delandtj/granite_controller/firmware/granite-sim/README.md

# granite-sim

The Granite controller, on the host. It runs the real `granite-core` -
node state machine, actuator queue, rule engine, dispatcher and the HTTP
route table - against a fake board described by a scenario file, and
serves the real setup page (`firmware/web/`) over HTTPS with a
self-signed certificate. The browser experience and the API contract are
therefore the same ones the firmware serves, without a board.

## Commands

```
granite-sim serve [--port 8443] [--bind 127.0.0.1] [--scenario file.toml]
                  [--no-tls] [--assets ../web]
                  [--link i2c|can] [--drop-every N]
granite-sim recover [--key ~/.config/granite/fleet-recovery.key] [--port N]
                    [--no-tls] <host>
granite-sim keygen [--key ~/.config/granite/fleet-recovery.key]
granite-sim modbus-map > ../docs/modbus_map.md
```

- `serve` prints the device id, MAC, certificate fingerprint and the
  recovery token, then listens. The certificate is generated per run, so
  the browser warns once; `--assets ../web` serves the page from disk so
  edits need no rebuild.
- `recover` is the fleet recovery tool from ADR 0001 component 13: it
  fetches `/id`, signs `device || nonce || "factory-reset"` with the
  fleet ECDSA P-256 private key and posts `/recover`. TLS is not trusted
  here (the device certificate is self-signed by design); the signature
  is the authentication.
- `keygen` writes the private key with mode 0600 and prints the public
  PEM for the Security page. It refuses to overwrite an existing key.
- `modbus-map` regenerates `firmware/docs/modbus_map.md` from
  `granite_core::modbus_map::render_markdown`.

## First setup with curl

```
B=https://127.0.0.1:8443
curl -sk $B/id
curl -sk -X POST -d '{"password":"correct horse battery"}' $B/api/v1/security/password
curl -sk -c jar -X POST -d '{"password":"correct horse battery"}' $B/api/v1/session
curl -sk -b jar $B/api/v1/status
curl -sk -b jar -X POST -d '{}' $B/api/v1/nodes/3/on
```

## Scenario file

Everything is optional; see `granite-sim/src/scenario.rs` for the full
set and the defaults (8 nodes off, one probe at 40 C, 19 V on the bus).

```toml
device_id = "granite-510000"

[hardware]
vin_mv = 19000
board_temp_c = 32.5
dry_in = [false, false, false, false]
vin_ramp_mv_per_min = 0

[[probes]]
rom = "28ff000000000001"
name = "inlet"
temp_c = 40.0
ramp_c_per_min = 0.0

[[nodes]]
node = 1
powered = false
respond = "normal"     # normal | never | slow
on_delay_ms = 1500
off_delay_ms = 4000
sense_broken = false
```

`respond = "never"` is the hung node: `on` times out, `off` escalates to
`force_off`, `press` still works. A PWR press held 4 s or longer cuts
power in the model, which is what makes the actuator's hardware deadline
observable. `sense_broken` is a broken LED wire: the node reads dark even
while it is powered, which is the failure mode ADR 0001 warns about and
the reason for the per-node `sense = "ignore"` setting. Marking every
node broken makes the whole U15 read fail instead, and then every node is
`unknown` and the state-dependent actions are refused unless the command
carries `"force": true`.

## Planes

A `[[plane]]` section puts a simulated plane on the link
(controller ADR 0004 architecture item 3). Each one is a real
`plane-logic` `Plane` over plane-logic's own fake devices, and the fake
link in front of them (`src/planes.rs`) implements
`granite_core::hal::PlaneLink`: it hands the request bytes to
`Plane::handle_frame` and gives the answer back. Framing, CRC and
records stay in `granite-proto`; an address with no plane NAKs, and on
the I2C link `event_nodes()` answers 0xFF while any plane's
`event_pending()` holds, because EXP_INT is their wired OR and cannot
say which plane pulled it (ADR 0005 decision 6).

Every plane runs at its own 20 Hz from the simulator's main loop, so a
sequence finishes and an event shows up on EXP_INT with nobody polling.
`scenarios/two-planes.toml` is a full frame on the plane at 0x30 (four
unit boards, eight slots, one of them empty, one sleeping host, one that
ignores its PWR button) plus a single-unit plane at 0x31.

```toml
[[plane]]
address = 0x30
units = [0, 1, 2, 3]
blink_window_ms = [100, 500]   # shortens every wait on a host LED

[[plane.slot]]
slot = 0
module = true
module_id = 0x0400
load_ma = 1200
host_on = true
respond = "normal"             # normal | ignores_short_press | ignores_hold
blink_period_ms = 0            # non-zero is a sleeping host

[[plane.fault]]
at_s = 45
kind = "unit_unplug"
unit = 1
```

Fault kinds, with `slot` / `unit` / `count` / `value` / `on` as each one
needs: `drop_transactions` (NAK the next `count`), `corrupt_answer`
(flip a byte, so the controller's CRC check rejects it), `watchdog` and
`power_loss` (a plane reboot that keeps or loses the intended state),
`unit_unplug` / `unit_replug` (the chain cable), `unit_hot_swap_latch`
(an overload on the unit's 48 V input: its LM5069-2 faults and retries,
and the plane latches the unit off) with `unit_hot_swap_clear` to take
the overload away again, `ov_latch`, `pgd_loss`, `power_limit_trip`,
`ignore_pwr` and `load`.
The same knobs are methods on `FakePlane`, which is how
`tests/plane_link.rs` drives them.

Nothing in `granite-core` reads the link yet: the plane client is the
next step (ADR 0004 decision 5), and `tests/plane_link.rs` is a
hand-written stand-in for it.

## The CAN FD link

The transport under those messages is a choice (firmware ADR 0005). The
default is the rev D I2C bus; `--link can`, or `link = "can"` in the
scenario, puts the fake CAN FD bus of `src/can.rs` in between instead:

```toml
link = "can"            # i2c | can

[can]
drop_every = 12         # lose 1 frame in 12; 0 loses nothing
```

Every request, answer, EVENT and SYNC then goes through
`granite_proto::can::segment` and comes back out of a `Reassembler` -
one for the controller, one per plane - so the simulator runs the real
segmentation (decision 3) and the real reassembly rules (decision 4),
not a model of them. A plane with unacknowledged events sends EVENT
from its own node once a second until EV_ACK covers them, which is what
`event_nodes()` reports (decision 6); the controller's SYNC is counted
with its epoch (decision 7).

`--drop-every N` loses every Nth frame on the bus. A message that loses
a segment is never reassembled, so the transaction times out and
ADR 0003's retries are what recovers: `tests/can_link.rs` runs the
client over a bus losing one frame in twelve and asserts it keeps both
planes, their telemetry and its verbs.

## What is not simulated

- Pull OTA (`{"url":..,"sha256":..}`) is logged and ignored; pushed
  images are checked for the ESP image magic byte only.
- MQTT: the broker summary is static. The topic contract is exercised
  through the `Command`/`Reply` JSON, which is the same code path.
- Modbus TCP: the map and the command translation are in the core and
  unit tested there; the simulator does not open port 502.
- Plane link timing: a transaction is instant and never stretches the
  clock, so the ~20 ms per plane per second of ADR 0003 decision 5 is
  not something the simulator can show. Dropped and corrupted
  transactions are injected, not earned.
- CAN bit timing, arbitration and the error counters of ADR 0005
  decision 8: on the fake bus the frames arrive in the order they were
  sent, or not at all.
