delandtj/granite_controller/attic/power/pm-19v-200w/README.md

# PM-19V-200W - OBSOLETE

Superseded by PM-19V-250W (power/pm-19v-250w/) on 2026-10-27.
Not for order, no further work. Kept for reference only.

Differences that make it obsolete: DOSA pin mount with a 1x5 1.27 mm
aux header (J2: OV_KILL, PGOOD, ID, TEMP, GND) instead of the screwed
mount and 2x3 aux block of docs/pm-interface.md, and 200 W instead of
250 W. Its silk was never tidied. Any future lower-power module will be
a new design, not a revision of this one.
