delandtj/granite_controller/docs/pm-interface.md

# Port module interface spec (PM-19V-250W and its hosts)

**Date**: 2026-10-26, amended 2026-10-27 (aux: 1.27 mm header and
socket instead of flat pads and pogos; gap 7.0 mm)
**Status**: Accepted with ADR 0003
**Applies to**: the port module (`power/pm-19v-250w/`, new project from pm-19v-200w),
the plane tile column, the bench carrier (`power/pm-bench-carrier/`).

Every mount footprint (module screw pads and aux header, host standoffs
and aux socket, host silk outline) is generated from the numbers in this
file. Change a number here first, then regenerate; never edit a
generated footprint by hand.

## Coordinates

Module frame: origin at the centre of the module outline, viewed from
the module's top (F side, inductors up), +x toward the output end,
+y down (KiCad convention). All positions below are in this frame, mm.

The module sits on the host F side up, so the host footprint uses the
same coordinates, not mirrored. On the plane tile the module stands
with the input end up (toward VBUS): host footprint rotation 270
(module +x points down the board). Bench carrier: rotation 0.

## Outline

- 58.4 x 22.9 mm (eighth-brick outline, nothing else from DOSA).
- Module PCB 1.6 mm, 4 layers, ENIG (pads are contact surfaces).
- Corner radius: none (as now).

## Screws: positions and nets

Four M2 screws through the module into SMT standoffs on the host. The
screws carry the power: the module's pad is clamped between the screw
head and the standoff face.

| Screw | Net | x | y | Current (cont. / fault) |
|---|---|---|---|---|
| S1 | VIN | -25.70 | -7.95 | 5.5 A at 48 V, 7 A at 38 V |
| S2 | GND (input) | -25.70 | +5.95 | as S1 |
| S3 | GND (output) | +25.70 | +5.95 | 13.2 A / 20 A |
| S4 | VOUT | +25.70 | -7.95 | 13.2 A / 20 A |

S2 and S3 sit 2.0 mm closer to the centre line than S1 and S4. That is
the polarisation: turned 180 degrees, (x, y) -> (-x, -y), the module's
holes land at y = +7.95 and -5.95, where no host standoff is (2.0 mm
off against a 0.2 mm hole float), so not even one screw goes in with
the module reversed. A pattern where only one screw is offset is not
enough: two diagonal screws still line up and hold the module with VIN
on a GND standoff. Keep the offset at 2.0 mm or more, and keep it the
same at both ends.

Insets: 3.5 mm from the short edges; 3.5 mm from the top long edge,
5.5 mm from the bottom one. The 6.2 mm underside pad leaves 0.4 mm to
the edge at S1 and S4.

## Screw pads

Module: one footprint, pm:PM_Mount_M2 (schematic J1), all four screws in
it, pad n = Sn, so the pattern cannot be placed wrong:
- Plated hole 2.4 mm (M2 clearance, +/-0.2 float).
- F pad 5.0 mm round (screw head 3.8 + lock washer 4.4 OD).
- Inner layers 4.0 mm round, solid to the net's pour.
- B pad 6.2 mm round (standoff face 5.56 mm), no solder mask, no paste.
- 8 vias 0.3 mm drill, 0.65 mm pad, on a 4.4 mm circle inside the pads, untented
  (no solder on the module side, the joint is clamped).
- Solid connection to the pour (no thermal spokes) on every layer.

Host standoff (one part per designator, JLC places one part each):
- Sinhoo SMTSO2070CTJ, LCSC C2916355: M2 thread, 7.0 mm length,
  5.56 mm body, 3.6 mm pilot 1.53 mm long (same family and footprint
  as the 6.0 mm SMTSO2060CTJ, C2915628, it replaced).
- Plated hole 3.75 mm for the pilot, round pad 6.4 mm, 4 paste
  apertures (as drawn at tag pm-mount-drawn), solid to the pour.
- 8-12 stitching vias around the pad to the inner planes.

Hardware: M2 x 5 pan or cheese head, A2 stainless, with a spring lock
washer (DIN 127 / split ring) under the head. Engagement: 5 - 1.6
(PCB) - 0.5 (washer) = 2.9 mm (the screw goes into the standoff's top,
so the standoff length does not change it). Torque: 0.15 Nm max, the
datasheet's tightening torque for the M2 size (1.5 kgf.cm); the earlier 0.25 Nm
was over it. That gives roughly 350-400 N clamp on an M2 (F = T / (0.2 d)).

Standoff datasheet (Sinhoo PCB SMD NUT, LCSC C2916355, checked 2026-11-03):
- Thread: through, over the full length, for L 0.5-10 mm; only L 11-30 is
  blind (7 mm thread depth). The 7.0 mm part is through-threaded, so the
  M2 x 5 cannot bottom out (2.9 mm engagement, 7 mm of thread).
- Through means the bore is open to the host's plated pilot hole: solder can
  wick up into the bottom of the thread (the datasheet warns about this and
  rules out wave soldering). The screw only uses the top 2.9 mm, so a little
  wicking is harmless; keep the paste apertures off the hole as drawn.
- Material / plating: the datasheet gives brass C3604 (H59) for the parts with
  a rated current; LCSC lists the part as tin-plated copper. The datasheet
  itself does not decode the CTJ suffix, so tin plating rests on the LCSC
  listing (to confirm on a sample).
- Rated current for the M2 size: 30 A (S3 / S4 need 13.2 A cont., 20 A fault).
- Dimensions as used: body 5.56, pilot 3.6 x 1.53, min. solder pad 6.2,
  hole 3.73 +0.08.

## Aux contacts

A 2x3 1.27 mm board-to-board pair: SMT pin header on the module B side,
SMT socket on the host. Signals only, never power. (Was, to 2026-10-27:
flat pads on the module and pogo pins on the host. Dropped: the pogo
C5157258 turned out to be through-hole and too short for the gap, the
stocked SMT pogos have 0.08-0.25 um gold, and a pin tip on a pad is the
fussier contact; a socket grips and wipes.)

| Pin | Net | x | y | Direction | Note |
|---|---|---|---|---|---|
| A1 | OV_KILL | +12.065 | -9.12 | module -> host | open drain, low = overvoltage, sets the slot latch |
| A2 | PGOOD | +13.335 | -9.12 | module -> host | open drain, high = good |
| A5 | GND | +12.065 | -7.85 | | reference for ID and the open drains |
| A6 | GND | +13.335 | -7.85 | | the second GND |
| A3 | ID | +12.065 | -6.58 | module -> host | resistor to GND, table below |
| A4 | RUN | +13.335 | -6.58 | host -> module | open = on, host pulls low = off |

Pins are numbered by function (signals 1-4, GND 5-6), not by the
makers' numbering; positions are the contact (pin) centres in the
module frame, block centre (+12.70, -7.85), 1.27 mm both ways, rows
along y, GND in the middle row. Module footprint pm:PM_Aux_Header_2x03_P1.27
(schematic J2, pin n = An), host footprint carrier:PM_Aux_Socket_2x03_P1.27
(one part, pin n = An). The parts are symmetric: a 180 degree
placement error changes nothing, a 90 degree one does.

- Module header: hanxia HX PZ1.27-2x3P TP, LCSC C41376035 (second
  source Hong Cheng HC-PZ127-7.2L-2x3PS, C27985144). Plastic from 0.5
  to 1.5 mm off the module, pins 4.0 mm above it: tip 5.5 mm off the
  module. SMT legs outward in x, pads 2.50 x 0.74 at x +/-2.00 from the
  block centre (6.50 outer span), with paste: the header is reflowed on
  the module's B side with the other B parts. The footprint is drawn F
  side mirrored in y and flipped top-bottom onto B (rotation 0).
- Host socket: hanxia HX PM1.27-2x3P TP, LCSC C41397112 (second
  source Hong Cheng HC-PM127-4.3H-2x3PS-02A, C42163098). 4.60 mm tall
  over the PCB, pads 2.05 x 0.76 at x +/-1.975 (6.00 outer span).
- Mating at the 7.0 mm gap: pin tip 1.5 mm above the host, 3.1 mm into
  the socket. Header plastic would seat at a 6.1 mm gap, pins bottom
  at ~6.2, the upper contact point is ~2.5 mm deep (lost above ~7.6):
  ~0.8 mm margin to bottoming, ~0.6 mm wipe past the upper contact
  point, tolerance stack ~+/-0.4 RSS. The contact depths are scaled
  from the makers' drawings (not dimensioned): mate one sample pair at
  7.0 mm before a volume order. Plating "gold flash", thickness not
  stated.
- Module side: vias between the pad columns (x 141.15-142.65 on the
  250 W board) are fine, the header plastic sits over them, tented.
- Host side: OV_KILL and PGOOD pulled up in the column (open = good,
  so an absent module reads "good"; presence comes from ID). RUN is
  the module's UVLO divider node (~1.9 V at 60 V in): the host only
  ever pulls it low through an open drain, never drives it high.
- Lost contact: OV_KILL, PGOOD and RUN all fail unsafe when a pin
  opens (no OV kill, "good", module on). ID opens to "no module".
  Rule for every host: ID open (or out of the table) = slot fault, the
  slot stays off or is latched off. A module whose aux contact is gone
  then cannot run unsupervised.

ID table (module resistor to GND, host 10k pull-up to 3V3, 1k series,
100 nF):

| R_ID | V/3V3 | Module |
|---|---|---|
| 0 (short) | 0 | fault |
| 2.2k | 0.18 | reserved |
| 4.7k | 0.32 | reserved |
| 10k | 0.50 | PM-19V-200W rev 0.1 |
| 22k | 0.69 | PM-19V-250W |
| 47k | 0.82 | reserved |
| open | 1.00 | no module |

## Gap and part heights

- Gap module B surface to host F surface: 7.0 mm (the standoff length;
  was 6.0 to 2026-10-27, raised for the aux header and socket).
- Module B side: parts max 2.7 mm (1210 caps at 100 V are the tallest).
- Host under the module outline: parts max 2.0 mm, and none within
  1.0 mm of a standoff body or the aux socket. That leaves 2.3 mm air.
- Module F side: parts max 12 mm (inductors; recheck with the 250 W
  inductors). No part taller than 1.5 mm within 6.5 mm diameter of a
  screw (head, washer and screwdriver access).
- Keep-out on the module, both sides and inner layers: 6.5 mm diameter
  around each screw for other nets' copper and for parts. Host: 6.8 mm
  diameter around each standoff for other parts.

## What the current module layout has to move

From the placement at 797cb1e (positions in board coordinates, module
centre at (129.2, 111.45)):

- S1 (103.5, 103.5): C1 and C3 (B, input caps) overlap by ~1.3 mm in
  x; D1 (B) by 0.35 mm in y.
- S2 (103.5, 117.4): R4, C9 and C11 (B, gate drive and OVLO) inside
  the keep-out.
- S4 (154.9, 103.5): C24 (F, 100 uF) overlaps by 0.7 mm.
- S3 (154.9, 117.4): C25 (F, 100 uF) overlaps by 0.7 mm.
- Aux block: clear as placed.
- TH1 (NTC), and J1/J2 (DOSA footprint and aux row) go away.

These are inputs for the 250 W re-placement, not edits to make on the
current board.

## Generator

power/tools/pmmount.py holds the numbers above in one table and emits:
- module: PM_Mount_M2 (all four screws), PM_Aux_Header_2x03_P1.27;
- host: PM_Standoff_M2x7_SMTSO, PM_Aux_Socket_2x03_P1.27,
  PM_Module_Outline (silk outline with S1 marker and the input end
  marked "VIN");
- `place`: puts a host set (standoffs, socket, outline) at a module
  centre and rotation.
