delandtj/granite_controller/docs/adr/0007-core-power-over-the-chain.md

# Plane core powered over the chain joint (no core XT30)

**Status**: Rejected (user, 2026-11-04)
**Date**: 2026-11-04

Related: docs/adr/0005-chained-plane-boards.md (decision 3: the unit
latch judges the core's own 48 V input; decision 4: the 2x7 chain joint,
"no VBUS in the chain"; decision 6: the core's own XT30 input),
docs/adr/0006-plane-link-can-fd.md (decision 4: every core feeds
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
