delandtj/granite_controller/fab-archive/fd-batch1/pm-19v-250w-b/pm-19v-250w-b-bom.csv

Comment | Designator | Footprint | LCSC Part #
4.7u 100V | C1,C2,C3,C4,C5,C6 | C_1210_3225Metric | C381466
1u 100V | C7 | C_0805_2012Metric | C5370002
22u 35V | C9,C10,C11,C12 | C_1210_3225Metric | C778721
100u 35V polymer | C13,C14,C15 | CP_Elec_6.3x7.7 | C46550467
1u | C16,C17,C18,C23,C26 | C_0402_1005Metric | C52923
820p C0G | C19 | C_0402_1005Metric | C161159
47n | C20 | C_0402_1005Metric | C272875
1.5n | C21 | C_0402_1005Metric | C107022
22p | C22 | C_0402_1005Metric | C1555
1n | C24 | C_0402_1005Metric | C1523
100n | C25,C27,C28 | C_0402_1005Metric | C307331
BAS21 | D1,D3 | D_SOD-323 | C82466
BZT52C10 | D2 | D_SOD-123 | C2103
4.7V | D4 | D_SOD-323 | C107713
Aux header 2x3 1.27 | J2 | PM_Aux_Header_2x03_P1.27 | C41376035
10u APS1510M100F | L1 | L_Coilcraft_XAL1510-103 | C49261402
BSC098N10NS5 | Q1 | TDSON-8-1 | C534398
BSC070N10NS5 | Q2 | TDSON-8-1 | C534364
BCX56-16 | Q3 | SOT-89-3 | C123402
22k (ID) | R1 | R_0603_1608Metric | C31850
10R | R2 | R_0603_1608Metric | C22859
0R | R3 | R_0402_1005Metric | C17168
4m 2512 | R4 | R_2512_6332Metric | C459681
10k | R6,R12,R19,R21 | R_0402_1005Metric | C25744
12.4k | R7 | R_0402_1005Metric | C2929935
232k | R8 | R_0402_1005Metric | C3013159
36.5k 0.1% | R9 | R_0402_1005Metric | C852741
2.49k 0.1% | R10 | R_0402_1005Metric | C852700
61.9k | R11,R20 | R_0402_1005Metric | C2933106
200k 1206 | R13 | R_1206_3216Metric | C17954
6.34k | R14 | R_0402_1005Metric | C5713274
1M 1206 | R15 | R_1206_3216Metric | C17927
6.04k | R16 | R_0402_1005Metric | C2998182
47k 0805 | R17 | R_0805_2012Metric | C17713
76.8k | R18 | R_0402_1005Metric | C26987
LM5116MHX | U1 | HTSSOP-20-1EP_4.4x6.5mm_P0.65mm_EP3.4x6.5mm_ThermalVias | C13755
MCP65R46-2.4 | U2,U3 | SOT-23-6 | C623510
TPS3701DDCR | U4 | SOT-23-6 | C132788
