delandtj/granite_controller/3dmodels/HRO_TYPE-C-31-M-12.step

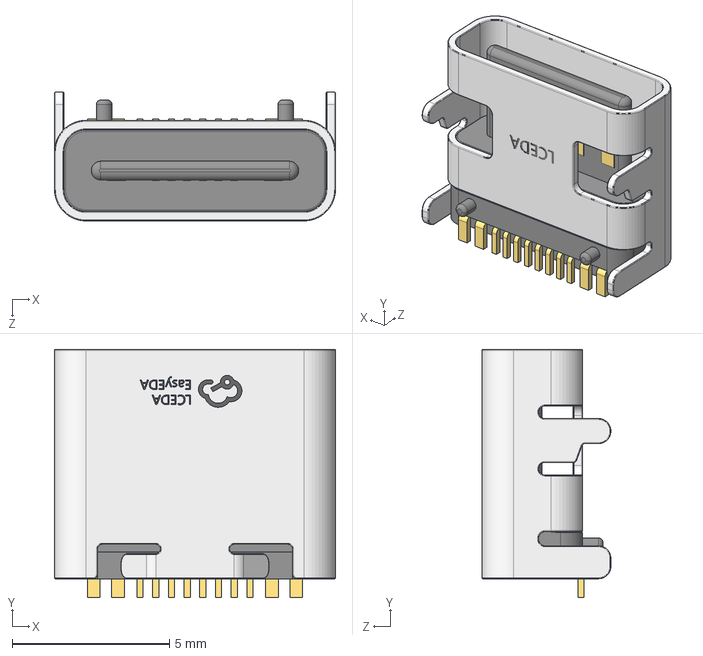
[picture p1: CAD file, 2026-10-09]
3dmodels/HRO_TYPE-C-31-M-12.step
8.94 x 7.90 x 4.10 mm
