delandtj/granite_controller/3dmodels/TLP176AM_SO4.step

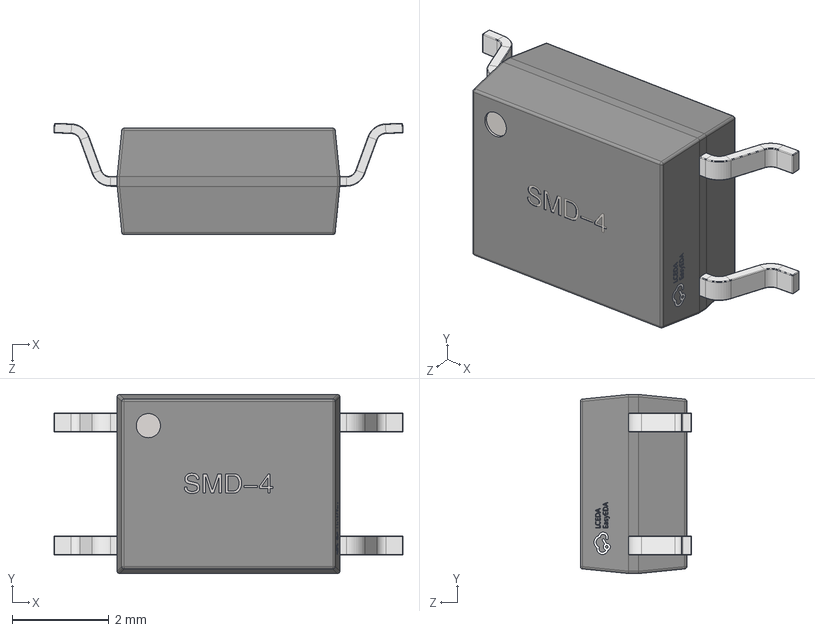
[picture p2: CAD file, 2026-10-08]
3dmodels/TLP176AM_SO4.step
7.21 x 3.70 x 2.30 mm
