delandtj/granite_controller/3dmodels/HR911105A.step

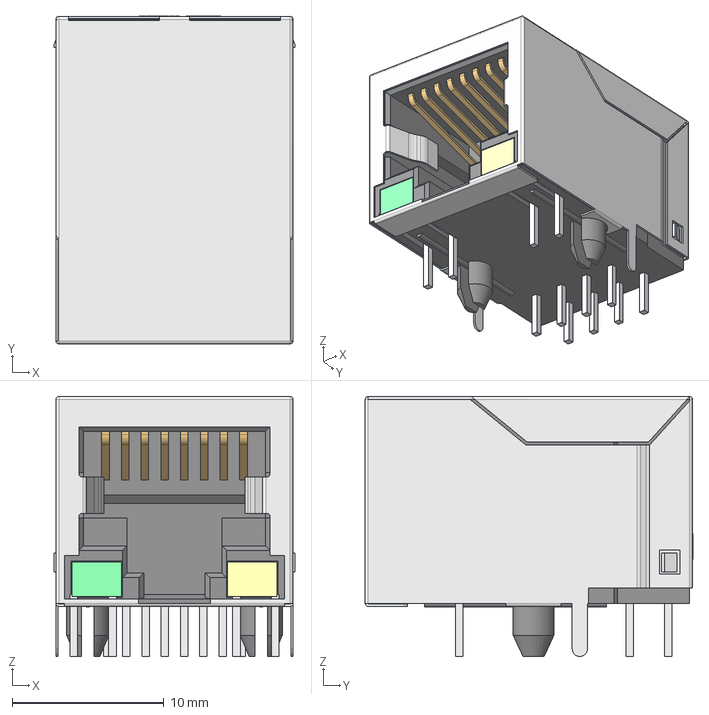
[picture p4: CAD file, 2026-10-08]
3dmodels/HR911105A.step
15.9 x 21.6 x 17.1 mm
