delandtj/granite_controller/controller-rev-c/3dmodels/TLP290-4_SOP16.step

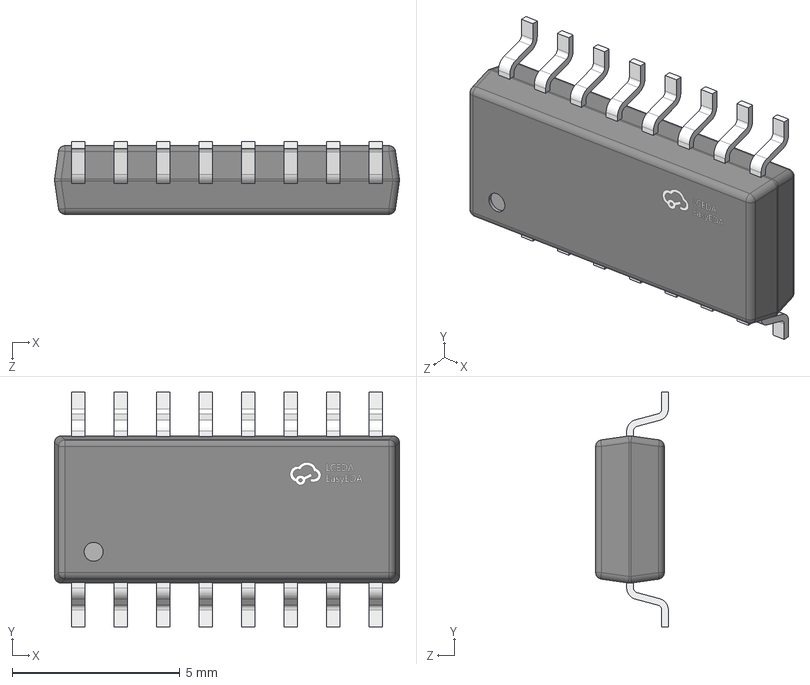
[picture p5: CAD file, 2026-10-08, an earlier design]
controller-rev-c/3dmodels/TLP290-4_SOP16.step
10.3 x 7.00 x 2.17 mm
