delandtj/granite_controller/power/pp-48-unit-fd/pp-48-unit-fd.kicad_pcb

## KiCad design power/pp-48-unit-fd/pp-48-unit-fd.kicad_pcb (2026-11-11)

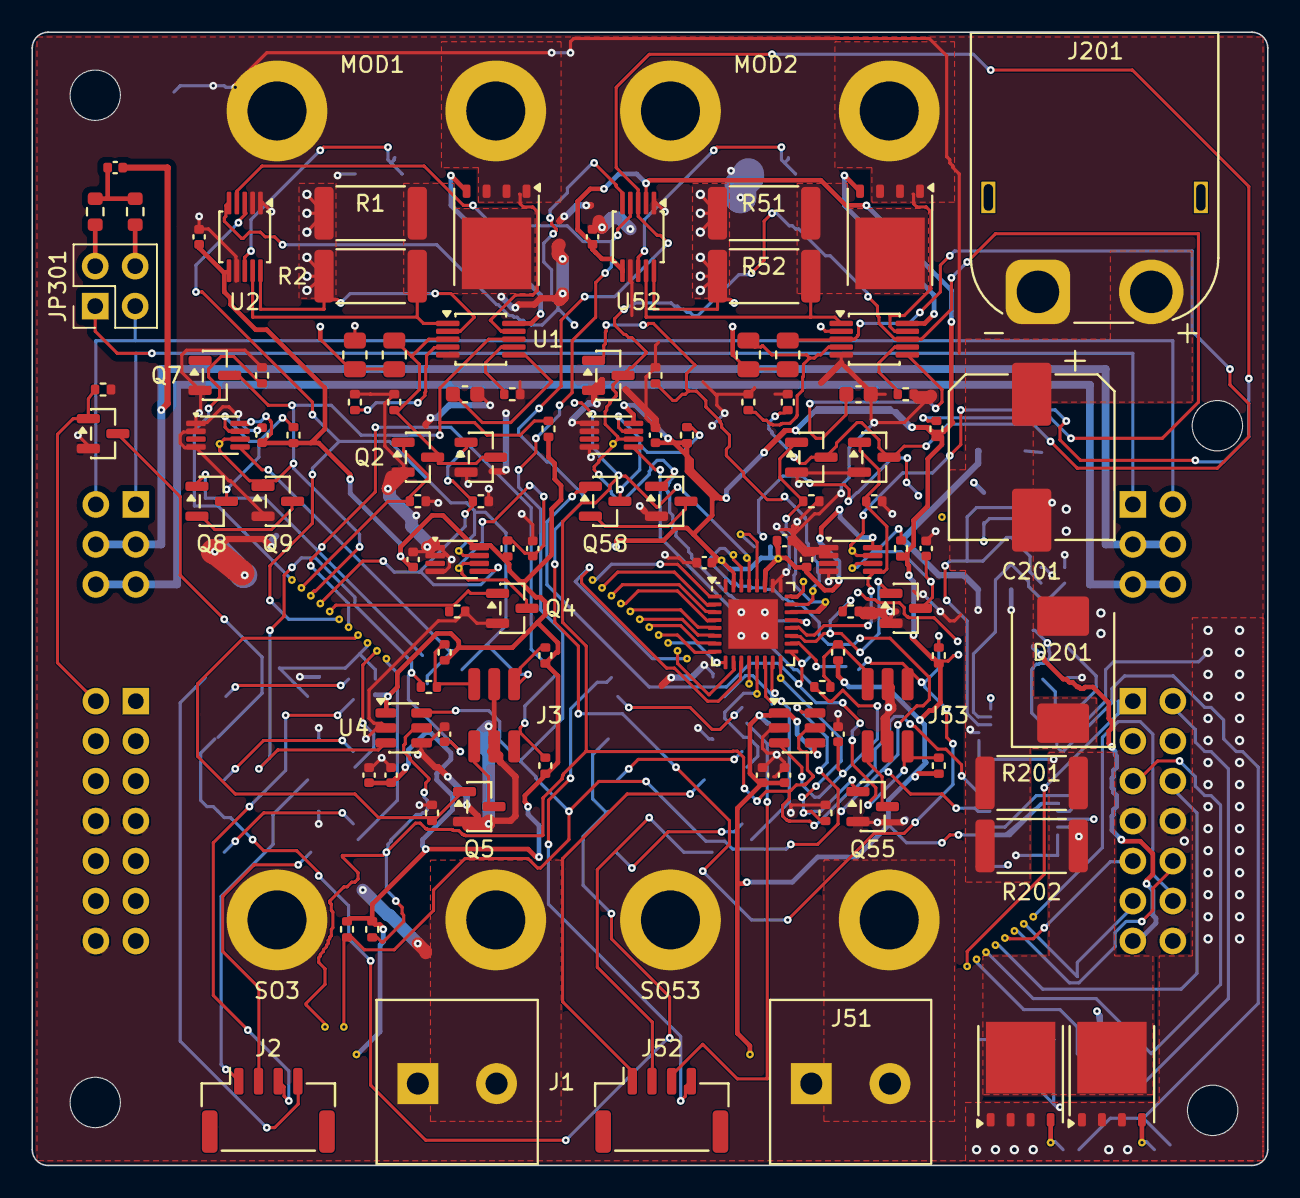
[picture p6: board pp-48-unit-fd.kicad_pcb from above]

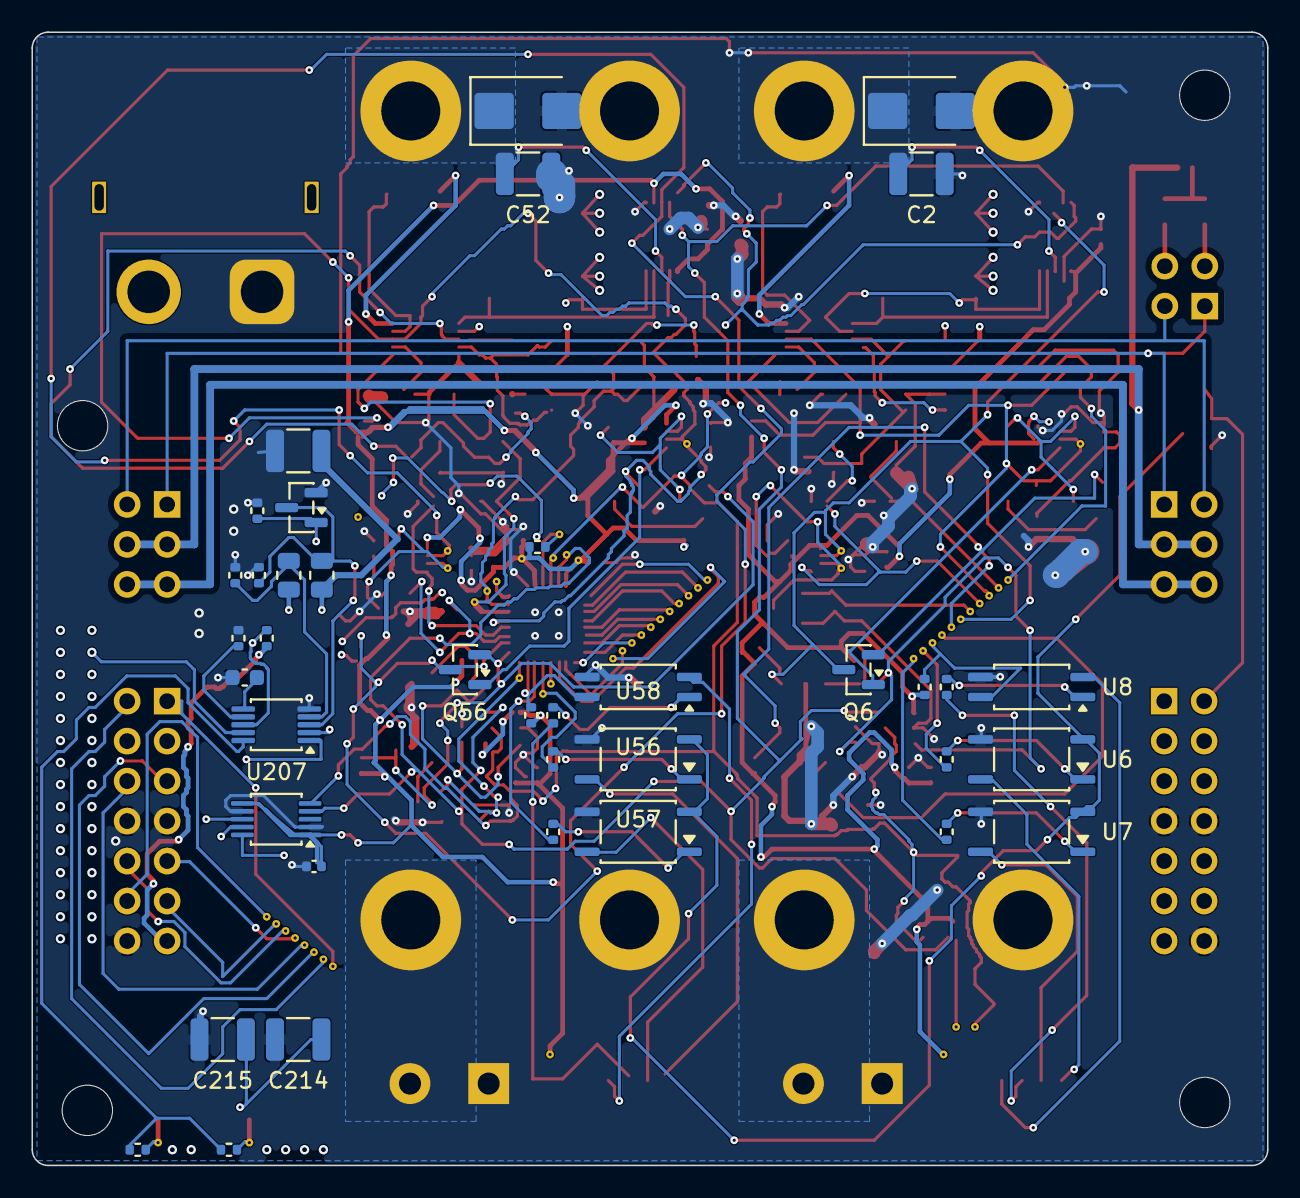
[picture p7: board pp-48-unit-fd.kicad_pcb from below]

Board: 4 copper layers, 78.5 x 72.0 mm, 214 parts (42 on the bottom side), 98 nets.

Parts:
BV100, BV101, BV102, BV103, BV104, BV105, BV106, BV107, BV108, BV109, BV110, BV150, BV151, BV152, BV153, BV154, BV155, BV156, BV157, BV158, BV159, BV160, BV900, BV901, BV902, BV903, BV904, BV905, BV906, BV907: (no value)
C1, C51, C203: 220n; C_0603_1608Metric
C2, C52, C202, C214, C215: 2.2u 100V; C_1210_3225Metric
C3, C4, C5, C6, C9, C10, C12, C13, C53, C54, C55, C56, C60, C62, C216: 100n; C_0402_1005Metric
C11, C61: 1u; C_0402_1005Metric
C201: 47u 100V; CP_Elec_10x10
C301: 4.7n; C_0402_1005Metric
D1, D51: SMBJ60A; D_SMB
D201: SMDJ60A; D_SMC
EV12, EV13, EV16, EV22, EV23, EV24, EV29, EV30: (no value)
GV202, GV203: (no value)
H1, H2, H3, H4: MountingHole_3.2mm_M3
J1, J51: NODE 19V; TerminalBlock_Degson_DG128-5.0-02P
J2, J52: FRONT PANEL; JST_GH_SM04B-GHS-TB_1x04-1MP_P1.25mm_Horizontal
J3, J53: AUX; PM_Aux_Socket_2x03_P1.27
J201: XT60PW-M; AMASS_XT60PW-M_1x02_P7.20mm_Horizontal
J301: CHAIN IN; PinHeader_2x07_P2.54mm_Horizontal
J302: CHAIN OUT; PinSocket_2x07_P2.54mm_Horizontal
J303: LINK IN; PinHeader_2x03_P2.54mm_Horizontal
J304: LINK OUT; PinSocket_2x03_P2.54mm_Horizontal
JP301: TERM; PinHeader_2x02_P2.54mm_Vertical
MOD1, MOD2: PM_Module_Outline
PV1B3, PV1B4, PV3A, PV3B: (no value)
Q1, Q51, Q202, Q203: ISC035N10NM5LF2; TDSON-8-1
Q2, Q3, Q4, Q5, Q6, Q7, Q8, Q9, Q10, Q52, Q53, Q54, Q55, Q56, Q57, Q58, Q59, Q204: 2N7002; SOT-23
R1, R2, R51, R52: 7m 2W; R_2512_6332Metric
R3, R53, R233: 143k; R_0805_2012Metric
R4, R8, R13, R14, R15, R30, R54, R58, R63, R64, R65, R234, R238: 10k; R_0402_1005Metric
R5, R55, R235: 124k; R_0805_2012Metric
R6, R56, R236: 4.99k; R_0402_1005Metric
R7, R57: 13.7k; R_0402_1005Metric
R9, R10, R11, R12, R23, R28, R29, R31, R59, R60, R61, R62, R73, R78, R79, R214: 100k; R_0402_1005Metric
R19, R20, R69, R70: 270; R_0402_1005Metric
R21, R71: 220; R_0402_1005Metric
R22, R72: 47k; R_0402_1005Metric
R24, R74: 1k; R_0402_1005Metric
R26, R27: 4.7k; R_0402_1005Metric
R201, R202: 6m 2W; R_2512_6332Metric
R210, R211: 10; R_0402_1005Metric
R237: 20.0k; R_0402_1005Metric
R301, R302: 60.4; R_0603_1608Metric
RV1: (no value)
SO1, SO51: S1 VIN; PM_Standoff_M2x7_SMTSO
SO2, SO52: S2 GND; PM_Standoff_M2x7_SMTSO
SO3, SO53: S3 GND; PM_Standoff_M2x7_SMTSO
SO4, SO54: S4 VOUT; PM_Standoff_M2x7_SMTSO
SV8, SV9: (no value)
U1, U51, U207: LM5069MM-2; MSOP-10_3x3mm_P0.5mm
U2, U52, U208: INA237AIDGSR; TSSOP-10_3x3mm_P0.5mm
U3, U10, U53, U60: 74LVC1G74; VSSOP-8_2.3x2mm_P0.5mm
U4, U54: ADC121C027CIMK; TSOT-23-6
U5: TCA6424ARGJR; VQFN-32-1EP_5x5mm_P0.5mm_EP3.15x3.15mm
U6, U7, U56, U57: TLP176AM; SOIC-4_4.55x3.7mm_P2.54mm
U8, U58: TLP291; SOIC-4_4.55x2.6mm_P1.27mm
UV1: (no value)
XV1A1, XV1A2, XV1A3, XV1B1, XV1B2, XV1B3: (no value)

Connections:
+3V3: C3.1, C4.1, C9.1, C10.1, C11.1, C12.1, C13.1, C53.1, C54.1, C60.1, C61.1, C62.1, C216.1, J301.13, J302.13, PV1B3.1, PV1B4.1, PV3A.1, PV3B.1, R8.1, R11.1, R13.1, R14.1, R15.1, R22.1, R26.1, R27.1, R28.1, R30.2, R58.1, R61.1, R63.1, R64.1, R65.1, R72.1, R78.1, R238.1, U2.6, U3.8, U4.1, U5.27, U5.31, U10.8, U52.2, U52.6, U53.8, U54.1, U54.4, U60.8, U208.1, U208.6
/Chain/AUX_12V: J303.5, J303.6, J304.5, J304.6
/Chain/CAN_N: J303.2, J304.2, JP301.3
/Chain/CAN_P: J303.1, J304.1, JP301.1
/Chain/CH1_SCL: BV907.1, J301.10, J302.12
/Chain/CH1_SDA: BV906.1, J301.9, J302.11
/Chain/CH2_SCL: BV905.1, J301.6, J302.10
/Chain/CH2_SDA: BV904.1, J301.5, J302.9
/Chain/CH3_SCL: BV903.1, J301.4, J302.6
/Chain/CH3_SDA: BV902.1, J301.3, J302.5
/Chain/LINK_GND: C301.2, J303.3, J303.4, J304.3, J304.4
/Chain/TERM_H: JP301.2, R301.1
/Chain/TERM_L: JP301.4, R302.2
/Chain/TERM_MID: C301.1, R301.2, R302.1
/EXP_RSTN: BV900.1, J301.1, J302.1, R30.1, RV1.1, U5.28
/Input/GATE: R210.1, R211.2, U207.10
/Input/OVLO: R235.2, R236.1, U207.4
/Input/PWR: R237.1, U207.7
/Input/TIMER: C203.1, U207.6
/Input/USENSE: Q202.5, Q203.5, R201.2, R202.2, U207.1, U208.9
/Input/UVLO: Q204.3, R233.2, R234.1, U207.3
/PRESS_EN: BV901.1, J301.2, J302.2, Q10.1, R31.1
/SEG_SCL: EV29.1, J301.12, R27.2, SV9.1, U2.5, U4.5, U5.29, U52.5, U54.5, U208.5
/SEG_SDA: EV30.1, J301.11, R26.2, SV8.1, U2.4, U4.6, U5.30, U52.4, U54.6, U208.4
/U_OFF: EV12.1, Q204.1, R214.1, U5.12, UV1.1
/U_PGD: EV24.1, R238.2, U5.24, U207.8
/Unit/A_ARM: Q6.1, U10.5
/Unit/A_ARMS_M: Q8.2, Q9.3
/Unit/A_ARMS_N: Q8.3, R28.2, U10.7
/Unit/A_CLRN: C5.1, Q4.3, R11.2, U3.6, XV1A2.1
/Unit/A_DISARM: BV100.1, BV150.1, Q7.1, R29.1, U5.1
/Unit/A_GATE: Q1.4, U1.10
/Unit/A_ID: J3.3, R15.2, R24.2
/Unit/A_ID_F: C6.1, R24.1, U4.3
/Unit/A_LCLR: BV104.1, BV154.1, Q4.1, R12.1, U5.5
/Unit/A_LED: BV108.1, BV158.1, R22.2, U5.9, U8.4
/Unit/A_LQ: BV103.1, BV153.1, Q3.1, R10.1, U3.5, U5.4
/Unit/A_NODE: J1.2, SO4.1
/Unit/A_OFF: BV101.1, BV151.1, Q2.1, R9.1, U5.2
/Unit/A_OUT: C2.1, D1.1, Q1.1, Q1.2, Q1.3, SO1.1, U1.9, U2.8
/Unit/A_OVK: BV105.1, BV155.1, J3.1, Q6.3, R13.2, U2.3, U3.7, U5.6, XV1A1.1
/Unit/A_OVLO: R5.2, R6.1, U1.4
/Unit/A_PG: BV106.1, BV156.1, J3.2, Q6.2, Q8.1, R14.2, U5.7
/Unit/A_PGD: BV102.1, BV152.1, Q7.3, Q9.1, R8.2, U1.8, U5.3, U10.6, XV1A3.1
/Unit/A_PLED_A: R21.2, U8.1
/Unit/A_PLED_N: J2.4, U8.2
/Unit/A_PLED_P: J2.3, R21.1
/Unit/A_PWR: R7.1, U1.7
/Unit/A_PWRD: BV109.1, BV159.1, R19.1, U5.10
/Unit/A_PWRD_A: R19.2, U6.1
/Unit/A_PWR_SW: J2.1, U6.6
/Unit/A_RSTD: BV110.1, BV160.1, R20.1, U5.11
/Unit/A_RSTD_A: R20.2, U7.1
/Unit/A_RST_SW: J2.2, U7.6
/Unit/A_RUN: J3.4, Q5.3
/Unit/A_RUNOFF: BV107.1, BV157.1, Q5.1, R23.1, U5.8
/Unit/A_SENSE: Q1.5, R1.2, R2.2, U1.1, U2.9
/Unit/A_TIMER: C1.1, U1.6
/Unit/A_UVLO: Q2.3, Q3.3, R3.2, R4.1, U1.3
/Unit/B_ARM: Q56.1, U60.5
/Unit/B_ARMS_M: Q58.2, Q59.3
/Unit/B_ARMS_N: Q58.3, R78.2, U60.7
/Unit/B_CLRN: C55.1, Q54.3, R61.2, U53.6, XV1B2.1
/Unit/B_DISARM: EV23.1, Q57.1, R79.1, U5.23
/Unit/B_GATE: Q51.4, U51.10
/Unit/B_ID: J53.3, R65.2, R74.2
/Unit/B_ID_F: C56.1, R74.1, U54.3
/Unit/B_LCLR: Q54.1, R62.1, U5.19
/Unit/B_LED: R72.2, U5.15, U58.4
/Unit/B_LQ: Q53.1, R60.1, U5.20, U53.5
/Unit/B_NODE: J51.2, SO54.1
/Unit/B_OFF: EV22.1, Q52.1, R59.1, U5.22
/Unit/B_OUT: C52.1, D51.1, Q51.1, Q51.2, Q51.3, SO51.1, U51.9, U52.8
/Unit/B_OVK: J53.1, Q56.3, R63.2, U5.18, U52.3, U53.7, XV1B1.1
/Unit/B_OVLO: R55.2, R56.1, U51.4
/Unit/B_PG: J53.2, Q56.2, Q58.1, R64.2, U5.17
/Unit/B_PGD: Q57.3, Q59.1, R58.2, U5.21, U51.8, U60.6, XV1B3.1
/Unit/B_PLED_A: R71.2, U58.1
/Unit/B_PLED_N: J52.4, U58.2
/Unit/B_PLED_P: J52.3, R71.1
/Unit/B_PWR: R57.1, U51.7
/Unit/B_PWRD: EV13.1, R69.1, U5.13
/Unit/B_PWRD_A: R69.2, U56.1
/Unit/B_PWR_SW: J52.1, U56.6
/Unit/B_RSTD: R70.1, U5.14
/Unit/B_RSTD_A: R70.2, U57.1
/Unit/B_RST_SW: J52.2, U57.6
/Unit/B_RUN: J53.4, Q55.3
/Unit/B_RUNOFF: EV16.1, Q55.1, R73.1, U5.16
/Unit/B_SENSE: Q51.5, R51.2, R52.2, U51.1, U52.9
/Unit/B_TIMER: C51.1, U51.6
/Unit/B_UVLO: Q52.3, Q53.3, R53.2, R54.1, U51.3
/Unit/PRESS_RTN: Q10.3, U6.3, U7.3, U56.3, U57.3
GND: C1.2, C2.2, C3.2, C4.2, C5.2, C6.2, C9.2, C10.2, C11.2, C12.2, C13.2, C51.2, C52.2, C53.2, C54.2, C55.2, C56.2, C60.2, C61.2, C62.2, C201.2, C202.2, C203.2, C214.2, C215.2, C216.2, D1.2, D51.2, D201.2, J1.1, J3.5, J3.6, J51.1, J53.5, J53.6, J201.1, J301.7, J301.8, J301.14, J302.7, J302.8, J302.14, Q2.2, Q3.2, Q4.2, Q5.2, Q7.2, Q9.2, Q10.2, Q52.2, Q53.2, Q54.2, Q55.2, Q57.2, Q59.2, Q204.2, R4.2, R6.2, R7.2, R9.2, R10.2, R12.2, R23.2, R29.2, R31.2, R54.2, R56.2, R57.2, R59.2, R60.2, R62.2, R73.2, R79.2, R214.2, R234.2, R236.2, R237.2, SO2.1, SO3.1, SO52.1, SO53.1, U1.5, U2.1, U2.2, U2.7, U3.1, U3.2, U3.4, U4.2, U4.4, U5.25, U5.26, U5.33, U6.4, U7.4, U8.3, U10.1, U10.2, U10.4, U51.5, U52.1, U52.7, U53.1, U53.2, U53.4, U54.2, U56.4, U57.4, U58.3, U60.1, U60.2, U60.4, U207.5, U208.2, U208.7
unnamed: GV202.1, Q202.4, R210.2
unnamed: GV203.1, Q203.4, R211.1
VBUS: C214.1, C215.1, Q202.1, Q202.2, Q202.3, Q203.1, Q203.2, Q203.3, R1.1, R2.1, R3.1, R5.1, R51.1, R52.1, R53.1, R55.1, U1.2, U2.10, U51.2, U52.10, U207.9, U208.8
VIN: C201.1, C202.1, D201.1, J201.2, R201.1, R202.1, R233.1, R235.1, U207.2, U208.10
