delandtj/granite_controller/power/pp-48-core-fd/pp-48-core-fd.kicad_pcb

## KiCad design power/pp-48-core-fd/pp-48-core-fd.kicad_pcb (2026-11-08)

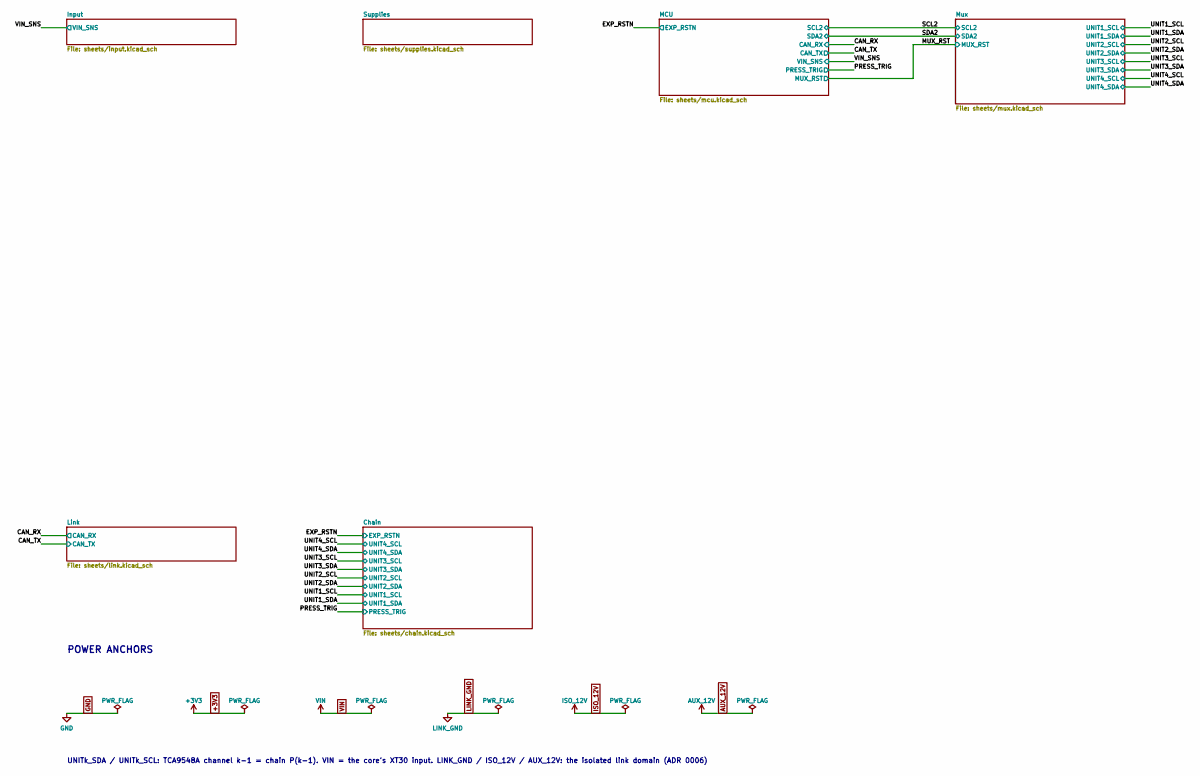
[picture p8: schematic pp-48-core-fd.kicad_sch, PP-48 core board, CAN FD link]

Notes on the sheet:
UNITk_SDA / UNITk_SCL: TCA9548A channel k-1 = chain P(k-1). VIN = the core's XT30 input. LINK_GND / ISO_12V / AUX_12V: the isolated link domain (ADR 0006)
POWER ANCHORS

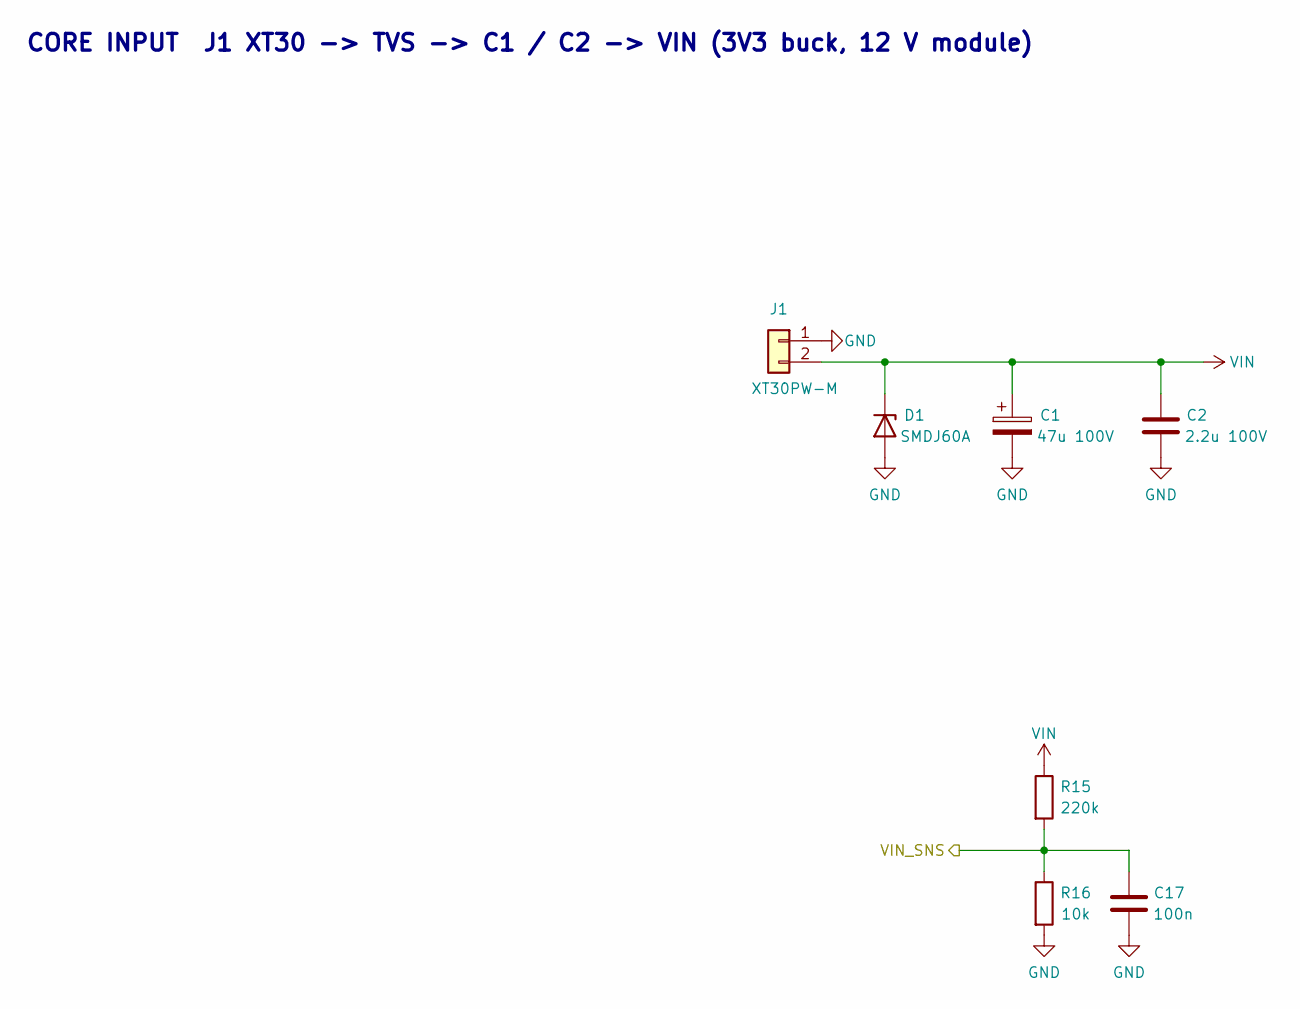
[picture p9: schematic input.kicad_sch]

Parts:
C1: 47u 100V; CP_Elec_10x10; MPN Lelon RVT2A470M1010; LCSC C87862
C2: 2.2u 100V; C_1210_3225Metric; LCSC C338133
C17: 100n; C_0402_1005Metric; LCSC C1525
D1: SMDJ60A; D_SMC; LCSC C2990209
J1: XT30PW-M; AMASS_XT30PW-M_1x02_P2.50mm_Horizontal; MPN Amass XT30PW-M; LCSC C431092
R15: 220k; R_0805_2012Metric; LCSC C17556
R16: 10k; R_0402_1005Metric; LCSC C25744

Connections:
/VIN_SNS: C17.1, R15.2, R16.1; also elsewhere on the board
GND: C1.2, C2.2, C17.2, D1.2 (A), J1.1, R16.2; also elsewhere on the board
VIN: C1.1, C2.1, D1.1 (K), J1.2, R15.1; also elsewhere on the board

Notes on the sheet:
CORE INPUT J1 XT30 -> TVS -> C1 / C2 -> VIN (3V3 buck, 12 V module)

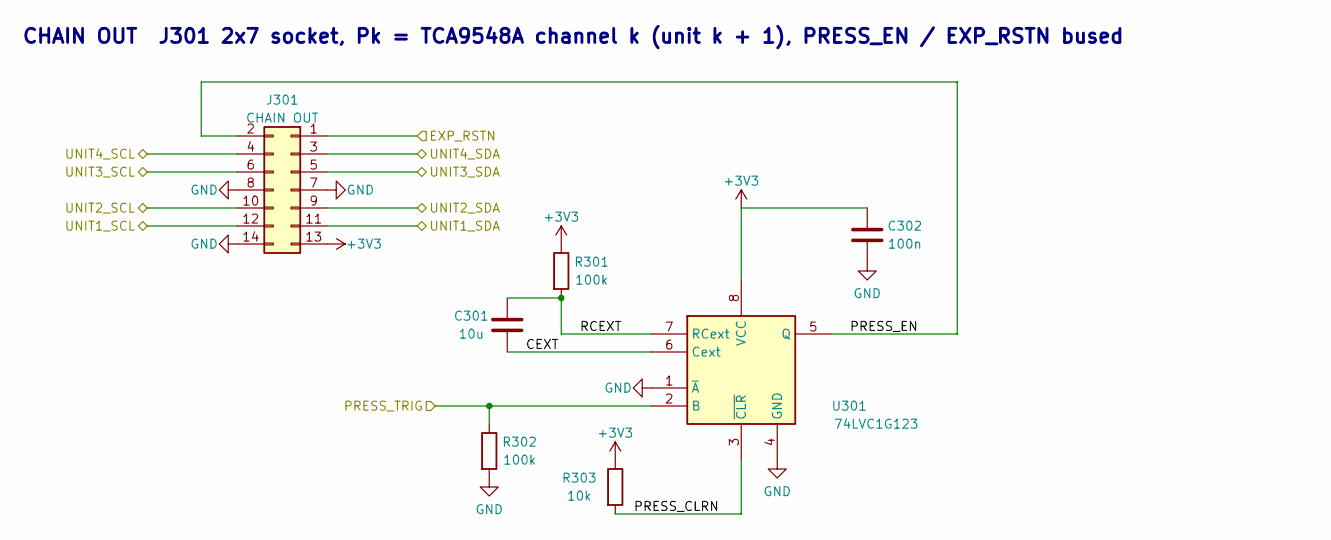
[picture p10: schematic chain.kicad_sch]

Parts:
C301: 10u; C_0805_2012Metric; LCSC C15850
C302: 100n; C_0402_1005Metric; LCSC C1525
J301: CHAIN OUT; PinSocket_2x07_P2.54mm_Horizontal; MPN CJT A2541HWR-2x7P; LCSC C19100281
R301, R302: 100k; R_0402_1005Metric; LCSC C25741
R303: 10k; R_0402_1005Metric; LCSC C25744
U301: 74LVC1G123; SSOP-8_2.95x2.8mm_P0.65mm; MPN TI SN74LVC1G123DCTR; LCSC C123302

Connections:
+3V3: C302.1, J301.13, R301.1, R303.1, U301.8 (VCC); also elsewhere on the board
/Chain/CEXT: C301.2, U301.6 (Cext)
/Chain/PRESS_CLRN: R303.2, U301.3 (~CLR)
/Chain/PRESS_EN: J301.2, U301.5 (Q)
/Chain/RCEXT: C301.1, R301.2, U301.7 (RCext)
/EXP_RSTN: J301.1; also elsewhere on the board
/PRESS_TRIG: R302.1, U301.2 (B); also elsewhere on the board
/UNIT1_SCL: J301.12; also elsewhere on the board
/UNIT1_SDA: J301.11; also elsewhere on the board
/UNIT2_SCL: J301.10; also elsewhere on the board
/UNIT2_SDA: J301.9; also elsewhere on the board
/UNIT3_SCL: J301.6; also elsewhere on the board
/UNIT3_SDA: J301.5; also elsewhere on the board
/UNIT4_SCL: J301.4; also elsewhere on the board
/UNIT4_SDA: J301.3; also elsewhere on the board
GND: C302.2, J301.7, J301.8, J301.14, R302.2, U301.1 (~A), U301.4 (GND); also elsewhere on the board

Notes on the sheet:
CHAIN OUT J301 2x7 socket, Pk = TCA9548A channel k (unit k + 1), PRESS_EN / EXP_RSTN bused

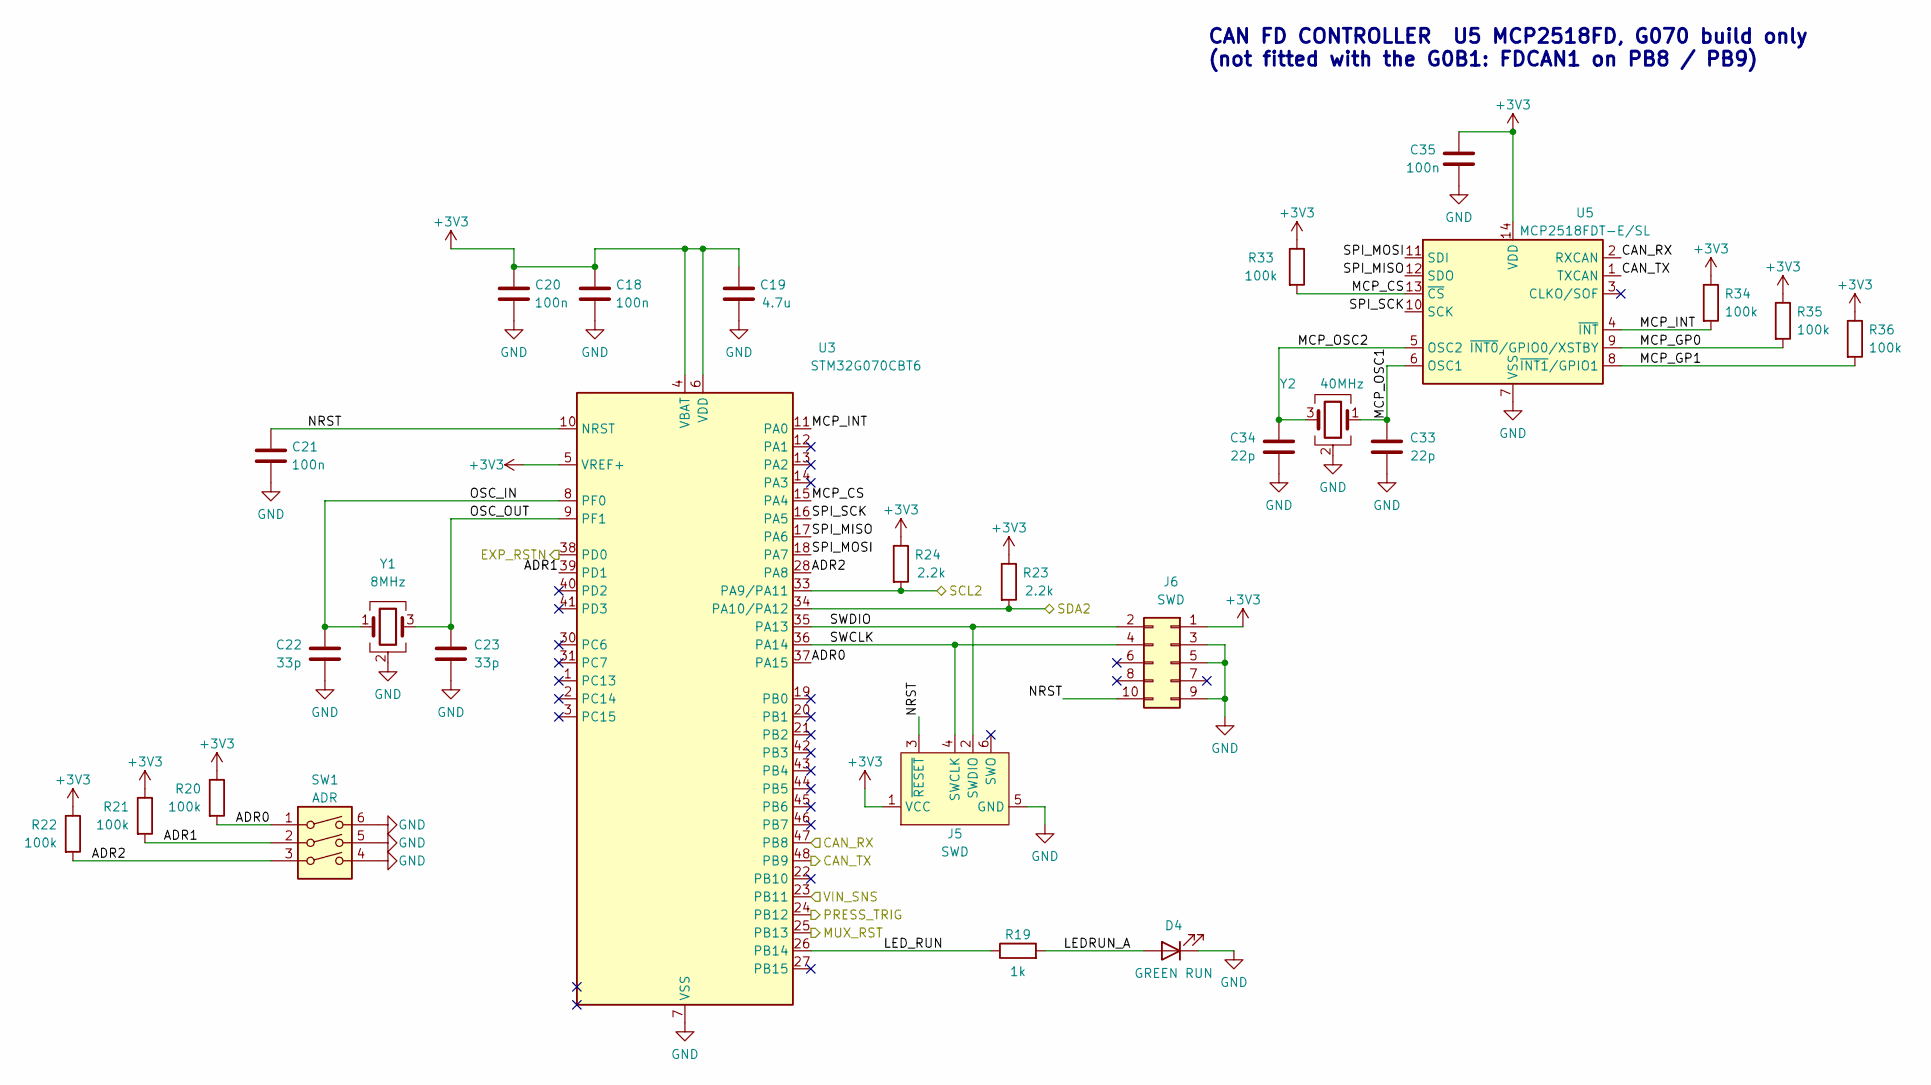
[picture p11: schematic mcu.kicad_sch]

Parts:
C18, C20, C21: 100n; C_0402_1005Metric; LCSC C1525
C19: 4.7u; C_0603_1608Metric; LCSC C19666
C22, C23: 33p; C_0402_1005Metric; LCSC C1562
C33, C34: 22p; C_0402_1005Metric; MPN FH 0402CG220J500NT; LCSC C1555
C35: 100n; C_0402_1005Metric; MPN Samsung CL05B104KO5NNNC; LCSC C1525
D4: GREEN RUN; LED_0603_1608Metric; LCSC C12624
J5: SWD; Tag-Connect_TC2030-IDC-NL_2x03_P1.27mm_Vertical
J6: SWD; PinHeader_2x05_P1.27mm_Vertical_SMD; MPN Samtec FTSH-105-01-L-DV-K; LCSC C5155080
R19: 1k; R_0402_1005Metric; LCSC C11702
R20, R21, R22: 100k; R_0402_1005Metric; LCSC C25741
R23, R24: 2.2k; R_0402_1005Metric; LCSC C25879
R33, R34, R35, R36: 100k; R_0402_1005Metric; MPN UniOhm 0402WGF1003TCE; LCSC C25741
SW1: ADR; SW_DIP_SPSTx03_Slide_KingTek_DSHP03TS_W7.62mm_P1.27mm; MPN KingTek DSHP03TSGET; LCSC C50844
U3: STM32G070CBT6; LQFP-48_7x7mm_P0.5mm; LCSC C529338
U5: MCP2518FDT-E/SL; SOIC-14_3.9x8.7mm_P1.27mm; MPN Microchip MCP2518FDT-E/SL; LCSC C626758
Y1: 8MHz; Crystal_SMD_3225-4Pin_3.2x2.5mm; LCSC C7424755
Y2: 40MHz; Crystal_SMD_3225-4Pin_3.2x2.5mm; MPN YXC X322540MPB4SI; LCSC C9010

Connections:
+3V3: C18.1, C19.1, C20.1, C35.1, J5.1 (VCC), J6.1, R20.1, R21.1, R22.1, R23.1, R24.1, R33.1, R34.1, R35.1, R36.1, U3.4 (VBAT), U3.5 (VREF+), U3.6 (VDD), U5.14 (VDD); also elsewhere on the board
/CAN_RX: U3.47 (PB8), U5.2 (RXCAN); also elsewhere on the board
/CAN_TX: U3.48 (PB9), U5.1 (TXCAN); also elsewhere on the board
/EXP_RSTN: U3.38 (PD0); also elsewhere on the board
/MCU/ADR0: R20.2, SW1.1, U3.37 (PA15)
/MCU/ADR1: R21.2, SW1.2, U3.39 (PD1)
/MCU/ADR2: R22.2, SW1.3, U3.28 (PA8)
/MCU/LEDRUN_A: D4.2 (A), R19.2
/MCU/LED_RUN: R19.1, U3.26 (PB14)
/MCU/MCP_CS: R33.2, U3.15 (PA4), U5.13 (~CS)
/MCU/MCP_GP0: R35.2, U5.9 (~INT0/GPIO0/XSTBY)
/MCU/MCP_GP1: R36.2, U5.8 (~INT1/GPIO1)
/MCU/MCP_INT: R34.2, U3.11 (PA0), U5.4 (~INT)
/MCU/MCP_OSC1: C33.1, U5.6 (OSC1), Y2.1
/MCU/MCP_OSC2: C34.1, U5.5 (OSC2), Y2.3
/MCU/NRST: C21.1, J5.3 (~RESET), J6.10, U3.10 (NRST)
/MCU/OSC_IN: C22.1, U3.8 (PF0), Y1.1
/MCU/OSC_OUT: C23.1, U3.9 (PF1), Y1.3
/MCU/SPI_MISO: U3.17 (PA6), U5.12 (SDO)
/MCU/SPI_MOSI: U3.18 (PA7), U5.11 (SDI)
/MCU/SPI_SCK: U3.16 (PA5), U5.10 (SCK)
/MCU/SWCLK: J5.4 (SWCLK), J6.4, U3.36 (PA14)
/MCU/SWDIO: J5.2 (SWDIO), J6.2, U3.35 (PA13)
/MUX_RST: U3.25 (PB13); also elsewhere on the board
/PRESS_TRIG: U3.24 (PB12); also elsewhere on the board
/SCL2: R24.2, U3.33 (PA9/PA11); also elsewhere on the board
/SDA2: R23.2, U3.34 (PA10/PA12); also elsewhere on the board
/VIN_SNS: U3.23 (PB11); also elsewhere on the board
GND: C18.2, C19.2, C20.2, C21.2, C22.2, C23.2, C33.2, C34.2, C35.2, D4.1 (K), J5.5 (GND), J6.3, J6.5, J6.9, SW1.4, SW1.5, SW1.6, U3.7 (VSS), U5.7 (VSS), Y1.2 (G), Y1.4 (G), Y2.2 (G), Y2.4 (G); also elsewhere on the board

Notes on the sheet:
CAN FD CONTROLLER U5 MCP2518FD, G070 build only (not fitted with the G0B1: FDCAN1 on PB8 / PB9)

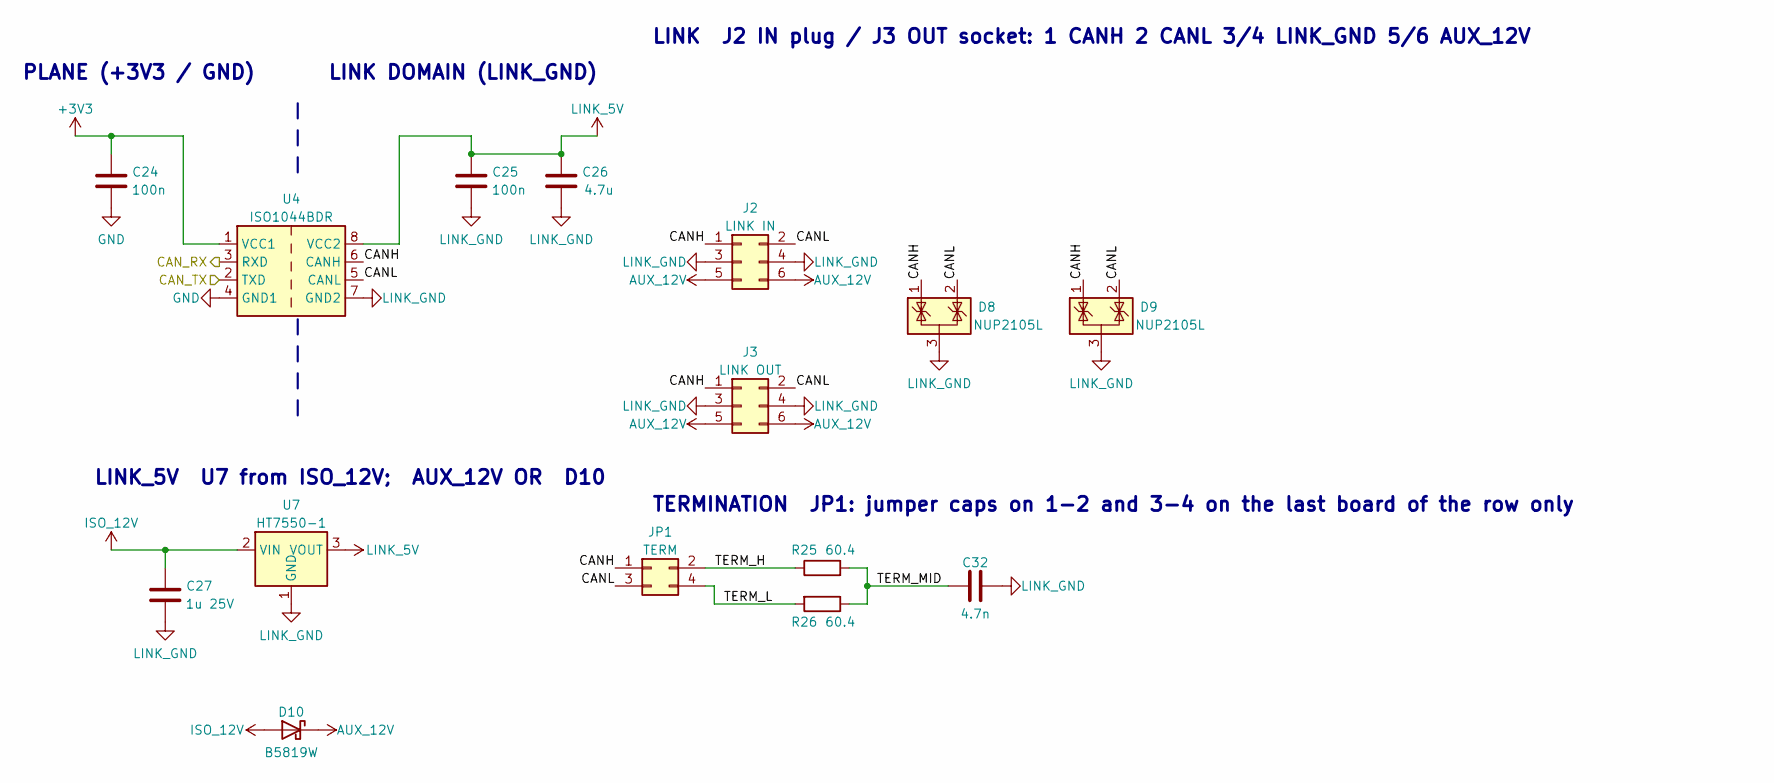
[picture p12: schematic link.kicad_sch]

Parts:
C24, C25: 100n; C_0402_1005Metric; MPN Samsung CL05B104KO5NNNC; LCSC C1525
C26: 4.7u; C_0603_1608Metric; MPN Samsung CL10A475KO8NNNC; LCSC C19666
C27: 1u 25V; C_0603_1608Metric; MPN Samsung CL10A105KB8NNNC; LCSC C15849
C32: 4.7n; C_0402_1005Metric; MPN FH 0402B472K500NT; LCSC C1538
D8, D9: NUP2105L; SOT-23; MPN onsemi NUP2105LT1G; LCSC C14486
D10: B5819W; D_SOD-123; MPN SL B5819W; LCSC C8598
J2: LINK IN; PinHeader_2x03_P2.54mm_Horizontal; MPN CJT A2541WR-2x3P; LCSC C239334
J3: LINK OUT; PinSocket_2x03_P2.54mm_Horizontal; MPN CJT A2541HWR-2x3P; LCSC C5333425
JP1: TERM; PinHeader_2x02_P2.54mm_Vertical; MPN XFCN PZ254V-12-4P; LCSC C492419
R25, R26: 60.4; R_0603_1608Metric; MPN Yageo AC0603FR-0760R4L; LCSC C144645
U4: ISO1044BDR; SOIC-8_3.9x4.9mm_P1.27mm; MPN TI ISO1044BDR; LCSC C2878225
U7: HT7550-1; SOT-89-3; MPN Holtek HT7550-1; LCSC C16106

Connections:
+3V3: C24.1, U4.1 (VCC1); also elsewhere on the board
/CAN_RX: U4.3 (RXD); also elsewhere on the board
/CAN_TX: U4.2 (TXD); also elsewhere on the board
/Link/CANH: D8.1 (K), D9.1 (K), J2.1, J3.1, JP1.1, U4.6 (CANH)
/Link/CANL: D8.2 (K), D9.2 (K), J2.2, J3.2, JP1.3, U4.5 (CANL)
/Link/TERM_H: JP1.2, R25.1
/Link/TERM_L: JP1.4, R26.2
/Link/TERM_MID: C32.1, R25.2, R26.1
AUX_12V: D10.1 (K), J2.5, J2.6, J3.5, J3.6
GND: C24.2, U4.4 (GND1); also elsewhere on the board
ISO_12V: C27.1, D10.2 (A), U7.2 (VIN); also elsewhere on the board
LINK_5V: C25.1, C26.1, U4.8 (VCC2), U7.3 (VOUT)
LINK_GND: C25.2, C26.2, C27.2, C32.2, D8.3 (A), D9.3 (A), J2.3, J2.4, J3.3, J3.4, U4.7 (GND2), U7.1 (GND); also elsewhere on the board

Notes on the sheet:
LINK_5V U7 from ISO_12V; AUX_12V OR D10
PLANE (+3V3 / GND)
LINK DOMAIN (LINK_GND)
LINK J2 IN plug / J3 OUT socket: 1 CANH 2 CANL 3/4 LINK_GND 5/6 AUX_12V
TERMINATION JP1: jumper caps on 1-2 and 3-4 on the last board of the row only

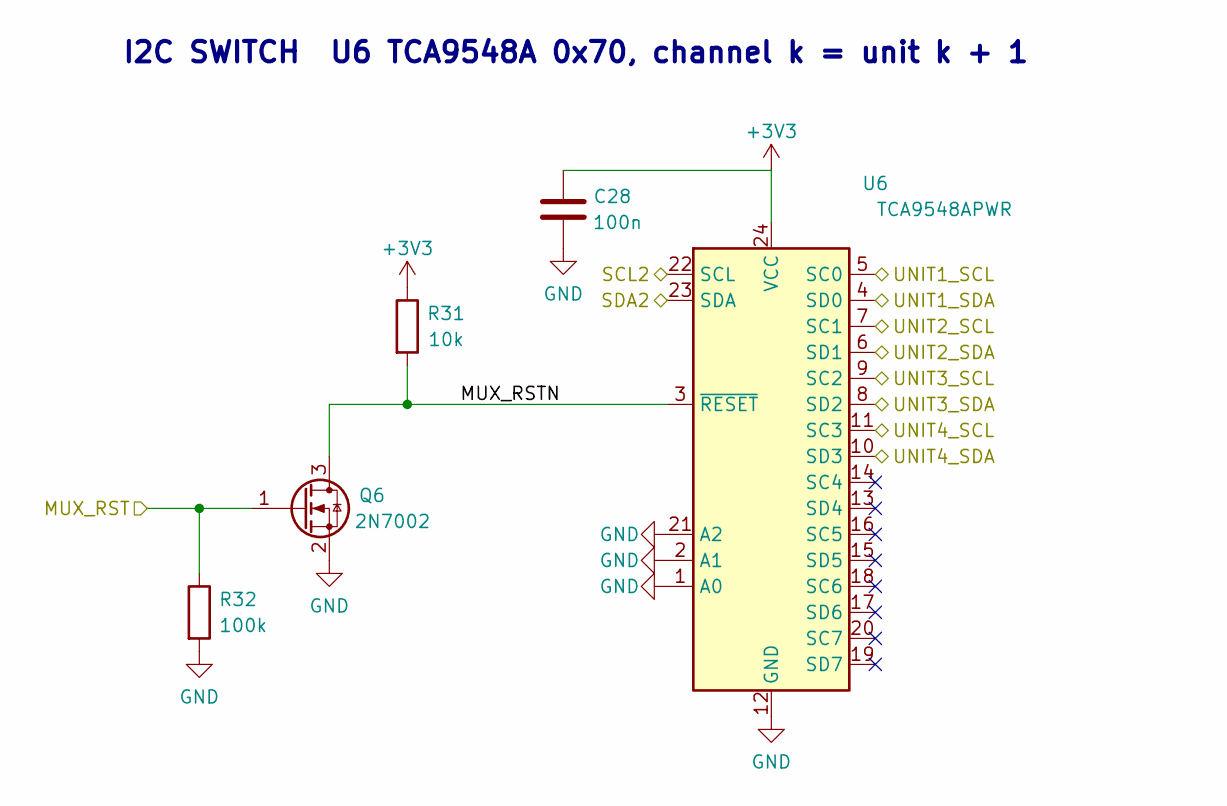
[picture p13: schematic mux.kicad_sch]

Parts:
C28: 100n; C_0402_1005Metric; LCSC C1525
Q6: 2N7002; SOT-23; LCSC C8545
R31: 10k; R_0402_1005Metric; LCSC C25744
R32: 100k; R_0402_1005Metric; LCSC C25741
U6: TCA9548APWR; TSSOP-24_4.4x7.8mm_P0.65mm; LCSC C130026

Connections:
+3V3: C28.1, R31.1, U6.24 (VCC); also elsewhere on the board
/MUX_RST: Q6.1 (G), R32.1; also elsewhere on the board
/Mux/MUX_RSTN: Q6.3 (D), R31.2, U6.3 (~RESET)
/SCL2: U6.22 (SCL); also elsewhere on the board
/SDA2: U6.23 (SDA); also elsewhere on the board
/UNIT1_SCL: U6.5 (SC0); also elsewhere on the board
/UNIT1_SDA: U6.4 (SD0); also elsewhere on the board
/UNIT2_SCL: U6.7 (SC1); also elsewhere on the board
/UNIT2_SDA: U6.6 (SD1); also elsewhere on the board
/UNIT3_SCL: U6.9 (SC2); also elsewhere on the board
/UNIT3_SDA: U6.8 (SD2); also elsewhere on the board
/UNIT4_SCL: U6.11 (SC3); also elsewhere on the board
/UNIT4_SDA: U6.10 (SD3); also elsewhere on the board
GND: C28.2, Q6.2 (S), R32.2, U6.1 (A0), U6.2 (A1), U6.12 (GND), U6.21 (A2); also elsewhere on the board

Notes on the sheet:
I2C SWITCH U6 TCA9548A 0x70, channel k = unit k + 1
