delandtj/granite_controller/power/pp-48-core-fd/pp-48-core-fd.kicad_pcb

## KiCad design power/pp-48-core-fd/pp-48-core-fd.kicad_pcb (continued)

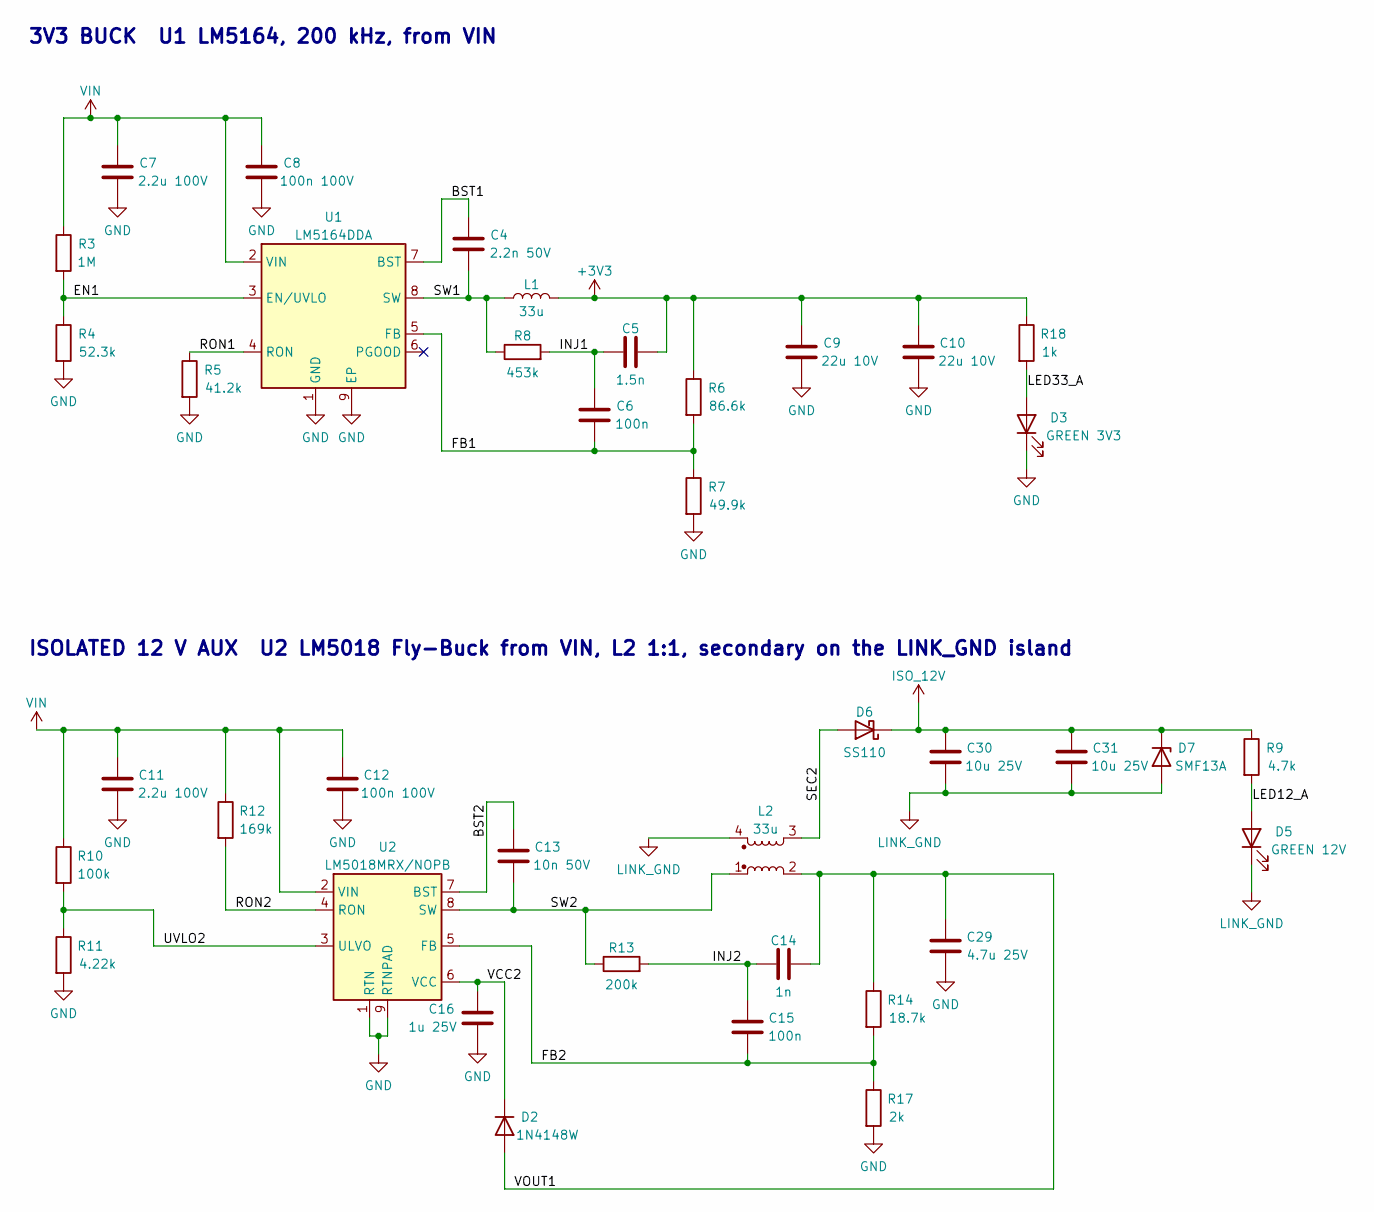
[picture p14: schematic supplies.kicad_sch]

Parts:
C4: 2.2n 50V; C_0402_1005Metric; LCSC C1531
C5: 1.5n; C_0402_1005Metric; LCSC C107022
C6, C15: 100n; C_0402_1005Metric; LCSC C1525
C7, C11: 2.2u 100V; C_1210_3225Metric; LCSC C338133
C8, C12: 100n 100V; C_0603_1608Metric; LCSC C696916
C9, C10: 22u 10V; C_1210_3225Metric; LCSC C318780
C13: 10n 50V; C_0402_1005Metric; LCSC C15195
C14: 1n; C_0402_1005Metric; LCSC C1523
C16: 1u 25V; C_0603_1608Metric; LCSC C15849
C29: 4.7u 25V; C_0805_2012Metric; LCSC C1779
C30, C31: 10u 25V; C_0805_2012Metric; LCSC C15850
D2: 1N4148W; D_SOD-123; LCSC C917030
D3: GREEN 3V3; LED_0603_1608Metric; LCSC C12624
D5: GREEN 12V; LED_0603_1608Metric; LCSC C12624
D6: SS110; D_SMA; LCSC C2482
D7: SMF13A; D_SOD-123F; LCSC C353315
L1: 33u; L_Bourns_SRR1260; MPN Bourns SRR1260-330M; LCSC C840528
L2: 33u; L_Coilcraft_LPD5030V; MPN Coilcraft LPD5030V-333MRC; LCSC C5441621
R3: 1M; R_0805_2012Metric; LCSC C17514
R4: 52.3k; R_0402_1005Metric; LCSC C2998086
R5: 41.2k; R_0402_1005Metric; LCSC C2998053
R6: 86.6k; R_0402_1005Metric; LCSC C48533697
R7: 49.9k; R_0402_1005Metric; LCSC C137969
R8: 453k; R_0402_1005Metric; LCSC C27009
R9: 4.7k; R_0603_1608Metric; LCSC C23162
R10: 100k; R_0805_2012Metric; LCSC C149504
R11: 4.22k; R_0402_1005Metric; LCSC C25898
R12: 169k; R_0805_2012Metric; LCSC C2933337
R13: 200k; R_0805_2012Metric; LCSC C17539
R14: 18.7k; R_0402_1005Metric; LCSC C5153953
R17: 2k; R_0402_1005Metric; LCSC C4109
R18: 1k; R_0402_1005Metric; LCSC C11702
U1: LM5164DDA; HSOP-8-1EP_3.9x4.9mm_P1.27mm_EP2.41x3.1mm; LCSC C477928
U2: LM5018MRX/NOPB; SOIC-8-1EP_3.9x4.9mm_P1.27mm_EP2.95x4.9mm_Mask2.71x3.4mm_Th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; LCSC C471040

Connections:
+3V3: C5.2, C9.1, C10.1, L1.2, R6.1, R18.1; also elsewhere on the board
/Supplies/BST1: C4.1, U1.7 (BST)
/Supplies/BST2: C13.1, U2.7 (BST)
/Supplies/EN1: R3.2, R4.1, U1.3 (EN/UVLO)
/Supplies/FB1: C6.2, R6.2, R7.1, U1.5 (FB)
/Supplies/FB2: C15.2, R14.2, R17.1, U2.5 (FB)
/Supplies/INJ1: C5.1, C6.1, R8.2
/Supplies/INJ2: C14.1, C15.1, R13.2
/Supplies/LED12_A: D5.2 (A), R9.2
/Supplies/LED33_A: D3.2 (A), R18.2
/Supplies/RON1: R5.1, U1.4 (RON)
/Supplies/RON2: R12.2, U2.4 (RON)
/Supplies/SEC2: D6.2 (A), L2.3
/Supplies/SW1: C4.2, L1.1, R8.1, U1.8 (SW)
/Supplies/SW2: C13.2, L2.1, R13.1, U2.8 (SW)
/Supplies/UVLO2: R10.2, R11.1, U2.3 (ULVO)
/Supplies/VCC2: C16.1, D2.1 (K), U2.6 (VCC)
/Supplies/VOUT1: C14.2, C29.1, D2.2 (A), L2.2, R14.1
GND: C7.2, C8.2, C9.2, C10.2, C11.2, C12.2, C16.2, C29.2, D3.1 (K), R4.2, R5.2, R7.2, R11.2, R17.2, U1.1 (GND), U1.9 (EP), U2.1 (RTN), U2.9 (RTNPAD); also elsewhere on the board
ISO_12V: C30.1, C31.1, D6.1 (K), D7.1 (K), R9.1; also elsewhere on the board
LINK_GND: C30.2, C31.2, D5.1 (K), D7.2 (A), L2.4; also elsewhere on the board
VIN: C7.1, C8.1, C11.1, C12.1, R3.1, R10.1, R12.1, U1.2 (VIN), U2.2 (VIN); also elsewhere on the board

Notes on the sheet:
3V3 BUCK U1 LM5164, 200 kHz, from VIN
ISOLATED 12 V AUX U2 LM5018 Fly-Buck from VIN, L2 1:1, secondary on the LINK_GND island

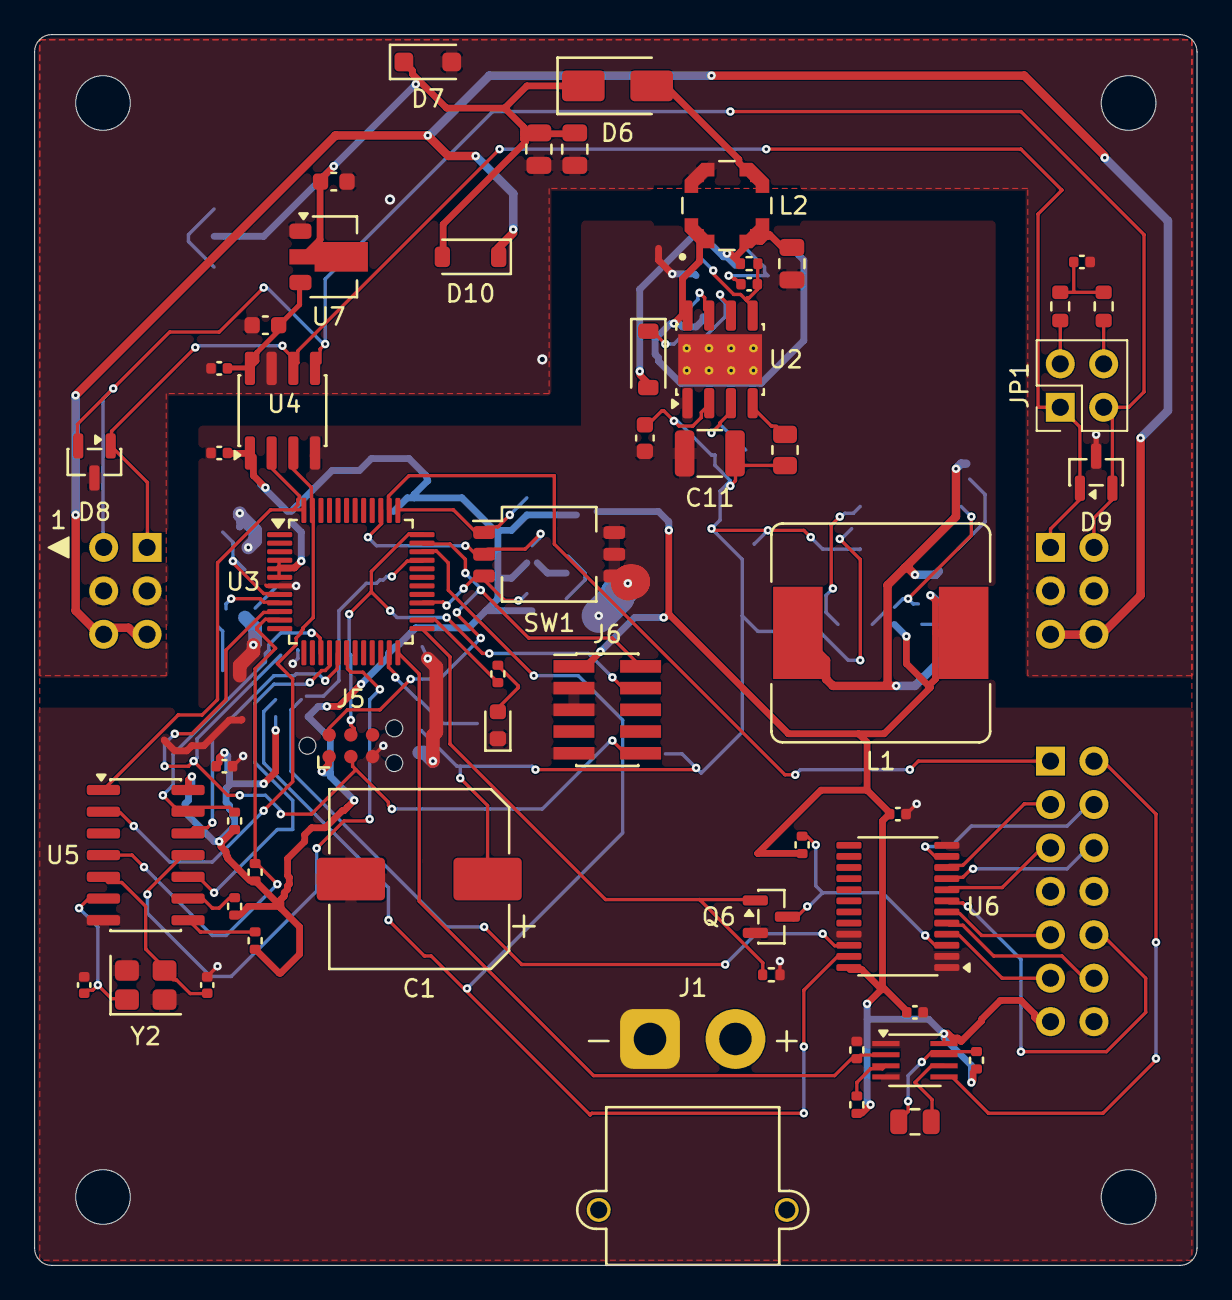
[picture p15: board pp-48-core-fd.kicad_pcb from above]

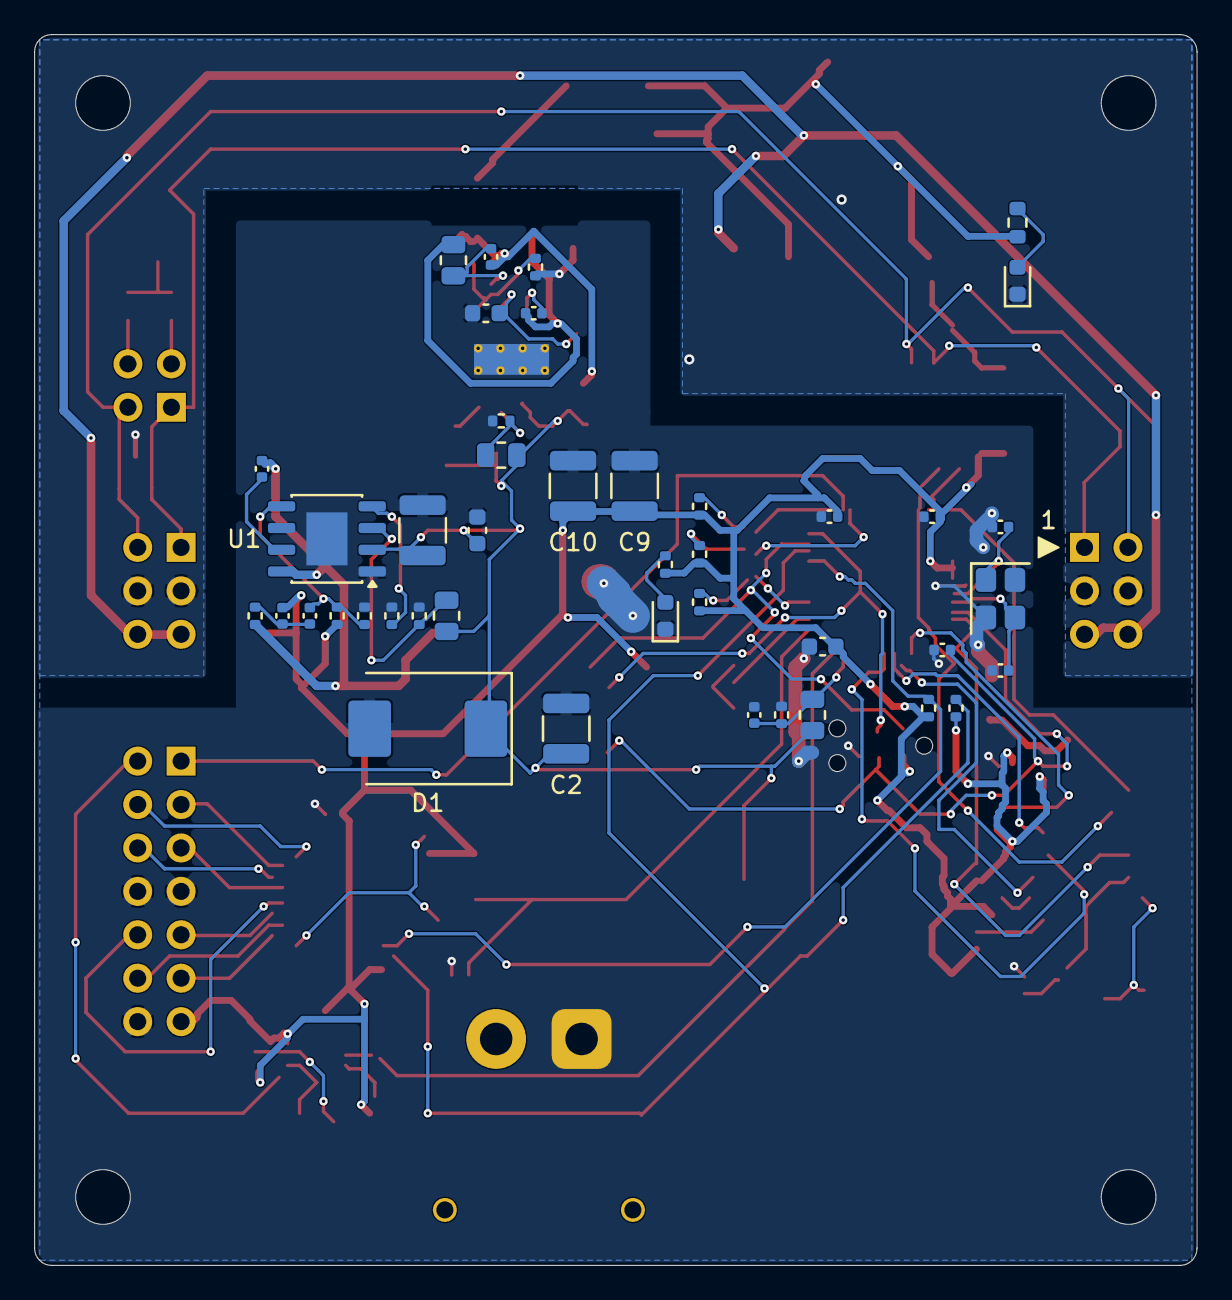
[picture p16: board pp-48-core-fd.kicad_pcb from below]

Board: 4 copper layers, 68.0 x 72.0 mm, 104 parts (45 on the bottom side), 69 nets.

Other parts of the board:
H1, H2, H3, H4: MountingHole_3.2mm_M3
