delandtj/granite_controller/controller-fd/granite-controller-fd.kicad_pcb

## KiCad design controller-fd/granite-controller-fd.kicad_pcb (2026-11-06)

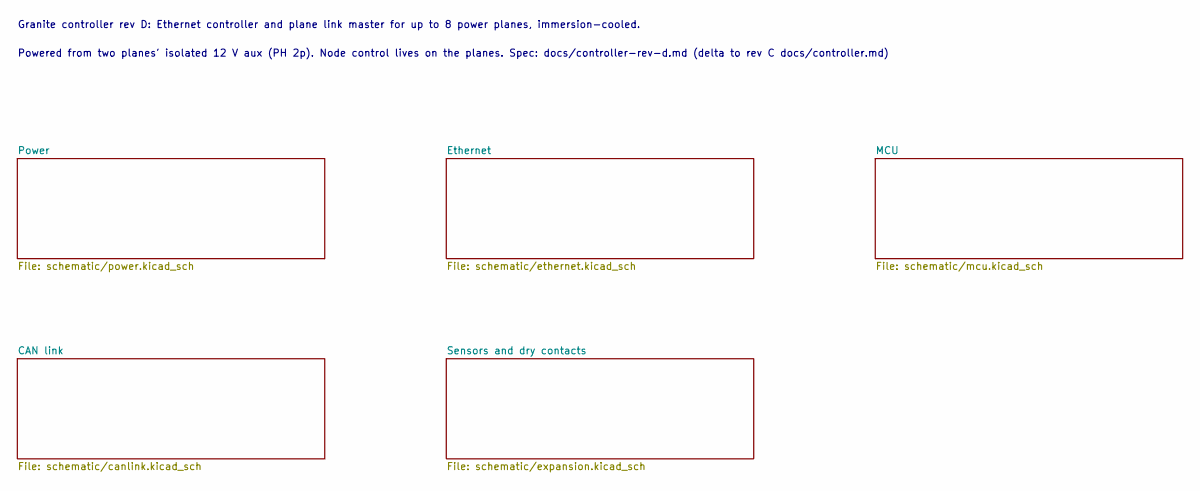
[picture p17: schematic granite-controller-fd.kicad_sch, Granite controller FD]

Notes on the sheet:
Granite controller rev D: Ethernet controller and plane link master for up to 8 power planes, immersion-cooled.
Powered from two planes' isolated 12 V aux (PH 2p). Node control lives on the planes. Spec: docs/controller-rev-d.md (delta to rev C docs/controller.md)

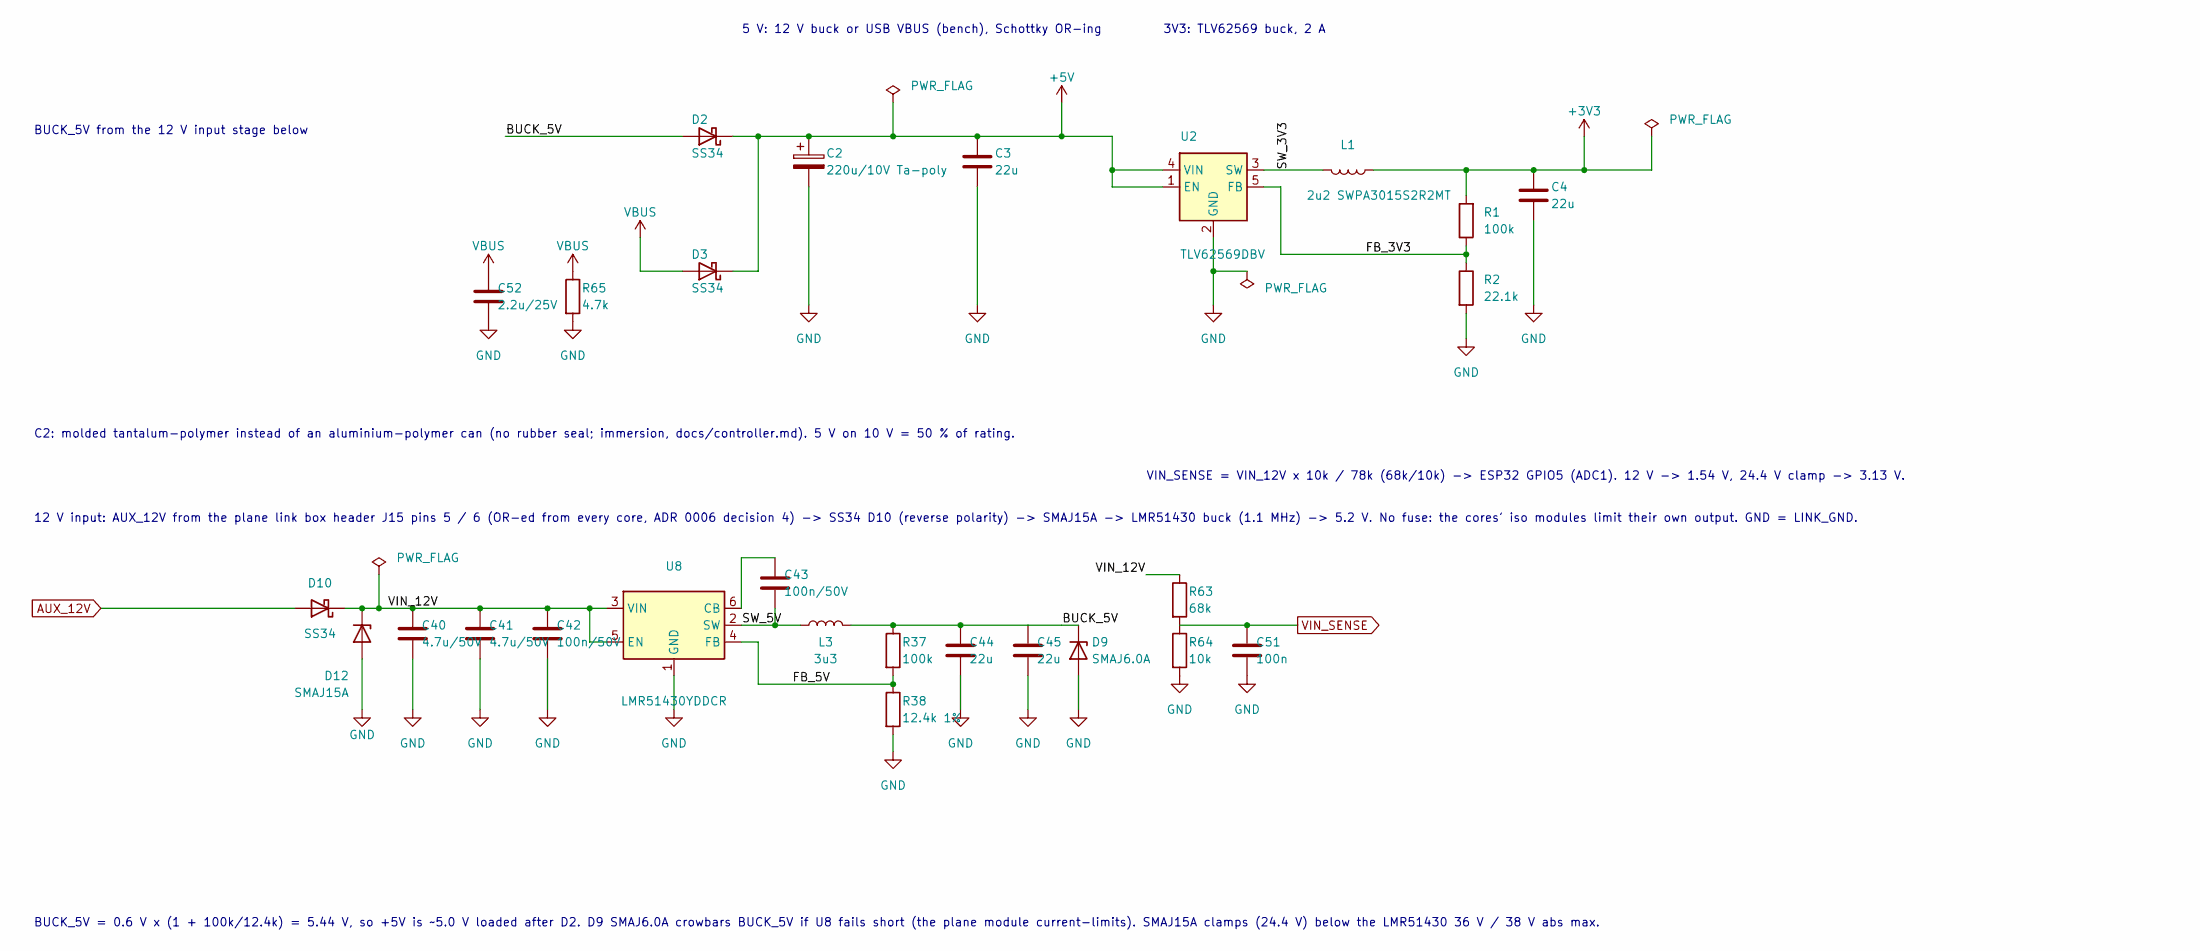
[picture p18: schematic power.kicad_sch, Granite controller FD - Power]

Parts:
C2: 220u/10V Ta-poly; CP_EIA-7343-31_Kemet-D; MPN T520D227M010ATE018; LCSC C116742
C3, C4, C44, C45: 22u; C_0805_2012Metric; MPN CL21A226MAQNNNE; LCSC C45783
C40, C41: 4.7u/50V; C_1206_3216Metric; MPN 1206B475K500NT; LCSC C29823
C42, C43: 100n/50V; C_0402_1005Metric; MPN CL05B104KB54PNC; LCSC C307331
C51: 100n; C_0402_1005Metric; MPN CL05B104KO5NNNC; LCSC C1525
C52: 2.2u/25V; C_0603_1608Metric; MPN CL10A225KA8NNNC; LCSC C57895
D2, D3, D10: SS34; D_SMA; MPN SS34; LCSC C8678
D9: SMAJ6.0A; D_SMA; MPN SMAJ6.0A; LCSC C364284
D12: SMAJ15A; D_SMA; MPN SMAJ15A; LCSC C148216
L1: 2u2 SWPA3015S2R2MT; L_Sunlord_SWPA3015S; MPN SWPA3015S2R2MT; LCSC C43389
L3: 3u3; L_Changjiang_FXL0630; MPN FXL0630-3R3-M; LCSC C167219
R1, R37: 100k; R_0402_1005Metric; MPN 0402WGF1003TCE; LCSC C25741
R2: 22.1k; R_0402_1005Metric; MPN RC0402FR-0722K1L; LCSC C163478
R38: 12.4k 1%; R_0402_1005Metric; MPN 0402WGF1242TCE; LCSC C11692
R63: 68k; R_0402_1005Metric; MPN 0402WGF6802TCE; LCSC C36871
R64: 10k; R_0402_1005Metric; MPN 0402WGF1002TCE; LCSC C25744
R65: 4.7k; R_0402_1005Metric; MPN 0402WGF4701TCE; LCSC C25900
U2: TLV62569DBV; SOT-23-5; MPN TLV62569DBVR; LCSC C141836
U8: LMR51430YDDCR; SOT-23-6; MPN LMR51430YDDCR; LCSC C5210749

Connections:
+3V3: C4.1, L1.1, R1.2; also elsewhere on the board
+5V: C2.1, C3.1, D2.1 (K), D3.1 (K), U2.1 (EN), U2.4 (VIN); also elsewhere on the board
/Power/BUCK_5V: C44.1, C45.1, D2.2 (A), D9.1 (K), L3.2, R37.1
/Power/FB_3V3: R1.1, R2.1, U2.5 (FB)
/Power/FB_5V: R37.2, R38.1, U8.4 (FB)
/Power/SW_3V3: L1.2, U2.3 (SW)
/Power/SW_5V: C43.2, L3.1, U8.2 (SW)
/Power/VIN_12V: C40.1, C41.1, C42.1, D10.1 (K), D12.1 (K), R63.1, U8.3 (VIN), U8.5 (EN)
AUX_12V: D10.2 (A); also elsewhere on the board
GND: C2.2, C3.2, C4.2, C40.2, C41.2, C42.2, C44.2, C45.2, C51.2, C52.2, D9.2 (A), D12.2 (A), R2.2, R38.2, R64.2, R65.2, U2.2 (GND), U8.1 (GND); also elsewhere on the board
unnamed: C43.1, U8.6 (CB)
VBUS: C52.1, D3.2 (A), R65.1; also elsewhere on the board
VIN_SENSE: C51.1, R63.2, R64.1; also elsewhere on the board

Notes on the sheet:
5 V: 12 V buck or USB VBUS (bench), Schottky OR-ing
3V3: TLV62569 buck, 2 A
BUCK_5V from the 12 V input stage below
12 V input: AUX_12V from the plane link box header J15 pins 5 / 6 (OR-ed from every core, ADR 0006 decision 4) -> SS34 D10 (reverse polarity) -> SMAJ15A -> LMR51430 buck (1.1 MHz) -> 5.2 V. No fuse: the cores' iso modules limit their own output. GND = LINK_GND.
BUCK_5V = 0.6 V x (1 + 100k/12.4k) = 5.44 V, so +5V is ~5.0 V loaded after D2. D9 SMAJ6.0A crowbars BUCK_5V if U8 fails short (the plane module current-limits). SMAJ15A clamps (24.4 V) below the LMR51430 36 V / 38 V abs max.
C2: molded tantalum-polymer instead of an aluminium-polymer can (no rubber seal; immersion, docs/controller.md). 5 V on 10 V = 50 % of rating.
VIN_SENSE = VIN_12V x 10k / 78k (68k/10k) -> ESP32 GPIO5 (ADC1). 12 V -> 1.54 V, 24.4 V clamp -> 3.13 V.

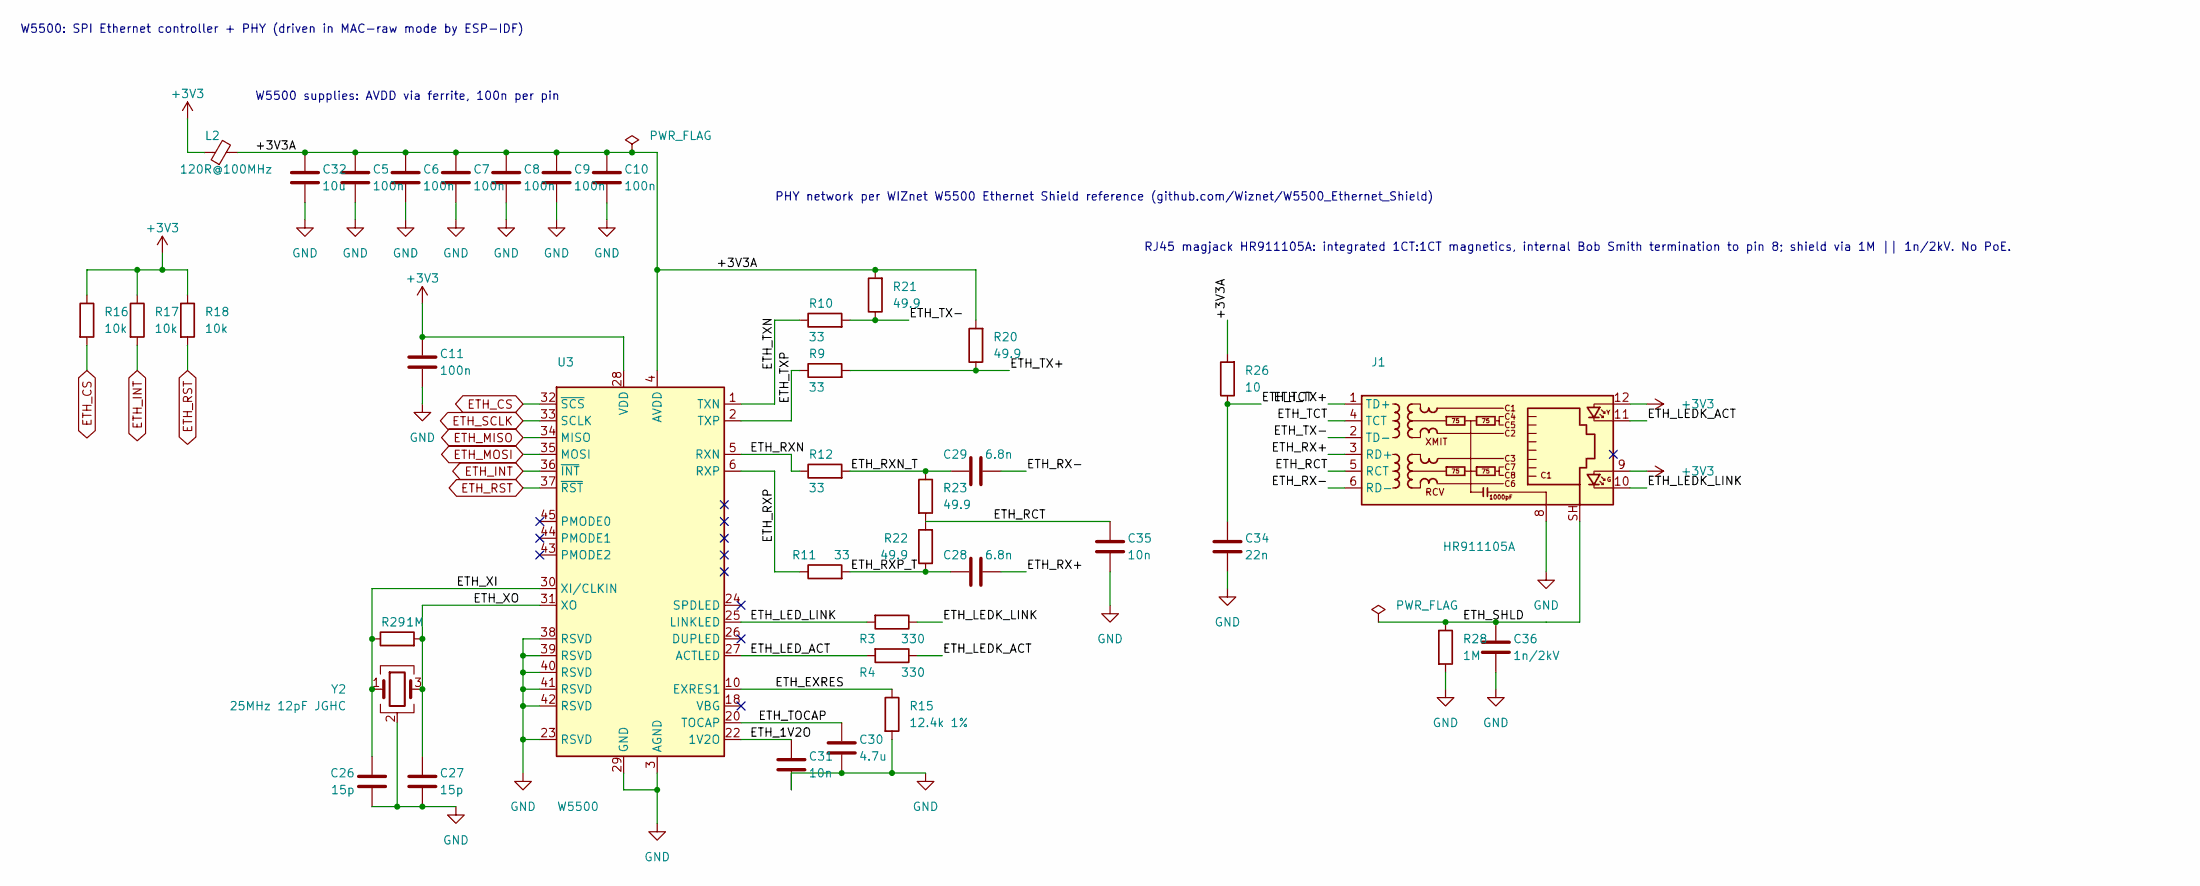
[picture p19: schematic ethernet.kicad_sch, Granite controller FD - Ethernet]

Parts:
C5, C6, C7, C8, C9, C10, C11: 100n; C_0402_1005Metric; MPN CL05B104KO5NNNC; LCSC C1525
C26, C27: 15p; C_0402_1005Metric; MPN 0402CG150J500NT; LCSC C1548
C28, C29: 6.8n; C_0402_1005Metric; MPN CC0402KRX7R9BB682; LCSC C93654
C30: 4.7u; C_0603_1608Metric; MPN CL10A475KO8NNNC; LCSC C19666
C31, C35: 10n; C_0402_1005Metric; MPN CL05B103KB5NNNC; LCSC C15195
C32: 10u; C_0805_2012Metric; MPN CL21A106KAYNNNE; LCSC C15850
C34: 22n; C_0402_1005Metric; MPN 0402B223K500NT; LCSC C1532
C36: 1n/2kV; C_1812_4532Metric; MPN CC1812KKX7RDBB102; LCSC C118019
J1: HR911105A; RJ45_Hanrun_HR911105A_Horizontal; MPN HR911105A; LCSC C12074
L2: 120R@100MHz; L_0603_1608Metric; MPN BLM18PG121SN1D; LCSC C14709
R3, R4: 330; R_0402_1005Metric; MPN 0402WGF3300TCE; LCSC C25104
R9, R10, R11, R12: 33; R_0402_1005Metric; MPN 0402WGF330JTCE; LCSC C25105
R15: 12.4k 1%; R_0402_1005Metric; MPN 0402WGF1242TCE; LCSC C11692
R16, R17, R18: 10k; R_0402_1005Metric; MPN 0402WGF1002TCE; LCSC C25744
R20, R21, R22, R23: 49.9; R_0402_1005Metric; MPN 0402WGF499JTCE; LCSC C25120
R26: 10; R_0402_1005Metric; MPN 0402WGF100JTCE; LCSC C25077
R28: 1M; R_0603_1608Metric; MPN 0603WAF1004T5E; LCSC C22935
R29: 1M; R_0402_1005Metric; MPN 0402WGF1004TCE; LCSC C26083
U3: W5500; LQFP-48_7x7mm_P0.5mm; MPN W5500; LCSC C32843
Y2: 25MHz 12pF JGHC; Crystal_SMD_Abracon_ABM8G-4Pin_3.2x2.5mm; MPN S3225000121060; LCSC C390773

Connections:
+3V3: C11.1, J1.9, J1.12, L2.1, R16.1, R17.1, R18.1, U3.28 (VDD); also elsewhere on the board
/Ethernet/+3V3A: C5.1, C6.1, C7.1, C8.1, C9.1, C10.1, C32.1, L2.2, R20.2, R21.2, R26.2, U3.4 (AVDD), U3.8 (AVDD), U3.11 (AVDD), U3.15 (AVDD), U3.17 (AVDD), U3.21 (AVDD)
/Ethernet/ETH_1V2O: C31.1, U3.22 (1V2O)
/Ethernet/ETH_EXRES: R15.1, U3.10 (EXRES1)
/Ethernet/ETH_LEDK_ACT: J1.11, R4.1
/Ethernet/ETH_LEDK_LINK: J1.10, R3.1
/Ethernet/ETH_LED_ACT: R4.2, U3.27 (ACTLED)
/Ethernet/ETH_LED_LINK: R3.2, U3.25 (LINKLED)
/Ethernet/ETH_RCT: C35.1, J1.5 (RCT), R22.2, R23.2
/Ethernet/ETH_RX+: C28.2, J1.3 (RD+)
/Ethernet/ETH_RX-: C29.2, J1.6 (RD-)
/Ethernet/ETH_RXN: R12.1, U3.5 (RXN)
/Ethernet/ETH_RXN_T: C29.1, R12.2, R23.1
/Ethernet/ETH_RXP: R11.1, U3.6 (RXP)
/Ethernet/ETH_RXP_T: C28.1, R11.2, R22.1
/Ethernet/ETH_SHLD: C36.1, J1.SH, R28.1
/Ethernet/ETH_TCT: C34.1, J1.4 (TCT), R26.1
/Ethernet/ETH_TOCAP: C30.1, U3.20 (TOCAP)
/Ethernet/ETH_TX+: J1.1 (TD+), R9.2, R20.1
/Ethernet/ETH_TX-: J1.2 (TD-), R10.2, R21.1
/Ethernet/ETH_TXN: R10.1, U3.1 (TXN)
/Ethernet/ETH_TXP: R9.1, U3.2 (TXP)
/Ethernet/ETH_XI: C26.1, R29.1, U3.30 (XI/CLKIN), Y2.1
/Ethernet/ETH_XO: C27.1, R29.2, U3.31 (XO), Y2.3
ETH_CS: R16.2, U3.32 (~SCS); also elsewhere on the board
ETH_INT: R17.2, U3.36 (~INT); also elsewhere on the board
ETH_MISO: U3.34 (MISO); also elsewhere on the board
ETH_MOSI: U3.35 (MOSI); also elsewhere on the board
ETH_RST: R18.2, U3.37 (~RST); also elsewhere on the board
ETH_SCLK: U3.33 (SCLK); also elsewhere on the board
GND: C5.2, C6.2, C7.2, C8.2, C9.2, C10.2, C11.2, C26.2, C27.2, C30.2, C31.2, C32.2, C34.2, C35.2, C36.2, J1.8, R15.2, R28.2, U3.3 (AGND), U3.9 (AGND), U3.14 (AGND), U3.16 (AGND), U3.19 (AGND), U3.23 (RSVD), U3.29 (GND), U3.38 (RSVD), U3.39 (RSVD), U3.40 (RSVD), U3.41 (RSVD), U3.42 (RSVD), U3.48 (AGND), Y2.2 (G), Y2.4 (G); also elsewhere on the board

Notes on the sheet:
W5500: SPI Ethernet controller + PHY (driven in MAC-raw mode by ESP-IDF)
W5500 supplies: AVDD via ferrite, 100n per pin
PHY network per WIZnet W5500 Ethernet Shield reference (github.com/Wiznet/W5500_Ethernet_Shield)
RJ45 magjack HR911105A: integrated 1CT:1CT magnetics, internal Bob Smith termination to pin 8; shield via 1M || 1n/2kV. No PoE.

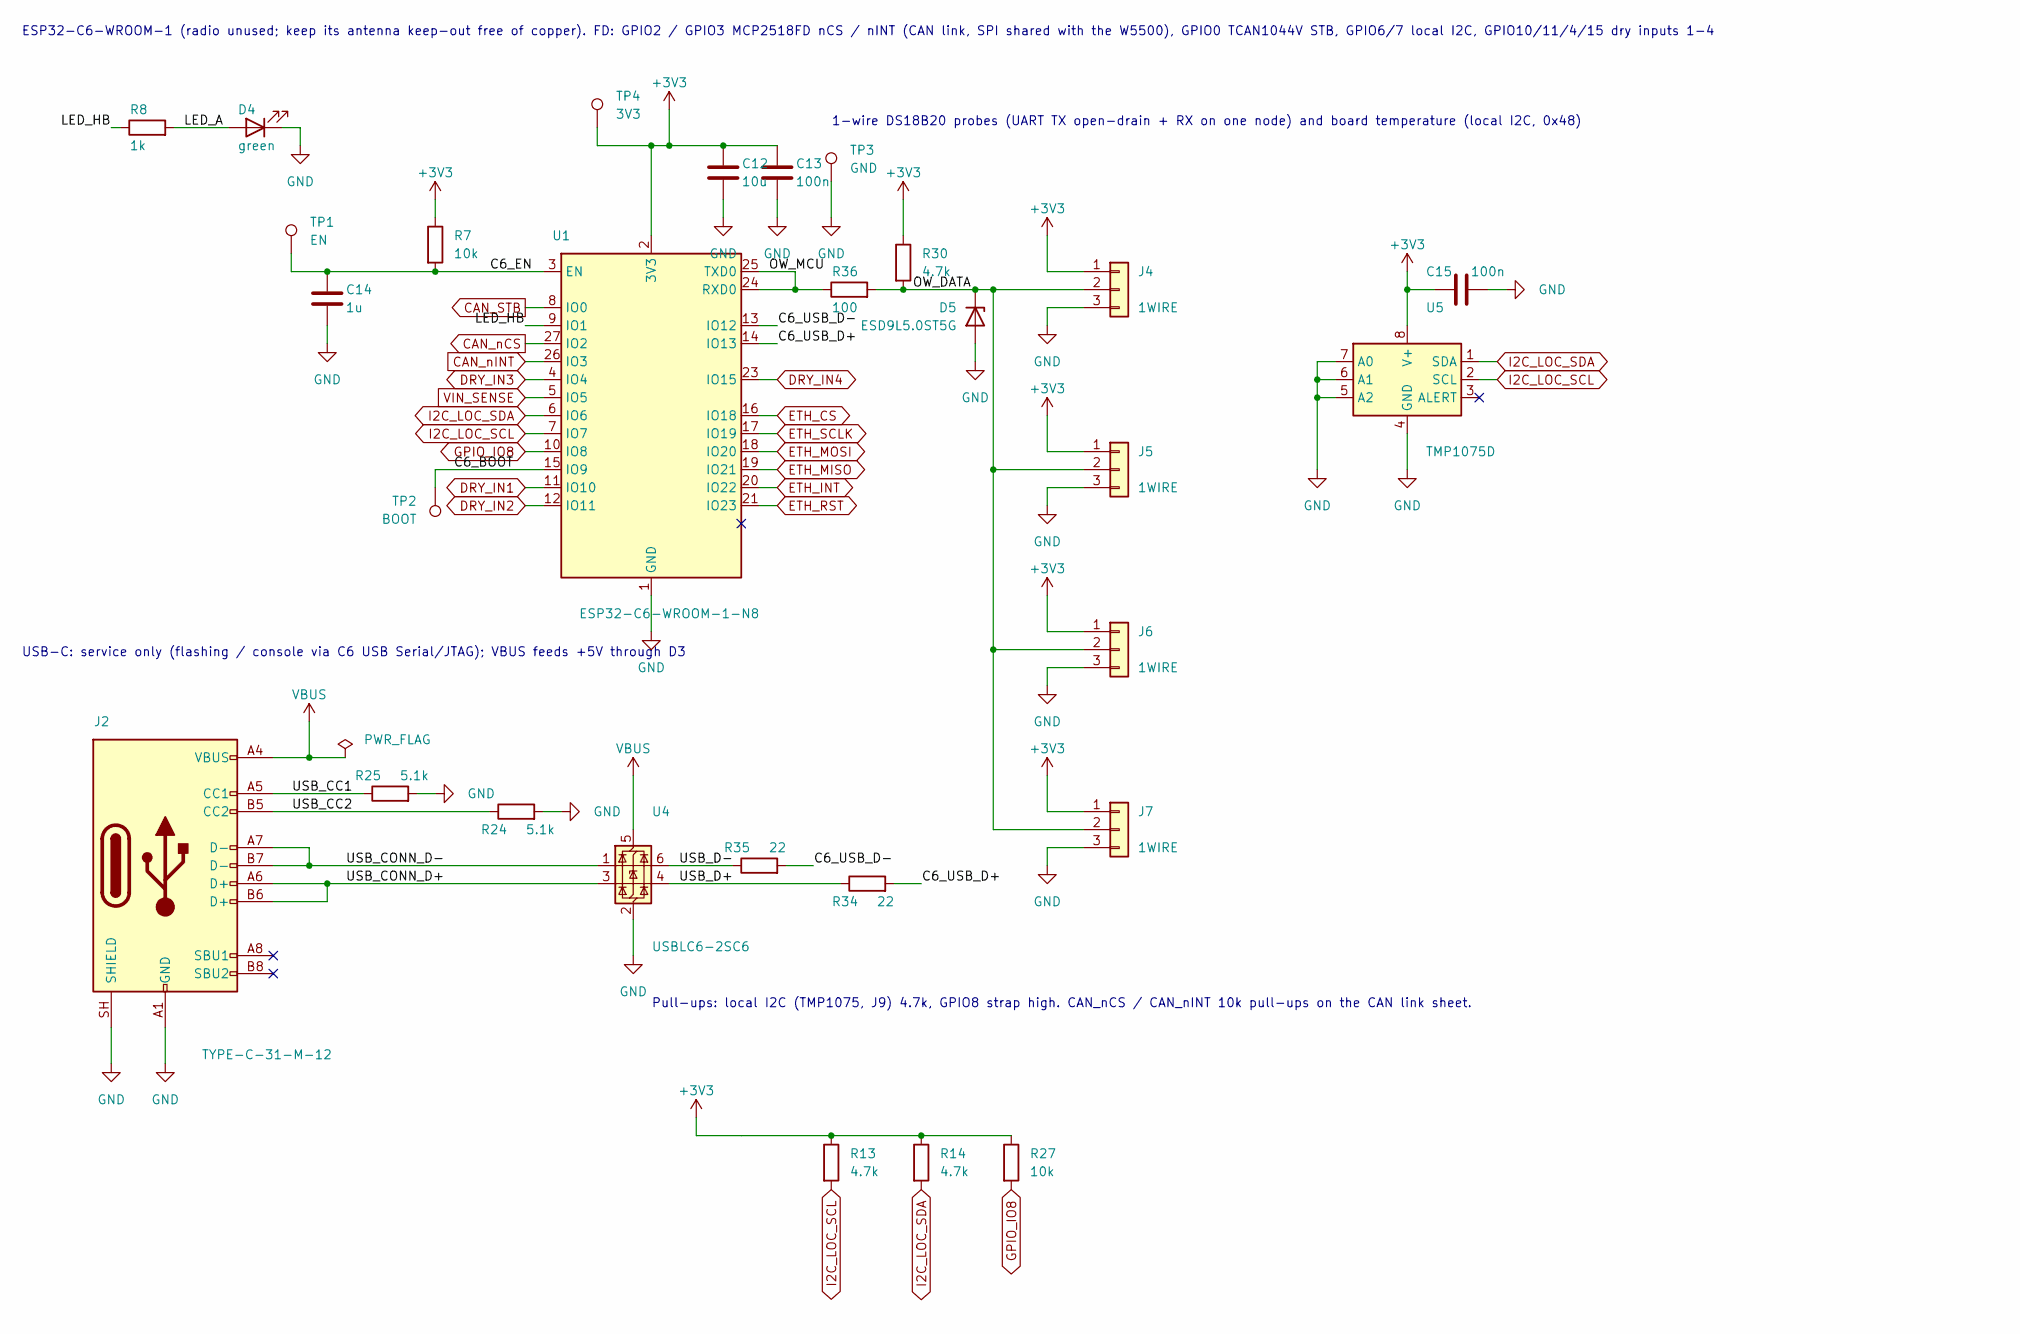
[picture p20: schematic mcu.kicad_sch, Granite controller FD - MCU]

Parts:
C12: 10u; C_0805_2012Metric; MPN CL21A106KAYNNNE; LCSC C15850
C13, C15: 100n; C_0402_1005Metric; MPN CL05B104KO5NNNC; LCSC C1525
C14: 1u; C_0603_1608Metric; MPN CL10A105KB8NNNC; LCSC C15849
D4: green; LED_0603_1608Metric; MPN KT-0603G; LCSC C12624
D5: ESD9L5.0ST5G; D_SOD-923; MPN ESD9L5.0ST5G; LCSC C82326
J2: TYPE-C-31-M-12; USB_C_Receptacle_HRO_TYPE-C-31-M-12; MPN TYPE-C-31-M-12; LCSC C165948
J4, J5, J6, J7: 1WIRE; JST_PH_B3B-PH-K_1x03_P2.00mm_Vertical; MPN B3B-PH-K-S(LF)(SN); LCSC C131339
R7, R27: 10k; R_0402_1005Metric; MPN 0402WGF1002TCE; LCSC C25744
R8: 1k; R_0402_1005Metric; MPN 0402WGF1001TCE; LCSC C11702
R13, R14, R30: 4.7k; R_0402_1005Metric; MPN 0402WGF4701TCE; LCSC C25900
R24, R25: 5.1k; R_0402_1005Metric; MPN 0402WGF5101TCE; LCSC C25905
R34, R35: 22; R_0402_1005Metric; MPN 0402WGF220JTCE; LCSC C25092
R36: 100; R_0603_1608Metric; MPN 0603WAF1000T5E; LCSC C22775
TP1: EN; TestPoint_Pad_D1.5mm
TP2: BOOT; TestPoint_Pad_D1.5mm
TP3: GND; TestPoint_Pad_D1.5mm
TP4: 3V3; TestPoint_Pad_D1.5mm
U1: ESP32-C6-WROOM-1-N8; ESP32-C6-WROOM-1; MPN ESP32-C6-WROOM-1-N8; LCSC C5366877
U4: USBLC6-2SC6; SOT-23-6; MPN USBLC6-2SC6; LCSC C7519
U5: TMP1075D; SOIC-8_3.9x4.9mm_P1.27mm; MPN TMP1075DR; LCSC C2878381

Connections:
+3V3: C12.1, C13.1, C15.1, J4.1, J5.1, J6.1, J7.1, R7.1, R13.1, R14.1, R27.1, R30.1, TP4.1, U1.2 (3V3), U5.8 (V+); also elsewhere on the board
/MCU/C6_BOOT: TP2.1, U1.15 (IO9)
/MCU/C6_EN: C14.1, R7.2, TP1.1, U1.3 (EN)
/MCU/C6_USB_D+: R34.2, U1.14 (IO13)
/MCU/C6_USB_D-: R35.2, U1.13 (IO12)
/MCU/LED_A: D4.2 (A), R8.2
/MCU/LED_HB: R8.1, U1.9 (IO1)
/MCU/OW_DATA: D5.1 (K), J4.2, J5.2, J6.2, J7.2, R30.2, R36.2
/MCU/OW_MCU: R36.1, U1.24 (RXD0), U1.25 (TXD0)
/MCU/USB_CC1: J2.A5 (CC1), R25.1
/MCU/USB_CC2: J2.B5 (CC2), R24.1
/MCU/USB_CONN_D+: J2.A6 (D+), J2.B6 (D+), U4.3 (I/O2)
/MCU/USB_CONN_D-: J2.A7 (D-), J2.B7 (D-), U4.1 (I/O1)
/MCU/USB_D+: R34.1, U4.4 (I/O2)
/MCU/USB_D-: R35.1, U4.6 (I/O1)
CAN_STB: U1.8 (IO0); also elsewhere on the board
CAN_nCS: U1.27 (IO2); also elsewhere on the board
CAN_nINT: U1.26 (IO3); also elsewhere on the board
DRY_IN1: U1.11 (IO10); also elsewhere on the board
DRY_IN2: U1.12 (IO11); also elsewhere on the board
DRY_IN3: U1.4 (IO4); also elsewhere on the board
DRY_IN4: U1.23 (IO15); also elsewhere on the board
ETH_CS: U1.16 (IO18); also elsewhere on the board
ETH_INT: U1.20 (IO22); also elsewhere on the board
ETH_MISO: U1.19 (IO21); also elsewhere on the board
ETH_MOSI: U1.18 (IO20); also elsewhere on the board
ETH_RST: U1.21 (IO23); also elsewhere on the board
ETH_SCLK: U1.17 (IO19); also elsewhere on the board
GND: C12.2, C13.2, C14.2, C15.2, D4.1 (K), D5.2 (A), J2.A1 (GND), J2.A12 (GND), J2.B1 (GND), J2.B12 (GND), J2.SH (SHIELD), J4.3, J5.3, J6.3, J7.3, R24.2, R25.2, TP3.1, U1.1 (GND), U1.28 (GND), U1.29 (GND), U4.2 (GND), U5.4 (GND), U5.5 (A2), U5.6 (A1), U5.7 (A0); also elsewhere on the board
GPIO_IO8: R27.2, U1.10 (IO8)
I2C_LOC_SCL: R13.2, U1.7 (IO7), U5.2 (SCL); also elsewhere on the board
I2C_LOC_SDA: R14.2, U1.6 (IO6), U5.1 (SDA); also elsewhere on the board
VBUS: J2.A4 (VBUS), J2.A9 (VBUS), J2.B4 (VBUS), J2.B9 (VBUS), U4.5 (VBUS); also elsewhere on the board
VIN_SENSE: U1.5 (IO5); also elsewhere on the board

Notes on the sheet:
ESP32-C6-WROOM-1 (radio unused; keep its antenna keep-out free of copper). FD: GPIO2 / GPIO3 MCP2518FD nCS / nINT (CAN link, SPI shared with the W5500), GPIO0 TCAN1044V STB, GPIO6/7 local I2C, GPIO10/11/4/15 dry inputs 1-4
1-wire DS18B20 probes (UART TX open-drain + RX on one node) and board temperature (local I2C, 0x48)
USB-C: service only (flashing / console via C6 USB Serial/JTAG); VBUS feeds +5V through D3
Pull-ups: local I2C (TMP1075, J9) 4.7k, GPIO8 strap high. CAN_nCS / CAN_nINT 10k pull-ups on the CAN link sheet.
