delandtj/granite_controller/controller-fd/granite-controller-fd.kicad_pcb

## KiCad design controller-fd/granite-controller-fd.kicad_pcb (continued)

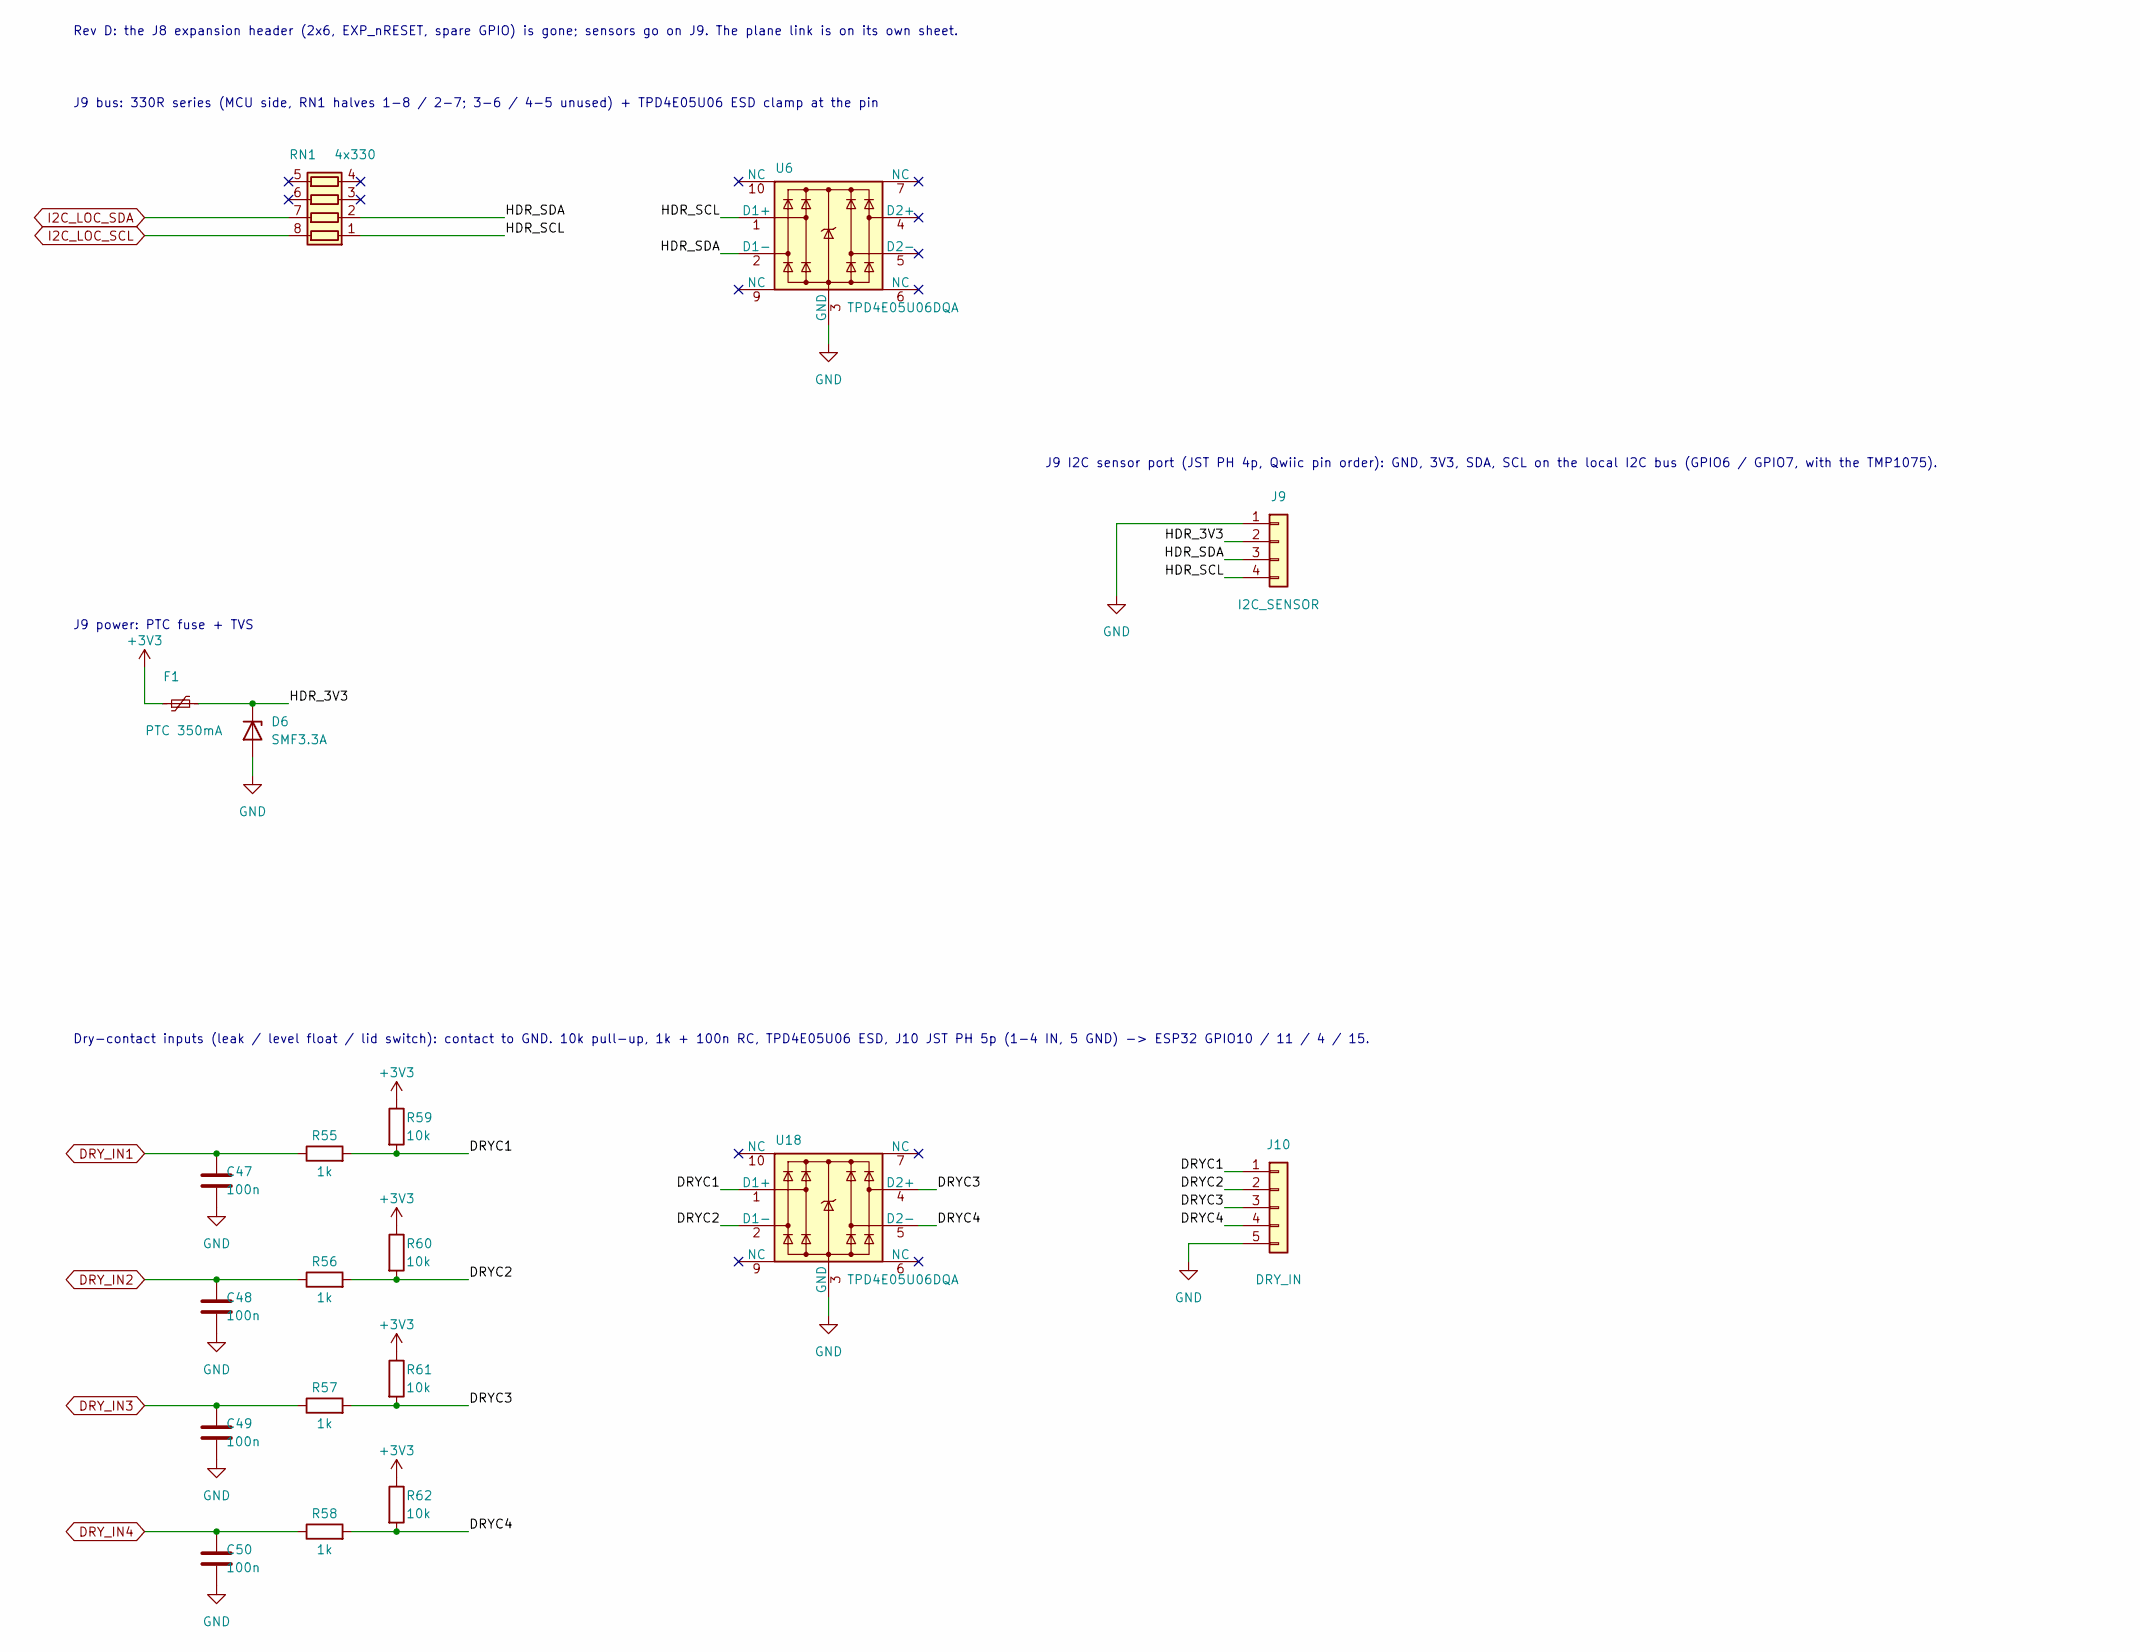
[picture p21: schematic expansion.kicad_sch, Granite controller FD - Sensors and dry contacts]

Parts:
C47, C48, C49, C50: 100n; C_0402_1005Metric; MPN CL05B104KO5NNNC; LCSC C1525
D6: SMF3.3A; D_SOD-123F; MPN SMF3.3A; LCSC C37331473
F1: PTC 350mA; Fuse_0805_2012Metric; MPN 0805L035/24XR; LCSC C7472565
J9: I2C_SENSOR; JST_PH_B4B-PH-K_1x04_P2.00mm_Vertical; MPN B4B-PH-K-S(LF)(SN); LCSC C131334
J10: DRY_IN; JST_PH_B5B-PH-K_1x05_P2.00mm_Vertical; MPN B5B-PH-K-S(LF)(SN); LCSC C157993
R55, R56, R57, R58: 1k; R_0402_1005Metric; MPN 0402WGF1001TCE; LCSC C11702
R59, R60, R61, R62: 10k; R_0402_1005Metric; MPN 0402WGF1002TCE; LCSC C25744
RN1: 4x330; R_Array_Convex_4x0402; MPN 4D02WGJ0331TCE; LCSC C43557
U6, U18: TPD4E05U06DQA; USON-10_2.5x1.0mm_P0.5mm; MPN TPD4E05U06DQAR; LCSC C138714

Connections:
+3V3: F1.1, R59.1, R60.1, R61.1, R62.1; also elsewhere on the board
/Sensors and dry contacts/DRYC1: J10.1, R55.2, R59.2, U18.1 (D1+)
/Sensors and dry contacts/DRYC2: J10.2, R56.2, R60.2, U18.2 (D1-)
/Sensors and dry contacts/DRYC3: J10.3, R57.2, R61.2, U18.4 (D2+)
/Sensors and dry contacts/DRYC4: J10.4, R58.2, R62.2, U18.5 (D2-)
/Sensors and dry contacts/HDR_3V3: D6.1 (K), F1.2, J9.2
/Sensors and dry contacts/HDR_SCL: J9.4, RN1.1 (R1.1), U6.1 (D1+)
/Sensors and dry contacts/HDR_SDA: J9.3, RN1.2 (R2.1), U6.2 (D1-)
DRY_IN1: C47.1, R55.1; also elsewhere on the board
DRY_IN2: C48.1, R56.1; also elsewhere on the board
DRY_IN3: C49.1, R57.1; also elsewhere on the board
DRY_IN4: C50.1, R58.1; also elsewhere on the board
GND: C47.2, C48.2, C49.2, C50.2, D6.2 (A), J9.1, J10.5, U6.3 (GND), U6.8 (GND), U18.3 (GND), U18.8 (GND); also elsewhere on the board
I2C_LOC_SCL: RN1.8 (R1.2); also elsewhere on the board
I2C_LOC_SDA: RN1.7 (R2.2); also elsewhere on the board

Notes on the sheet:
Rev D: the J8 expansion header (2x6, EXP_nRESET, spare GPIO) is gone; sensors go on J9. The plane link is on its own sheet.
J9 bus: 330R series (MCU side, RN1 halves 1-8 / 2-7; 3-6 / 4-5 unused) + TPD4E05U06 ESD clamp at the pin
J9 power: PTC fuse + TVS
J9 I2C sensor port (JST PH 4p, Qwiic pin order): GND, 3V3, SDA, SCL on the local I2C bus (GPIO6 / GPIO7, with the TMP1075).
Dry-contact inputs (leak / level float / lid switch): contact to GND. 10k pull-up, 1k + 100n RC, TPD4E05U06 ESD, J10 JST PH 5p (1-4 IN, 5 GND) -> ESP32 GPIO10 / 11 / 4 / 15.

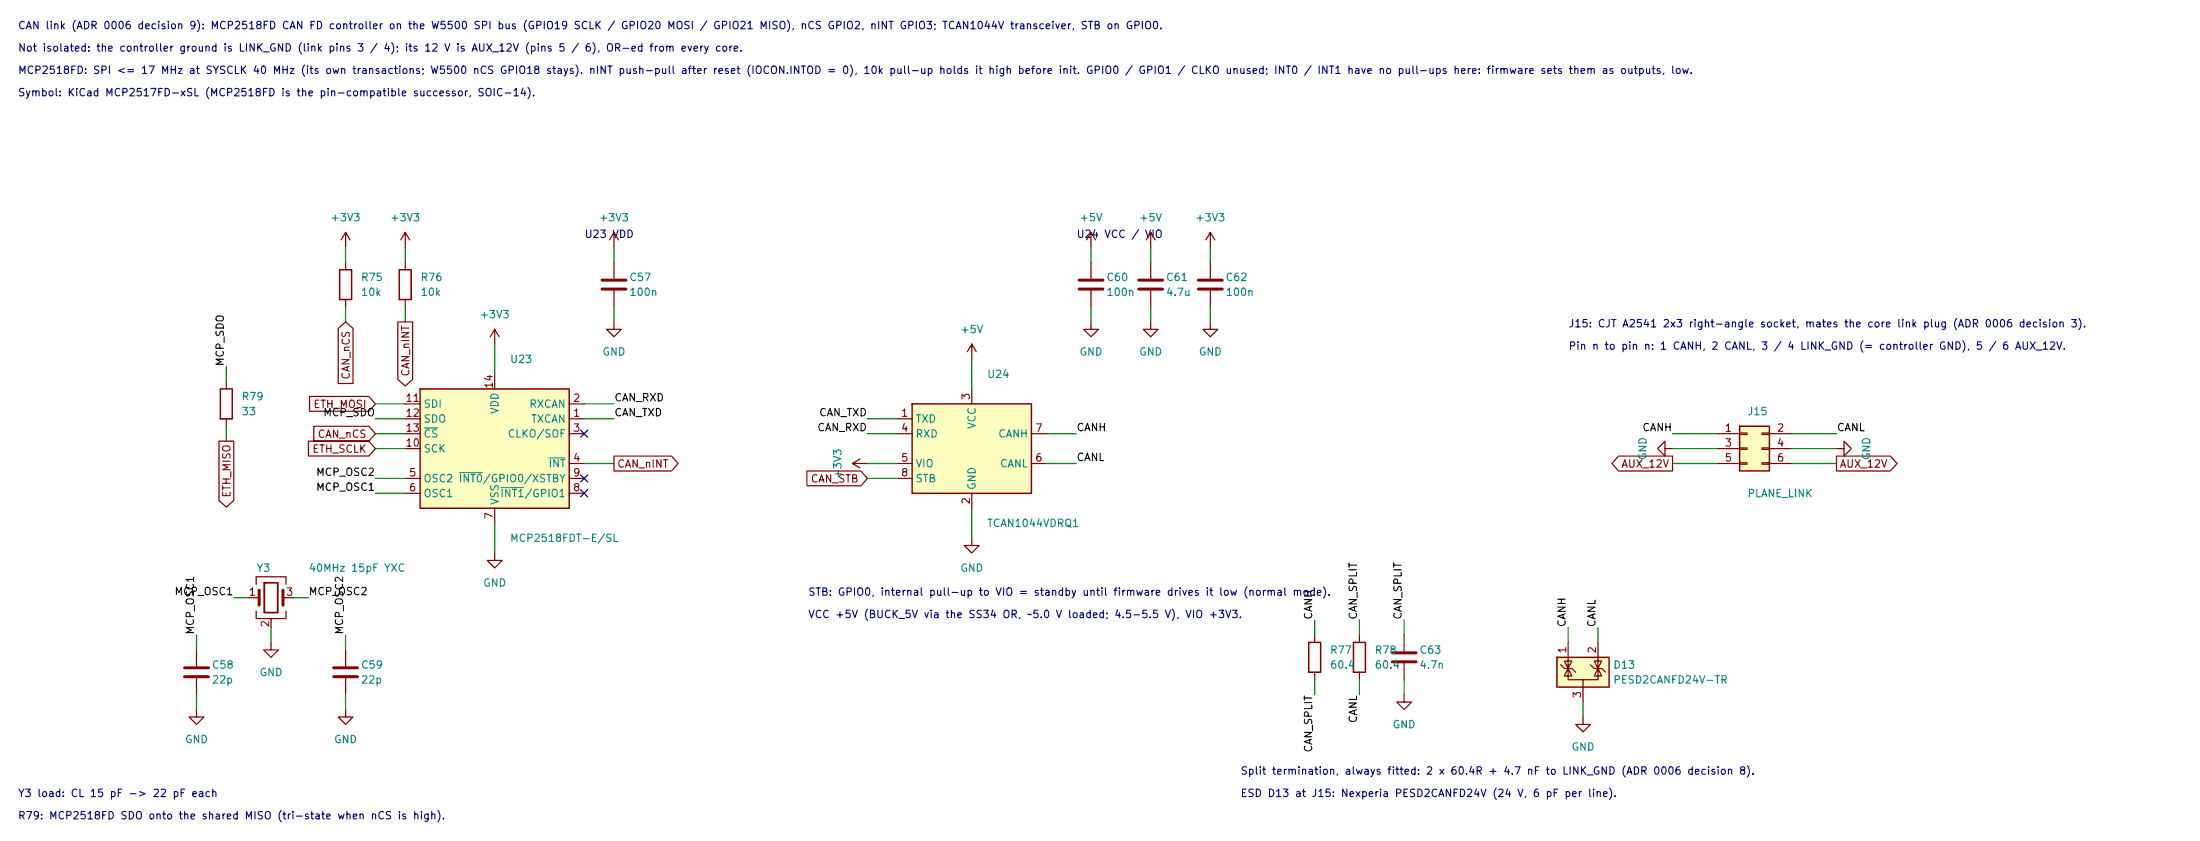
[picture p22: schematic canlink.kicad_sch, Granite controller FD - CAN link]

Parts:
C57, C60, C62: 100n; C_0402_1005Metric; MPN CL05B104KO5NNNC; LCSC C1525
C58, C59: 22p; C_0402_1005Metric; MPN 0402CG220J500NT; LCSC C1555
C61: 4.7u; C_0603_1608Metric; MPN CL10A475KO8NNNC; LCSC C19666
C63: 4.7n; C_0402_1005Metric; MPN 0402B472K500NT; LCSC C1538
D13: PESD2CANFD24V-TR; SOT-23; MPN PESD2CANFD24V-TR; LCSC C552486
J15: PLANE_LINK; PinSocket_2x03_P2.54mm_Horizontal; MPN A2541HWR-2x3P; LCSC C5333425
R75, R76: 10k; R_0402_1005Metric; MPN 0402WGF1002TCE; LCSC C25744
R77, R78: 60.4; R_0402_1005Metric; MPN 0402WGF604JTCE; LCSC C60310
R79: 33; R_0402_1005Metric; MPN 0402WGF330JTCE; LCSC C25105
U23: MCP2518FDT-E/SL; SOIC-14_3.9x8.7mm_P1.27mm; MPN MCP2518FDT-E/SL; LCSC C626758
U24: TCAN1044VDRQ1; SOIC-8_3.9x4.9mm_P1.27mm; MPN TCAN1044VDRQ1; LCSC C1852061
Y3: 40MHz 15pF YXC; Crystal_SMD_Abracon_ABM8G-4Pin_3.2x2.5mm; MPN X322540MPB4SI; LCSC C9010

Connections:
+3V3: C57.1, C62.1, R75.1, R76.1, U23.14 (VDD), U24.5 (VIO); also elsewhere on the board
+5V: C60.1, C61.1, U24.3 (VCC); also elsewhere on the board
/CAN link/CANH: D13.1 (K), J15.1, R77.1, U24.7 (CANH)
/CAN link/CANL: D13.2 (K), J15.2, R78.2, U24.6 (CANL)
/CAN link/CAN_RXD: U23.2 (RXCAN), U24.4 (RXD)
/CAN link/CAN_SPLIT: C63.1, R77.2, R78.1
/CAN link/CAN_TXD: U23.1 (TXCAN), U24.1 (TXD)
/CAN link/MCP_OSC1: C58.1, U23.6 (OSC1), Y3.1
/CAN link/MCP_OSC2: C59.1, U23.5 (OSC2), Y3.3
/CAN link/MCP_SDO: R79.1, U23.12 (SDO)
AUX_12V: J15.5, J15.6; also elsewhere on the board
CAN_STB: U24.8 (STB); also elsewhere on the board
CAN_nCS: R75.2, U23.13 (~CS); also elsewhere on the board
CAN_nINT: R76.2, U23.4 (~INT); also elsewhere on the board
ETH_MISO: R79.2; also elsewhere on the board
ETH_MOSI: U23.11 (SDI); also elsewhere on the board
ETH_SCLK: U23.10 (SCK); also elsewhere on the board
GND: C57.2, C58.2, C59.2, C60.2, C61.2, C62.2, C63.2, D13.3 (A), J15.3, J15.4, U23.7 (VSS), U24.2 (GND), Y3.2 (G), Y3.4 (G); also elsewhere on the board

Notes on the sheet:
CAN link (ADR 0006 decision 9): MCP2518FD CAN FD controller on the W5500 SPI bus (GPIO19 SCLK / GPIO20 MOSI / GPIO21 MISO), nCS GPIO2, nINT GPIO3; TCAN1044V transceiver, STB on GPIO0.
Not isolated: the controller ground is LINK_GND (link pins 3 / 4); its 12 V is AUX_12V (pins 5 / 6), OR-ed from every core.
MCP2518FD: SPI <= 17 MHz at SYSCLK 40 MHz (its own transactions; W5500 nCS GPIO18 stays). nINT push-pull after reset (IOCON.INTOD = 0), 10k pull-up holds it high before init. GPIO0 / GPIO1 / CLKO unused; INT0 / INT1 have no pull-ups here: firmware sets them as outputs, low.
Symbol: KiCad MCP2517FD-xSL (MCP2518FD is the pin-compatible successor, SOIC-14).
R79: MCP2518FD SDO onto the shared MISO (tri-state when nCS is high).
U23 VDD
Y3 load: CL 15 pF -> 22 pF each
STB: GPIO0, internal pull-up to VIO = standby until firmware drives it low (normal mode).
VCC +5V (BUCK_5V via the SS34 OR, ~5.0 V loaded; 4.5-5.5 V), VIO +3V3.
U24 VCC / VIO
J15: CJT A2541 2x3 right-angle socket, mates the core link plug (ADR 0006 decision 3).
Pin n to pin n: 1 CANH, 2 CANL, 3 / 4 LINK_GND (= controller GND), 5 / 6 AUX_12V.
Split termination, always fitted: 2 x 60.4R + 4.7 nF to LINK_GND (ADR 0006 decision 8).
ESD D13 at J15: Nexperia PESD2CANFD24V (24 V, 6 pF per line).

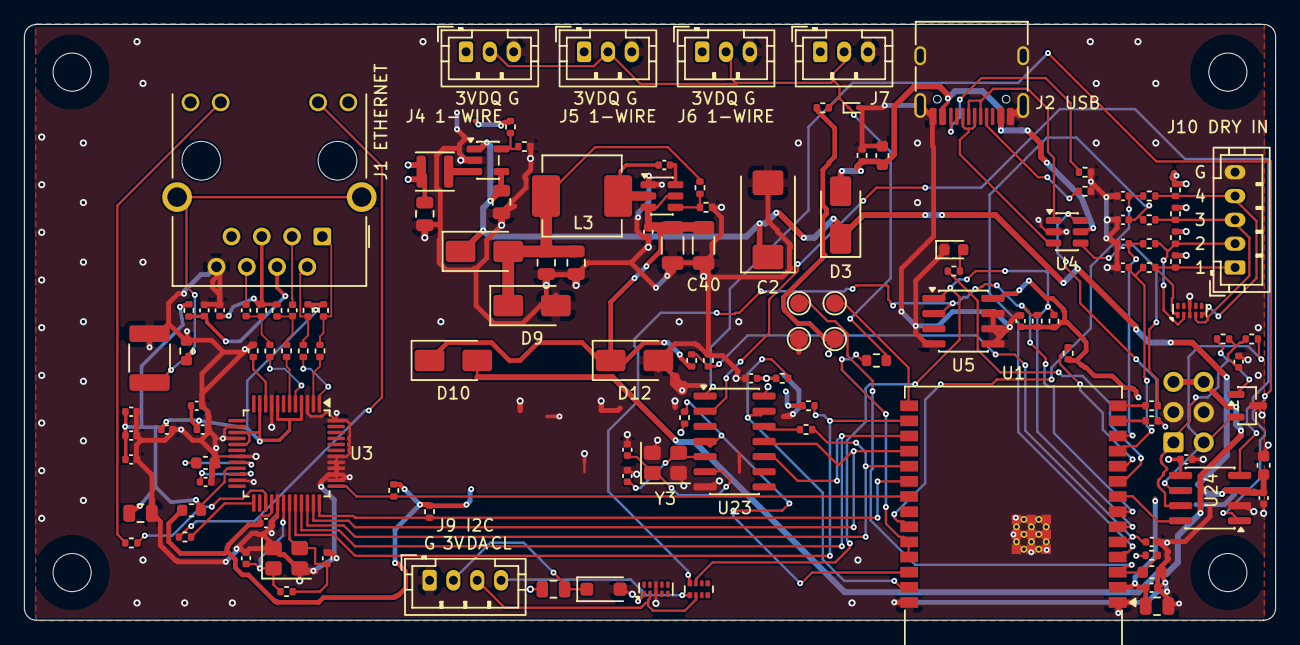
[picture p23: board granite-controller-fd.kicad_pcb from above]

Board: 4 copper layers, 105.0 x 50.0 mm, 134 parts (1 on the bottom side), 81 nets.

Other parts of the board:
H1, H2, H3, H4: MountingHole_3.2mm_M3
