delandtj/granite_controller/power/pm-19v-250w/pm-19v-250w.kicad_pcb

## KiCad design power/pm-19v-250w/pm-19v-250w.kicad_pcb (2026-11-06)

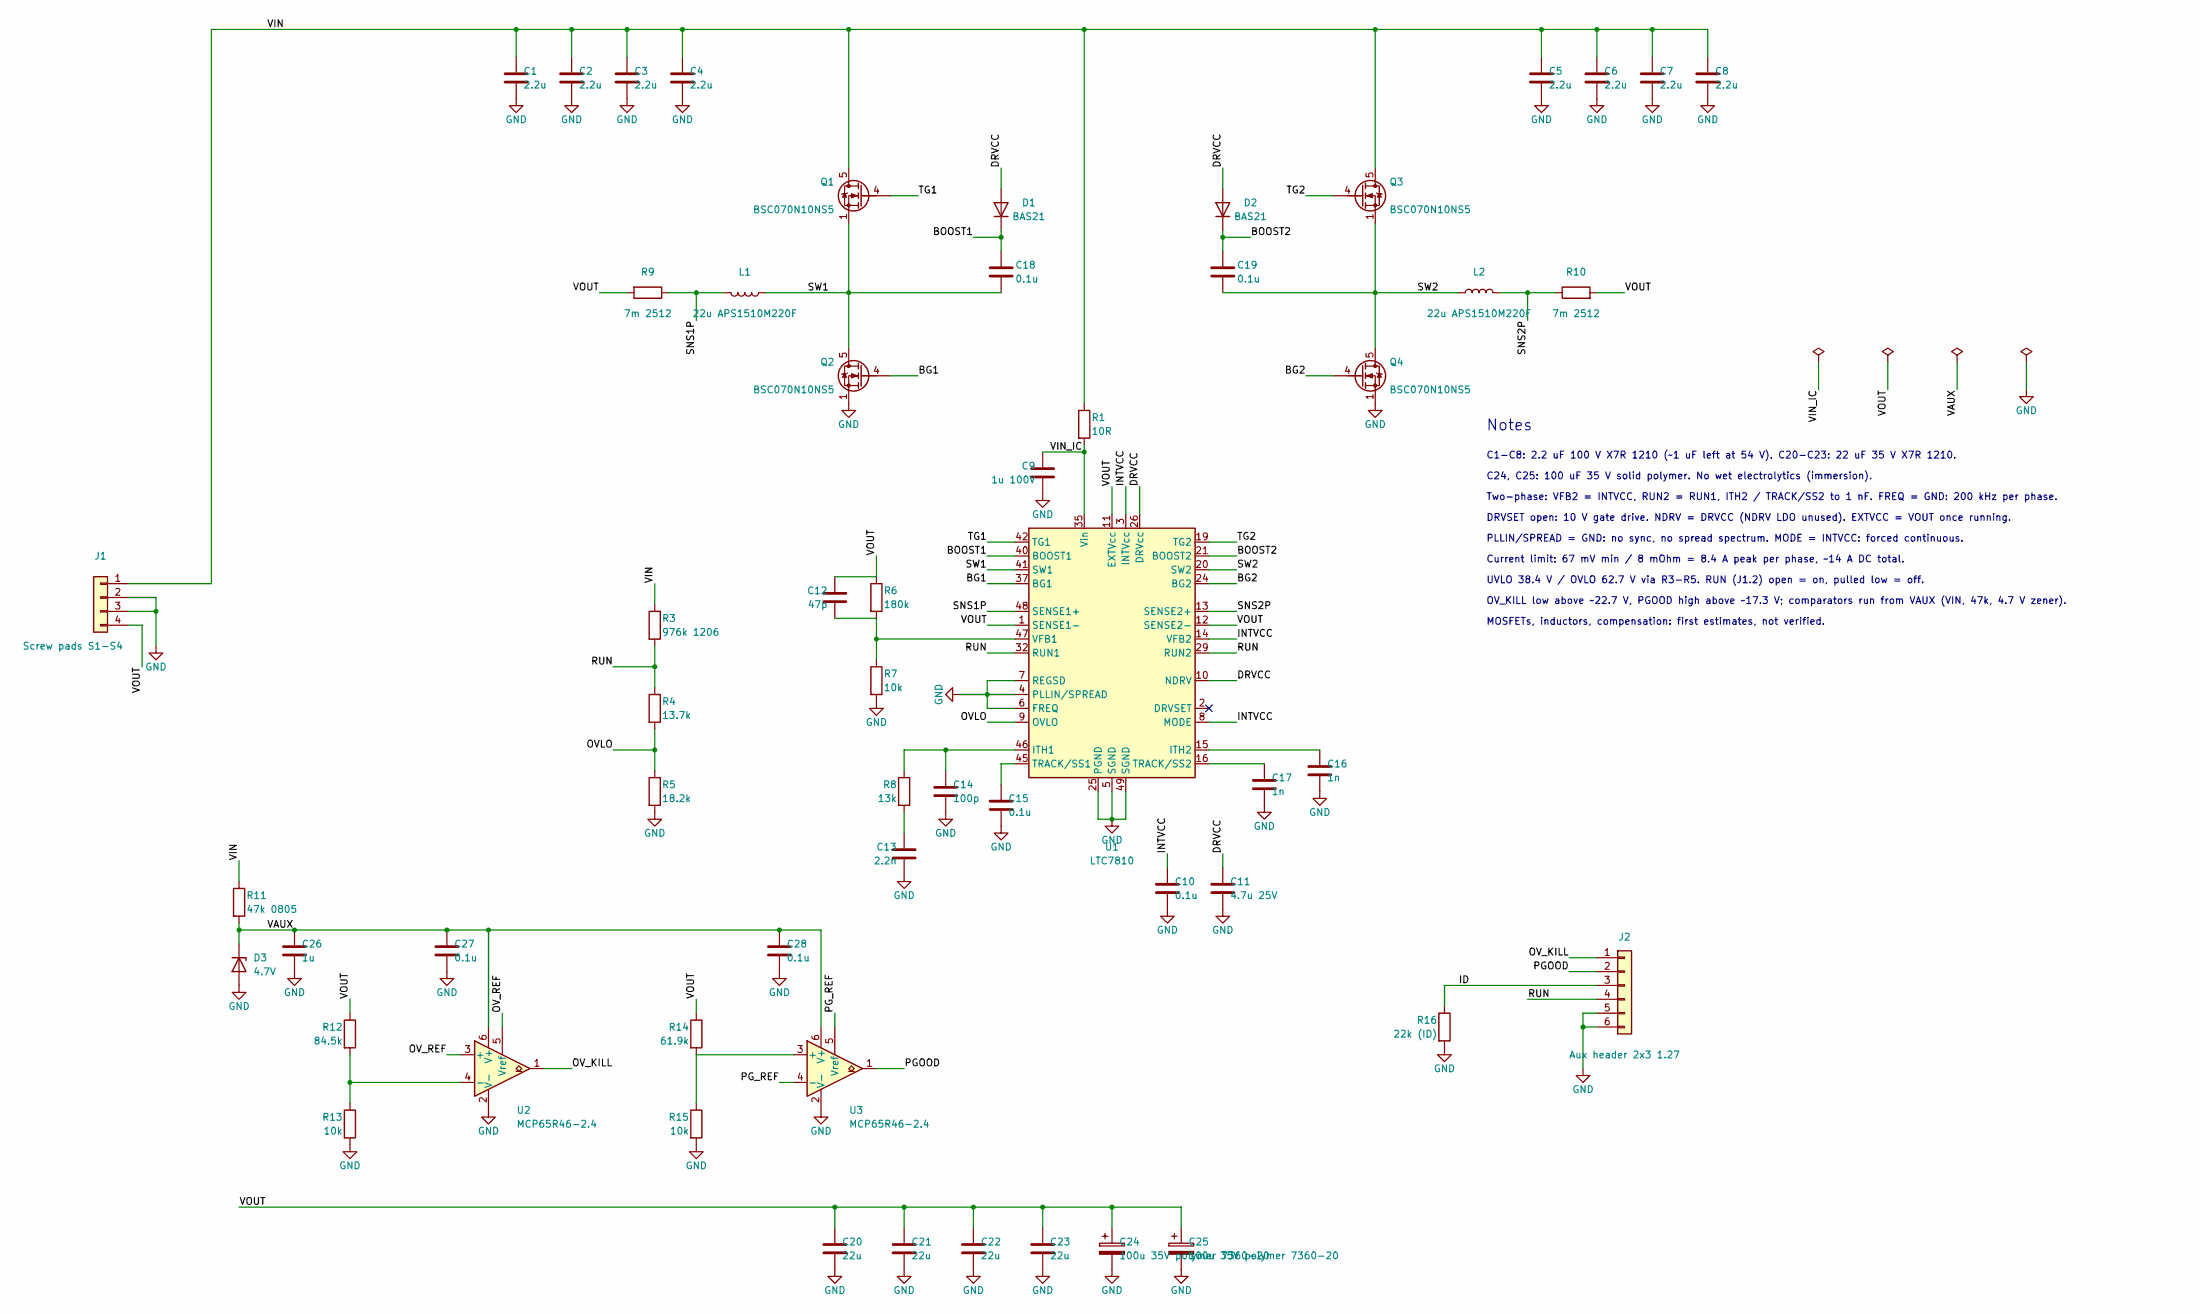
[picture p24: schematic pm-19v-250w.kicad_sch, PM-19V-250W: 48-60 V in, 19 V 13.2 A out (concept)]

Parts:
C1, C2, C3, C4, C5, C6, C7, C8: 2.2u; C_1210_3225Metric; LCSC C5449052
C9: 1u 100V; C_0805_2012Metric; LCSC C5370002
C10, C15, C18, C19, C27, C28: 0.1u; C_0402_1005Metric; LCSC C307331
C11: 4.7u 25V; C_0805_2012Metric; LCSC C354262
C12: 47p; C_0402_1005Metric; LCSC C1567
C13: 2.2n; C_0402_1005Metric; LCSC C2980802
C14: 100p; C_0402_1005Metric; LCSC C1546
C16, C17: 1n; C_0402_1005Metric; LCSC C1523
C20, C21, C22, C23: 22u; C_1210_3225Metric; LCSC C778721
C24, C25: 100u 35V polymer 7360-20; CP_EIA-7360-38_Kemet-E; LCSC C2158991
C26: 1u; C_0402_1005Metric; LCSC C52923
D1, D2: BAS21; D_SOD-323; LCSC C82466
D3: 4.7V; D_SOD-323; LCSC C107713
J1: Screw pads S1-S4; PM_Mount_M2
J2: Aux header 2x3 1.27; PM_Aux_Header_2x03_P1.27; LCSC C41376035
L1, L2: 22u APS1510M220F; L_Coilcraft_XAL1510-223; LCSC C49261404
Q1, Q2, Q3, Q4: BSC070N10NS5; TDSON-8-1; LCSC C534364
R1: 10R; R_0603_1608Metric; LCSC C22859
R3: 976k 1206; R_1206_3216Metric; LCSC C247164
R4: 13.7k; R_0603_1608Metric; LCSC C22793
R5: 18.2k; R_0402_1005Metric; LCSC C25859
R6: 180k; R_0402_1005Metric; LCSC C25760
R7, R13, R15: 10k; R_0402_1005Metric; LCSC C25744
R8: 13k; R_0402_1005Metric; LCSC C25754
R9, R10: 7m 2512; R_2512_6332Metric; LCSC C20608751
R11: 47k 0805; R_0805_2012Metric; LCSC C17713
R12: 84.5k; R_0402_1005Metric; LCSC C185390
R14: 61.9k; R_0402_1005Metric; LCSC C2933106
R16: 22k (ID); R_0603_1608Metric; LCSC C31850
U1: LTC7810; LQFP-48-1EP_7x7mm_P0.5mm_EP3.6x3.6mm; LCSC C581067
U2, U3: MCP65R46-2.4; SOT-23-6; LCSC C623510

Connections:
/BG1: Q2.4 (G), U1.37 (BG1)
/BG2: Q4.4 (G), U1.24 (BG2)
/BOOST1: C18.1, D1.1 (K), U1.40 (BOOST1)
/BOOST2: C19.1, D2.1 (K), U1.21 (BOOST2)
/DRVCC: C11.1, D1.2 (A), D2.2 (A), U1.10 (NDRV), U1.26 (DRVcc)
/ID: J2.3, R16.1
/INTVCC: C10.1, U1.3 (INTVcc), U1.8 (MODE), U1.14 (VFB2)
/OVLO: R4.2, R5.1, U1.9 (OVLO)
/OV_KILL: J2.1, U2.1
/OV_REF: U2.3 (+), U2.5 (Vref)
/PGOOD: J2.2, U3.1
/PG_REF: U3.4 (-), U3.5 (Vref)
/RUN: J2.4, R3.2, R4.1, U1.29 (RUN2), U1.32 (RUN1)
/SNS1P: L1.2, R9.1, U1.48 (SENSE1+)
/SNS2P: L2.2, R10.1, U1.13 (SENSE2+)
/SW1: C18.2, L1.1, Q1.1 (S), Q1.2 (S), Q1.3 (S), Q2.5 (D), U1.41 (SW1)
/SW2: C19.2, L2.1, Q3.1 (S), Q3.2 (S), Q3.3 (S), Q4.5 (D), U1.20 (SW2)
/TG1: Q1.4 (G), U1.42 (TG1)
/TG2: Q3.4 (G), U1.19 (TG2)
/VAUX: C26.1, C27.1, C28.1, D3.1 (K), R11.2, U2.6 (V+), U3.6 (V+)
/VIN: C1.1, C2.1, C3.1, C4.1, C5.1, C6.1, C7.1, C8.1, J1.1, Q1.5 (D), Q3.5 (D), R1.1, R3.1, R11.1
/VIN_IC: C9.1, R1.2, U1.35 (Vin)
/VOUT: C12.1, C20.1, C21.1, C22.1, C23.1, C24.1, C25.1, J1.4, R6.1, R9.2, R10.2, R12.1, R14.1, U1.1 (SENSE1-), U1.11 (EXTVcc), U1.12 (SENSE2-)
GND: C1.2, C2.2, C3.2, C4.2, C5.2, C6.2, C7.2, C8.2, C9.2, C10.2, C11.2, C13.2, C14.2, C15.2, C16.2, C17.2, C20.2, C21.2, C22.2, C23.2, C24.2, C25.2, C26.2, C27.2, C28.2, D3.2 (A), J1.2, J1.3, J2.5, J2.6, Q2.1 (S), Q2.2 (S), Q2.3 (S), Q4.1 (S), Q4.2 (S), Q4.3 (S), R5.2, R7.2, R13.2, R15.2, R16.2, U1.4 (PLLIN/SPREAD), U1.5 (SGND), U1.6 (FREQ), U1.7 (REGSD), U1.25 (PGND), U1.49 (SGND), U2.2 (V-), U3.2 (V-)
unnamed: C13.1, R8.2
unnamed: C14.1, R8.1, U1.46 (ITH1)
unnamed: C16.1, U1.15 (ITH2)
unnamed: C15.1, U1.45 (TRACK/SS1)
unnamed: C17.1, U1.16 (TRACK/SS2)
unnamed: C12.2, R6.2, R7.1, U1.47 (VFB1)
unnamed: R12.2, R13.1, U2.4 (-)
unnamed: R14.2, R15.1, U3.3 (+)

Notes on the sheet:
Notes
C1-C8: 2.2 uF 100 V X7R 1210 (~1 uF left at 54 V). C20-C23: 22 uF 35 V X7R 1210.
C24, C25: 100 uF 35 V solid polymer. No wet electrolytics (immersion).
Two-phase: VFB2 = INTVCC, RUN2 = RUN1, ITH2 / TRACK/SS2 to 1 nF. FREQ = GND: 200 kHz per phase.
DRVSET open: 10 V gate drive. NDRV = DRVCC (NDRV LDO unused). EXTVCC = VOUT once running.
PLLIN/SPREAD = GND: no sync, no spread spectrum. MODE = INTVCC: forced continuous.
Current limit: 67 mV min / 8 mOhm = 8.4 A peak per phase, ~14 A DC total.
UVLO 38.4 V / OVLO 62.7 V via R3-R5. RUN (J1.2) open = on, pulled low = off.
OV_KILL low above ~22.7 V, PGOOD high above ~17.3 V; comparators run from VAUX (VIN, 47k, 4.7 V zener).
MOSFETs, inductors, compensation: first estimates, not verified.

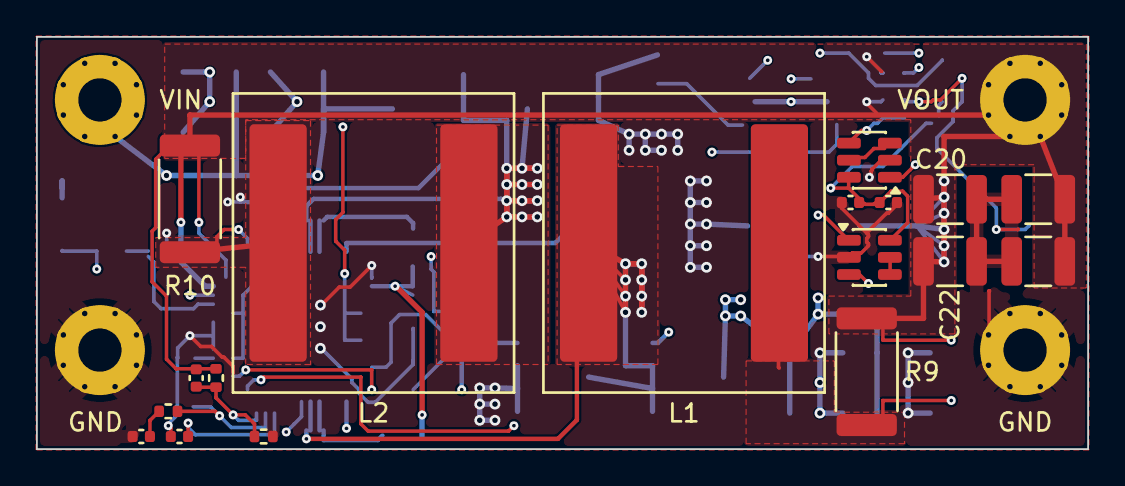
[picture p25: board pm-19v-250w.kicad_pcb from above]

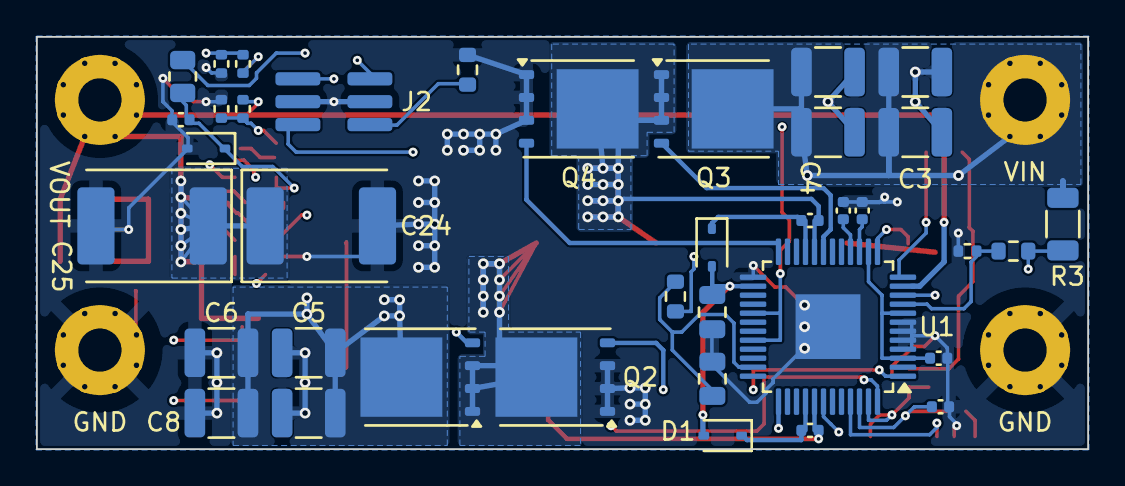
[picture p26: board pm-19v-250w.kicad_pcb from below]

Board: 4 copper layers, 58.4 x 22.9 mm, 57 parts (38 on the bottom side), 32 nets.
