delandtj/granite_controller/power/pm-19v-250w-b/pm-19v-250w-b.kicad_pcb

## KiCad design power/pm-19v-250w-b/pm-19v-250w-b.kicad_pcb (2026-10-31)

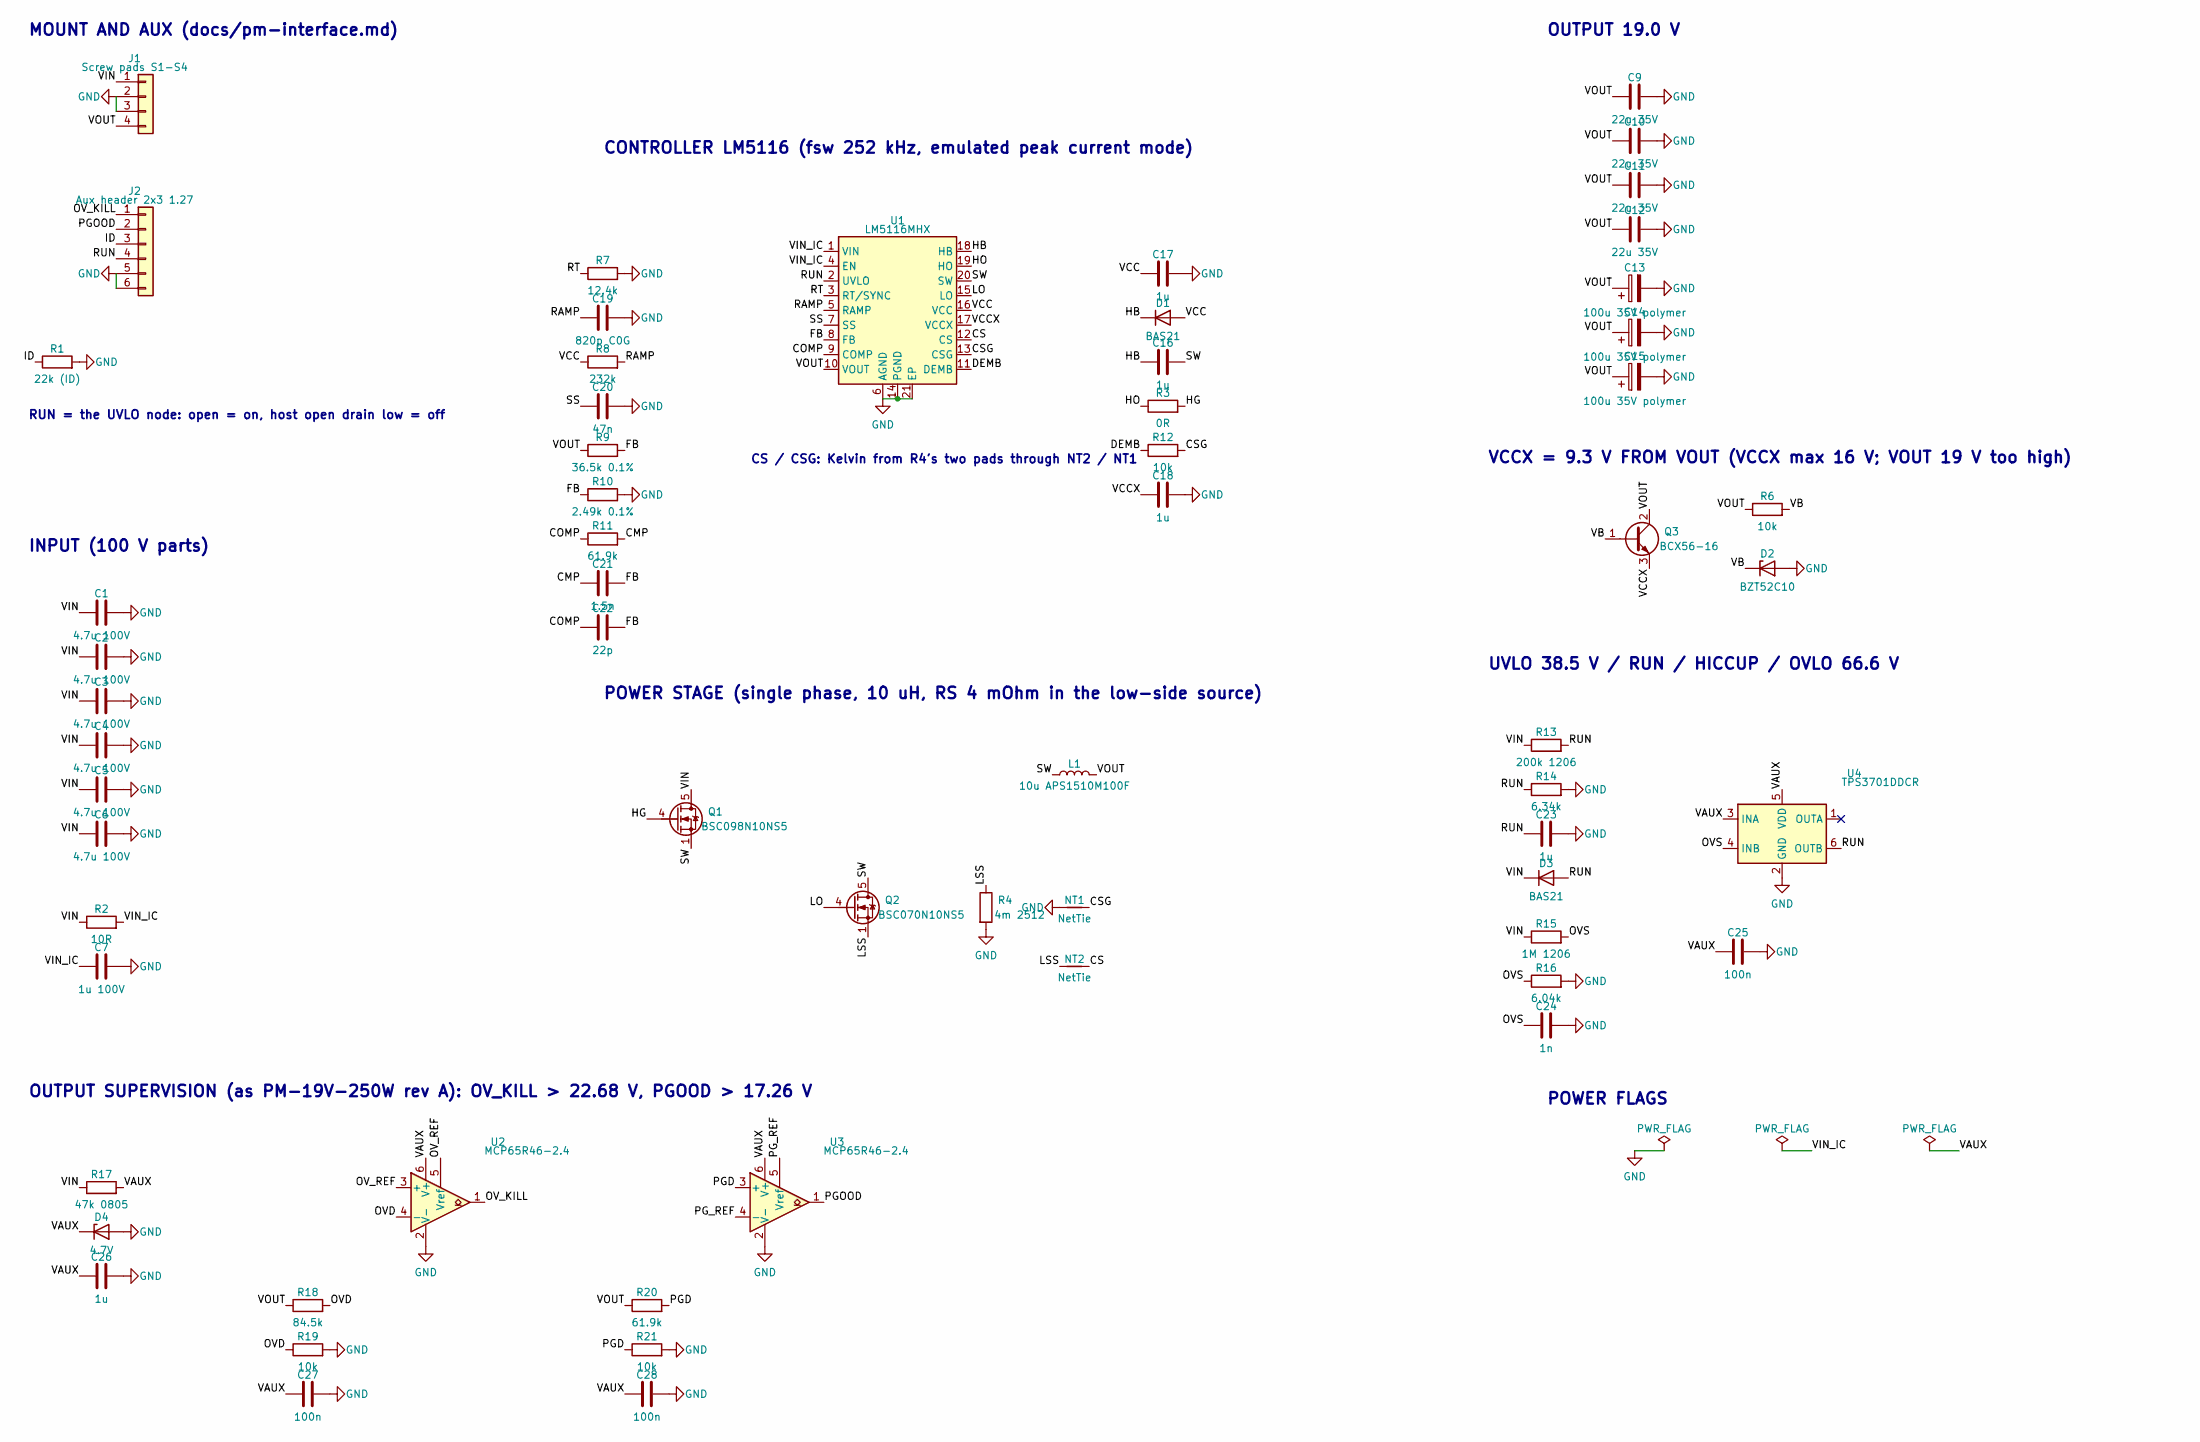
[picture p27: schematic pm-19v-250w-b.kicad_sch, PM-19V-250W-B port module]

Parts:
C1, C2, C3, C4, C5, C6: 4.7u 100V; C_1210_3225Metric; LCSC C381466
C7: 1u 100V; C_0805_2012Metric; LCSC C5370002
C9, C10, C11, C12: 22u 35V; C_1210_3225Metric; LCSC C778721
C13, C14, C15: 100u 35V polymer; CP_Elec_6.3x7.7; LCSC C46550467
C16, C17, C18, C23, C26: 1u; C_0402_1005Metric; LCSC C52923
C19: 820p C0G; C_0402_1005Metric; LCSC C161159
C20: 47n; C_0402_1005Metric; LCSC C272875
C21: 1.5n; C_0402_1005Metric; LCSC C107022
C22: 22p; C_0402_1005Metric; LCSC C1555
C24: 1n; C_0402_1005Metric; LCSC C1523
C25, C27, C28: 100n; C_0402_1005Metric; LCSC C307331
D1, D3: BAS21; D_SOD-323; LCSC C82466
D2: BZT52C10; D_SOD-123; LCSC C2103
D4: 4.7V; D_SOD-323; LCSC C107713
J1: Screw pads S1-S4; PM_Mount_M2
J2: Aux header 2x3 1.27; PM_Aux_Header_2x03_P1.27; LCSC C41376035
L1: 10u APS1510M100F; L_Coilcraft_XAL1510-103; LCSC C49261402
NT1, NT2: NetTie; NetTie-2_SMD_Pad0.5mm
Q1: BSC098N10NS5; TDSON-8-1; LCSC C534398
Q2: BSC070N10NS5; TDSON-8-1; LCSC C534364
Q3: BCX56-16; SOT-89-3; LCSC C123402
R1: 22k (ID); R_0603_1608Metric; LCSC C31850
R2: 10R; R_0603_1608Metric; LCSC C22859
R3: 0R; R_0402_1005Metric; LCSC C17168
R4: 4m 2512; R_2512_6332Metric; LCSC C459681
R6, R12, R19, R21: 10k; R_0402_1005Metric; LCSC C25744
R7: 12.4k; R_0402_1005Metric; LCSC C2929935
R8: 232k; R_0402_1005Metric; LCSC C3013159
R9: 36.5k 0.1%; R_0402_1005Metric; LCSC C852741
R10: 2.49k 0.1%; R_0402_1005Metric; LCSC C852700
R11, R20: 61.9k; R_0402_1005Metric; LCSC C2933106
R13: 200k 1206; R_1206_3216Metric; LCSC C17954
R14: 6.34k; R_0402_1005Metric; LCSC C5713274
R15: 1M 1206; R_1206_3216Metric; LCSC C17927
R16: 6.04k; R_0402_1005Metric; LCSC C2998182
R17: 47k 0805; R_0805_2012Metric; LCSC C17713
R18: 84.5k; R_0402_1005Metric; LCSC C185390
U1: LM5116MHX; HTSSOP-20-1EP_4.4x6.5mm_P0.65mm_EP3.4x6.5mm_ThermalVias; LCSC C13755
U2, U3: MCP65R46-2.4; SOT-23-6; LCSC C623510
U4: TPS3701DDCR; SOT-23-6; LCSC C132788

Connections:
/CMP: C21.1, R11.2
/COMP: C22.1, R11.1, U1.9 (COMP)
/CS: NT2.2, U1.12 (CS)
/CSG: NT1.2, R12.2, U1.13 (CSG)
/DEMB: R12.1, U1.11 (DEMB)
/FB: C21.2, C22.2, R9.2, R10.1, U1.8 (FB)
/HB: C16.1, D1.1 (K), U1.18 (HB)
/HG: Q1.4 (G), R3.2
/HO: R3.1, U1.19 (HO)
/ID: J2.3, R1.1
/LO: Q2.4 (G), U1.15 (LO)
/LSS: NT2.1, Q2.1 (S), Q2.2 (S), Q2.3 (S), R4.1
/OVD: R18.2, R19.1, U2.4 (-)
/OVS: C24.1, R15.2, R16.1, U4.4 (INB)
/OV_KILL: J2.1, U2.1
/OV_REF: U2.3 (+), U2.5 (Vref)
/PGD: R20.2, R21.1, U3.3 (+)
/PGOOD: J2.2, U3.1
/PG_REF: U3.4 (-), U3.5 (Vref)
/RAMP: C19.1, R8.2, U1.5 (RAMP)
/RT: R7.1, U1.3 (RT/SYNC)
/RUN: C23.1, D3.2 (A), J2.4, R13.2, R14.1, U1.2 (UVLO), U4.6 (OUTB)
/SS: C20.1, U1.7 (SS)
/SW: C16.2, L1.1, Q1.1 (S), Q1.2 (S), Q1.3 (S), Q2.5 (D), U1.20 (SW)
/VAUX: C25.1, C26.1, C27.1, C28.1, D4.1 (K), R17.2, U2.6 (V+), U3.6 (V+), U4.3 (INA), U4.5 (VDD)
/VB: D2.1 (K), Q3.1 (B), R6.2
/VCC: C17.1, D1.2 (A), R8.1, U1.16 (VCC)
/VCCX: C18.1, Q3.3 (E), U1.17 (VCCX)
/VIN: C1.1, C2.1, C3.1, C4.1, C5.1, C6.1, D3.1 (K), J1.1, Q1.5 (D), R2.1, R13.1, R15.1, R17.1
/VIN_IC: C7.1, R2.2, U1.1 (VIN), U1.4 (EN)
/VOUT: C9.1, C10.1, C11.1, C12.1, C13.1, C14.1, C15.1, J1.4, L1.2, Q3.2 (C), R6.1, R9.1, R18.1, R20.1, U1.10 (VOUT)
GND: C1.2, C2.2, C3.2, C4.2, C5.2, C6.2, C7.2, C9.2, C10.2, C11.2, C12.2, C13.2, C14.2, C15.2, C17.2, C18.2, C19.2, C20.2, C23.2, C24.2, C25.2, C26.2, C27.2, C28.2, D2.2 (A), D4.2 (A), J1.2, J1.3, J2.5, J2.6, NT1.1, R1.2, R4.2, R7.2, R10.2, R14.2, R16.2, R19.2, R21.2, U1.6 (AGND), U1.14 (PGND), U1.21 (EP), U2.2 (V-), U3.2 (V-), U4.2 (GND)

Notes on the sheet:
MOUNT AND AUX (docs/pm-interface.md)
RUN = the UVLO node: open = on, host open drain low = off
INPUT (100 V parts)
CONTROLLER LM5116 (fsw 252 kHz, emulated peak current mode)
CS / CSG: Kelvin from R4's two pads through NT2 / NT1
POWER STAGE (single phase, 10 uH, RS 4 mOhm in the low-side source)
OUTPUT 19.0 V
VCCX = 9.3 V FROM VOUT (VCCX max 16 V; VOUT 19 V too high)
UVLO 38.5 V / RUN / HICCUP / OVLO 66.6 V
OUTPUT SUPERVISION (as PM-19V-250W rev A): OV_KILL > 22.68 V, PGOOD > 17.26 V
POWER FLAGS

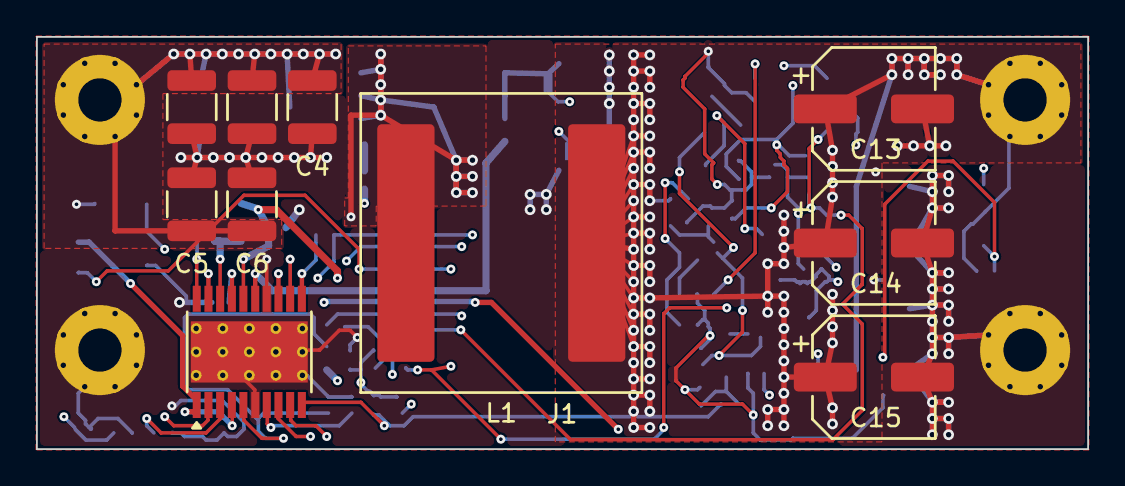
[picture p28: board pm-19v-250w-b.kicad_pcb from above]

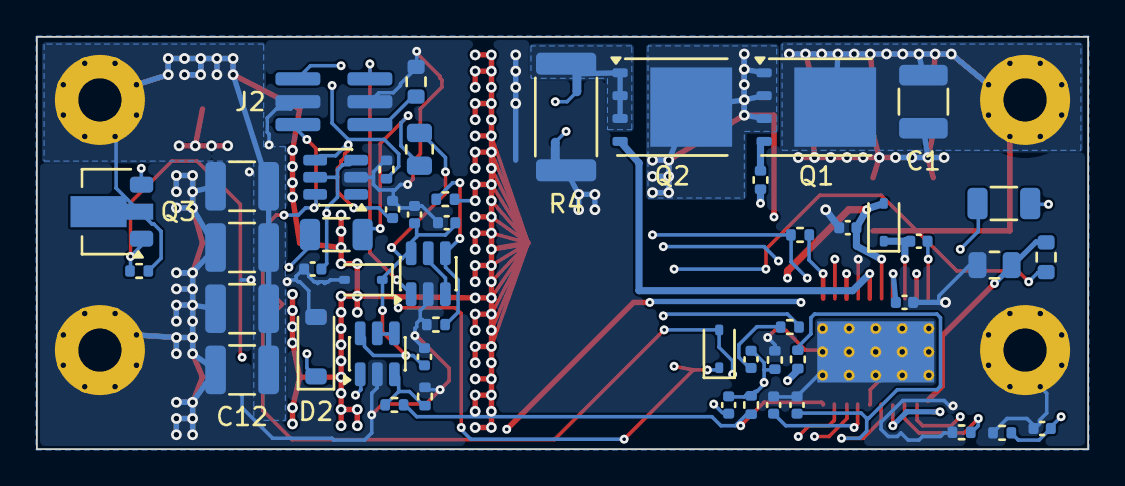
[picture p29: board pm-19v-250w-b.kicad_pcb from below]

Board: 4 copper layers, 58.4 x 22.9 mm, 63 parts (52 on the bottom side), 32 nets.
