delandtj/granite_controller/power/pm-bench-carrier/pm-bench-carrier.kicad_pcb

## KiCad design power/pm-bench-carrier/pm-bench-carrier.kicad_pcb (2026-10-30)

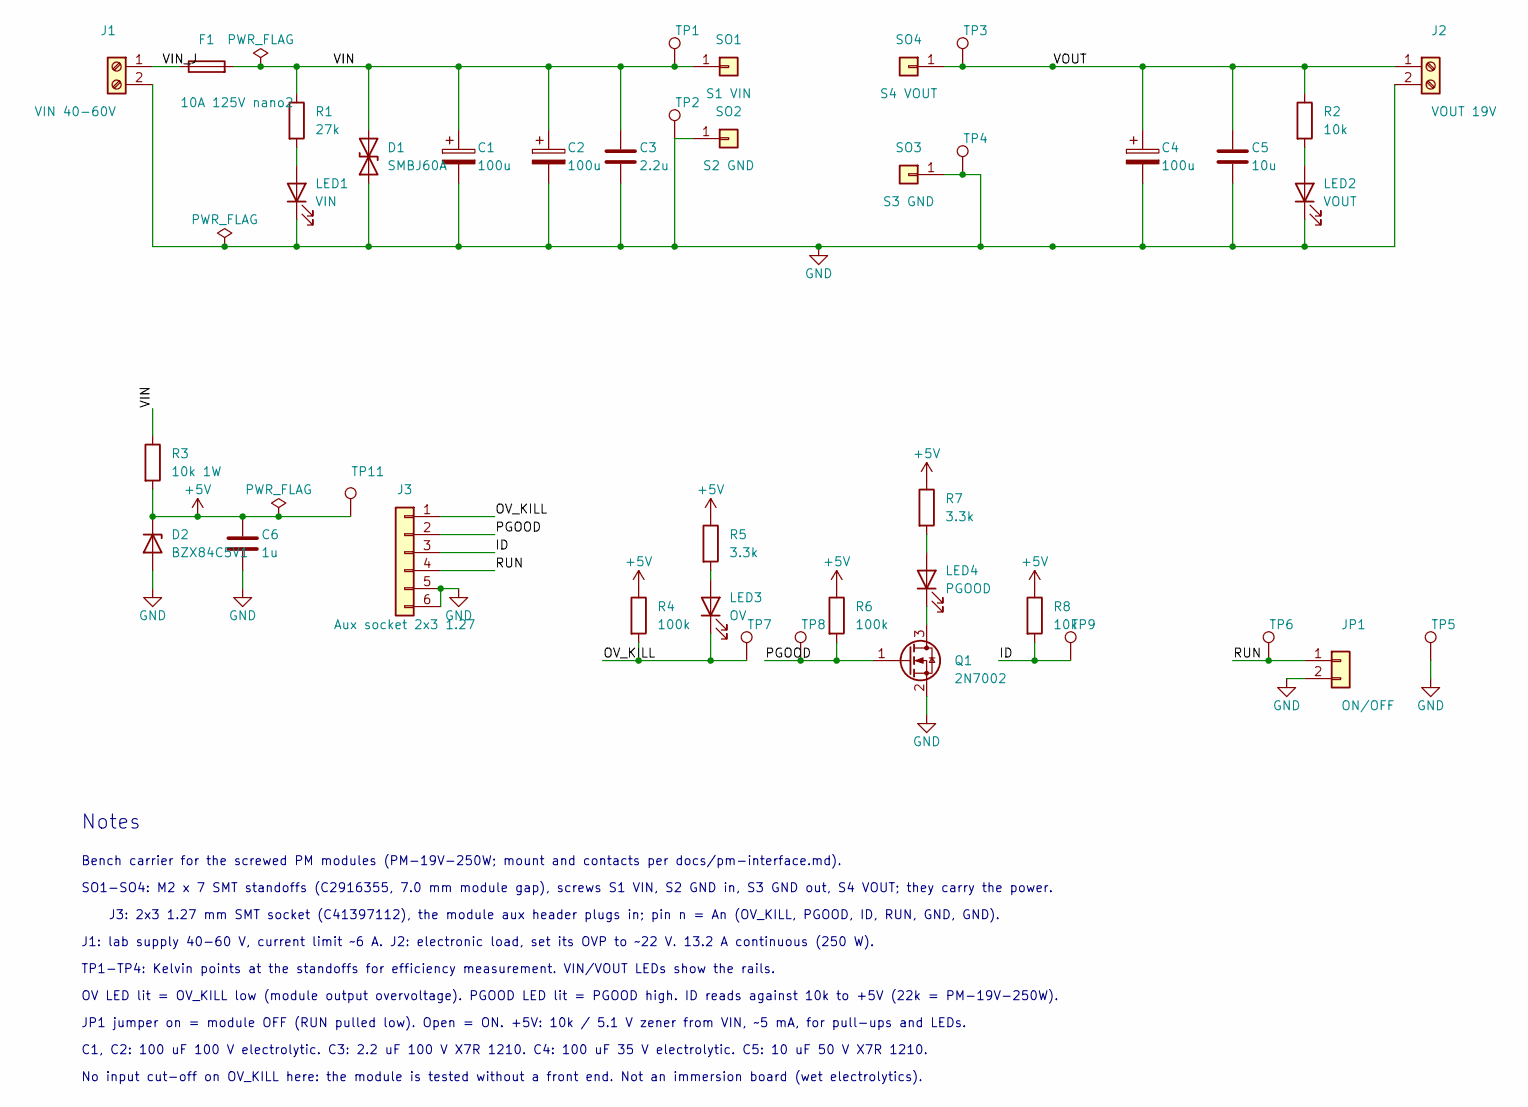
[picture p30: schematic pm-bench-carrier.kicad_sch, PM module bench carrier]

Parts:
C1, C2: 100u; CP_Radial_D10.0mm_P5.00mm
C3: 2.2u; C_1210_3225Metric; LCSC C55151
C4: 100u; CP_Radial_D8.0mm_P3.50mm
C5: 10u; C_1210_3225Metric; LCSC C2918502
C6: 1u; C_0603_1608Metric; LCSC C15849
D1: SMBJ60A; D_SMB; LCSC C353345
D2: BZX84C5V1; SOT-23; LCSC C27131
F1: 10A 125V nano2; Fuse_Littelfuse-NANO2-451_453; LCSC C44479
J1: VIN 40-60V; TerminalBlock_Phoenix_MKDS-3-2-5.08_1x02_P5.08mm_Horizontal
J2: VOUT 19V; TerminalBlock_Phoenix_MKDS-3-2-5.08_1x02_P5.08mm_Horizontal
J3: Aux socket 2x3 1.27; PM_Aux_Socket_2x03_P1.27; LCSC C41397112
JP1: ON/OFF; PinHeader_1x02_P2.54mm_Vertical
LED1: VIN; LED_0805_2012Metric; LCSC C2297
LED2: VOUT; LED_0805_2012Metric; LCSC C2297
LED3: OV; LED_0805_2012Metric; LCSC C84256
LED4: PGOOD; LED_0805_2012Metric; LCSC C2297
Q1: 2N7002; SOT-23; LCSC C8545
R1: 27k; R_1206_3216Metric; LCSC C17943
R2: 10k; R_0805_2012Metric; LCSC C17414
R3: 10k 1W; R_2512_6332Metric; LCSC C270956
R4, R6: 100k; R_0603_1608Metric; LCSC C25803
R5, R7: 3.3k; R_0603_1608Metric; LCSC C22978
R8: 10k; R_0603_1608Metric; LCSC C25804
SO1: S1 VIN; PM_Standoff_M2x7_SMTSO; LCSC C2916355
SO2: S2 GND; PM_Standoff_M2x7_SMTSO; LCSC C2916355
SO3: S3 GND; PM_Standoff_M2x7_SMTSO; LCSC C2916355
SO4: S4 VOUT; PM_Standoff_M2x7_SMTSO; LCSC C2916355
TP1: VIN_K; TestPoint_Loop_D2.50mm_Drill1.0mm
TP2: GNDIN_K; TestPoint_Loop_D2.50mm_Drill1.0mm
TP3: VOUT_K; TestPoint_Loop_D2.50mm_Drill1.0mm
TP4: GNDOUT_K; TestPoint_Loop_D2.50mm_Drill1.0mm
TP5: GND; TestPoint_Loop_D2.50mm_Drill1.0mm
TP6: RUN; TestPoint_Loop_D2.50mm_Drill1.0mm
TP7: OV_KILL; TestPoint_Loop_D2.50mm_Drill1.0mm
TP8: PGOOD; TestPoint_Loop_D2.50mm_Drill1.0mm
TP9: ID; TestPoint_Loop_D2.50mm_Drill1.0mm
TP11: +5V; TestPoint_Loop_D2.50mm_Drill1.0mm

Connections:
+5V: C6.1, D2.1 (K), R3.2, R4.1, R5.1, R6.1, R7.1, R8.1, TP11.1
/ID: J3.3, R8.2, TP9.1
/OV_KILL: J3.1, LED3.1 (K), R4.2, TP7.1
/PGOOD: J3.2, Q1.1 (G), R6.2, TP8.1
/RUN: J3.4, JP1.1, TP6.1
/VIN: C1.1, C2.1, C3.1, D1.2 (A2), F1.2, R1.1, R3.1, SO1.1, TP1.1
/VIN_J: F1.1, J1.1
/VOUT: C4.1, C5.1, J2.1, R2.1, SO4.1, TP3.1
GND: C1.2, C2.2, C3.2, C4.2, C5.2, C6.2, D1.1 (A1), D2.2 (A), J1.2, J2.2, J3.5, J3.6, JP1.2, LED1.1 (K), LED2.1 (K), Q1.2 (S), SO2.1, SO3.1, TP2.1, TP4.1, TP5.1
unnamed: LED1.2 (A), R1.2
unnamed: LED2.2 (A), R2.2
unnamed: LED3.2 (A), R5.2
unnamed: LED4.2 (A), R7.2
unnamed: LED4.1 (K), Q1.3 (D)

Notes on the sheet:
Notes
Bench carrier for the screwed PM modules (PM-19V-250W; mount and contacts per docs/pm-interface.md).
SO1-SO4: M2 x 7 SMT standoffs (C2916355, 7.0 mm module gap), screws S1 VIN, S2 GND in, S3 GND out, S4 VOUT; they carry the power.
J3: 2x3 1.27 mm SMT socket (C41397112), the module aux header plugs in; pin n = An (OV_KILL, PGOOD, ID, RUN, GND, GND).
J1: lab supply 40-60 V, current limit ~6 A. J2: electronic load, set its OVP to ~22 V. 13.2 A continuous (250 W).
TP1-TP4: Kelvin points at the standoffs for efficiency measurement. VIN/VOUT LEDs show the rails.
OV LED lit = OV_KILL low (module output overvoltage). PGOOD LED lit = PGOOD high. ID reads against 10k to +5V (22k = PM-19V-250W).
JP1 jumper on = module OFF (RUN pulled low). Open = ON. +5V: 10k / 5.1 V zener from VIN, ~5 mA, for pull-ups and LEDs.
C1, C2: 100 uF 100 V electrolytic. C3: 2.2 uF 100 V X7R 1210. C4: 100 uF 35 V electrolytic. C5: 10 uF 50 V X7R 1210.
No input cut-off on OV_KILL here: the module is tested without a front end. Not an immersion board (wet electrolytics).

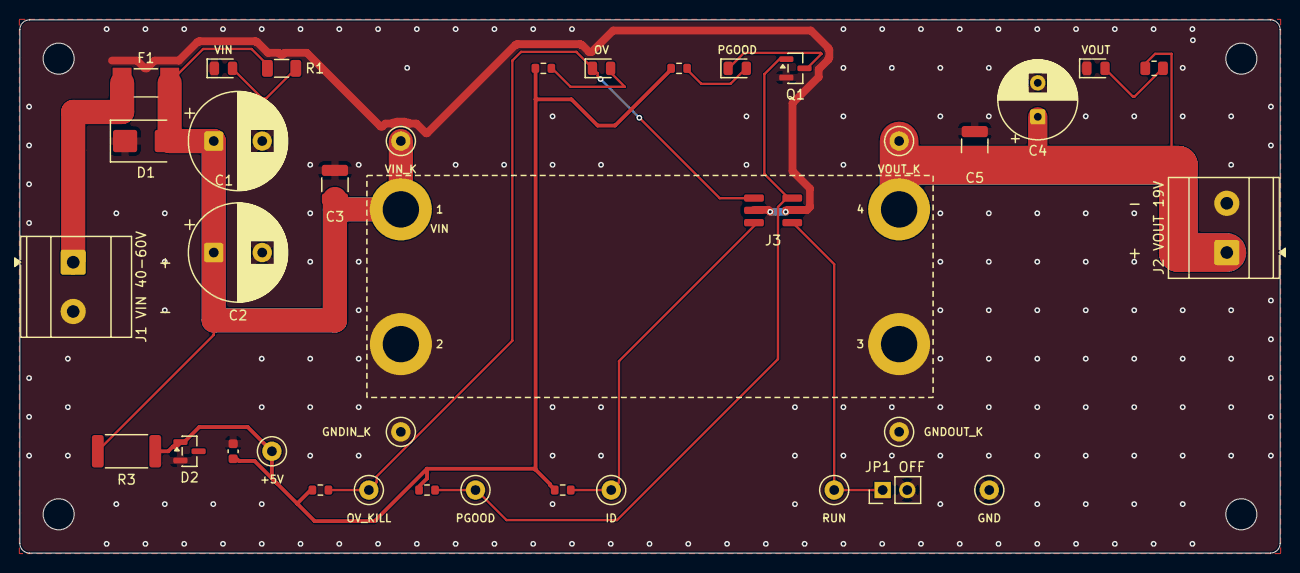
[picture p31: board pm-bench-carrier.kicad_pcb from above]

Board: 2 copper layers, 130.0 x 55.0 mm, 45 parts (0 on the bottom side), 14 nets.

Other parts of the board:
H1, H2, H3, H4: MountingHole_3.2mm_M3
MOD1: PM_Module_Outline
