delandtj/granite_controller/attic/power/pp-48-rev1/pp-48.kicad_pcb

## KiCad design attic/power/pp-48-rev1/pp-48.kicad_pcb (2026-10-30)

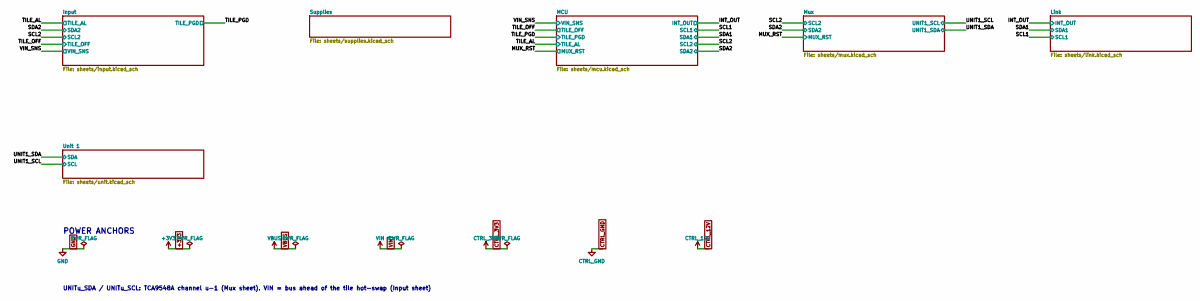
[picture p32: schematic pp-48.kicad_sch, PP-48-2C power plane]

Notes on the sheet:
POWER ANCHORS
UNITu_SDA / UNITu_SCL: TCA9548A channel u-1 (Mux sheet). VIN = bus ahead of the tile hot-swap (Input sheet)

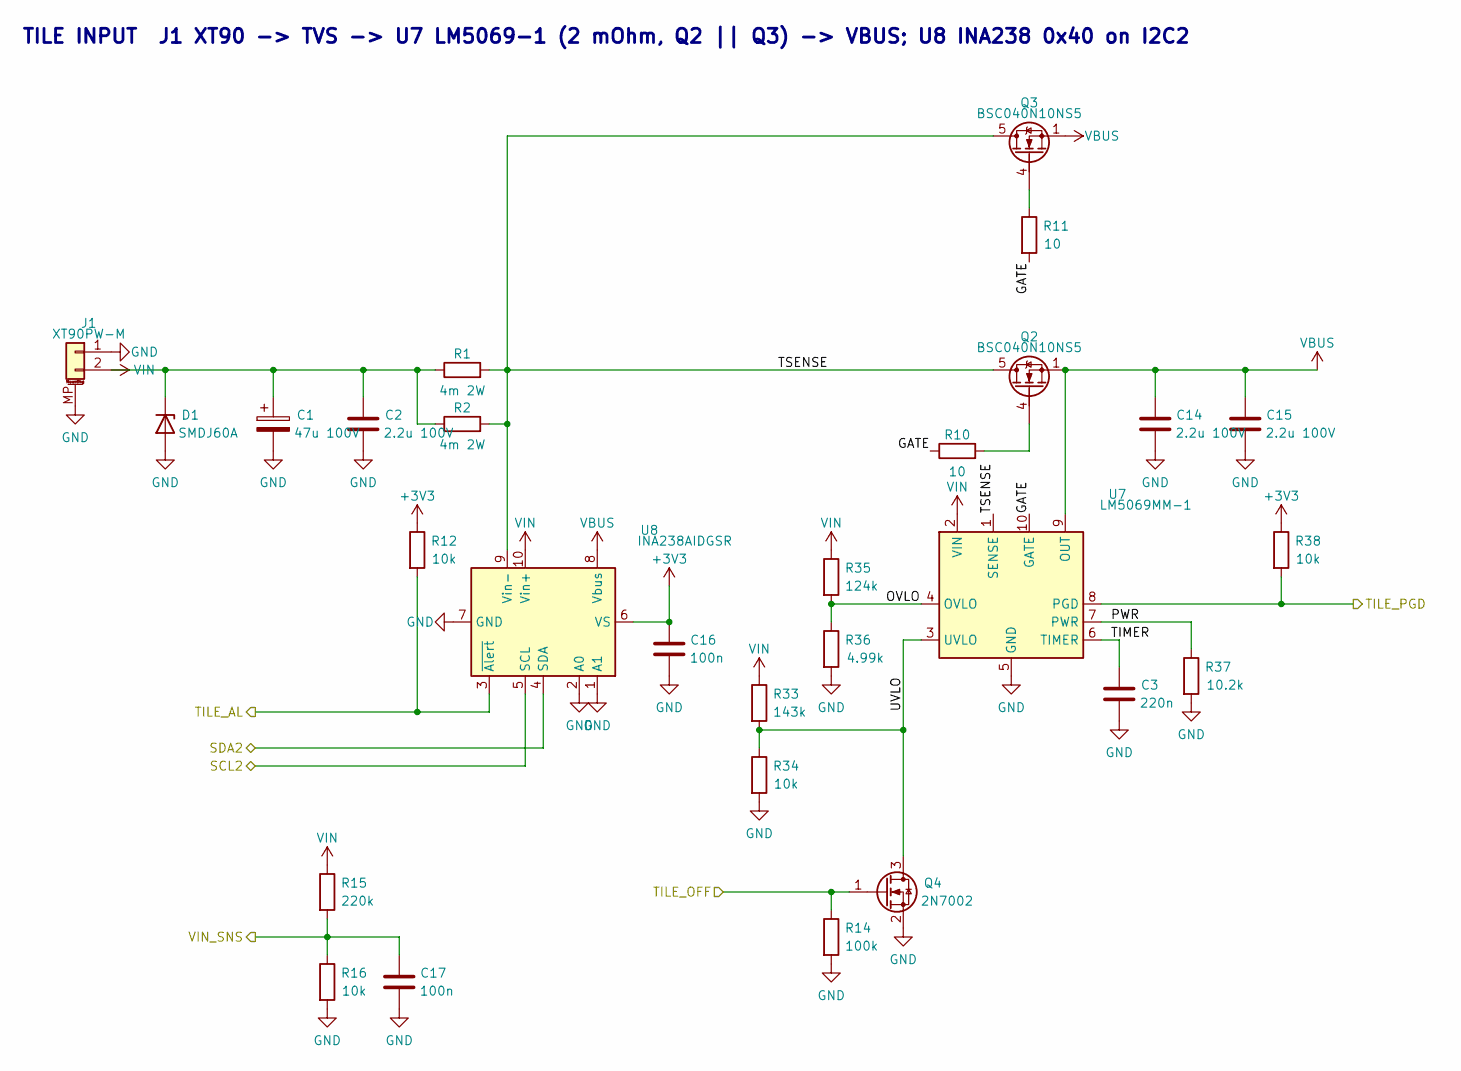
[picture p33: schematic input.kicad_sch]

Parts:
C1: 47u 100V; CP_Elec_10x10
C2, C14, C15: 2.2u 100V; C_1210_3225Metric; LCSC C338133
C3: 220n; C_0603_1608Metric
C16, C17: 100n; C_0402_1005Metric; LCSC C1525
D1: SMDJ60A; D_SMC
J1: XT90PW-M; AMASS_XT90PW-M_1x02_P10.90mm_Horizontal; MPN Amass XT90PW-M
Q2, Q3: BSC040N10NS5; TDSON-8-1; LCSC C534334
Q4: 2N7002; SOT-23; LCSC C8545
R1, R2: 4m 2W; R_2512_6332Metric
R10, R11: 10; R_0402_1005Metric
R12, R16, R34, R38: 10k; R_0402_1005Metric; LCSC C25744
R14: 100k; R_0402_1005Metric; LCSC C25741
R15: 220k; R_0805_2012Metric
R33: 143k; R_0805_2012Metric
R35: 124k; R_0805_2012Metric
R36: 4.99k; R_0402_1005Metric
R37: 10.2k; R_0402_1005Metric
U7: LM5069MM-1; MSOP-10_3x3mm_P0.5mm; LCSC C486026
U8: INA238AIDGSR; TSSOP-10_3x3mm_P0.5mm

Connections:
+3V3: C16.1, R12.1, R38.1, U8.6 (VS); also elsewhere on the board
/Input/GATE: R10.1, R11.2, U7.10 (GATE)
/Input/OVLO: R35.2, R36.1, U7.4 (OVLO)
/Input/PWR: R37.1, U7.7 (PWR)
/Input/TIMER: C3.1, U7.6 (TIMER)
/Input/TSENSE: Q2.5 (D), Q3.5 (D), R1.2, R2.2, U7.1 (SENSE), U8.9 (Vin-)
/Input/UVLO: Q4.3 (D), R33.2, R34.1, U7.3 (UVLO)
/SCL2: U8.5 (SCL); also elsewhere on the board
/SDA2: U8.4 (SDA); also elsewhere on the board
/TILE_AL: R12.2, U8.3 (~Alert); also elsewhere on the board
/TILE_OFF: Q4.1 (G), R14.1; also elsewhere on the board
/TILE_PGD: R38.2, U7.8 (PGD); also elsewhere on the board
/VIN_SNS: C17.1, R15.2, R16.1; also elsewhere on the board
GND: C1.2, C2.2, C3.2, C14.2, C15.2, C16.2, C17.2, D1.2 (A), J1.1, J1.MP (MountPin), Q4.2 (S), R14.2, R16.2, R34.2, R36.2, R37.2, U7.5 (GND), U8.1 (A1), U8.2 (A0), U8.7 (GND); also elsewhere on the board
unnamed: Q2.4 (G), R10.2
unnamed: Q3.4 (G), R11.1
VBUS: C14.1, C15.1, Q2.1 (S), Q2.2 (S), Q2.3 (S), Q3.1 (S), Q3.2 (S), Q3.3 (S), U7.9 (OUT), U8.8 (Vbus); also elsewhere on the board
VIN: C1.1, C2.1, D1.1 (K), J1.2, R1.1, R2.1, R15.1, R33.1, R35.1, U7.2 (VIN), U8.10 (Vin+); also elsewhere on the board

Notes on the sheet:
TILE INPUT J1 XT90 -> TVS -> U7 LM5069-1 (2 mOhm, Q2 || Q3) -> VBUS; U8 INA238 0x40 on I2C2

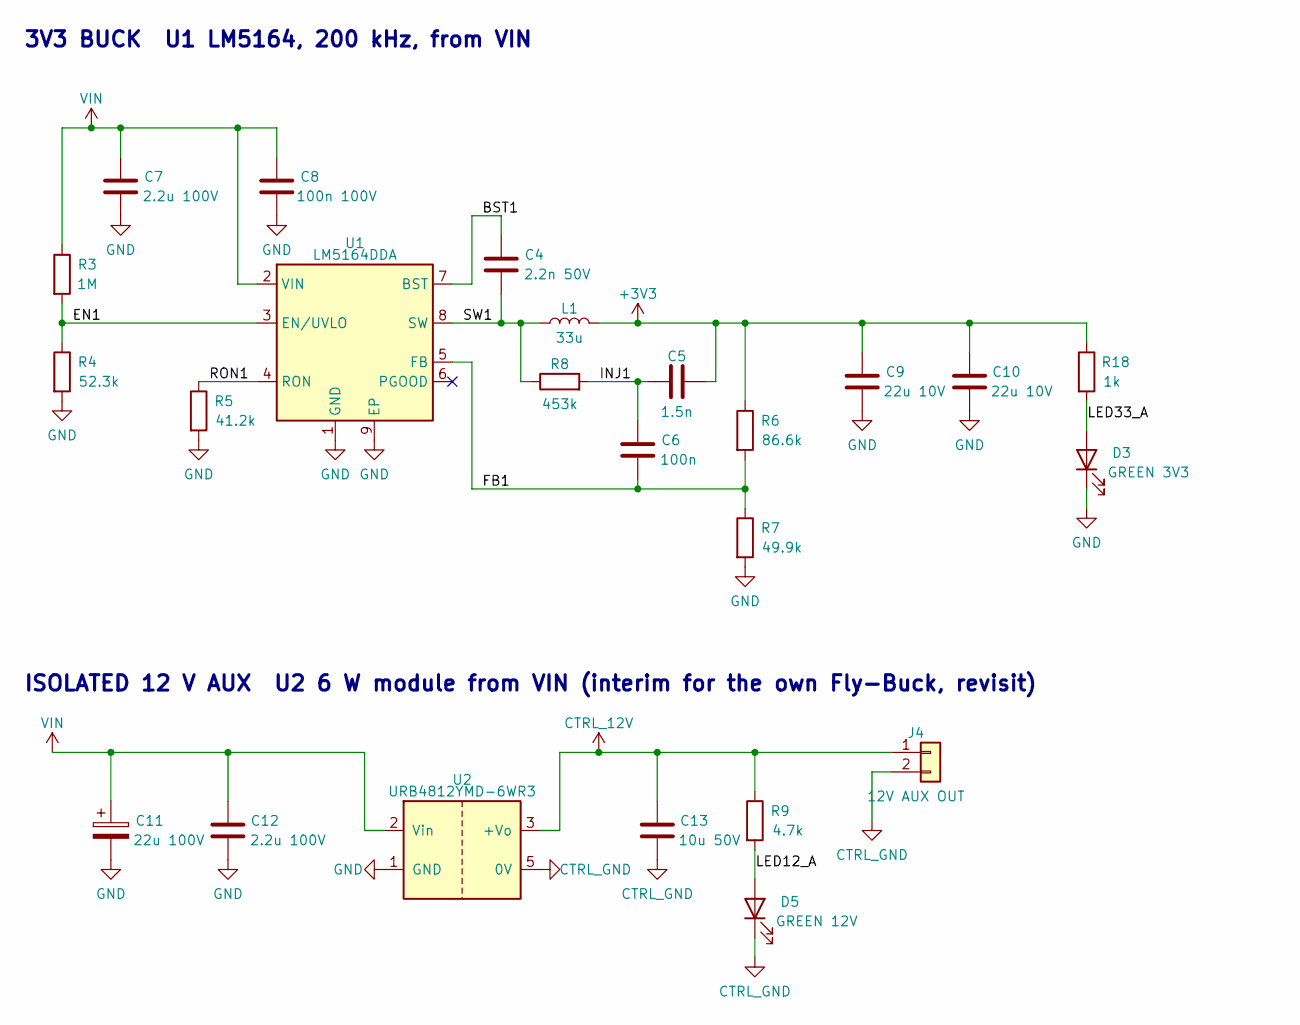
[picture p34: schematic supplies.kicad_sch]

Parts:
C4: 2.2n 50V; C_0402_1005Metric
C5: 1.5n; C_0402_1005Metric
C6: 100n; C_0402_1005Metric; LCSC C1525
C7, C12: 2.2u 100V; C_1210_3225Metric; LCSC C338133
C8: 100n 100V; C_0603_1608Metric
C9, C10: 22u 10V; C_1210_3225Metric
C11: 22u 100V; CP_Elec_10x10
C13: 10u 50V; C_1210_3225Metric
D3: GREEN 3V3; LED_0603_1608Metric; LCSC C2297
D5: GREEN 12V; LED_0603_1608Metric; LCSC C2297
J4: 12V AUX OUT; JST_PH_B2B-PH-K_1x02_P2.00mm_Vertical; LCSC C131337
L1: 33u; L_12x12mm_H6mm; MPN Bourns SRR1260-330M; LCSC C840528
R3: 1M; R_0805_2012Metric
R4: 52.3k; R_0402_1005Metric
R5: 41.2k; R_0402_1005Metric
R6: 86.6k; R_0402_1005Metric
R7: 49.9k; R_0402_1005Metric
R8: 453k; R_0402_1005Metric
R9: 4.7k; R_0603_1608Metric
R18: 1k; R_0402_1005Metric; LCSC C11702
U1: LM5164DDA; HSOP-8-1EP_3.9x4.9mm_P1.27mm_EP2.41x3.1mm; LCSC C477928
U2: URB4812YMD-6WR3; Converter_DCDC_1x1in_THT; MPN URB4812YMD-6WR3 (Mornsun pin-out; LCSC 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; LCSC C5369743

Connections:
+3V3: C5.2, C9.1, C10.1, L1.2, R6.1, R18.1; also elsewhere on the board
/Supplies/BST1: C4.1, U1.7 (BST)
/Supplies/EN1: R3.2, R4.1, U1.3 (EN/UVLO)
/Supplies/FB1: C6.2, R6.2, R7.1, U1.5 (FB)
/Supplies/INJ1: C5.1, C6.1, R8.2
/Supplies/LED12_A: D5.2 (A), R9.2
/Supplies/LED33_A: D3.2 (A), R18.2
/Supplies/RON1: R5.1, U1.4 (RON)
/Supplies/SW1: C4.2, L1.1, R8.1, U1.8 (SW)
CTRL_12V: C13.1, J4.1, R9.1, U2.3 (+Vo)
CTRL_GND: C13.2, D5.1 (K), J4.2, U2.5 (0V); also elsewhere on the board
GND: C7.2, C8.2, C9.2, C10.2, C11.2, C12.2, D3.1 (K), R4.2, R5.2, R7.2, U1.1 (GND), U1.9 (EP), U2.1 (GND); also elsewhere on the board
VIN: C7.1, C8.1, C11.1, C12.1, R3.1, U1.2 (VIN), U2.2 (Vin); also elsewhere on the board

Notes on the sheet:
3V3 BUCK U1 LM5164, 200 kHz, from VIN
ISOLATED 12 V AUX U2 6 W module from VIN (interim for the own Fly-Buck, revisit)

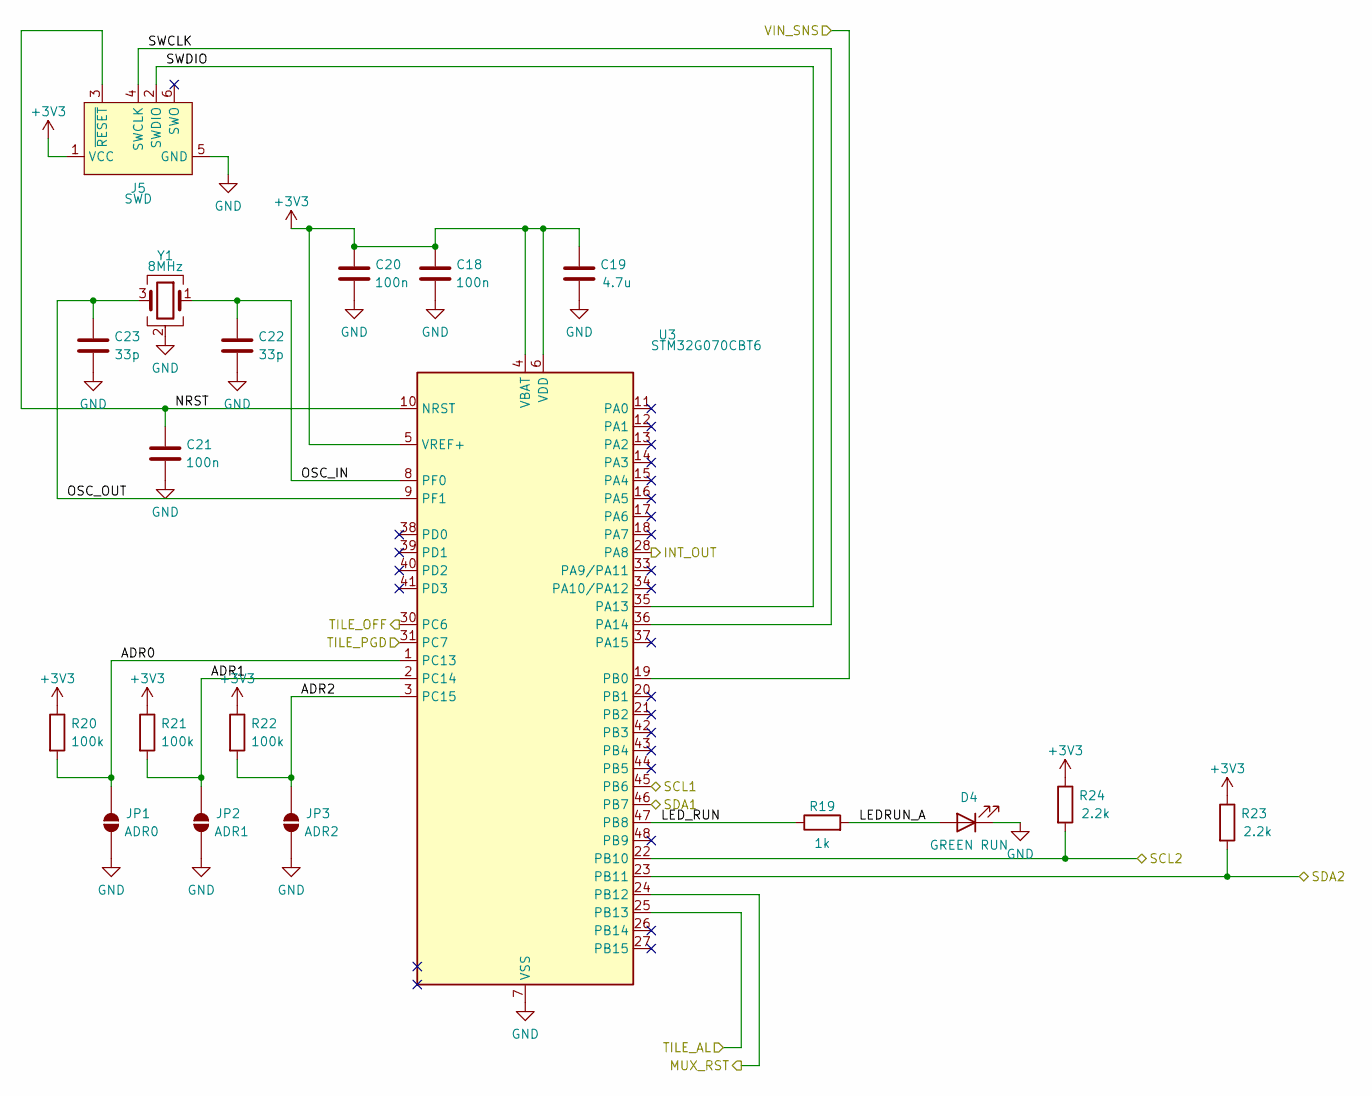
[picture p35: schematic mcu.kicad_sch]

Parts:
C18, C20, C21: 100n; C_0402_1005Metric; LCSC C1525
C19: 4.7u; C_0603_1608Metric
C22, C23: 33p; C_0402_1005Metric
D4: GREEN RUN; LED_0603_1608Metric; LCSC C2297
J5: SWD; Tag-Connect_TC2030-IDC-NL_2x03_P1.27mm_Vertical
JP1: ADR0; SolderJumper-2_P1.3mm_Open_RoundedPad1.0x1.5mm
JP2: ADR1; SolderJumper-2_P1.3mm_Open_RoundedPad1.0x1.5mm
JP3: ADR2; SolderJumper-2_P1.3mm_Open_RoundedPad1.0x1.5mm
R19: 1k; R_0402_1005Metric; LCSC C11702
R20, R21, R22: 100k; R_0402_1005Metric; LCSC C25741
R23, R24: 2.2k; R_0402_1005Metric; LCSC C25879
U3: STM32G070CBT6; LQFP-48_7x7mm_P0.5mm; LCSC C529338
Y1: 8MHz; Crystal_SMD_3225-4Pin_3.2x2.5mm; LCSC C7424755

Connections:
+3V3: C18.1, C19.1, C20.1, J5.1 (VCC), R20.1, R21.1, R22.1, R23.1, R24.1, U3.4 (VBAT), U3.5 (VREF+), U3.6 (VDD); also elsewhere on the board
/INT_OUT: U3.28 (PA8); also elsewhere on the board
/MCU/ADR0: JP1.1 (A), R20.2, U3.1 (PC13)
/MCU/ADR1: JP2.1 (A), R21.2, U3.2 (PC14)
/MCU/ADR2: JP3.1 (A), R22.2, U3.3 (PC15)
/MCU/LEDRUN_A: D4.2 (A), R19.2
/MCU/LED_RUN: R19.1, U3.47 (PB8)
/MCU/NRST: C21.1, J5.3 (~RESET), U3.10 (NRST)
/MCU/OSC_IN: C22.1, U3.8 (PF0), Y1.1
/MCU/OSC_OUT: C23.1, U3.9 (PF1), Y1.3
/MCU/SWCLK: J5.4 (SWCLK), U3.36 (PA14)
/MCU/SWDIO: J5.2 (SWDIO), U3.35 (PA13)
/MUX_RST: U3.24 (PB12); also elsewhere on the board
/SCL1: U3.45 (PB6); also elsewhere on the board
/SCL2: R24.2, U3.22 (PB10); also elsewhere on the board
/SDA1: U3.46 (PB7); also elsewhere on the board
/SDA2: R23.2, U3.23 (PB11); also elsewhere on the board
/TILE_AL: U3.25 (PB13); also elsewhere on the board
/TILE_OFF: U3.30 (PC6); also elsewhere on the board
/TILE_PGD: U3.31 (PC7); also elsewhere on the board
/VIN_SNS: U3.19 (PB0); also elsewhere on the board
GND: C18.2, C19.2, C20.2, C21.2, C22.2, C23.2, D4.1 (K), J5.5 (GND), JP1.2 (B), JP2.2 (B), JP3.2 (B), U3.7 (VSS), Y1.2 (G), Y1.4 (G); also elsewhere on the board

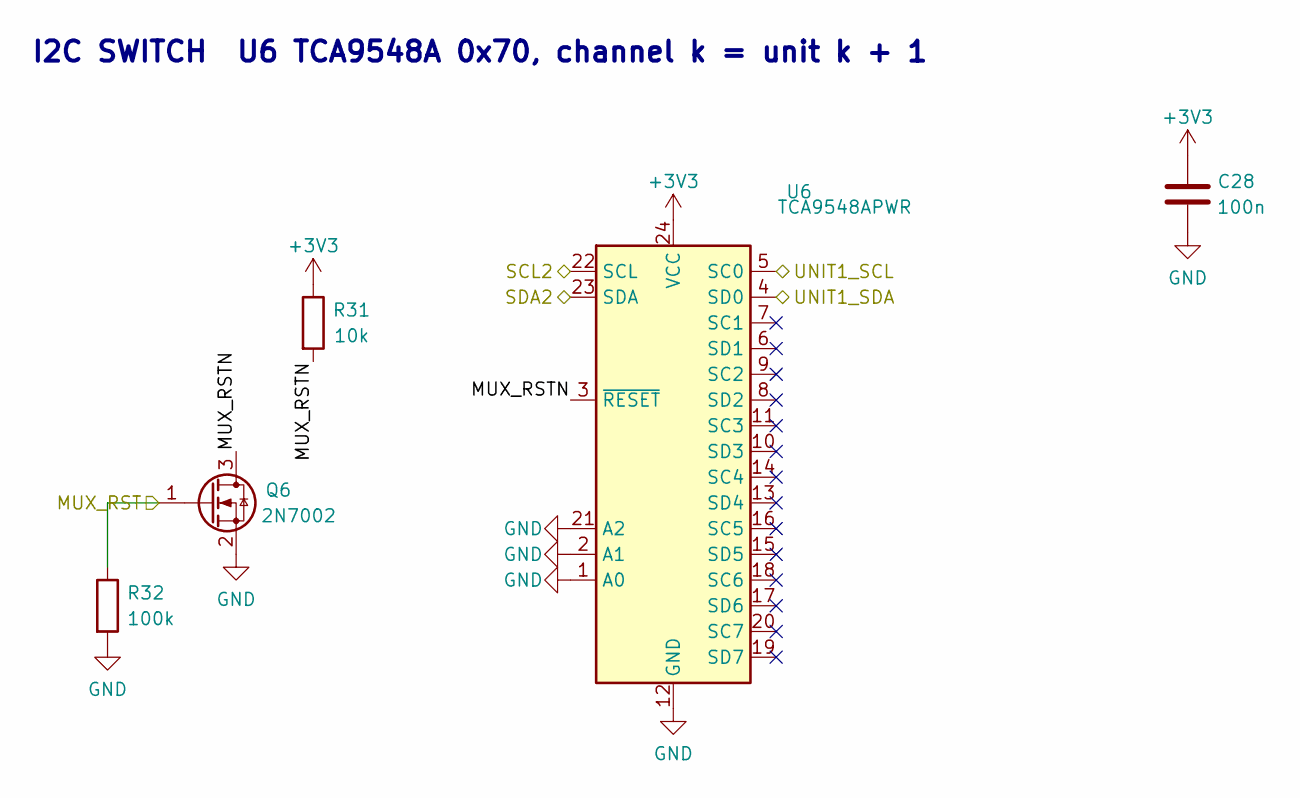
[picture p36: schematic mux.kicad_sch]

Parts:
C28: 100n; C_0402_1005Metric; LCSC C1525
Q6: 2N7002; SOT-23; LCSC C8545
R31: 10k; R_0402_1005Metric; LCSC C25744
R32: 100k; R_0402_1005Metric; LCSC C25741
U6: TCA9548APWR; TSSOP-24_4.4x7.8mm_P0.65mm; LCSC C130026

Connections:
+3V3: C28.1, R31.1, U6.24 (VCC); also elsewhere on the board
/MUX_RST: Q6.1 (G), R32.1; also elsewhere on the board
/Mux/MUX_RSTN: Q6.3 (D), R31.2, U6.3 (~RESET)
/SCL2: U6.22 (SCL); also elsewhere on the board
/SDA2: U6.23 (SDA); also elsewhere on the board
/UNIT1_SCL: U6.5 (SC0); also elsewhere on the board
/UNIT1_SDA: U6.4 (SD0); also elsewhere on the board
GND: C28.2, Q6.2 (S), R32.2, U6.1 (A0), U6.2 (A1), U6.12 (GND), U6.21 (A2); also elsewhere on the board

Notes on the sheet:
I2C SWITCH U6 TCA9548A 0x70, channel k = unit k + 1

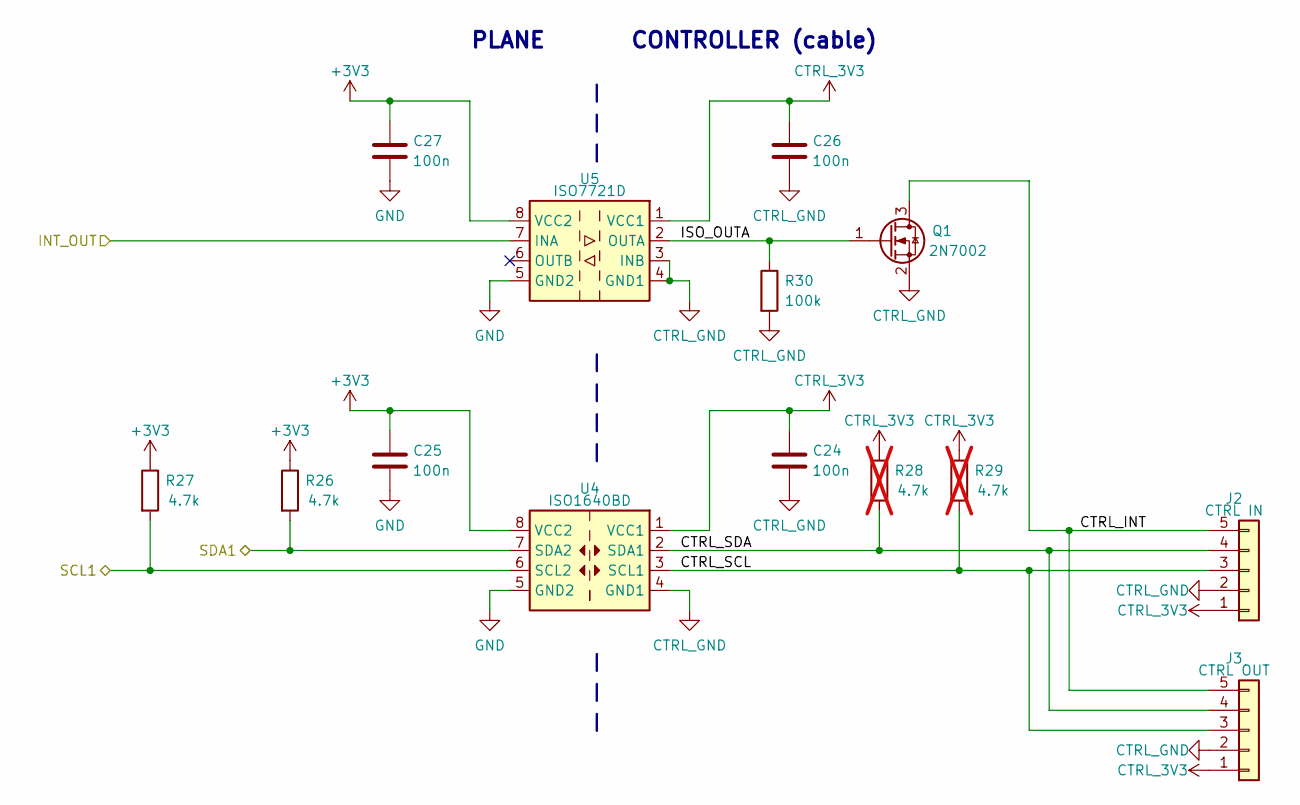
[picture p37: schematic link.kicad_sch]

Parts:
C24, C25, C26, C27: 100n; C_0402_1005Metric; LCSC C1525
J2: CTRL IN; JST_PH_B5B-PH-K_1x05_P2.00mm_Vertical; LCSC C157993
J3: CTRL OUT; JST_PH_B5B-PH-K_1x05_P2.00mm_Vertical; LCSC C157993
Q1: 2N7002; SOT-23; LCSC C8545
R26, R27: 4.7k; R_0402_1005Metric; LCSC C25900
R28, R29: 4.7k; R_0402_1005Metric; LCSC C25900; not fitted
R30: 100k; R_0402_1005Metric; LCSC C25741
U4: ISO1640BD; SOIC-8_3.9x4.9mm_P1.27mm; LCSC C5122339
U5: ISO7721D; SOIC-8_3.9x4.9mm_P1.27mm; LCSC C366164

Connections:
+3V3: C25.1, C27.1, R26.1, R27.1, U4.8 (VCC2), U5.8 (VCC2); also elsewhere on the board
/INT_OUT: U5.7 (INA); also elsewhere on the board
/Link/CTRL_INT: J2.5, J3.5, Q1.3 (D)
/Link/CTRL_SCL: J2.3, J3.3, R29.2, U4.3 (SCL1)
/Link/CTRL_SDA: J2.4, J3.4, R28.2, U4.2 (SDA1)
/Link/ISO_OUTA: Q1.1 (G), R30.1, U5.2 (OUTA)
/SCL1: R27.2, U4.6 (SCL2); also elsewhere on the board
/SDA1: R26.2, U4.7 (SDA2); also elsewhere on the board
CTRL_3V3: C24.1, C26.1, J2.1, J3.1, R28.1, R29.1, U4.1 (VCC1), U5.1 (VCC1)
CTRL_GND: C24.2, C26.2, J2.2, J3.2, Q1.2 (S), R30.2, U4.4 (GND1), U5.3 (INB), U5.4 (GND1); also elsewhere on the board
GND: C25.2, C27.2, U4.5 (GND2), U5.5 (GND2); also elsewhere on the board

Notes on the sheet:
PLANE
CONTROLLER (cable)
