delandtj/granite_controller/attic/power/pp-48-rev1/pp-48.kicad_pcb

## KiCad design attic/power/pp-48-rev1/pp-48.kicad_pcb (continued)

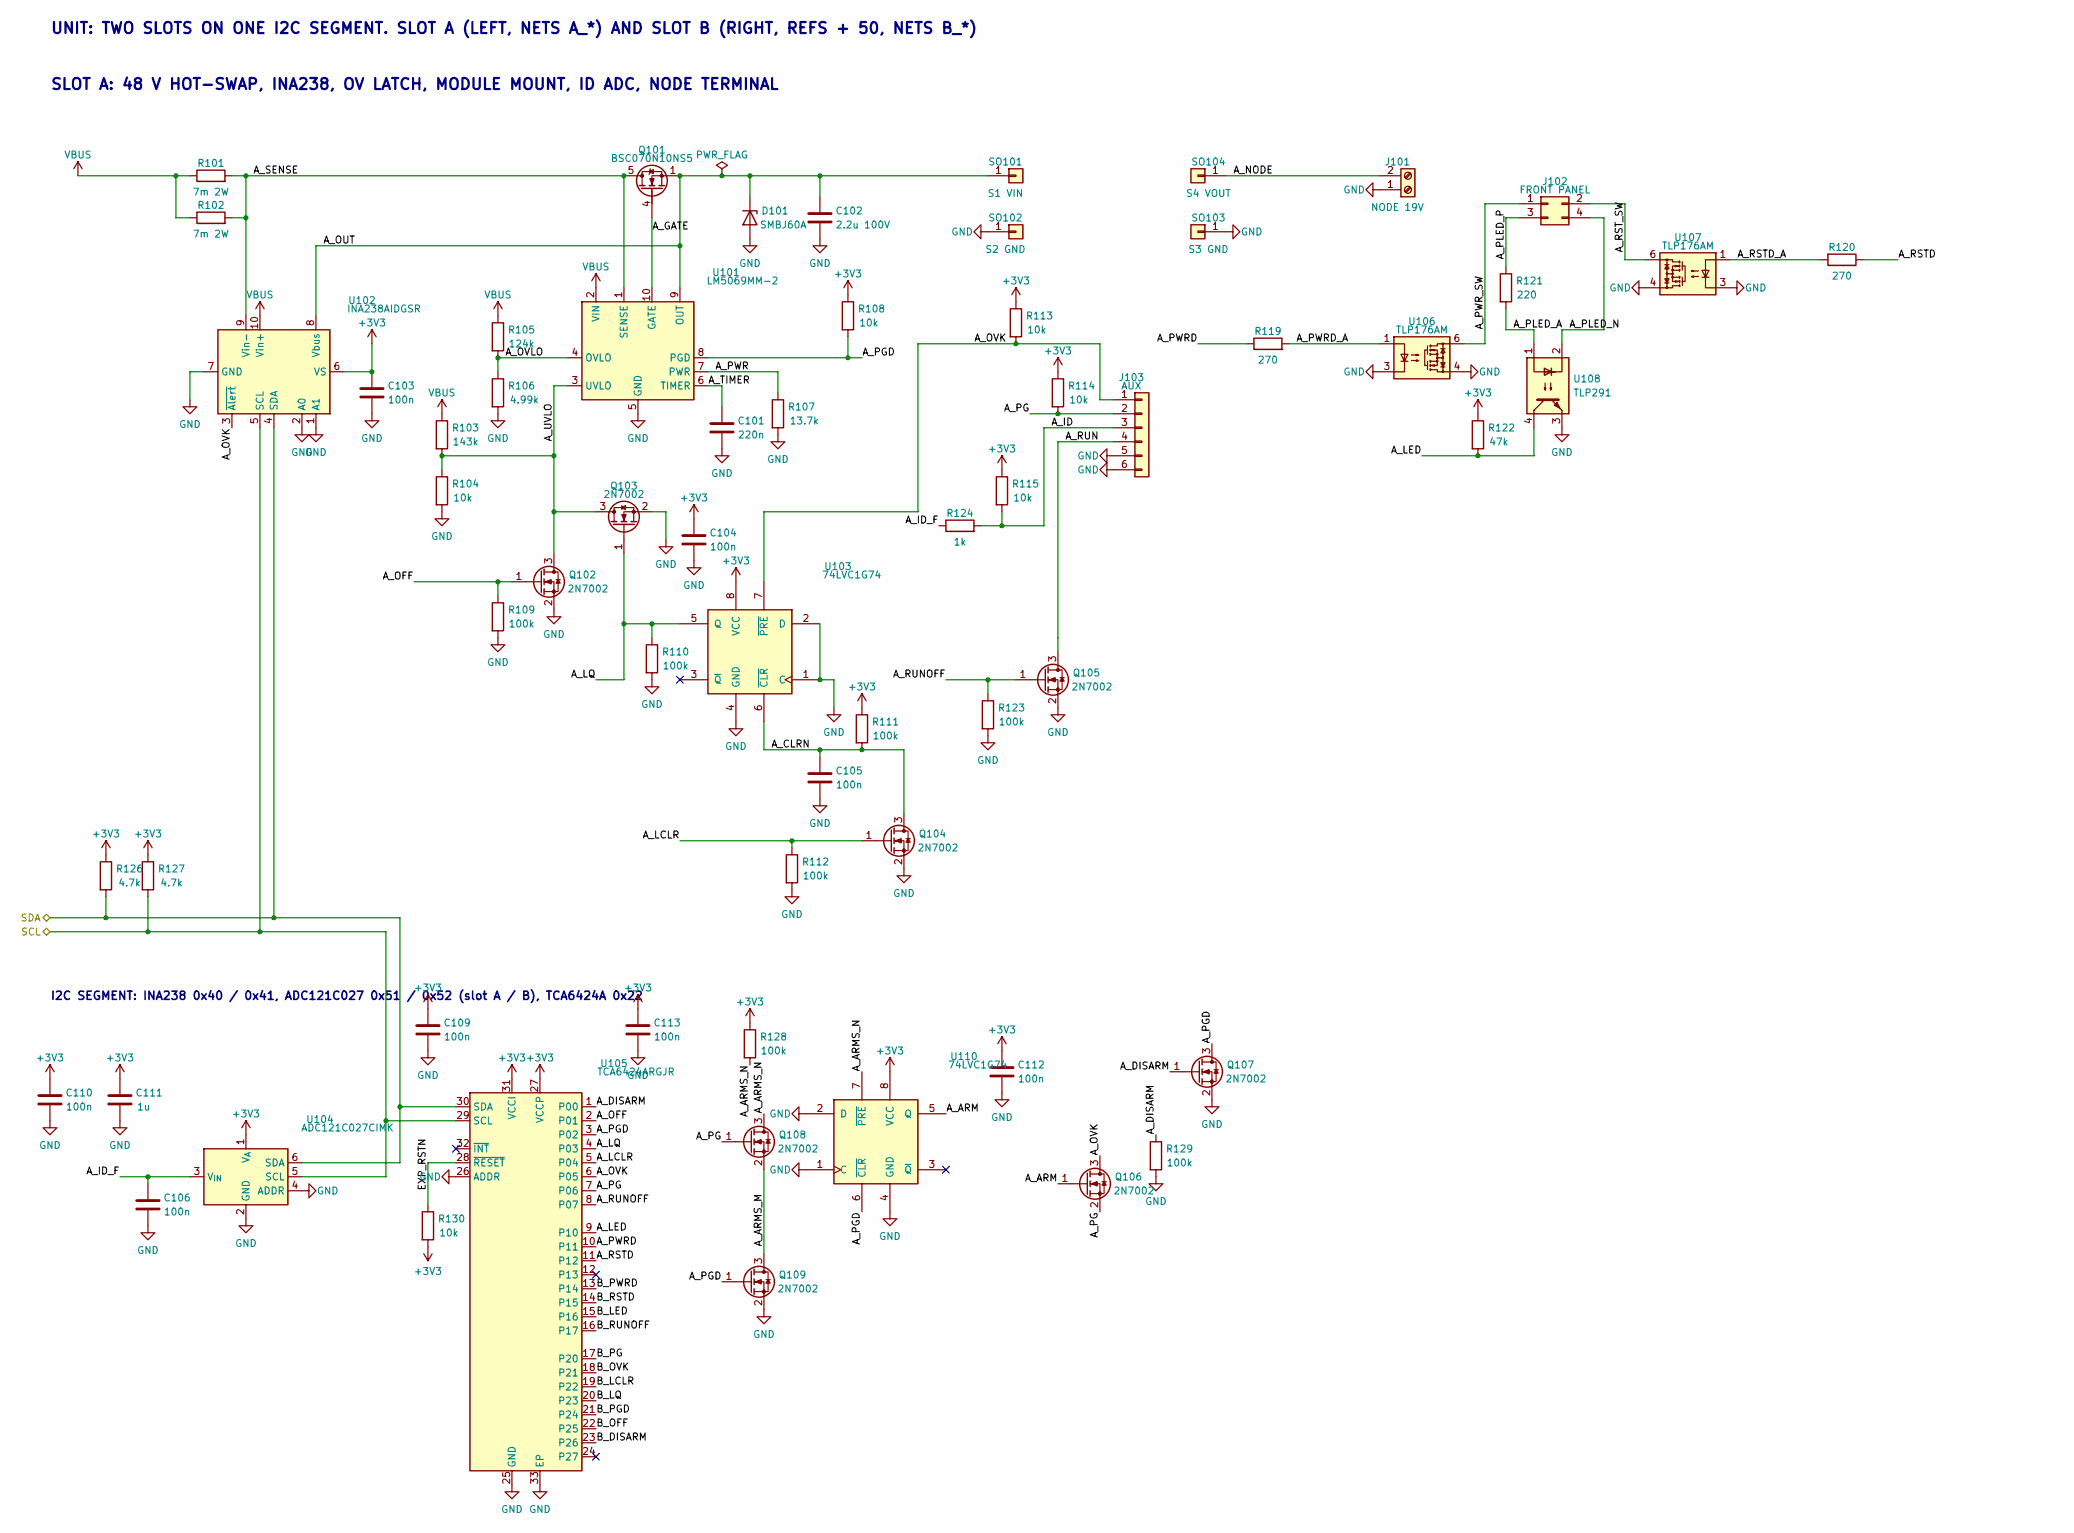
[picture p38: schematic unit.kicad_sch, part in row 1, column 1]

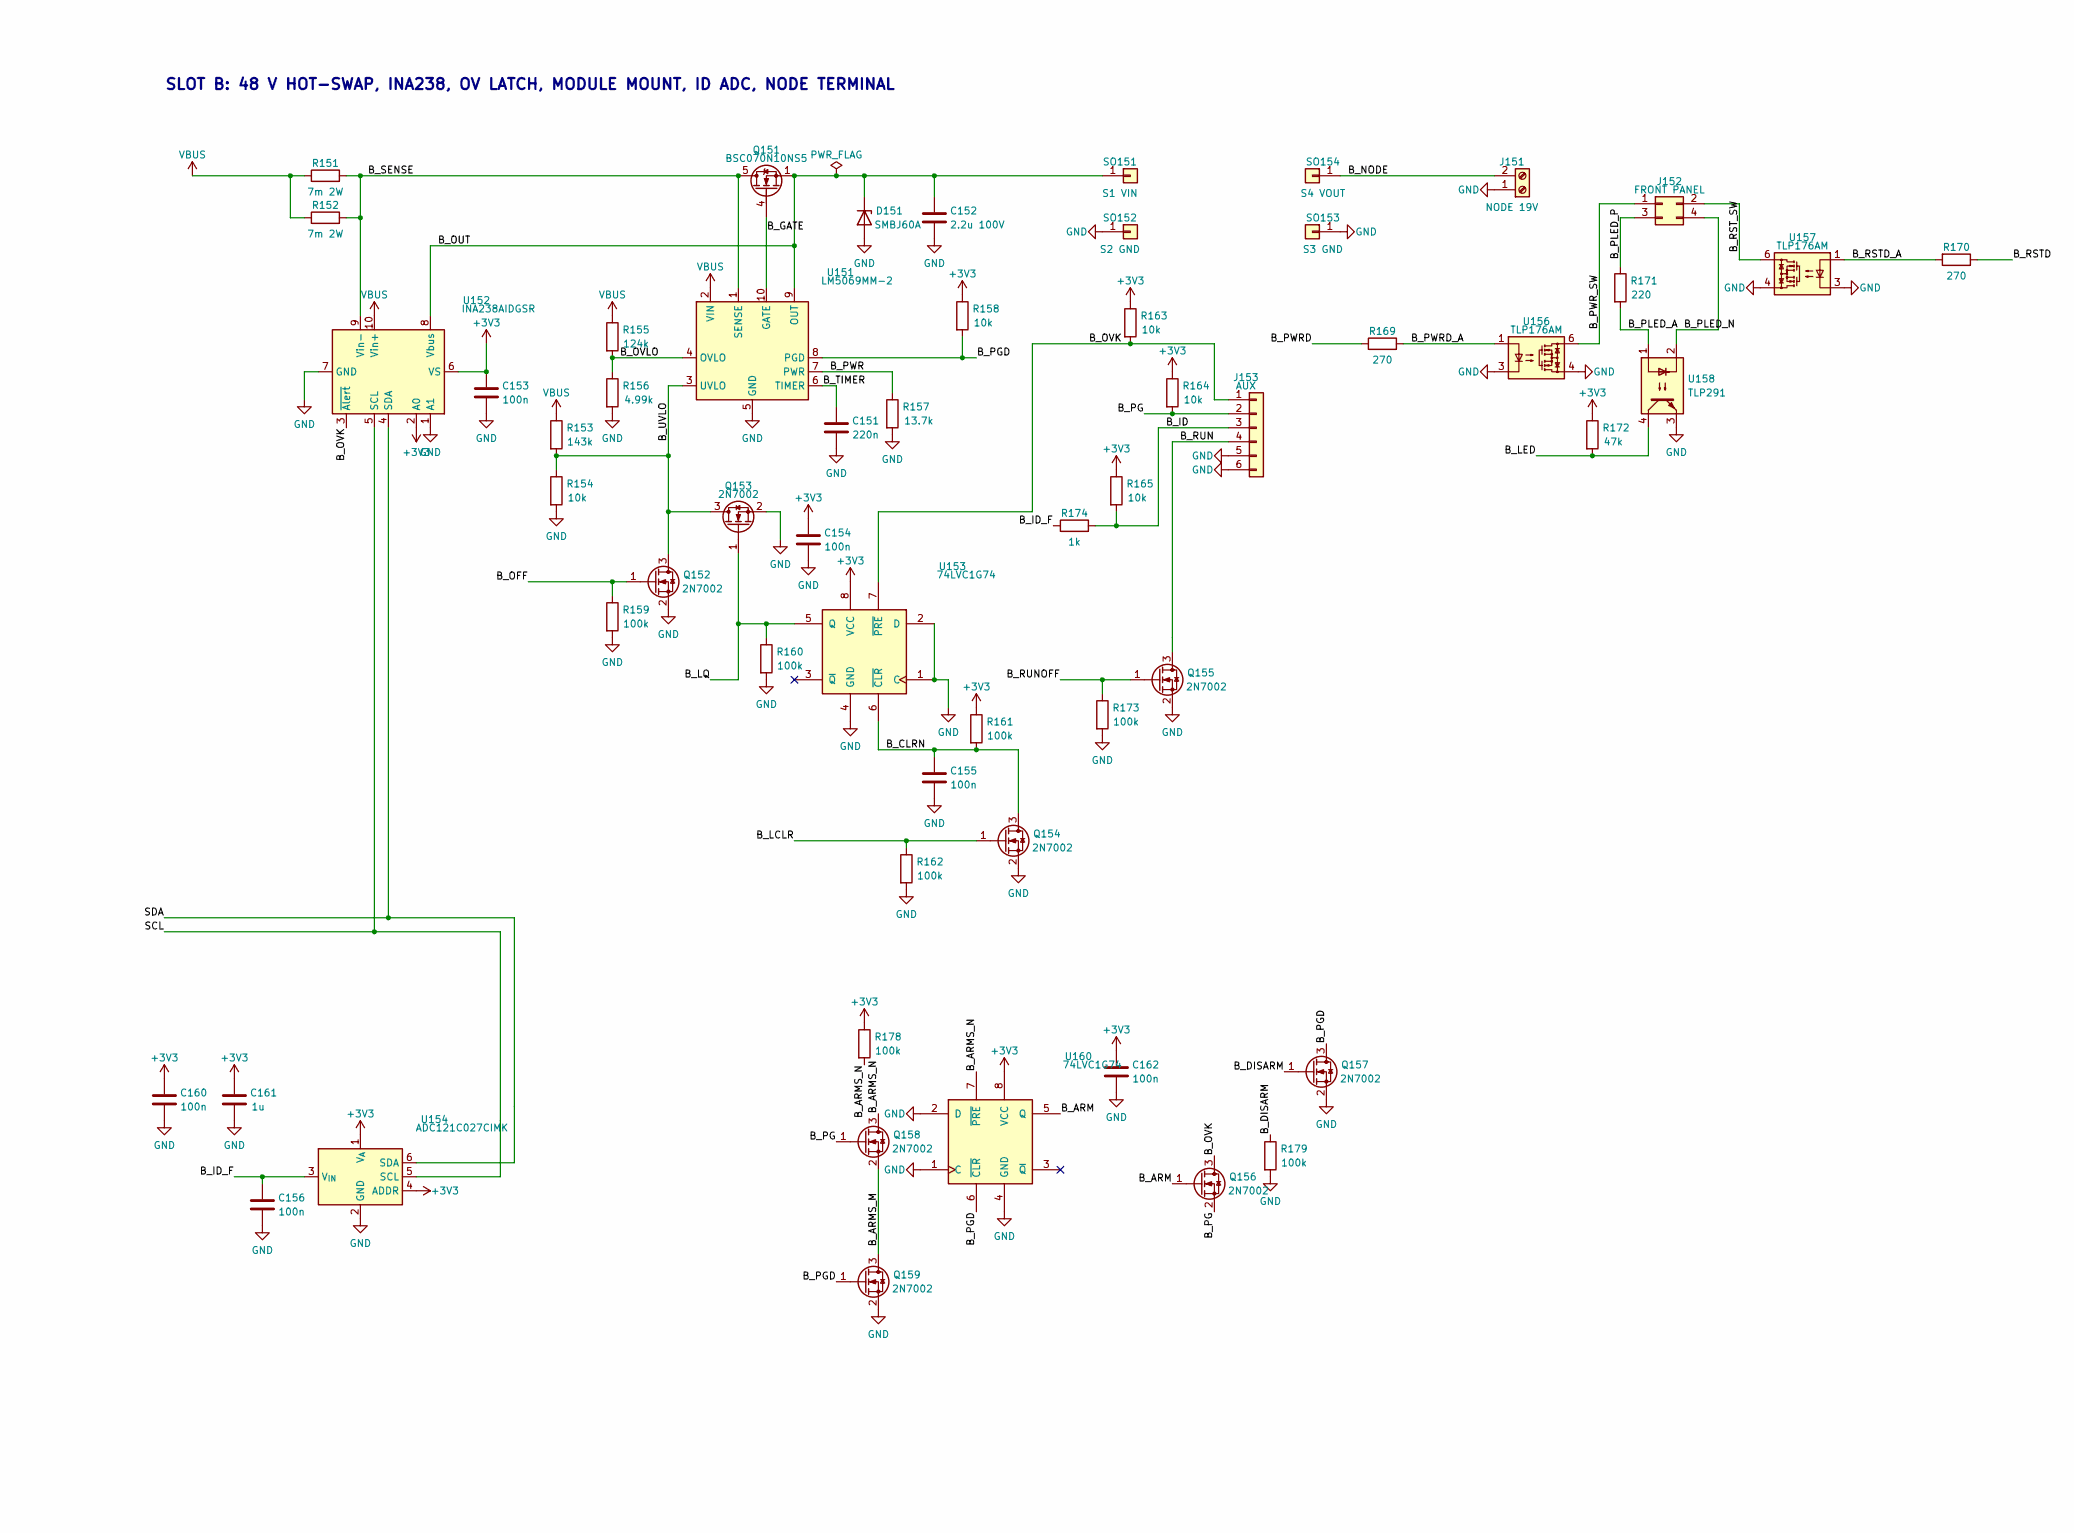
[picture p39: schematic unit.kicad_sch, part in row 1, column 2]

Parts:
C101, C151: 220n; C_0603_1608Metric
C102, C152: 2.2u 100V; C_1210_3225Metric; LCSC C338133
C103, C104, C105, C106, C109, C110, C112, C113, C153, C154, C155, C156, C160, C162: 100n; C_0402_1005Metric; LCSC C1525
C111, C161: 1u; C_0402_1005Metric; LCSC C52923
D101, D151: SMBJ60A; D_SMB; LCSC C353345
J101, J151: NODE 19V; TerminalBlock_Degson_DG128-5.0-02P; MPN Degson DG128-5.0-02P-14-00A(H); LCSC C711349
J102, J152: FRONT PANEL; JST_GH_SM04B-GHS-TB_1x04-1MP_P1.25mm_Horizontal; MPN JST SM04B-GHS-TB; LCSC C189895
J103, J153: AUX; PM_Aux_Socket_2x03_P1.27; MPN hanxia HX PM1.27-2x3P TP; LCSC C41397112
Q101, Q151: BSC070N10NS5; TDSON-8-1
Q102, Q103, Q104, Q105, Q106, Q107, Q108, Q109, Q152, Q153, Q154, Q155, Q156, Q157, Q158, Q159: 2N7002; SOT-23; LCSC C8545
R101, R102, R151, R152: 7m 2W; R_2512_6332Metric; LCSC C2904232
R103, R153: 143k; R_0805_2012Metric
R104, R108, R113, R114, R115, R130, R154, R158, R163, R164, R165: 10k; R_0402_1005Metric; LCSC C25744
R105, R155: 124k; R_0805_2012Metric
R106, R156: 4.99k; R_0402_1005Metric
R107, R157: 13.7k; R_0402_1005Metric
R109, R110, R111, R112, R123, R128, R129, R159, R160, R161, R162, R173, R178, R179: 100k; R_0402_1005Metric; LCSC C25741
R119, R120, R169, R170: 270; R_0402_1005Metric; LCSC C22775
R121, R171: 220; R_0402_1005Metric; LCSC C25091
R122, R172: 47k; R_0402_1005Metric; LCSC C25792
R124, R174: 1k; R_0402_1005Metric; LCSC C11702
R126, R127: 4.7k; R_0402_1005Metric; LCSC C25900
SO101, SO151: S1 VIN; PM_Standoff_M2x7_SMTSO; MPN Sinhoo SMTSO2070CTJ; LCSC C2916355
SO102, SO152: S2 GND; PM_Standoff_M2x7_SMTSO; MPN Sinhoo SMTSO2070CTJ; LCSC C2916355
SO103, SO153: S3 GND; PM_Standoff_M2x7_SMTSO; MPN Sinhoo SMTSO2070CTJ; LCSC C2916355
SO104, SO154: S4 VOUT; PM_Standoff_M2x7_SMTSO; MPN Sinhoo SMTSO2070CTJ; LCSC C2916355
U101, U151: LM5069MM-2; MSOP-10_3x3mm_P0.5mm; LCSC C111822
U102, U152: INA238AIDGSR; TSSOP-10_3x3mm_P0.5mm
U103, U110, U153, U160: 74LVC1G74; VSSOP-8_2.3x2mm_P0.5mm; LCSC C70285
U104, U154: ADC121C027CIMK; TSOT-23-6; MPN TI ADC121C027CIMKX/NOPB; LCSC C2670157
U105: TCA6424ARGJR; VQFN-32-1EP_5x5mm_P0.5mm_EP3.15x3.15mm; LCSC C80692
U106, U107, U156, U157: TLP176AM; SOIC-4_4.55x3.7mm_P2.54mm; LCSC C5370540
U108, U158: TLP291; SOIC-4_4.55x2.6mm_P1.27mm; LCSC C55144

Connections:
+3V3: C103.1, C104.1, C109.1, C110.1, C111.1, C112.1, C113.1, C153.1, C154.1, C160.1, C161.1, C162.1, R108.1, R111.1, R113.1, R114.1, R115.1, R122.1, R126.1, R127.1, R128.1, R130.2, R158.1, R161.1, R163.1, R164.1, R165.1, R172.1, R178.1, U102.6 (VS), U103.8 (VCC), U104.1 (V_{A}), U105.27 (VCCP), U105.31 (VCCI), U110.8 (VCC), U152.2 (A0), U152.6 (VS), U153.8 (VCC), U154.1 (V_{A}), U154.4 (ADDR), U160.8 (VCC); also elsewhere on the board
/UNIT1_SCL: R127.2, U102.5 (SCL), U104.5 (SCL), U105.29 (SCL), U152.5 (SCL), U154.5 (SCL); also elsewhere on the board
/UNIT1_SDA: R126.2, U102.4 (SDA), U104.6 (SDA), U105.30 (SDA), U152.4 (SDA), U154.6 (SDA); also elsewhere on the board
/Unit 1/A_ARM: Q106.1 (G), U110.5 (Q)
/Unit 1/A_ARMS_M: Q108.2 (S), Q109.3 (D)
/Unit 1/A_ARMS_N: Q108.3 (D), R128.2, U110.7 (~PRE)
/Unit 1/A_CLRN: C105.1, Q104.3 (D), R111.2, U103.6 (~CLR)
/Unit 1/A_DISARM: Q107.1 (G), R129.1, U105.1 (P00); also elsewhere on the board
/Unit 1/A_GATE: Q101.4 (G), U101.10 (GATE)
/Unit 1/A_ID: J103.3, R115.2, R124.2
/Unit 1/A_ID_F: C106.1, R124.1, U104.3 (V_{IN})
/Unit 1/A_LCLR: Q104.1 (G), R112.1, U105.5 (P04); also elsewhere on the board
/Unit 1/A_LED: R122.2, U105.9 (P10), U108.4; also elsewhere on the board
/Unit 1/A_LQ: Q103.1 (G), R110.1, U103.5 (Q), U105.4 (P03); also elsewhere on the board
/Unit 1/A_NODE: J101.2, SO104.1
/Unit 1/A_OFF: Q102.1 (G), R109.1, U105.2 (P01); also elsewhere on the board
/Unit 1/A_OUT: C102.1, D101.1 (K), Q101.1 (S), Q101.2 (S), Q101.3 (S), SO101.1, U101.9 (OUT), U102.8 (Vbus)
/Unit 1/A_OVK: J103.1, Q106.3 (D), R113.2, U102.3 (~Alert), U103.7 (~PRE), U105.6 (P05); also elsewhere on the board
/Unit 1/A_OVLO: R105.2, R106.1, U101.4 (OVLO)
/Unit 1/A_PG: J103.2, Q106.2 (S), Q108.1 (G), R114.2, U105.7 (P06); also elsewhere on the board
/Unit 1/A_PGD: Q107.3 (D), Q109.1 (G), R108.2, U101.8 (PGD), U105.3 (P02), U110.6 (~CLR); also elsewhere on the board
/Unit 1/A_PLED_A: R121.2, U108.1
/Unit 1/A_PLED_N: J102.4, U108.2
/Unit 1/A_PLED_P: J102.3, R121.1
/Unit 1/A_PWR: R107.1, U101.7 (PWR)
/Unit 1/A_PWRD: R119.1, U105.10 (P11); also elsewhere on the board
/Unit 1/A_PWRD_A: R119.2, U106.1
/Unit 1/A_PWR_SW: J102.1, U106.6
/Unit 1/A_RSTD: R120.1, U105.11 (P12); also elsewhere on the board
/Unit 1/A_RSTD_A: R120.2, U107.1
/Unit 1/A_RST_SW: J102.2, U107.6
/Unit 1/A_RUN: J103.4, Q105.3 (D)
/Unit 1/A_RUNOFF: Q105.1 (G), R123.1, U105.8 (P07); also elsewhere on the board
/Unit 1/A_SENSE: Q101.5 (D), R101.2, R102.2, U101.1 (SENSE), U102.9 (Vin-)
/Unit 1/A_TIMER: C101.1, U101.6 (TIMER)
/Unit 1/A_UVLO: Q102.3 (D), Q103.3 (D), R103.2, R104.1, U101.3 (UVLO)
/Unit 1/B_ARM: Q156.1 (G), U160.5 (Q)
/Unit 1/B_ARMS_M: Q158.2 (S), Q159.3 (D)
/Unit 1/B_ARMS_N: Q158.3 (D), R178.2, U160.7 (~PRE)
/Unit 1/B_CLRN: C155.1, Q154.3 (D), R161.2, U153.6 (~CLR)
/Unit 1/B_DISARM: Q157.1 (G), R179.1, U105.23 (P26)
/Unit 1/B_GATE: Q151.4 (G), U151.10 (GATE)
/Unit 1/B_ID: J153.3, R165.2, R174.2
/Unit 1/B_ID_F: C156.1, R174.1, U154.3 (V_{IN})
/Unit 1/B_LCLR: Q154.1 (G), R162.1, U105.19 (P22)
/Unit 1/B_LED: R172.2, U105.15 (P16), U158.4
/Unit 1/B_LQ: Q153.1 (G), R160.1, U105.20 (P23), U153.5 (Q)
/Unit 1/B_NODE: J151.2, SO154.1
/Unit 1/B_OFF: Q152.1 (G), R159.1, U105.22 (P25)
/Unit 1/B_OUT: C152.1, D151.1 (K), Q151.1 (S), Q151.2 (S), Q151.3 (S), SO151.1, U151.9 (OUT), U152.8 (Vbus)
/Unit 1/B_OVK: J153.1, Q156.3 (D), R163.2, U105.18 (P21), U152.3 (~Alert), U153.7 (~PRE)
/Unit 1/B_OVLO: R155.2, R156.1, U151.4 (OVLO)
/Unit 1/B_PG: J153.2, Q156.2 (S), Q158.1 (G), R164.2, U105.17 (P20)
/Unit 1/B_PGD: Q157.3 (D), Q159.1 (G), R158.2, U105.21 (P24), U151.8 (PGD), U160.6 (~CLR)
/Unit 1/B_PLED_A: R171.2, U158.1
/Unit 1/B_PLED_N: J152.4, U158.2
/Unit 1/B_PLED_P: J152.3, R171.1
/Unit 1/B_PWR: R157.1, U151.7 (PWR)
/Unit 1/B_PWRD: R169.1, U105.13 (P14)
/Unit 1/B_PWRD_A: R169.2, U156.1
/Unit 1/B_PWR_SW: J152.1, U156.6
/Unit 1/B_RSTD: R170.1, U105.14 (P15)
/Unit 1/B_RSTD_A: R170.2, U157.1
/Unit 1/B_RST_SW: J152.2, U157.6
/Unit 1/B_RUN: J153.4, Q155.3 (D)
/Unit 1/B_RUNOFF: Q155.1 (G), R173.1, U105.16 (P17)
/Unit 1/B_SENSE: Q151.5 (D), R151.2, R152.2, U151.1 (SENSE), U152.9 (Vin-)
/Unit 1/B_TIMER: C151.1, U151.6 (TIMER)
/Unit 1/B_UVLO: Q152.3 (D), Q153.3 (D), R153.2, R154.1, U151.3 (UVLO)
/Unit 1/EXP_RSTN: R130.1, U105.28 (~RESET)
GND: C101.2, C102.2, C103.2, C104.2, C105.2, C106.2, C109.2, C110.2, C111.2, C112.2, C113.2, C151.2, C152.2, C153.2, C154.2, C155.2, C156.2, C160.2, C161.2, C162.2, D101.2 (A), D151.2 (A), J101.1, J103.5, J103.6, J151.1, J153.5, J153.6, Q102.2 (S), Q103.2 (S), Q104.2 (S), Q105.2 (S), Q107.2 (S), Q109.2 (S), Q152.2 (S), Q153.2 (S), Q154.2 (S), Q155.2 (S), Q157.2 (S), Q159.2 (S), R104.2, R106.2, R107.2, R109.2, R110.2, R112.2, R123.2, R129.2, R154.2, R156.2, R157.2, R159.2, R160.2, R162.2, R173.2, R179.2, SO102.1, SO103.1, SO152.1, SO153.1, U101.5 (GND), U102.1 (A1), U102.2 (A0), U102.7 (GND), U103.1 (C), U103.2 (D), U103.4 (GND), U104.2 (GND), U104.4 (ADDR), U105.25 (GND), U105.26 (ADDR), U105.33 (EP), U106.3, U106.4, U107.3, U107.4, U108.3, U110.1 (C), U110.2 (D), U110.4 (GND), U151.5 (GND), U152.1 (A1), U152.7 (GND), U153.1 (C), U153.2 (D), U153.4 (GND), U154.2 (GND), U156.3, U156.4, U157.3, U157.4, U158.3, U160.1 (C), U160.2 (D), U160.4 (GND); also elsewhere on the board
VBUS: R101.1, R102.1, R103.1, R105.1, R151.1, R152.1, R153.1, R155.1, U101.2 (VIN), U102.10 (Vin+), U151.2 (VIN), U152.10 (Vin+); also elsewhere on the board

Notes on the sheet:
SLOT A: 48 V HOT-SWAP, INA238, OV LATCH, MODULE MOUNT, ID ADC, NODE TERMINAL
SLOT B: 48 V HOT-SWAP, INA238, OV LATCH, MODULE MOUNT, ID ADC, NODE TERMINAL
UNIT: TWO SLOTS ON ONE I2C SEGMENT. SLOT A (LEFT, NETS A_*) AND SLOT B (RIGHT, REFS + 50, NETS B_*)
I2C SEGMENT: INA238 0x40 / 0x41, ADC121C027 0x51 / 0x52 (slot A / B), TCA6424A 0x22

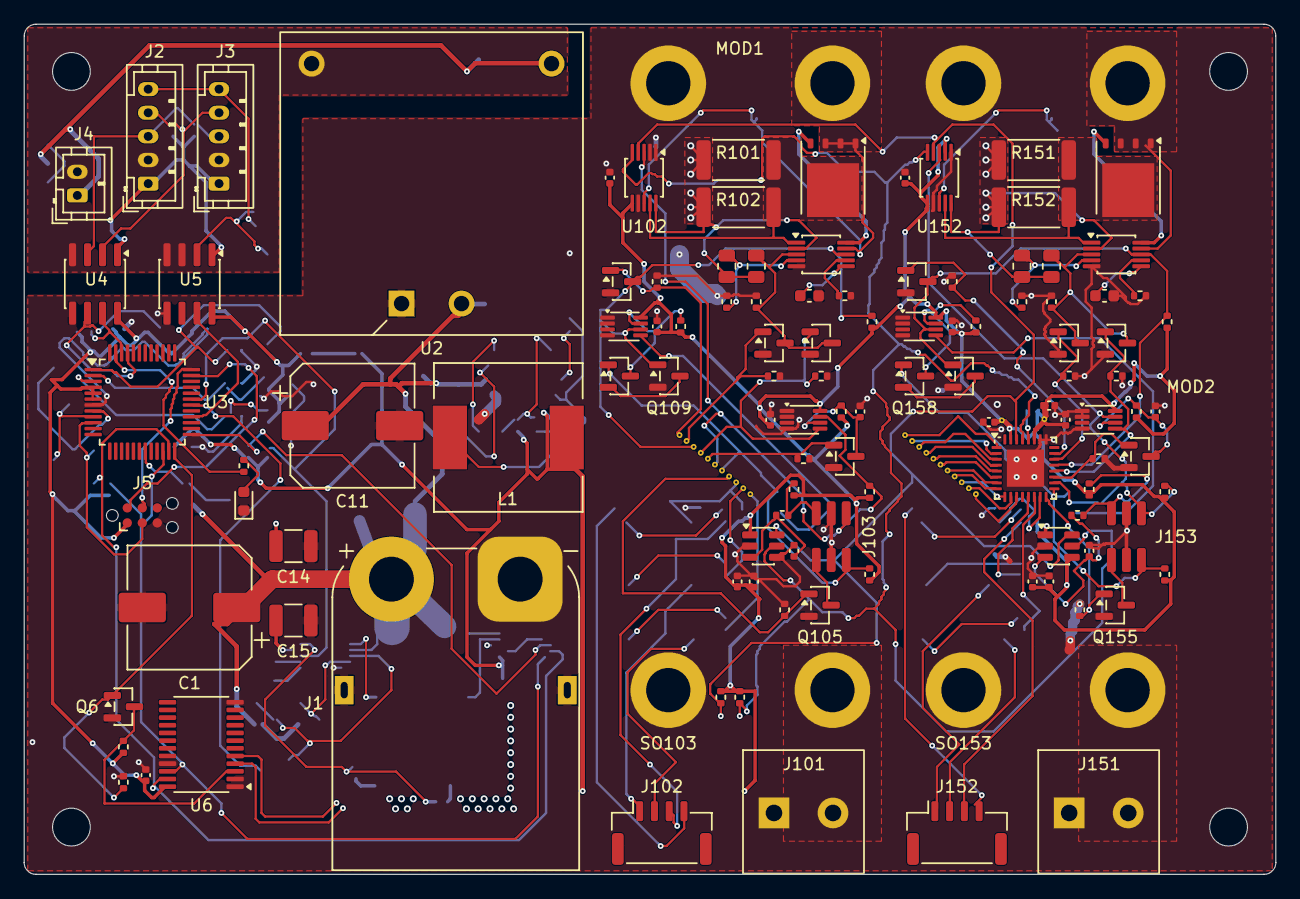
[picture p40: board pp-48.kicad_pcb from above]

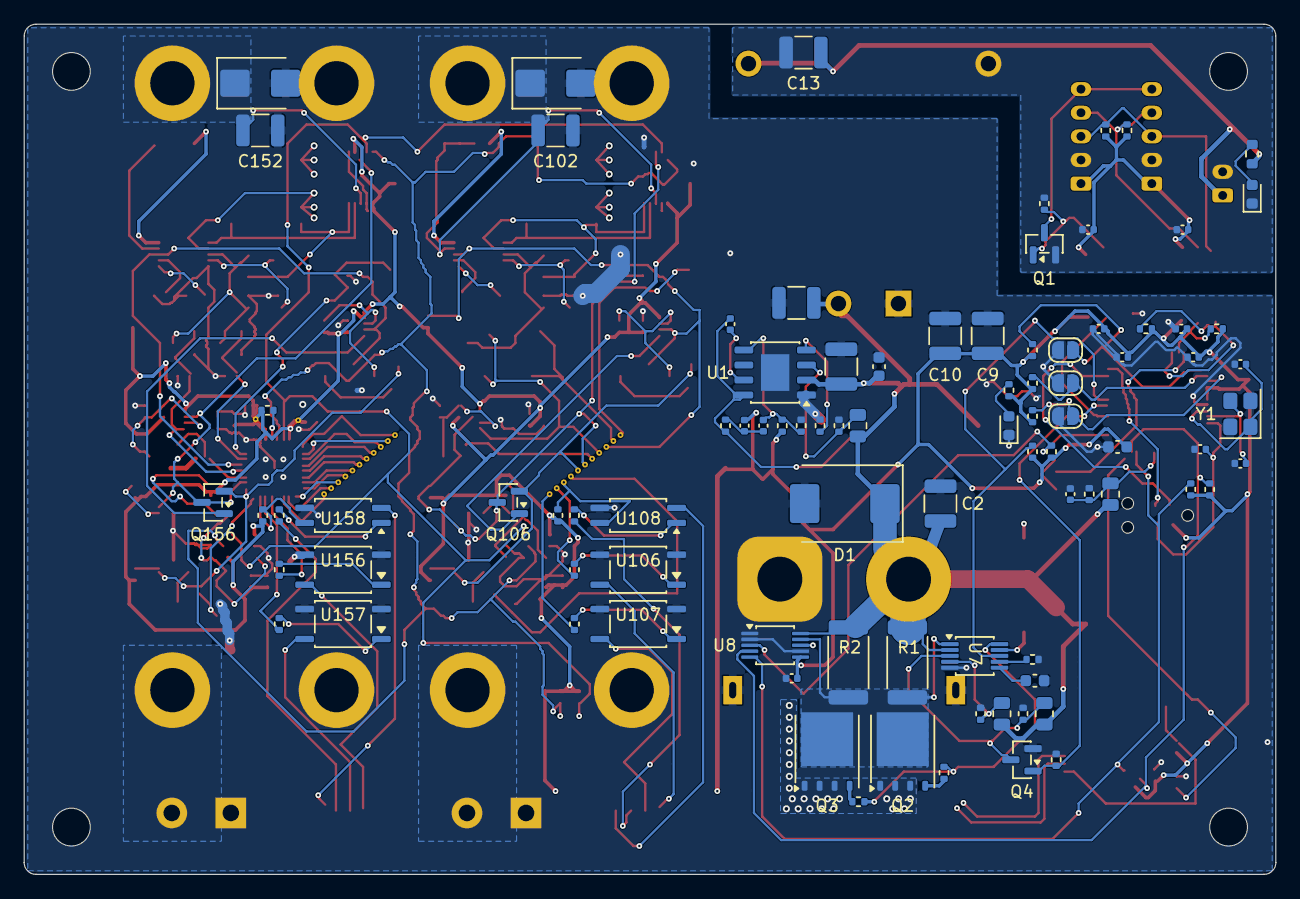
[picture p41: board pp-48.kicad_pcb from below]

Board: 4 copper layers, 106.0 x 72.0 mm, 240 parts (90 on the bottom side), 117 nets.

Other parts of the board:
BV100, BV101, BV102, BV103, BV104, BV105, BV106, BV107, BV108, BV109, BV110, BV150, BV151, BV152, BV153, BV154, BV155, BV156, BV157, BV158, BV159, BV160: (no value)
H1, H2, H3, H4: MountingHole_3.2mm_M3
MOD1, MOD2: PM_Module_Outline
PV1B3, PV1B4: (no value)

Their connections:
+3V3: PV1B3.1, PV1B4.1; also elsewhere on the board
/Unit 1/A_DISARM: BV100.1, BV150.1; also elsewhere on the board
/Unit 1/A_LCLR: BV104.1, BV154.1; also elsewhere on the board
/Unit 1/A_LED: BV108.1, BV158.1; also elsewhere on the board
/Unit 1/A_LQ: BV103.1, BV153.1; also elsewhere on the board
/Unit 1/A_OFF: BV101.1, BV151.1; also elsewhere on the board
/Unit 1/A_OVK: BV105.1, BV155.1; also elsewhere on the board
/Unit 1/A_PG: BV106.1, BV156.1; also elsewhere on the board
/Unit 1/A_PGD: BV102.1, BV152.1; also elsewhere on the board
/Unit 1/A_PWRD: BV109.1, BV159.1; also elsewhere on the board
/Unit 1/A_RSTD: BV110.1, BV160.1; also elsewhere on the board
/Unit 1/A_RUNOFF: BV107.1, BV157.1; also elsewhere on the board
