delandtj/granite_controller/attic/power/pp-48-2s/pp-48-2s.kicad_pcb

## KiCad design attic/power/pp-48-2s/pp-48-2s.kicad_pcb (2026-10-30)

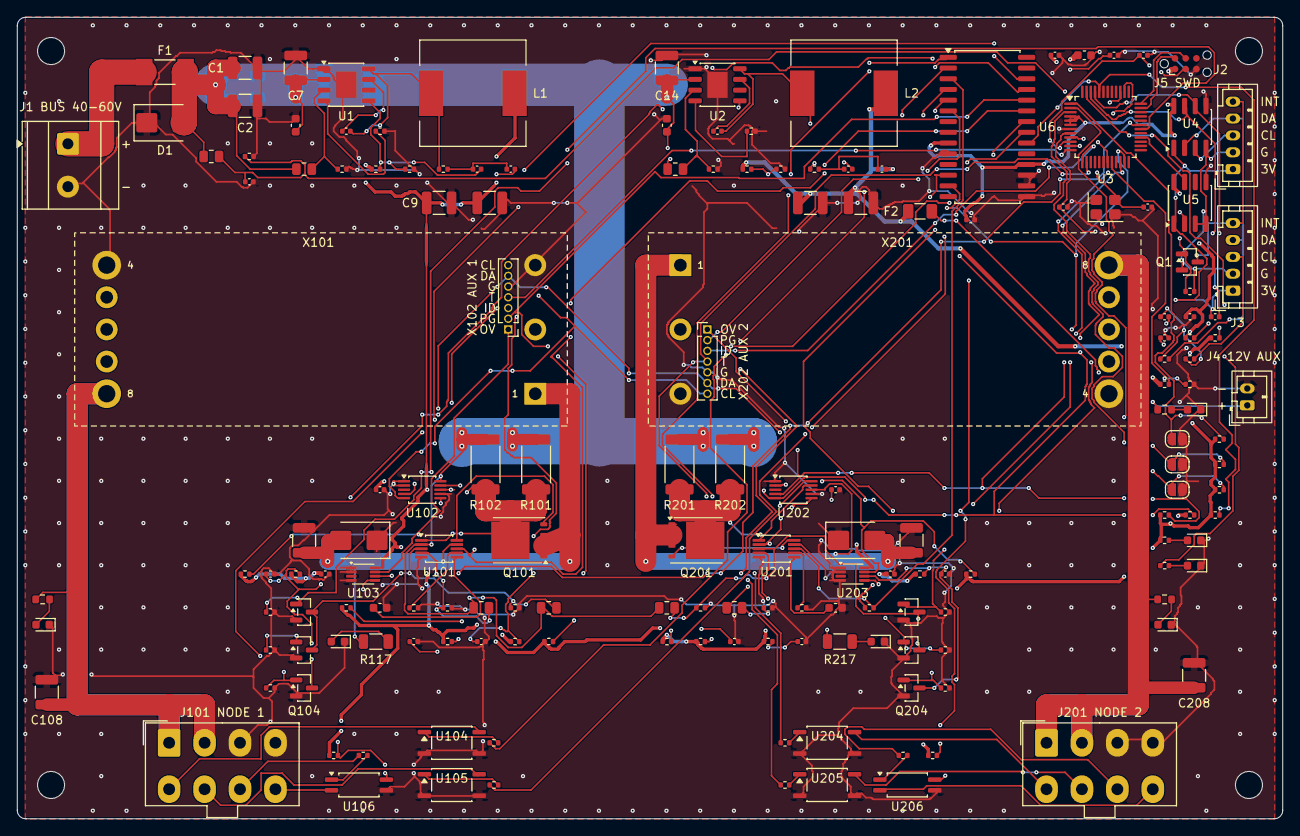
[picture p42: board pp-48-2s.kicad_pcb from above]

Board: 4 copper layers, 150.0 x 95.0 mm, 178 parts (0 on the bottom side), 102 nets.

Parts:
C1, C2, C7, C14, C102, C202: 2.2u 100V; C_1210_3225Metric
C3: 10n; C_0402_1005Metric
C4, C11: 2.2n 50V; C_0402_1005Metric
C5: 1.5n; C_0402_1005Metric
C6, C13, C18, C20, C21, C24, C25, C26, C27, C28, C103, C104, C105, C106, C107, C203, C204, C205, C206, C207: 100n; C_0402_1005Metric
C8, C15: 100n 100V; C_0603_1608Metric
C9, C10: 22u 10V; C_1210_3225Metric
C12: 2.2n; C_0402_1005Metric
C16, C17: 22u 25V; C_1210_3225Metric
C19: 4.7u; C_0603_1608Metric
C22, C23: 33p; C_0402_1005Metric
C101, C201: 220n; C_0603_1608Metric
C108, C208: 2.2u 50V; C_1210_3225Metric
D1, D101, D201: SMBJ60A; D_SMB
D2: GREEN 12V; LED_0603_1608Metric
D3: GREEN 3V3; LED_0603_1608Metric
D4: GREEN RUN; LED_0603_1608Metric
D102, D202: GREEN ON; LED_0603_1608Metric
D103, D203: GREEN NODE; LED_0603_1608Metric
F1: 10A nano2; Fuse_Littelfuse-NANO2-451_453
F2: 1.5A; Fuse_1206_3216Metric
H1, H2, H3, H4: MountingHole_3.2mm_M3
J1: BUS 40-60V; TerminalBlock_Phoenix_MKDS-3-2-5.08_1x02_P5.08mm_Horizontal
J2: CTRL IN; JST_PH_B5B-PH-K_1x05_P2.00mm_Vertical
J3: CTRL OUT; JST_PH_B5B-PH-K_1x05_P2.00mm_Vertical
J4: 12V AUX OUT; JST_PH_B2B-PH-K_1x02_P2.00mm_Vertical
J5: SWD; Tag-Connect_TC2030-IDC-NL_2x03_P1.27mm_Vertical
J101, J201: NODE; Molex_Mini-Fit_Jr_5566-08A_2x04_P4.20mm_Vertical
JP1: ADR0; SolderJumper-2_P1.3mm_Open_RoundedPad1.0x1.5mm
JP2: ADR1; SolderJumper-2_P1.3mm_Open_RoundedPad1.0x1.5mm
JP3: ADR2; SolderJumper-2_P1.3mm_Open_RoundedPad1.0x1.5mm
L1: 33u; L_12x12mm_H6mm
L2: 68u; L_12x12mm_H6mm
Q1, Q102, Q103, Q104, Q202, Q203, Q204: 2N7002; SOT-23
Q101, Q201: BSC070N10NS5; TDSON-8-1
R1: 470k; R_0805_2012Metric
R2: 13k; R_0402_1005Metric
R3, R9: 1M; R_0805_2012Metric
R4, R10: 52.3k; R_0402_1005Metric
R5: 41.2k; R_0402_1005Metric
R6: 86.6k; R_0402_1005Metric
R7, R13: 49.9k; R_0402_1005Metric
R8, R12, R14: 453k; R_0402_1005Metric
R11, R15, R20, R21, R22, R30, R109, R110, R111, R112, R209, R210, R211, R212: 100k; R_0402_1005Metric
R16: 27k; R_0402_1005Metric
R17: 4.7k; R_0603_1608Metric
R18, R19: 1k; R_0402_1005Metric
R23, R24: 2.2k; R_0402_1005Metric
R25, R104, R106, R108, R113, R114, R115, R116, R204, R206, R208, R213, R214, R215, R216: 10k; R_0402_1005Metric
R26, R27, R28, R29: 4.7k; R_0402_1005Metric
R101, R102, R201, R202: 7m 2W; R_2512_6332Metric
R103, R203: 143k; R_0805_2012Metric
R105, R205: 240k; R_0805_2012Metric
R107, R207: 13.7k; R_0402_1005Metric
R117, R217: 47k; R_1206_3216Metric
R118, R218: 10k; R_0603_1608Metric
R119, R120, R219, R220: 270; R_0402_1005Metric
R121, R221: 220; R_0402_1005Metric
R122, R222: 47k; R_0402_1005Metric
U1, U2: LM5164DDA; HSOP-8-1EP_3.9x4.9mm_P1.27mm_EP2.41x3.1mm
U3: STM32G070CBT6; LQFP-48_7x7mm_P0.5mm
U4: ISO1640BD; SOIC-8_3.9x4.9mm_P1.27mm
U5: ISO7721D; SOIC-8_3.9x4.9mm_P1.27mm
U6: MCP23017-E/SO; SOIC-28W_7.5x17.9mm_P1.27mm
U101, U201: LM5069MM-2; MSOP-10_3x3mm_P0.5mm
U102, U202: INA238AIDGSR; TSSOP-10_3x3mm_P0.5mm
U103, U203: 74LVC1G74; VSSOP-8_2.3x2mm_P0.5mm
U104, U105, U204, U205: TLP176AM; SOIC-4_4.55x3.7mm_P2.54mm
U106, U206: TLP291; SOIC-4_4.55x2.6mm_P1.27mm
X101, X201: PM-19V-200W; Brick_Eighth_DOSA_Plane
X102, X202: J2 AUX; PinHeader_1x07_P1.27mm_Vertical
Y1: 8MHz; Crystal_SMD_3225-4Pin_3.2x2.5mm

Connections:
+3V3: C5.2, C9.1, C10.1, C18.1, C19.1, C20.1, C25.1, C27.1, C28.1, C103.1, C104.1, C203.1, C204.1, J5.1, L1.2, R6.1, R18.1, R20.1, R21.1, R22.1, R23.1, R24.1, R25.1, R26.1, R27.1, R108.1, R111.1, R113.1, R114.1, R115.1, R116.1, R122.1, R208.1, R211.1, R213.1, R214.1, R215.1, R216.1, R222.1, U3.4, U3.5, U3.6, U4.8, U5.8, U6.9, U6.18, U102.6, U103.8, U202.2, U202.6, U203.8
+12V: C12.2, C16.1, C17.1, F2.1, L2.2, R12.1, R15.1
/AUX_SNS: R15.2, R16.1, U3.20
/Bucks/BST1: C4.1, U1.7
/Bucks/BST2: C11.1, U2.7
/Bucks/EN1: R3.2, R4.1, U1.3
/Bucks/EN2: R9.2, R10.1, U2.3
/Bucks/FB1: C6.2, R6.2, R7.1, U1.5
/Bucks/FB2: C13.2, R12.2, R13.1, U2.5
/Bucks/INJ1: C5.1, C6.1, R8.2
/Bucks/INJ2: C12.1, C13.1, R14.2
/Bucks/LED12_A: D2.2, R17.2
/Bucks/LED33_A: D3.2, R18.2
/Bucks/RON1: R5.1, U1.4
/Bucks/RON2: R11.1, U2.4
/Bucks/SW1: C4.2, L1.1, R8.1, U1.8
/Bucks/SW2: C11.2, L2.1, R14.1, U2.8
/Bucks/V12_OUT: F2.2, J4.1, R17.1
/EXP_IRQ: R25.2, U3.44, U6.20
/INT_OUT: U3.28, U5.7
/Input/VBUS_IN: F1.1, J1.1
/Link/CTRL_INT: J2.5, J3.5, Q1.3
/Link/CTRL_SCL: J2.3, J3.3, R29.2, U4.3
/Link/CTRL_SDA: J2.4, J3.4, R28.2, U4.2
/Link/ISO_OUTA: Q1.1, R30.1, U5.2
/MCU/ADR0: JP1.1, R20.2, U3.1
/MCU/ADR1: JP2.1, R21.2, U3.2
/MCU/ADR2: JP3.1, R22.2, U3.3
/MCU/LEDRUN_A: D4.2, R19.2
/MCU/LED_RUN: R19.1, U3.47
/MCU/NRST: C21.1, J5.3, U3.10
/MCU/OSC_IN: C22.1, U3.8, Y1.1
/MCU/OSC_OUT: C23.1, U3.9, Y1.3
/MCU/SWCLK: J5.4, U3.36
/MCU/SWDIO: J5.2, U3.35
/S1_ID: C106.1, R115.2, U3.11, X102.3
/S1_LCLR: Q104.1, R112.1, U3.31
/S1_LED: R122.2, U6.26, U106.4
/S1_LQ: Q103.1, R110.1, U6.25, U103.5
/S1_OFF: Q102.1, R109.1, U3.30
/S1_PG: R114.2, U6.24, X102.2
/S1_PGD: R108.2, U6.23, U101.8
/S1_PWRD: R119.1, U6.21
/S1_RSTD: R120.1, U6.22
/S1_TEMP: C107.1, R116.2, U3.12, X102.4
/S2_ID: C206.1, R215.2, U3.13, X202.3
/S2_LCLR: Q204.1, R212.1, U3.39
/S2_LED: R222.2, U6.6, U206.4
/S2_LQ: Q203.1, R210.1, U6.5, U203.5
/S2_OFF: Q202.1, R209.1, U3.38
/S2_PG: R214.2, U6.4, X202.2
/S2_PGD: R208.2, U6.3, U201.8
/S2_PWRD: R219.1, U6.1
/S2_RSTD: R220.1, U6.2
/S2_TEMP: C207.1, R216.2, U3.14, X202.4
/SCL1: R27.2, U3.45, U4.6
/SCL2: R24.2, U3.22, U6.12, U102.5, U202.5, X102.7, X202.7
/SDA1: R26.2, U3.46, U4.7
/SDA2: R23.2, U3.23, U6.13, U102.4, U202.4, X102.6, X202.6
/Slot 1/CLRN: C105.1, Q104.3, R111.2, U103.6
/Slot 1/GATE: Q101.4, U101.10
/Slot 1/NL_A: D103.2, R118.2
/Slot 1/NODE: C108.1, J101.1, J101.2, R118.1, X101.8
/Slot 1/ONL_A: D102.2, R117.2
/Slot 1/OUT: C102.1, D101.2, Q101.1, Q101.2, Q101.3, R117.1, U101.9, U102.8, X101.1
/Slot 1/OVK: R113.2, U103.7, X102.1
/Slot 1/OVLO: R105.2, R106.1, U101.4
/Slot 1/PLED_A: R121.2, U106.1
/Slot 1/PLED_N: J101.8, U106.2
/Slot 1/PLED_P: J101.7, R121.1
/Slot 1/PWR: R107.1, U101.7
/Slot 1/PWRD_A: R119.2, U104.1
/Slot 1/PWR_SW: J101.5, U104.6
/Slot 1/RSTD_A: R120.2, U105.1
/Slot 1/RST_SW: J101.6, U105.6
/Slot 1/SENSE: Q101.5, R101.2, R102.2, U101.1, U102.9
/Slot 1/TIMER: C101.1, U101.6
/Slot 1/UVLO: Q102.3, Q103.3, R103.2, R104.1, U101.3
/Slot 2/CLRN: C205.1, Q204.3, R211.2, U203.6
/Slot 2/GATE: Q201.4, U201.10
/Slot 2/NL_A: D203.2, R218.2
/Slot 2/NODE: C208.1, J201.1, J201.2, R218.1, X201.8
/Slot 2/ONL_A: D202.2, R217.2
/Slot 2/OUT: C202.1, D201.2, Q201.1, Q201.2, Q201.3, R217.1, U201.9, U202.8, X201.1
/Slot 2/OVK: R213.2, U203.7, X202.1
/Slot 2/OVLO: R205.2, R206.1, U201.4
/Slot 2/PLED_A: R221.2, U206.1
/Slot 2/PLED_N: J201.8, U206.2
/Slot 2/PLED_P: J201.7, R221.1
/Slot 2/PWR: R207.1, U201.7
/Slot 2/PWRD_A: R219.2, U204.1
/Slot 2/PWR_SW: J201.5, U204.6
/Slot 2/RSTD_A: R220.2, U205.1
/Slot 2/RST_SW: J201.6, U205.6
/Slot 2/SENSE: Q201.5, R201.2, R202.2, U201.1, U202.9
/Slot 2/TIMER: C201.1, U201.6
/Slot 2/UVLO: Q202.3, Q203.3, R203.2, R204.1, U201.3
/VBUS_SNS: C3.1, R1.2, R2.1, U3.19
CTRL_3V3: C24.1, C26.1, J2.1, J3.1, R28.1, R29.1, U4.1, U5.1
CTRL_GND: C24.2, C26.2, J2.2, J3.2, Q1.2, R30.2, U4.4, U5.3, U5.4
GND: C1.2, C2.2, C3.2, C7.2, C8.2, C9.2, C10.2, C14.2, C15.2, C16.2, C17.2, C18.2, C19.2, C20.2, C21.2, C22.2, C23.2, C25.2, C27.2, C28.2, C101.2, C102.2, C103.2, C104.2, C105.2, C106.2, C107.2, C108.2, C201.2, C202.2, C203.2, C204.2, C205.2, C206.2, C207.2, C208.2, D1.1, D2.1, D3.1, D4.1, D101.1, D102.1, D103.1, D201.1, D202.1, D203.1, J1.2, J4.2, J5.5, J101.3, J101.4, J201.3, J201.4, JP1.2, JP2.2, JP3.2, Q102.2, Q103.2, Q104.2, Q202.2, Q203.2, Q204.2, R2.2, R4.2, R5.2, R7.2, R10.2, R11.2, R13.2, R16.2, R104.2, R106.2, R107.2, R109.2, R110.2, R112.2, R204.2, R206.2, R207.2, R209.2, R210.2, R212.2, U1.1, U1.9, U2.1, U2.9, U3.7, U4.5, U5.5, U6.10, U6.15, U6.16, U6.17, U101.5, U102.1, U102.2, U102.7, U103.1, U103.2, U103.4, U104.3, U104.4, U105.3, U105.4, U106.3, U201.5, U202.1, U202.7, U203.1, U203.2, U203.4, U204.3, U204.4, U205.3, U205.4, U206.3, X101.3, X101.4, X102.5, X201.3, X201.4, X202.5, Y1.2, Y1.4
VBUS: C1.1, C2.1, C7.1, C8.1, C14.1, C15.1, D1.2, F1.2, R1.1, R3.1, R9.1, R101.1, R102.1, R103.1, R105.1, R201.1, R202.1, R203.1, R205.1, U1.2, U2.2, U101.2, U102.10, U201.2, U202.10
