delandtj/granite_controller/granite_controller.kicad_pcb

## KiCad design granite_controller.kicad_pcb (2026-10-09)

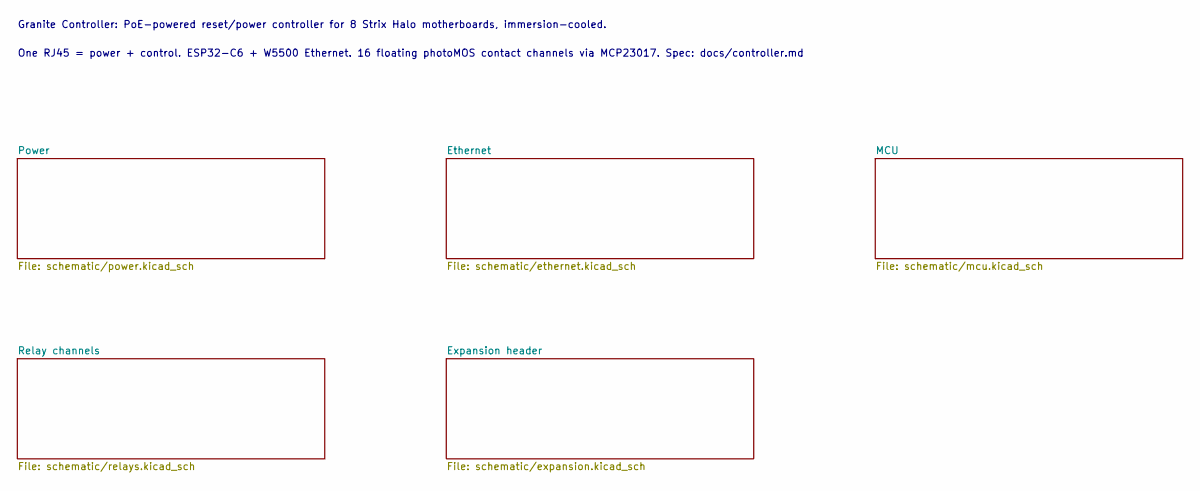
[picture p43: schematic granite_controller.kicad_sch, Granite Controller - MCU and USB]

Notes on the sheet:
Granite Controller: PoE-powered reset/power controller for 8 Strix Halo motherboards, immersion-cooled.
One RJ45 = power + control. ESP32-C6 + W5500 Ethernet. 16 floating photoMOS contact channels via MCP23017. Spec: docs/controller.md
