delandtj/granite_controller/granite_controller.kicad_pcb

## KiCad design granite_controller.kicad_pcb (continued)

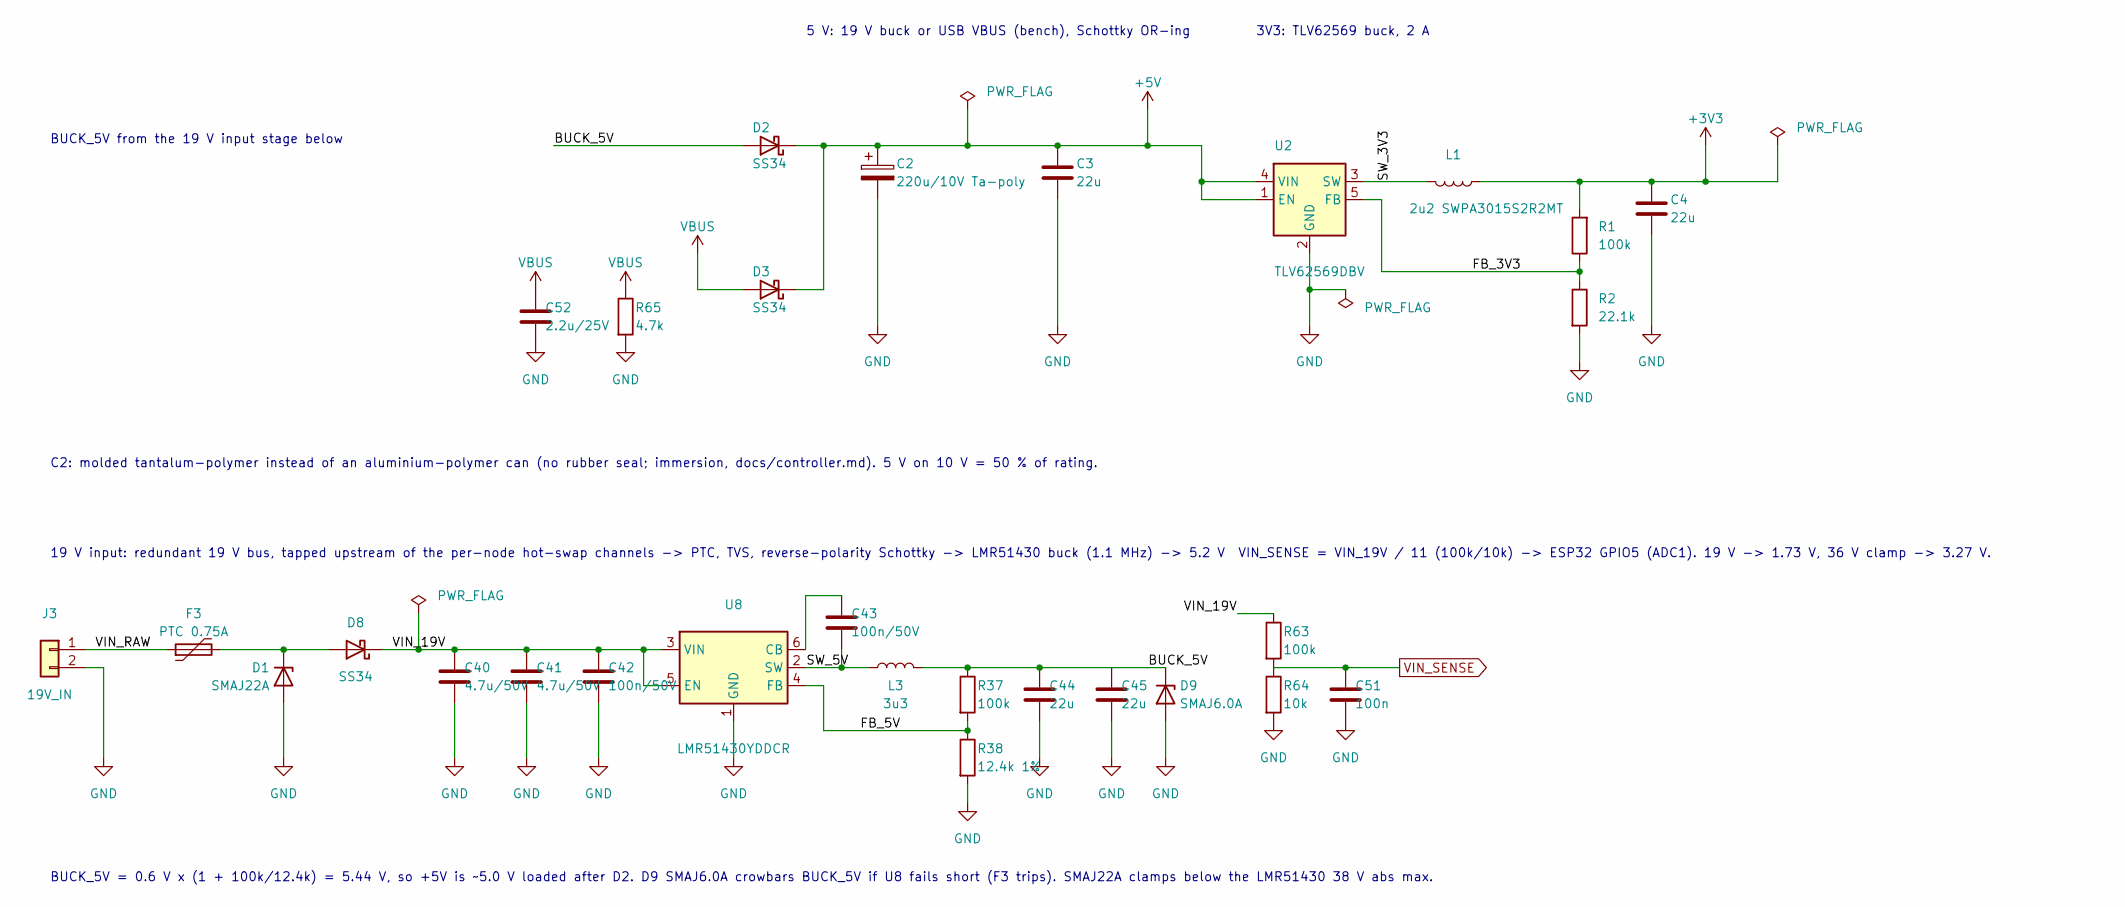
[picture p44: schematic power.kicad_sch, Granite Controller - Power]

Parts:
C2: 220u/10V Ta-poly; CP_EIA-7343-31_Kemet-D; MPN T520D227M010ATE018; LCSC C116742
C3, C4, C44, C45: 22u; C_0805_2012Metric; MPN CL21A226MAQNNNE; LCSC C45783
C40, C41: 4.7u/50V; C_1206_3216Metric; MPN 1206B475K500NT; LCSC C29823
C42, C43: 100n/50V; C_0402_1005Metric; MPN CL05B104KB54PNC; LCSC C307331
C51: 100n; C_0402_1005Metric; MPN CL05B104KO5NNNC; LCSC C1525
C52: 2.2u/25V; C_0603_1608Metric; MPN CL10A225KA8NNNC; LCSC C57895
D1: SMAJ22A; D_SMA; MPN SMAJ22A; LCSC C41376403
D2, D3, D8: SS34; D_SMA; MPN SS34; LCSC C8678
D9: SMAJ6.0A; D_SMA; MPN SMAJ6.0A; LCSC C364284
F3: PTC 0.75A; Fuse_1206_3216Metric; MPN 1206L075/33NR; LCSC C49196637
J3: 19V_IN; JST_PH_B2B-PH-K_1x02_P2.00mm_Vertical; MPN B2B-PH-K-S(LF)(SN); LCSC C131337
L1: 2u2 SWPA3015S2R2MT; L_Sunlord_SWPA3015S; MPN SWPA3015S2R2MT; LCSC C43389
L3: 3u3; L_Changjiang_FXL0630; MPN FXL0630-3R3-M; LCSC C167219
R1, R37, R63: 100k; R_0402_1005Metric; MPN 0402WGF1003TCE; LCSC C25741
R2: 22.1k; R_0402_1005Metric; MPN RC0402FR-0722K1L; LCSC C163478
R38: 12.4k 1%; R_0402_1005Metric; MPN 0402WGF1242TCE; LCSC C11692
R64: 10k; R_0402_1005Metric; MPN 0402WGF1002TCE; LCSC C25744
R65: 4.7k; R_0402_1005Metric; MPN 0402WGF4701TCE; LCSC C25900
U2: TLV62569DBV; SOT-23-5; MPN TLV62569DBVR; LCSC C141836
U8: LMR51430YDDCR; SOT-23-6; MPN LMR51430YDDCR; LCSC C5210749

Connections:
+3V3: C4.1, L1.1, R1.2; also elsewhere on the board
+5V: C2.1, C3.1, D2.1 (K), D3.1 (K), U2.1 (EN), U2.4 (VIN); also elsewhere on the board
/Power/BUCK_5V: C44.1, C45.1, D2.2 (A), D9.1 (K), L3.2, R37.1
/Power/FB_3V3: R1.1, R2.1, U2.5 (FB)
/Power/FB_5V: R37.2, R38.1, U8.4 (FB)
/Power/SW_3V3: L1.2, U2.3 (SW)
/Power/SW_5V: C43.2, L3.1, U8.2 (SW)
/Power/VIN_19V: C40.1, C41.1, C42.1, D8.1 (K), R63.1, U8.3 (VIN), U8.5 (EN)
/Power/VIN_RAW: F3.1, J3.1
GND: C2.2, C3.2, C4.2, C40.2, C41.2, C42.2, C44.2, C45.2, C51.2, C52.2, D1.2 (A), D9.2 (A), J3.2, R2.2, R38.2, R64.2, R65.2, U2.2 (GND), U8.1 (GND); also elsewhere on the board
unnamed: D1.1 (K), D8.2 (A), F3.2
unnamed: C43.1, U8.6 (CB)
VBUS: C52.1, D3.2 (A), R65.1; also elsewhere on the board
VIN_SENSE: C51.1, R63.2, R64.1; also elsewhere on the board

Notes on the sheet:
5 V: 19 V buck or USB VBUS (bench), Schottky OR-ing
3V3: TLV62569 buck, 2 A
BUCK_5V from the 19 V input stage below
19 V input: redundant 19 V bus, tapped upstream of the per-node hot-swap channels -> PTC, TVS, reverse-polarity Schottky -> LMR51430 buck (1.1 MHz) -> 5.2 V
BUCK_5V = 0.6 V x (1 + 100k/12.4k) = 5.44 V, so +5V is ~5.0 V loaded after D2. D9 SMAJ6.0A crowbars BUCK_5V if U8 fails short (F3 trips). SMAJ22A clamps below the LMR51430 38 V abs max.
C2: molded tantalum-polymer instead of an aluminium-polymer can (no rubber seal; immersion, docs/controller.md). 5 V on 10 V = 50 % of rating.
VIN_SENSE = VIN_19V / 11 (100k/10k) -> ESP32 GPIO5 (ADC1). 19 V -> 1.73 V, 36 V clamp -> 3.27 V.

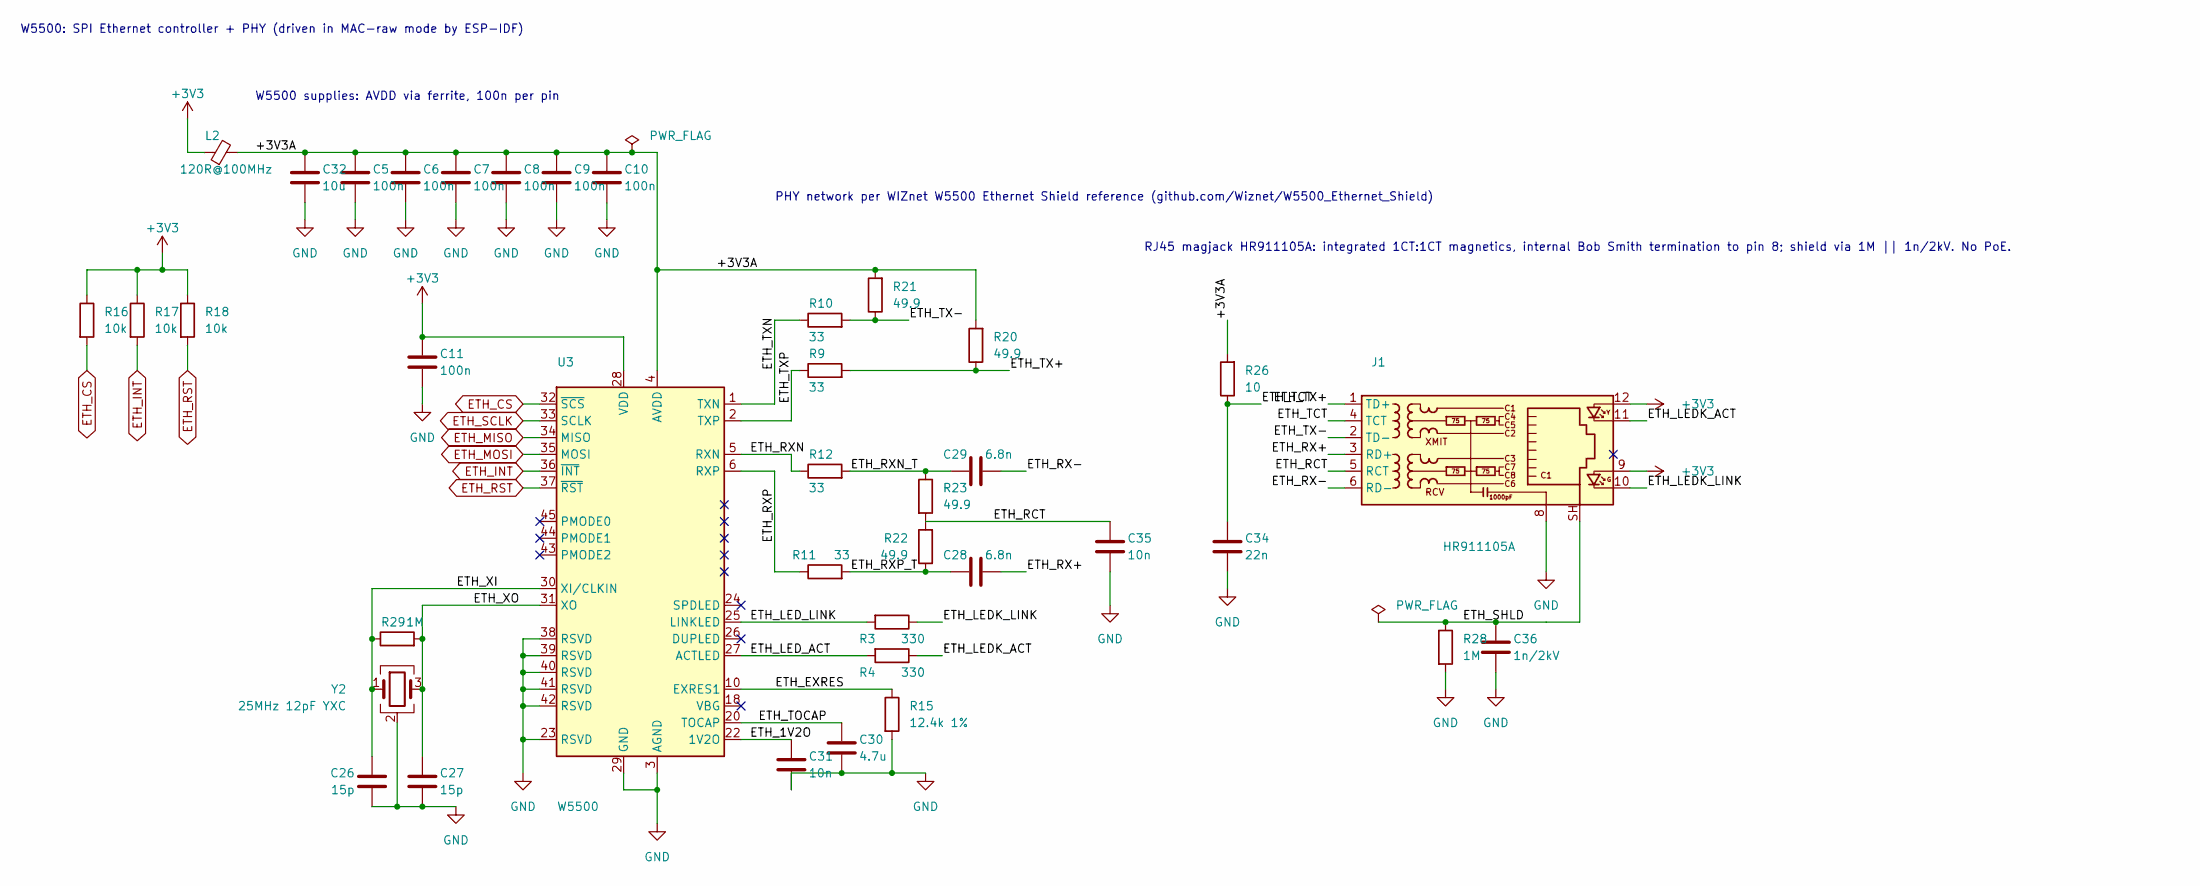
[picture p45: schematic ethernet.kicad_sch, Granite Controller - Ethernet]

Parts:
C5, C6, C7, C8, C9, C10, C11: 100n; C_0402_1005Metric; MPN CL05B104KO5NNNC; LCSC C1525
C26, C27: 15p; C_0402_1005Metric; MPN 0402CG150J500NT; LCSC C1548
C28, C29: 6.8n; C_0402_1005Metric; MPN CC0402KRX7R9BB682; LCSC C93654
C30: 4.7u; C_0603_1608Metric; MPN CL10A475KO8NNNC; LCSC C19666
C31, C35: 10n; C_0402_1005Metric; MPN CL05B103KB5NNNC; LCSC C15195
C32: 10u; C_0805_2012Metric; MPN CL21A106KAYNNNE; LCSC C15850
C34: 22n; C_0402_1005Metric; MPN 0402B223K500NT; LCSC C1532
C36: 1n/2kV; C_1812_4532Metric; MPN CC1812KKX7RDBB102; LCSC C118019
J1: HR911105A; RJ45_Hanrun_HR911105A_Horizontal; MPN HR911105A; LCSC C12074
L2: 120R@100MHz; L_0603_1608Metric; MPN BLM18PG121SN1D; LCSC C14709
R3, R4: 330; R_0402_1005Metric; MPN 0402WGF3300TCE; LCSC C25104
R9, R10, R11, R12: 33; R_0402_1005Metric; MPN 0402WGF330JTCE; LCSC C25105
R15: 12.4k 1%; R_0402_1005Metric; MPN 0402WGF1242TCE; LCSC C11692
R16, R17, R18: 10k; R_0402_1005Metric; MPN 0402WGF1002TCE; LCSC C25744
R20, R21, R22, R23: 49.9; R_0402_1005Metric; MPN 0402WGF499JTCE; LCSC C25120
R26: 10; R_0402_1005Metric; MPN 0402WGF100JTCE; LCSC C25077
R28: 1M; R_0603_1608Metric; MPN 0603WAF1004T5E; LCSC C22935
R29: 1M; R_0402_1005Metric; MPN 0402WGF1004TCE; LCSC C26083
U3: W5500; LQFP-48_7x7mm_P0.5mm; MPN W5500; LCSC C32843
Y2: 25MHz 12pF YXC; Crystal_SMD_Abracon_ABM8G-4Pin_3.2x2.5mm; MPN X322525MOB4SI; LCSC C9006

Connections:
+3V3: C11.1, J1.9, J1.12, L2.1, R16.1, R17.1, R18.1, U3.28 (VDD); also elsewhere on the board
/Ethernet/+3V3A: C5.1, C6.1, C7.1, C8.1, C9.1, C10.1, C32.1, L2.2, R20.2, R21.2, R26.2, U3.4 (AVDD), U3.8 (AVDD), U3.11 (AVDD), U3.15 (AVDD), U3.17 (AVDD), U3.21 (AVDD)
/Ethernet/ETH_1V2O: C31.1, U3.22 (1V2O)
/Ethernet/ETH_EXRES: R15.1, U3.10 (EXRES1)
/Ethernet/ETH_LEDK_ACT: J1.11, R4.1
/Ethernet/ETH_LEDK_LINK: J1.10, R3.1
/Ethernet/ETH_LED_ACT: R4.2, U3.27 (ACTLED)
/Ethernet/ETH_LED_LINK: R3.2, U3.25 (LINKLED)
/Ethernet/ETH_RCT: C35.1, J1.5 (RCT), R22.2, R23.2
/Ethernet/ETH_RX+: C28.2, J1.3 (RD+)
/Ethernet/ETH_RX-: C29.2, J1.6 (RD-)
/Ethernet/ETH_RXN: R12.1, U3.5 (RXN)
/Ethernet/ETH_RXN_T: C29.1, R12.2, R23.1
/Ethernet/ETH_RXP: R11.1, U3.6 (RXP)
/Ethernet/ETH_RXP_T: C28.1, R11.2, R22.1
/Ethernet/ETH_SHLD: C36.1, J1.SH, R28.1
/Ethernet/ETH_TCT: C34.1, J1.4 (TCT), R26.1
/Ethernet/ETH_TOCAP: C30.1, U3.20 (TOCAP)
/Ethernet/ETH_TX+: J1.1 (TD+), R9.2, R20.1
/Ethernet/ETH_TX-: J1.2 (TD-), R10.2, R21.1
/Ethernet/ETH_TXN: R10.1, U3.1 (TXN)
/Ethernet/ETH_TXP: R9.1, U3.2 (TXP)
/Ethernet/ETH_XI: C26.1, R29.1, U3.30 (XI/CLKIN), Y2.1
/Ethernet/ETH_XO: C27.1, R29.2, U3.31 (XO), Y2.3
ETH_CS: R16.2, U3.32 (~SCS); also elsewhere on the board
ETH_INT: R17.2, U3.36 (~INT); also elsewhere on the board
ETH_MISO: U3.34 (MISO); also elsewhere on the board
ETH_MOSI: U3.35 (MOSI); also elsewhere on the board
ETH_RST: R18.2, U3.37 (~RST); also elsewhere on the board
ETH_SCLK: U3.33 (SCLK); also elsewhere on the board
GND: C5.2, C6.2, C7.2, C8.2, C9.2, C10.2, C11.2, C26.2, C27.2, C30.2, C31.2, C32.2, C34.2, C35.2, C36.2, J1.8, R15.2, R28.2, U3.3 (AGND), U3.9 (AGND), U3.14 (AGND), U3.16 (AGND), U3.19 (AGND), U3.23 (RSVD), U3.29 (GND), U3.38 (RSVD), U3.39 (RSVD), U3.40 (RSVD), U3.41 (RSVD), U3.42 (RSVD), U3.48 (AGND), Y2.2 (G), Y2.4 (G); also elsewhere on the board

Notes on the sheet:
W5500: SPI Ethernet controller + PHY (driven in MAC-raw mode by ESP-IDF)
W5500 supplies: AVDD via ferrite, 100n per pin
PHY network per WIZnet W5500 Ethernet Shield reference (github.com/Wiznet/W5500_Ethernet_Shield)
RJ45 magjack HR911105A: integrated 1CT:1CT magnetics, internal Bob Smith termination to pin 8; shield via 1M || 1n/2kV. No PoE.

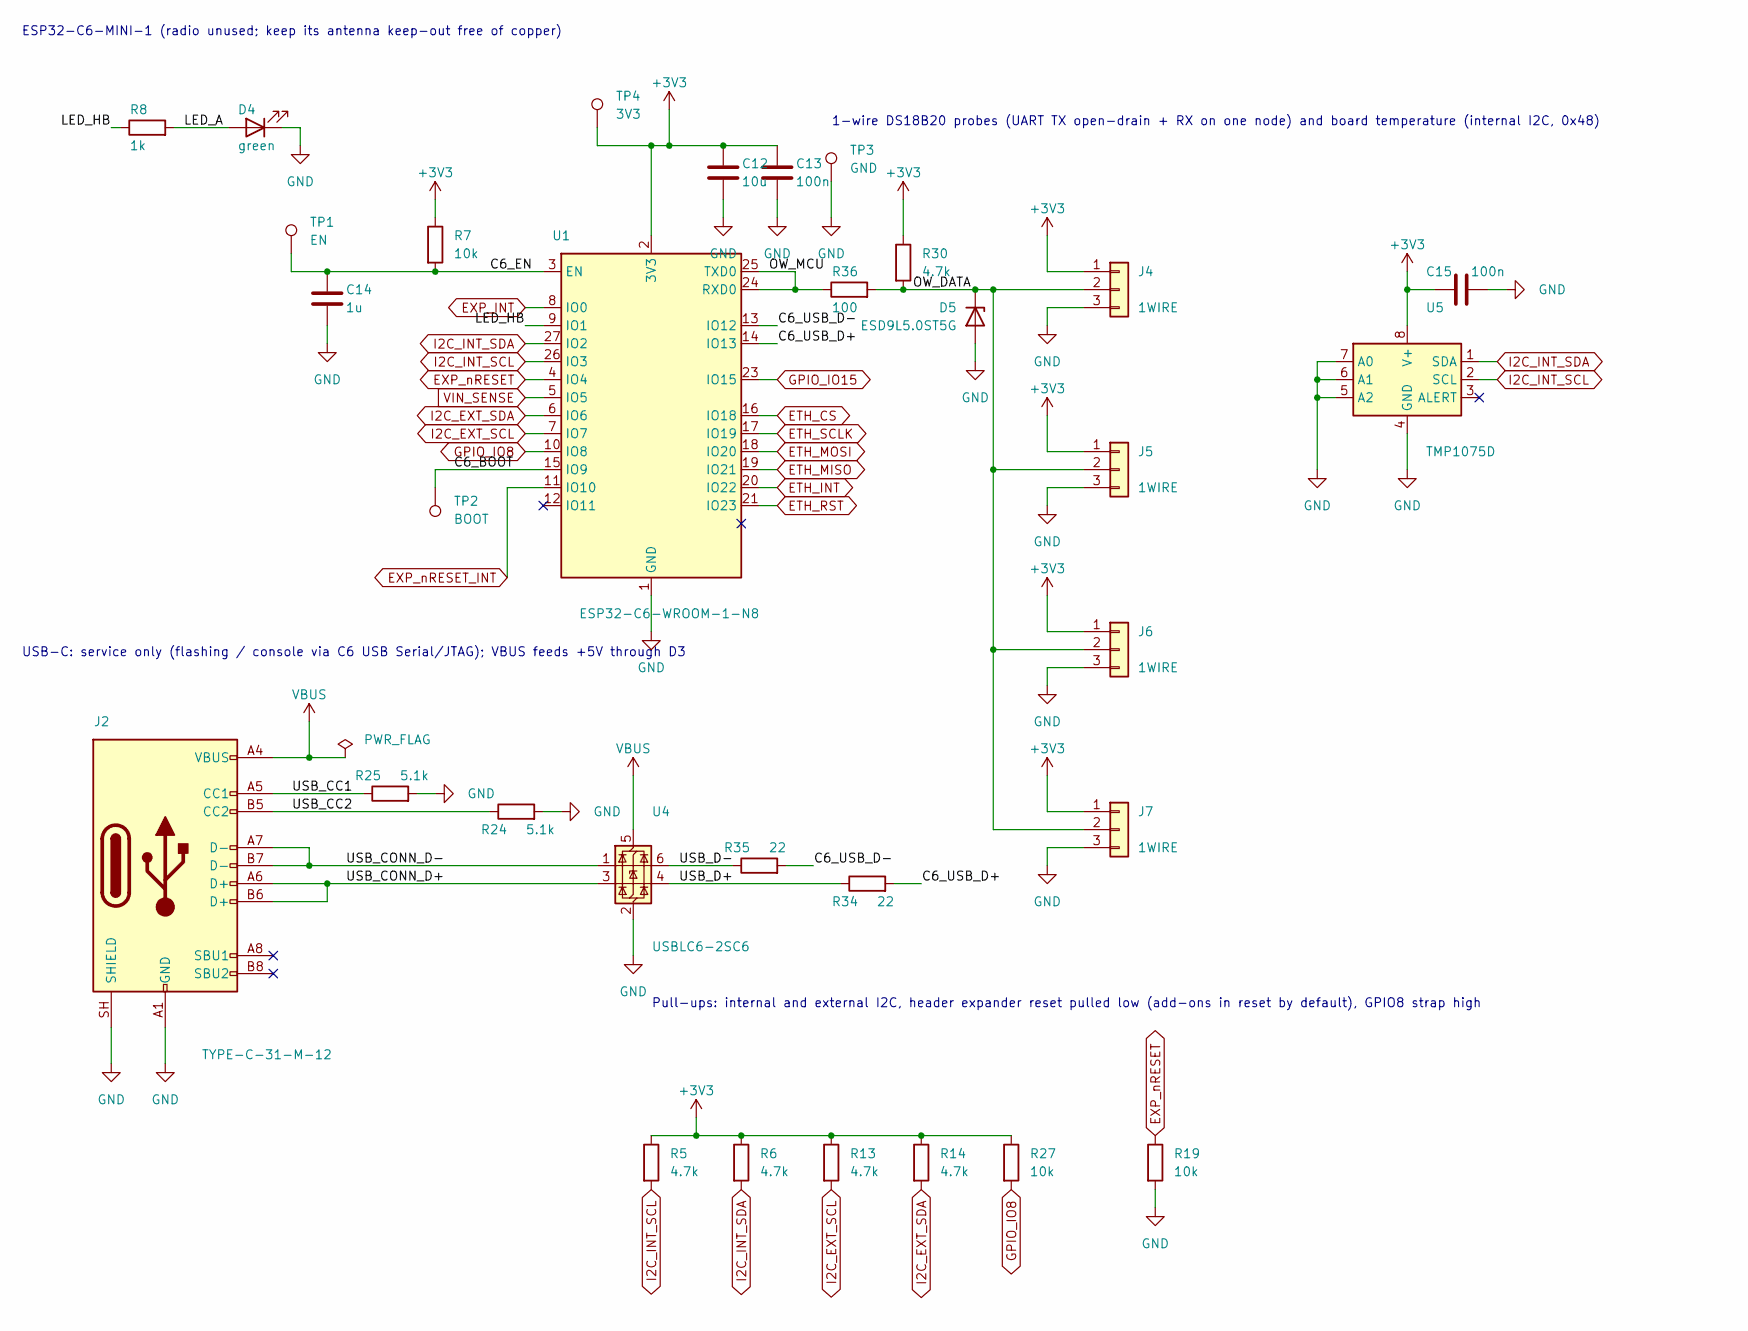
[picture p46: schematic mcu.kicad_sch, Granite Controller - MCU]

Parts:
C12: 10u; C_0805_2012Metric; MPN CL21A106KAYNNNE; LCSC C15850
C13, C15: 100n; C_0402_1005Metric; MPN CL05B104KO5NNNC; LCSC C1525
C14: 1u; C_0603_1608Metric; MPN CL10A105KB8NNNC; LCSC C15849
D4: green; LED_0603_1608Metric; MPN APT1608LZGCK; LCSC C5246833
D5: ESD9L5.0ST5G; D_SOD-923; MPN ESD9L5.0ST5G; LCSC C82326
J2: TYPE-C-31-M-12; USB_C_Receptacle_HRO_TYPE-C-31-M-12; MPN TYPE-C-31-M-12; LCSC C165948
J4, J5, J6, J7: 1WIRE; JST_PH_B3B-PH-K_1x03_P2.00mm_Vertical; MPN B3B-PH-K-S(LF)(SN); LCSC C131339
R5, R6, R13, R14, R30: 4.7k; R_0402_1005Metric; MPN 0402WGF4701TCE; LCSC C25900
R7, R19, R27: 10k; R_0402_1005Metric; MPN 0402WGF1002TCE; LCSC C25744
R8: 1k; R_0402_1005Metric; MPN 0402WGF1001TCE; LCSC C11702
R24, R25: 5.1k; R_0402_1005Metric; MPN 0402WGF5101TCE; LCSC C25905
R34, R35: 22; R_0402_1005Metric; MPN 0402WGF220JTCE; LCSC C25092
R36: 100; R_0603_1608Metric; MPN 0603WAF1000T5E; LCSC C22775
TP1: EN; TestPoint_Pad_D1.5mm
TP2: BOOT; TestPoint_Pad_D1.5mm
TP3: GND; TestPoint_Pad_D1.5mm
TP4: 3V3; TestPoint_Pad_D1.5mm
U1: ESP32-C6-WROOM-1-N8; ESP32-C6-WROOM-1; MPN ESP32-C6-WROOM-1-N8; LCSC C5366877
U4: USBLC6-2SC6; SOT-23-6; MPN USBLC6-2SC6; LCSC C7519
U5: TMP1075D; SOIC-8_3.9x4.9mm_P1.27mm; MPN TMP1075DR; LCSC C2878381

Connections:
+3V3: C12.1, C13.1, C15.1, J4.1, J5.1, J6.1, J7.1, R5.1, R6.1, R7.1, R13.1, R14.1, R27.1, R30.1, TP4.1, U1.2 (3V3), U5.8 (V+); also elsewhere on the board
/MCU/C6_BOOT: TP2.1, U1.15 (IO9)
/MCU/C6_EN: C14.1, R7.2, TP1.1, U1.3 (EN)
/MCU/C6_USB_D+: R34.2, U1.14 (IO13)
/MCU/C6_USB_D-: R35.2, U1.13 (IO12)
/MCU/LED_A: D4.2 (A), R8.2
/MCU/LED_HB: R8.1, U1.9 (IO1)
/MCU/OW_DATA: D5.1 (K), J4.2, J5.2, J6.2, J7.2, R30.2, R36.2
/MCU/OW_MCU: R36.1, U1.24 (RXD0), U1.25 (TXD0)
/MCU/USB_CC1: J2.A5 (CC1), R25.1
/MCU/USB_CC2: J2.B5 (CC2), R24.1
/MCU/USB_CONN_D+: J2.A6 (D+), J2.B6 (D+), U4.3 (I/O2)
/MCU/USB_CONN_D-: J2.A7 (D-), J2.B7 (D-), U4.1 (I/O1)
/MCU/USB_D+: R34.1, U4.4 (I/O2)
/MCU/USB_D-: R35.1, U4.6 (I/O1)
ETH_CS: U1.16 (IO18); also elsewhere on the board
ETH_INT: U1.20 (IO22); also elsewhere on the board
ETH_MISO: U1.19 (IO21); also elsewhere on the board
ETH_MOSI: U1.18 (IO20); also elsewhere on the board
ETH_RST: U1.21 (IO23); also elsewhere on the board
ETH_SCLK: U1.17 (IO19); also elsewhere on the board
EXP_INT: U1.8 (IO0); also elsewhere on the board
EXP_nRESET: R19.1, U1.4 (IO4); also elsewhere on the board
EXP_nRESET_INT: U1.11 (IO10); also elsewhere on the board
GND: C12.2, C13.2, C14.2, C15.2, D4.1 (K), D5.2 (A), J2.A1 (GND), J2.A12 (GND), J2.B1 (GND), J2.B12 (GND), J2.SH (SHIELD), J4.3, J5.3, J6.3, J7.3, R19.2, R24.2, R25.2, TP3.1, U1.1 (GND), U1.28 (GND), U1.29 (GND), U4.2 (GND), U5.4 (GND), U5.5 (A2), U5.6 (A1), U5.7 (A0); also elsewhere on the board
GPIO_IO8: R27.2, U1.10 (IO8); also elsewhere on the board
GPIO_IO15: U1.23 (IO15); also elsewhere on the board
I2C_EXT_SCL: R13.2, U1.7 (IO7); also elsewhere on the board
I2C_EXT_SDA: R14.2, U1.6 (IO6); also elsewhere on the board
I2C_INT_SCL: R5.2, U1.26 (IO3), U5.2 (SCL); also elsewhere on the board
I2C_INT_SDA: R6.2, U1.27 (IO2), U5.1 (SDA); also elsewhere on the board
VBUS: J2.A4 (VBUS), J2.A9 (VBUS), J2.B4 (VBUS), J2.B9 (VBUS), U4.5 (VBUS); also elsewhere on the board
VIN_SENSE: U1.5 (IO5); also elsewhere on the board

Notes on the sheet:
ESP32-C6-MINI-1 (radio unused; keep its antenna keep-out free of copper)
1-wire DS18B20 probes (UART TX open-drain + RX on one node) and board temperature (internal I2C, 0x48)
USB-C: service only (flashing / console via C6 USB Serial/JTAG); VBUS feeds +5V through D3
Pull-ups: internal and external I2C, header expander reset pulled low (add-ons in reset by default), GPIO8 strap high

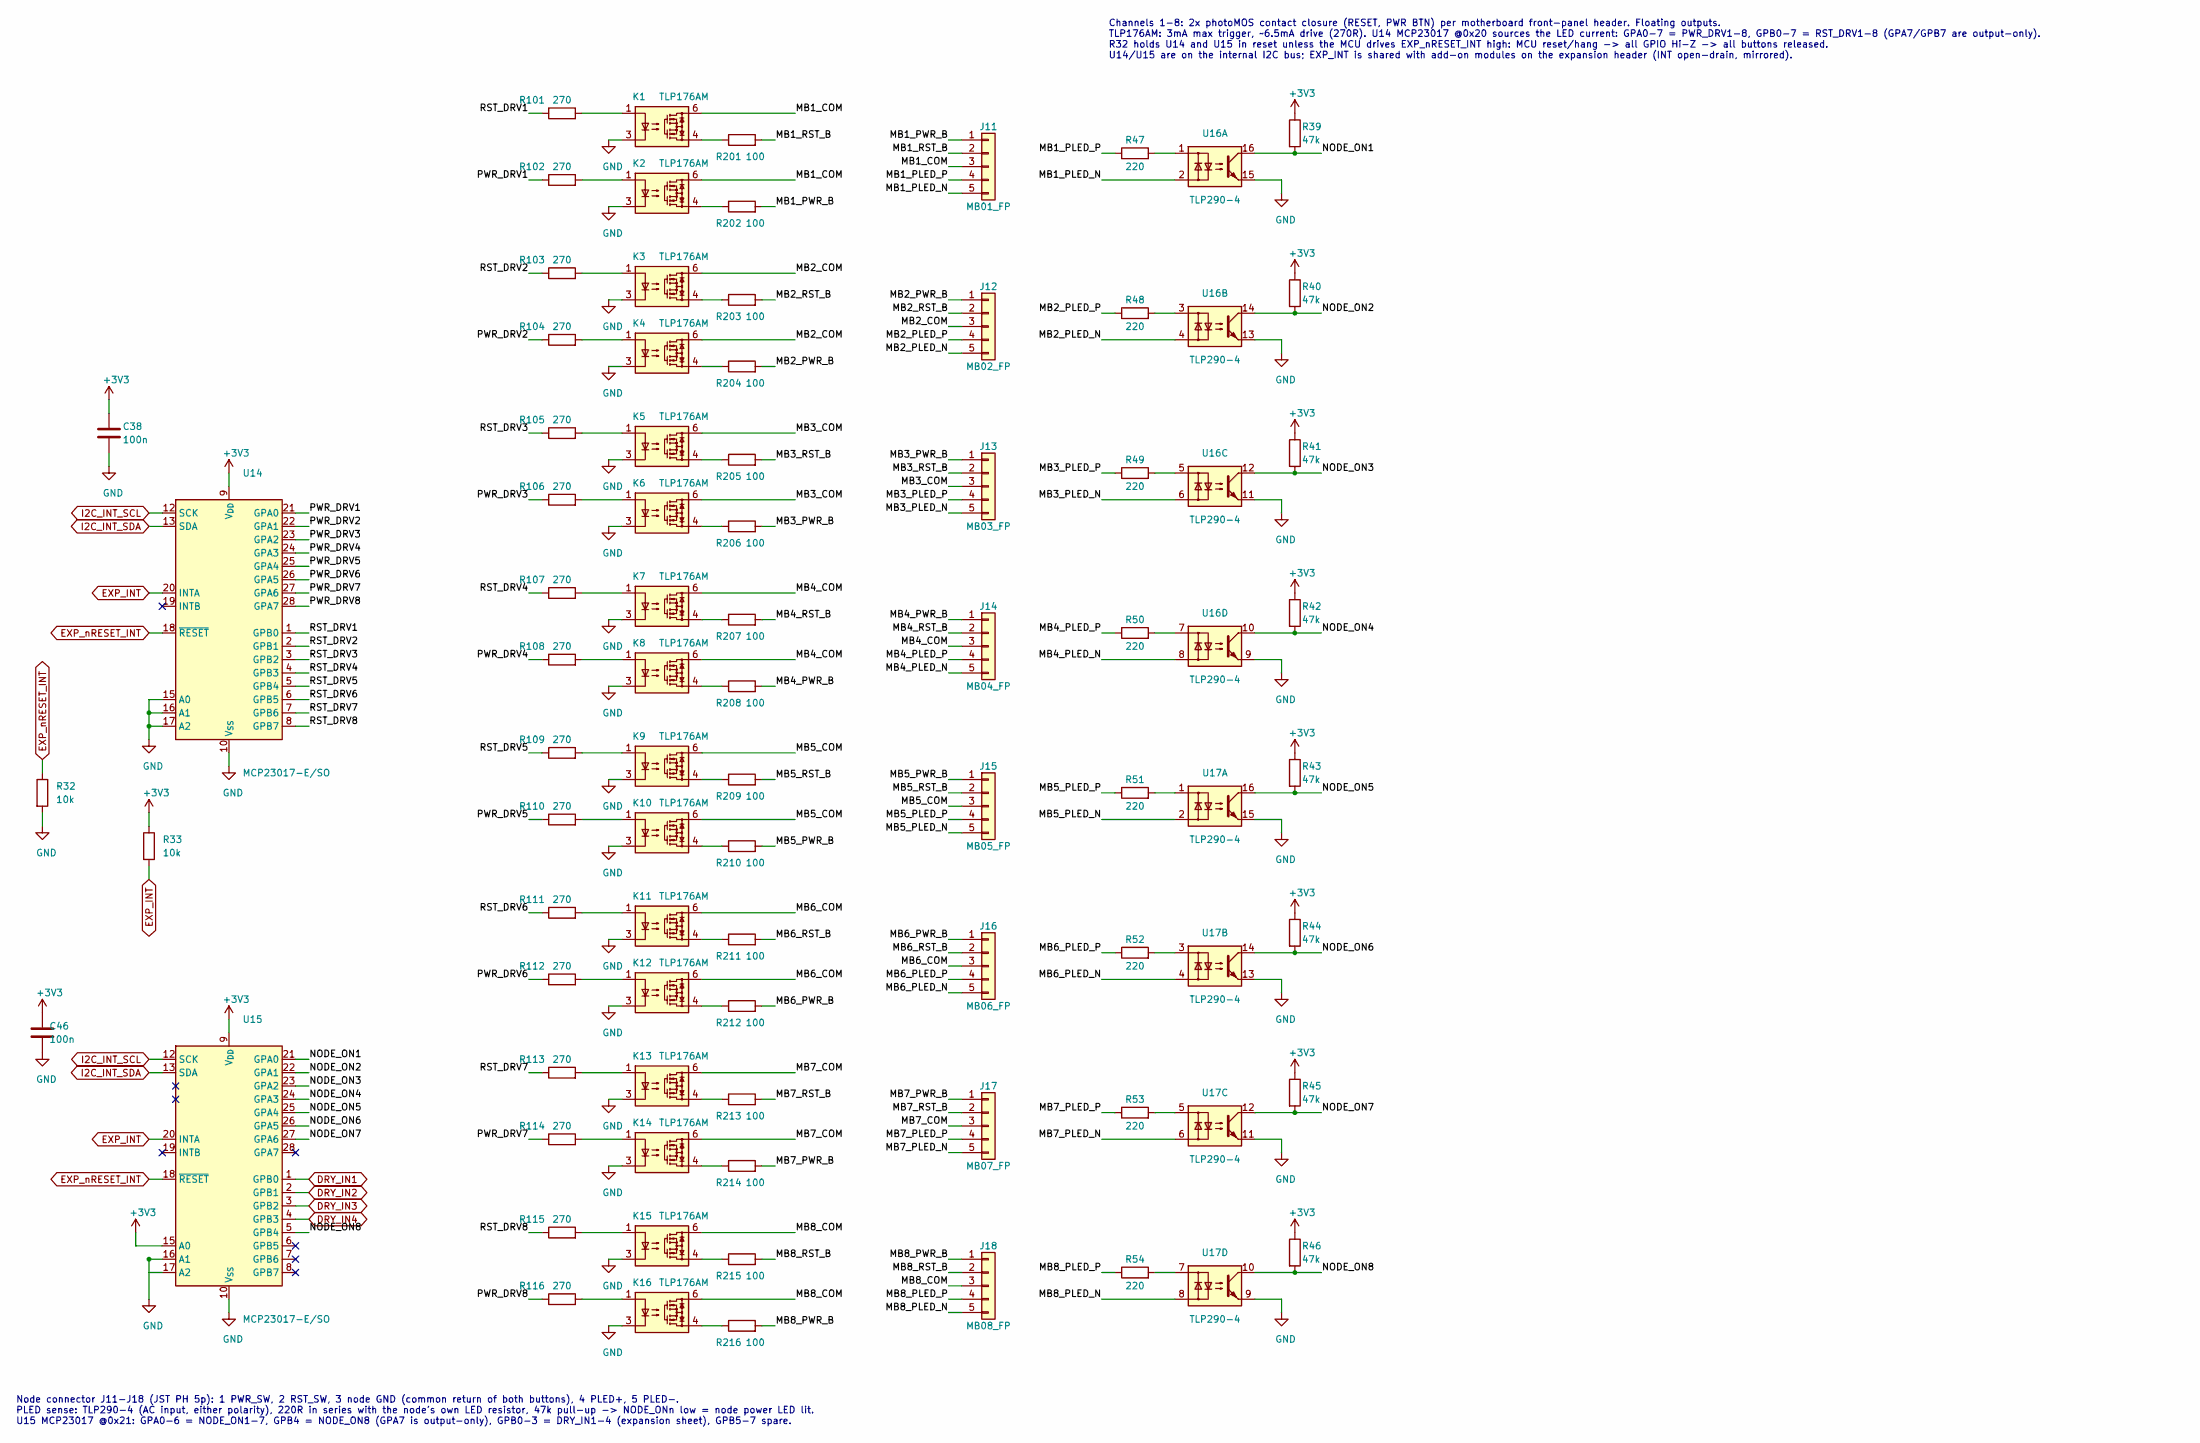
[picture p47: schematic relays.kicad_sch, Granite Controller - Relay channels]

Parts:
C38, C46: 100n; C_0402_1005Metric; MPN CL05B104KO5NNNC; LCSC C1525
J11: MB01_FP; JST_PH_B5B-PH-K_1x05_P2.00mm_Vertical; MPN B5B-PH-K-S(LF)(SN); LCSC C157993
J12: MB02_FP; JST_PH_B5B-PH-K_1x05_P2.00mm_Vertical; MPN B5B-PH-K-S(LF)(SN); LCSC C157993
J13: MB03_FP; JST_PH_B5B-PH-K_1x05_P2.00mm_Vertical; MPN B5B-PH-K-S(LF)(SN); LCSC C157993
J14: MB04_FP; JST_PH_B5B-PH-K_1x05_P2.00mm_Vertical; MPN B5B-PH-K-S(LF)(SN); LCSC C157993
J15: MB05_FP; JST_PH_B5B-PH-K_1x05_P2.00mm_Vertical; MPN B5B-PH-K-S(LF)(SN); LCSC C157993
J16: MB06_FP; JST_PH_B5B-PH-K_1x05_P2.00mm_Vertical; MPN B5B-PH-K-S(LF)(SN); LCSC C157993
J17: MB07_FP; JST_PH_B5B-PH-K_1x05_P2.00mm_Vertical; MPN B5B-PH-K-S(LF)(SN); LCSC C157993
J18: MB08_FP; JST_PH_B5B-PH-K_1x05_P2.00mm_Vertical; MPN B5B-PH-K-S(LF)(SN); LCSC C157993
K1, K2, K3, K4, K5, K6, K7, K8, K9, K10, K11, K12, K13, K14, K15, K16: TLP176AM; SOIC-4_4.55x3.7mm_P2.54mm; MPN TLP176AM(TPL,E); LCSC C5370540
R32, R33: 10k; R_0402_1005Metric; MPN 0402WGF1002TCE; LCSC C25744
R39, R40, R41, R42, R43, R44, R45, R46: 47k; R_0402_1005Metric; MPN 0402WGF4702TCE; LCSC C25792
R47, R48, R49, R50, R51, R52, R53, R54: 220; R_0402_1005Metric; MPN 0402WGF2200TCE; LCSC C25091
R101, R102, R103, R104, R105, R106, R107, R108, R109, R110, R111, R112, R113, R114, R115, R116: 270; R_0402_1005Metric; MPN FRC0402F2700TS; LCSC C2909342
R201, R202, R203, R204, R205, R206, R207, R208, R209, R210, R211, R212, R213, R214, R215, R216: 100; R_0603_1608Metric; MPN 0603WAF1000T5E; LCSC C22775
U14, U15: MCP23017-E/SO; SOIC-28W_7.5x17.9mm_P1.27mm; MPN MCP23017-E/SO; LCSC C47023
U16, U17: TLP290-4; SOP-16_4.55x10.3mm_P1.27mm; MPN TLP290-4(GB-TP,E); LCSC C39031

Connections:
+3V3: C38.1, C46.1, R33.1, R39.1, R40.1, R41.1, R42.1, R43.1, R44.1, R45.1, R46.1, U14.9 (V_{DD}), U15.9 (V_{DD}), U15.15 (A0); also elsewhere on the board
/Relay channels/MB1_COM: J11.3, K1.6, K2.6
/Relay channels/MB1_PLED_N: J11.5, U16.2
/Relay channels/MB1_PLED_P: J11.4, R47.1
/Relay channels/MB1_PWR_B: J11.1, R202.2
/Relay channels/MB1_RST_B: J11.2, R201.2
/Relay channels/MB2_COM: J12.3, K3.6, K4.6
/Relay channels/MB2_PLED_N: J12.5, U16.4
/Relay channels/MB2_PLED_P: J12.4, R48.1
/Relay channels/MB2_PWR_B: J12.1, R204.2
/Relay channels/MB2_RST_B: J12.2, R203.2
/Relay channels/MB3_COM: J13.3, K5.6, K6.6
/Relay channels/MB3_PLED_N: J13.5, U16.6
/Relay channels/MB3_PLED_P: J13.4, R49.1
/Relay channels/MB3_PWR_B: J13.1, R206.2
/Relay channels/MB3_RST_B: J13.2, R205.2
/Relay channels/MB4_COM: J14.3, K7.6, K8.6
/Relay channels/MB4_PLED_N: J14.5, U16.8
/Relay channels/MB4_PLED_P: J14.4, R50.1
/Relay channels/MB4_PWR_B: J14.1, R208.2
/Relay channels/MB4_RST_B: J14.2, R207.2
/Relay channels/MB5_COM: J15.3, K9.6, K10.6
/Relay channels/MB5_PLED_N: J15.5, U17.2
/Relay channels/MB5_PLED_P: J15.4, R51.1
/Relay channels/MB5_PWR_B: J15.1, R210.2
/Relay channels/MB5_RST_B: J15.2, R209.2
/Relay channels/MB6_COM: J16.3, K11.6, K12.6
/Relay channels/MB6_PLED_N: J16.5, U17.4
/Relay channels/MB6_PLED_P: J16.4, R52.1
/Relay channels/MB6_PWR_B: J16.1, R212.2
/Relay channels/MB6_RST_B: J16.2, R211.2
/Relay channels/MB7_COM: J17.3, K13.6, K14.6
/Relay channels/MB7_PLED_N: J17.5, U17.6
/Relay channels/MB7_PLED_P: J17.4, R53.1
/Relay channels/MB7_PWR_B: J17.1, R214.2
/Relay channels/MB7_RST_B: J17.2, R213.2
/Relay channels/MB8_COM: J18.3, K15.6, K16.6
/Relay channels/MB8_PLED_N: J18.5, U17.8
/Relay channels/MB8_PLED_P: J18.4, R54.1
/Relay channels/MB8_PWR_B: J18.1, R216.2
/Relay channels/MB8_RST_B: J18.2, R215.2
/Relay channels/NODE_ON1: R39.2, U15.21 (GPA0), U16.16
/Relay channels/NODE_ON2: R40.2, U15.22 (GPA1), U16.14
/Relay channels/NODE_ON3: R41.2, U15.23 (GPA2), U16.12
/Relay channels/NODE_ON4: R42.2, U15.24 (GPA3), U16.10
/Relay channels/NODE_ON5: R43.2, U15.25 (GPA4), U17.16
/Relay channels/NODE_ON6: R44.2, U15.26 (GPA5), U17.14
/Relay channels/NODE_ON7: R45.2, U15.27 (GPA6), U17.12
/Relay channels/NODE_ON8: R46.2, U15.5 (GPB4), U17.10
/Relay channels/PWR_DRV1: R102.1, U14.21 (GPA0)
/Relay channels/PWR_DRV2: R104.1, U14.22 (GPA1)
/Relay channels/PWR_DRV3: R106.1, U14.23 (GPA2)
/Relay channels/PWR_DRV4: R108.1, U14.24 (GPA3)
/Relay channels/PWR_DRV5: R110.1, U14.25 (GPA4)
/Relay channels/PWR_DRV6: R112.1, U14.26 (GPA5)
/Relay channels/PWR_DRV7: R114.1, U14.27 (GPA6)
/Relay channels/PWR_DRV8: R116.1, U14.28 (GPA7)
/Relay channels/RST_DRV1: R101.1, U14.1 (GPB0)
/Relay channels/RST_DRV2: R103.1, U14.2 (GPB1)
/Relay channels/RST_DRV3: R105.1, U14.3 (GPB2)
/Relay channels/RST_DRV4: R107.1, U14.4 (GPB3)
/Relay channels/RST_DRV5: R109.1, U14.5 (GPB4)
/Relay channels/RST_DRV6: R111.1, U14.6 (GPB5)
/Relay channels/RST_DRV7: R113.1, U14.7 (GPB6)
/Relay channels/RST_DRV8: R115.1, U14.8 (GPB7)
DRY_IN1: U15.1 (GPB0); also elsewhere on the board
DRY_IN2: U15.2 (GPB1); also elsewhere on the board
DRY_IN3: U15.3 (GPB2); also elsewhere on the board
DRY_IN4: U15.4 (GPB3); also elsewhere on the board
EXP_INT: R33.2, U14.20 (INTA), U15.20 (INTA); also elsewhere on the board
EXP_nRESET_INT: R32.1, U14.18 (~RESET), U15.18 (~RESET); also elsewhere on the board
GND: C38.2, C46.2, K1.3, K2.3, K3.3, K4.3, K5.3, K6.3, K7.3, K8.3, K9.3, K10.3, K11.3, K12.3, K13.3, K14.3, K15.3, K16.3, R32.2, U14.10 (V_{SS}), U14.15 (A0), U14.16 (A1), U14.17 (A2), U15.10 (V_{SS}), U15.16 (A1), U15.17 (A2), U16.9, U16.11, U16.13, U16.15, U17.9, U17.11, U17.13, U17.15; also elsewhere on the board
I2C_INT_SCL: U14.12 (SCK), U15.12 (SCK); also elsewhere on the board
I2C_INT_SDA: U14.13 (SDA), U15.13 (SDA); also elsewhere on the board
unnamed: K1.1, R101.2
unnamed: K1.4, R201.1
unnamed: K2.1, R102.2
unnamed: K2.4, R202.1
unnamed: K3.1, R103.2
unnamed: K3.4, R203.1
unnamed: K4.1, R104.2
unnamed: K4.4, R204.1
unnamed: K5.1, R105.2
unnamed: K5.4, R205.1
unnamed: K6.1, R106.2
unnamed: K6.4, R206.1
unnamed: K7.1, R107.2
unnamed: K7.4, R207.1
unnamed: K8.1, R108.2
unnamed: K8.4, R208.1
unnamed: K9.1, R109.2
unnamed: K9.4, R209.1
unnamed: K10.1, R110.2
unnamed: K10.4, R210.1
unnamed: K11.1, R111.2
unnamed: K11.4, R211.1
unnamed: K12.1, R112.2
unnamed: K12.4, R212.1
unnamed: K13.1, R113.2
unnamed: K13.4, R213.1
unnamed: K14.1, R114.2
unnamed: K14.4, R214.1
unnamed: K15.1, R115.2
unnamed: K15.4, R215.1
unnamed: K16.1, R116.2
unnamed: K16.4, R216.1
unnamed: R47.2, U16.1
unnamed: R48.2, U16.3
unnamed: R49.2, U16.5
unnamed: R50.2, U16.7
unnamed: R51.2, U17.1
unnamed: R52.2, U17.3
unnamed: R53.2, U17.5
unnamed: R54.2, U17.7

Notes on the sheet:
Channels 1-8: 2x photoMOS contact closure (RESET, PWR BTN) per motherboard front-panel header. Floating outputs. TLP176AM: 3mA max trigger, ~6.5mA drive (270R). U14 MCP23017 @0x20 sources the LED current: GPA0-7 = PWR_DRV1-8, GPB0-7 = RST_DRV1-8 (GPA7/GPB7 are output-only). R32 holds U14 and U15 in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
Node connector J11-J18 (JST PH 5p): 1 PWR_SW, 2 RST_SW, 3 node GND (common return of both buttons), 4 PLED+, 5 PLED-. PLED sense: TLP290-4 (AC input, either polarity), 220R in series with the node's own LED resistor, 47k pull-up -> NODE_ONn low = node power LED lit. U15 MCP23017 @0x21: GPA0-6 = NOD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
