delandtj/granite_controller/granite_controller.kicad_pcb

## KiCad design granite_controller.kicad_pcb (continued)

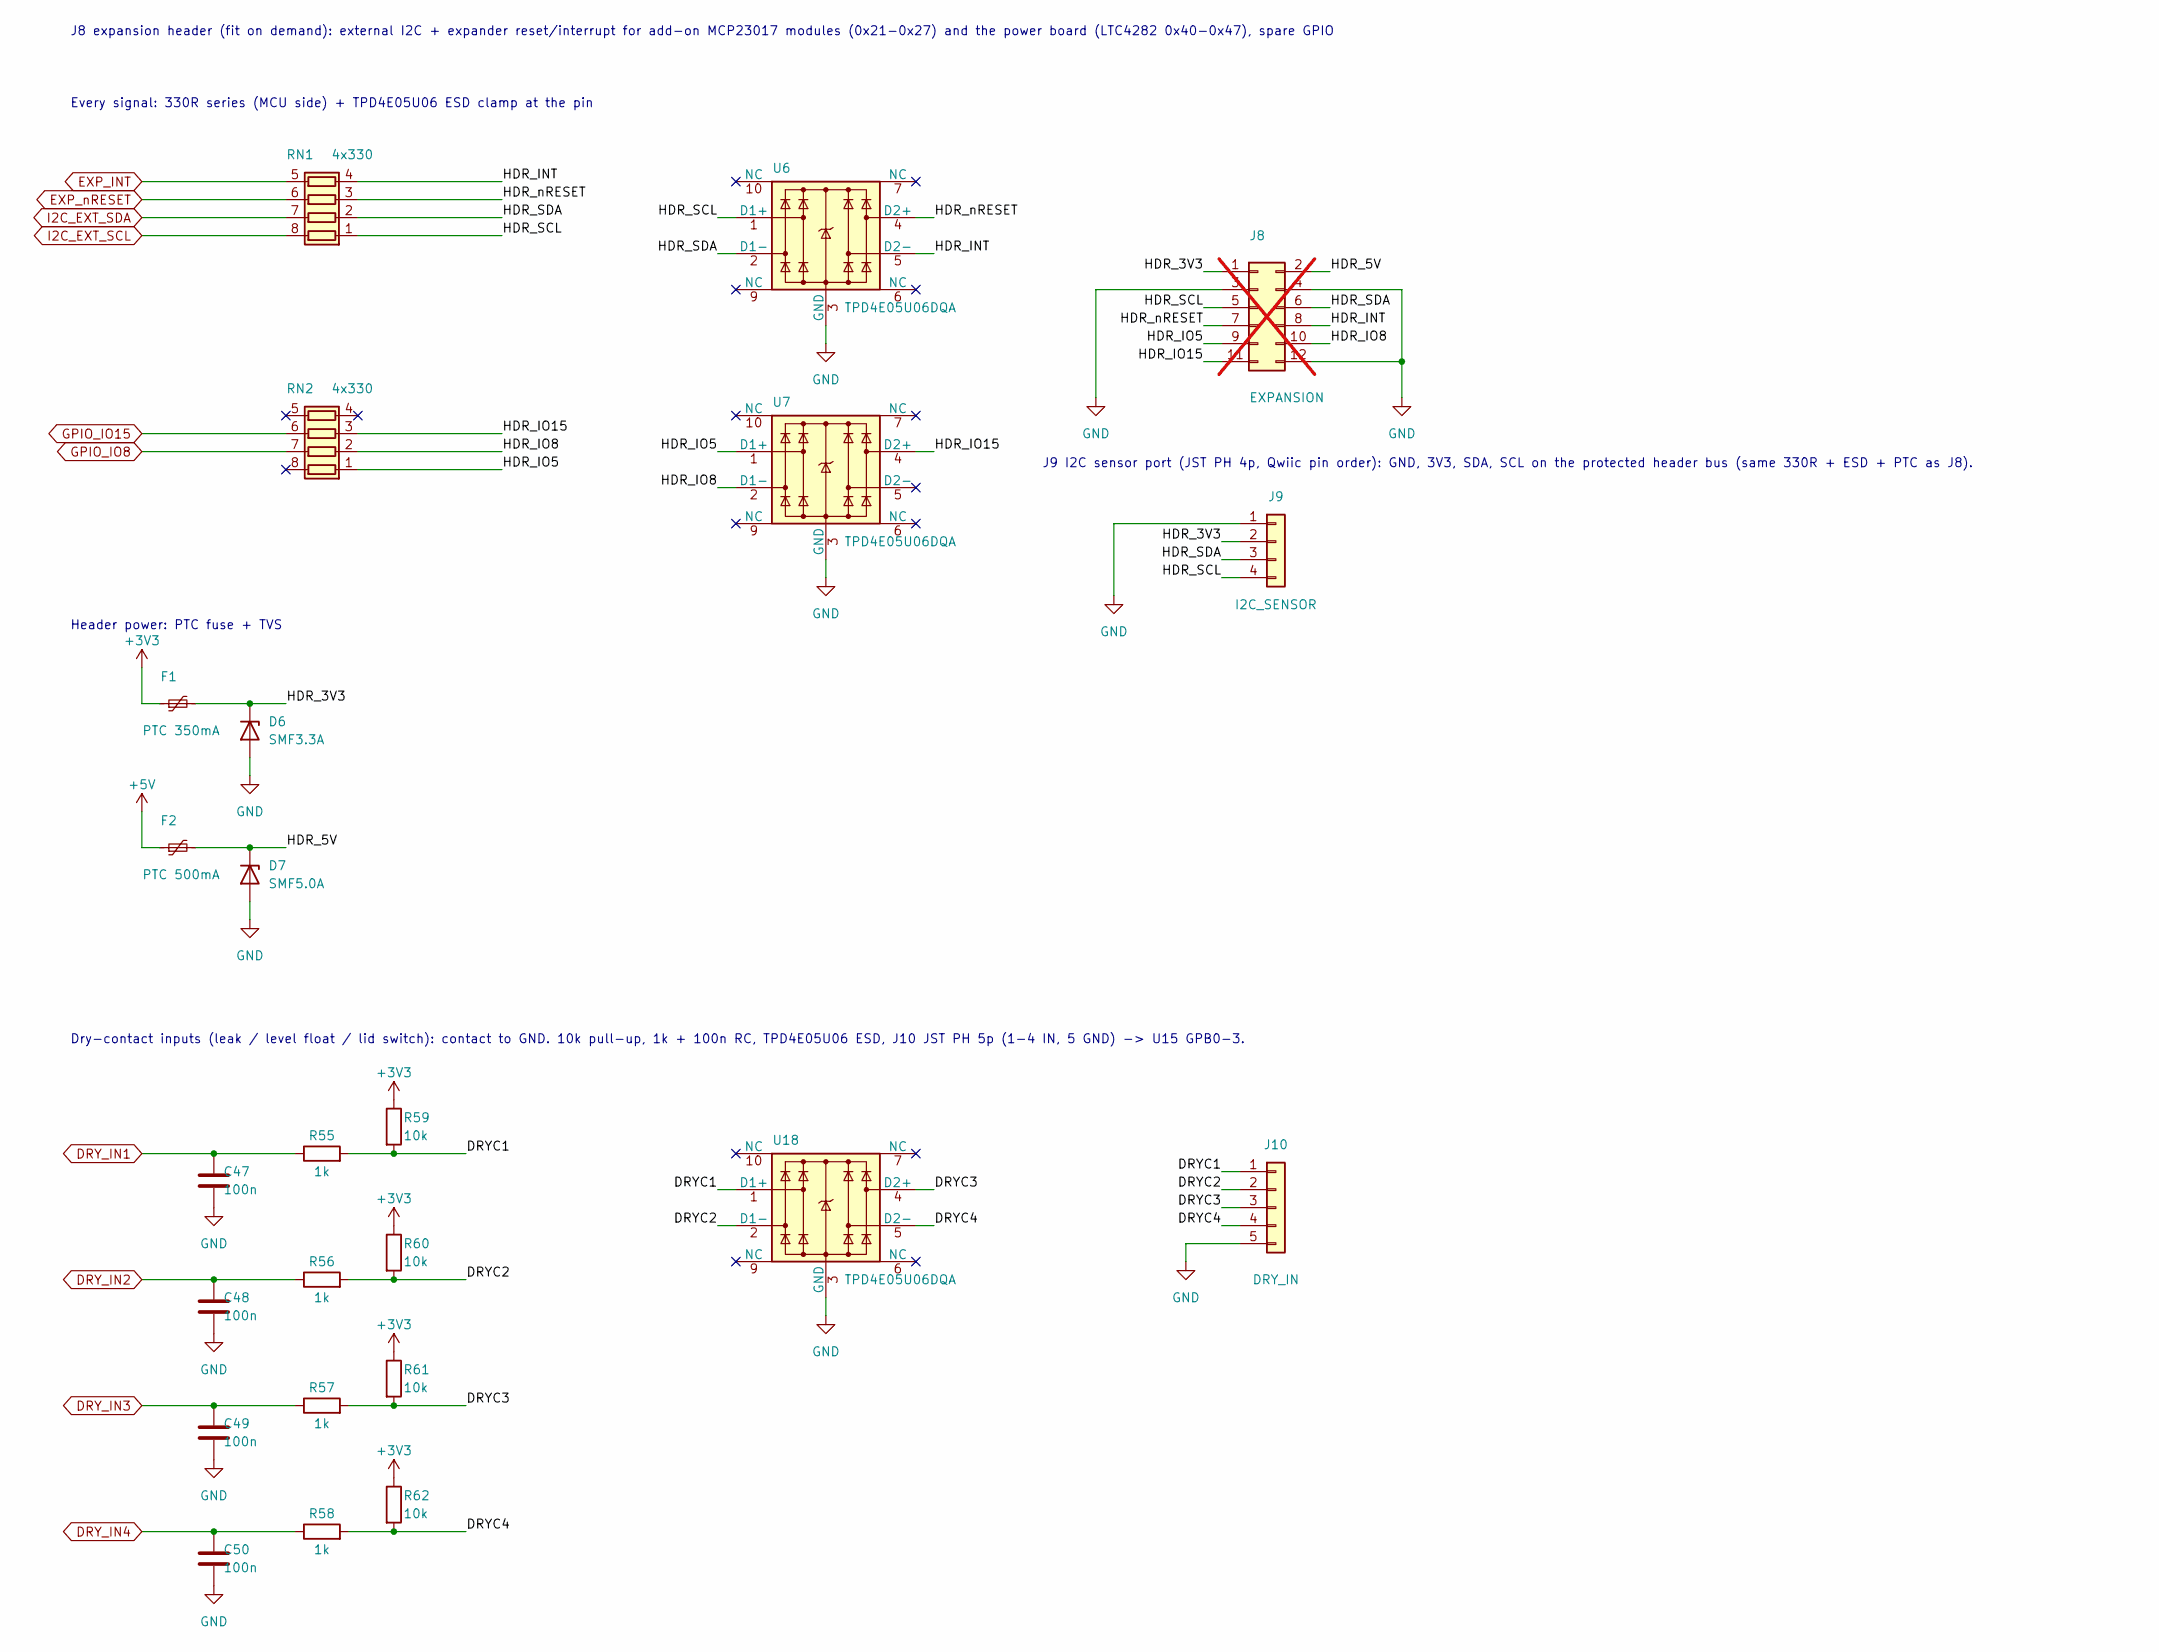
[picture p48: schematic expansion.kicad_sch, Granite Controller - Expansion header]

Parts:
C47, C48, C49, C50: 100n; C_0402_1005Metric; MPN CL05B104KO5NNNC; LCSC C1525
D6: SMF3.3A; D_SOD-123F; MPN SMF3.3A; LCSC C37331473
D7: SMF5.0A; D_SOD-123F; MPN SMF5.0A; LCSC C151296
F1: PTC 350mA; Fuse_0805_2012Metric; MPN 0805L035/24XR; LCSC C7472565
F2: PTC 500mA; Fuse_1206_3216Metric; MPN 1206L050/15YR; LCSC C151162
J8: EXPANSION; PinHeader_2x06_P2.54mm_Vertical; MPN ZX-PZ2.54-2-6PZZ; LCSC C7501277; not fitted
J9: I2C_SENSOR; JST_PH_B4B-PH-K_1x04_P2.00mm_Vertical; MPN B4B-PH-K-S(LF)(SN); LCSC C131334
J10: DRY_IN; JST_PH_B5B-PH-K_1x05_P2.00mm_Vertical; MPN B5B-PH-K-S(LF)(SN); LCSC C157993
R55, R56, R57, R58: 1k; R_0402_1005Metric; MPN 0402WGF1001TCE; LCSC C11702
R59, R60, R61, R62: 10k; R_0402_1005Metric; MPN 0402WGF1002TCE; LCSC C25744
RN1, RN2: 4x330; R_Array_Convex_4x0402; MPN 4D02WGJ0331TCE; LCSC C43557
U6, U7, U18: TPD4E05U06DQA; USON-10_2.5x1.0mm_P0.5mm; MPN TPD4E05U06DQAR; LCSC C138714

Connections:
+3V3: F1.1, R59.1, R60.1, R61.1, R62.1; also elsewhere on the board
+5V: F2.1; also elsewhere on the board
/Expansion header/DRYC1: J10.1, R55.2, R59.2, U18.1 (D1+)
/Expansion header/DRYC2: J10.2, R56.2, R60.2, U18.2 (D1-)
/Expansion header/DRYC3: J10.3, R57.2, R61.2, U18.4 (D2+)
/Expansion header/DRYC4: J10.4, R58.2, R62.2, U18.5 (D2-)
/Expansion header/HDR_3V3: D6.1 (K), F1.2, J8.1, J9.2
/Expansion header/HDR_5V: D7.1 (K), F2.2, J8.2
/Expansion header/HDR_INT: J8.8, RN1.4 (R4.1), U6.5 (D2-)
/Expansion header/HDR_IO5: J8.9, RN2.1 (R1.1), U7.1 (D1+)
/Expansion header/HDR_IO8: J8.10, RN2.2 (R2.1), U7.2 (D1-)
/Expansion header/HDR_IO15: J8.11, RN2.3 (R3.1), U7.4 (D2+)
/Expansion header/HDR_SCL: J8.5, J9.4, RN1.1 (R1.1), U6.1 (D1+)
/Expansion header/HDR_SDA: J8.6, J9.3, RN1.2 (R2.1), U6.2 (D1-)
/Expansion header/HDR_nRESET: J8.7, RN1.3 (R3.1), U6.4 (D2+)
DRY_IN1: C47.1, R55.1; also elsewhere on the board
DRY_IN2: C48.1, R56.1; also elsewhere on the board
DRY_IN3: C49.1, R57.1; also elsewhere on the board
DRY_IN4: C50.1, R58.1; also elsewhere on the board
EXP_INT: RN1.5 (R4.2); also elsewhere on the board
EXP_nRESET: RN1.6 (R3.2); also elsewhere on the board
GND: C47.2, C48.2, C49.2, C50.2, D6.2 (A), D7.2 (A), J8.3, J8.4, J8.12, J9.1, J10.5, U6.3 (GND), U6.8 (GND), U7.3 (GND), U7.8 (GND), U18.3 (GND), U18.8 (GND); also elsewhere on the board
GPIO_IO8: RN2.7 (R2.2); also elsewhere on the board
GPIO_IO15: RN2.6 (R3.2); also elsewhere on the board
I2C_EXT_SCL: RN1.8 (R1.2); also elsewhere on the board
I2C_EXT_SDA: RN1.7 (R2.2); also elsewhere on the board

Notes on the sheet:
J8 expansion header (fit on demand): external I2C + expander reset/interrupt for add-on MCP23017 modules (0x21-0x27) and the power board (LTC4282 0x40-0x47), spare GPIO
Every signal: 330R series (MCU side) + TPD4E05U06 ESD clamp at the pin
Header power: PTC fuse + TVS
J9 I2C sensor port (JST PH 4p, Qwiic pin order): GND, 3V3, SDA, SCL on the protected header bus (same 330R + ESD + PTC as J8).
Dry-contact inputs (leak / level float / lid switch): contact to GND. 10k pull-up, 1k + 100n RC, TPD4E05U06 ESD, J10 JST PH 5p (1-4 IN, 5 GND) -> U15 GPB0-3.

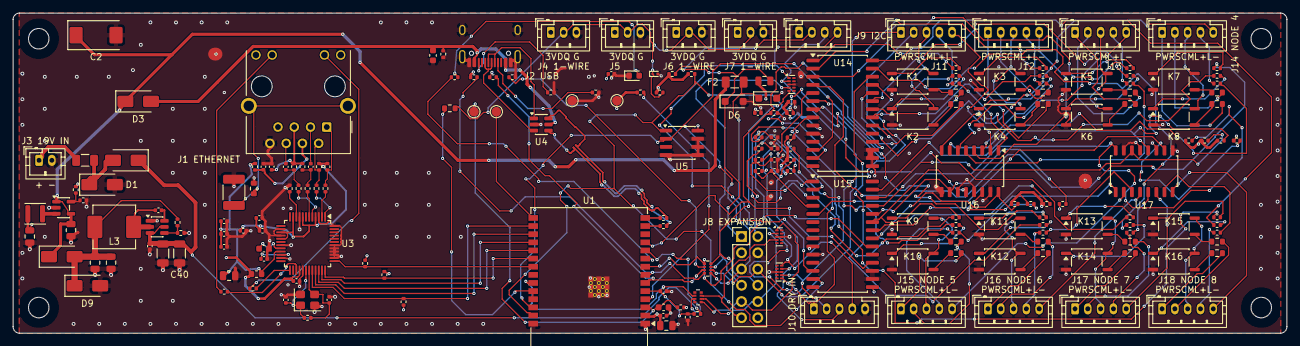
[picture p49: board granite_controller.kicad_pcb from above]

Board: 4 copper layers, 199.0 x 50.0 mm, 207 parts (0 on the bottom side), 187 nets.

Other parts of the board:
H1, H2, H3, H4: MountingHole_3.2mm_M3
