delandtj/granite_controller/attic/controller-rev-d/schematic/mcu.kicad_sch

## KiCad design attic/controller-rev-d/schematic/mcu.kicad_sch (2026-11-11)

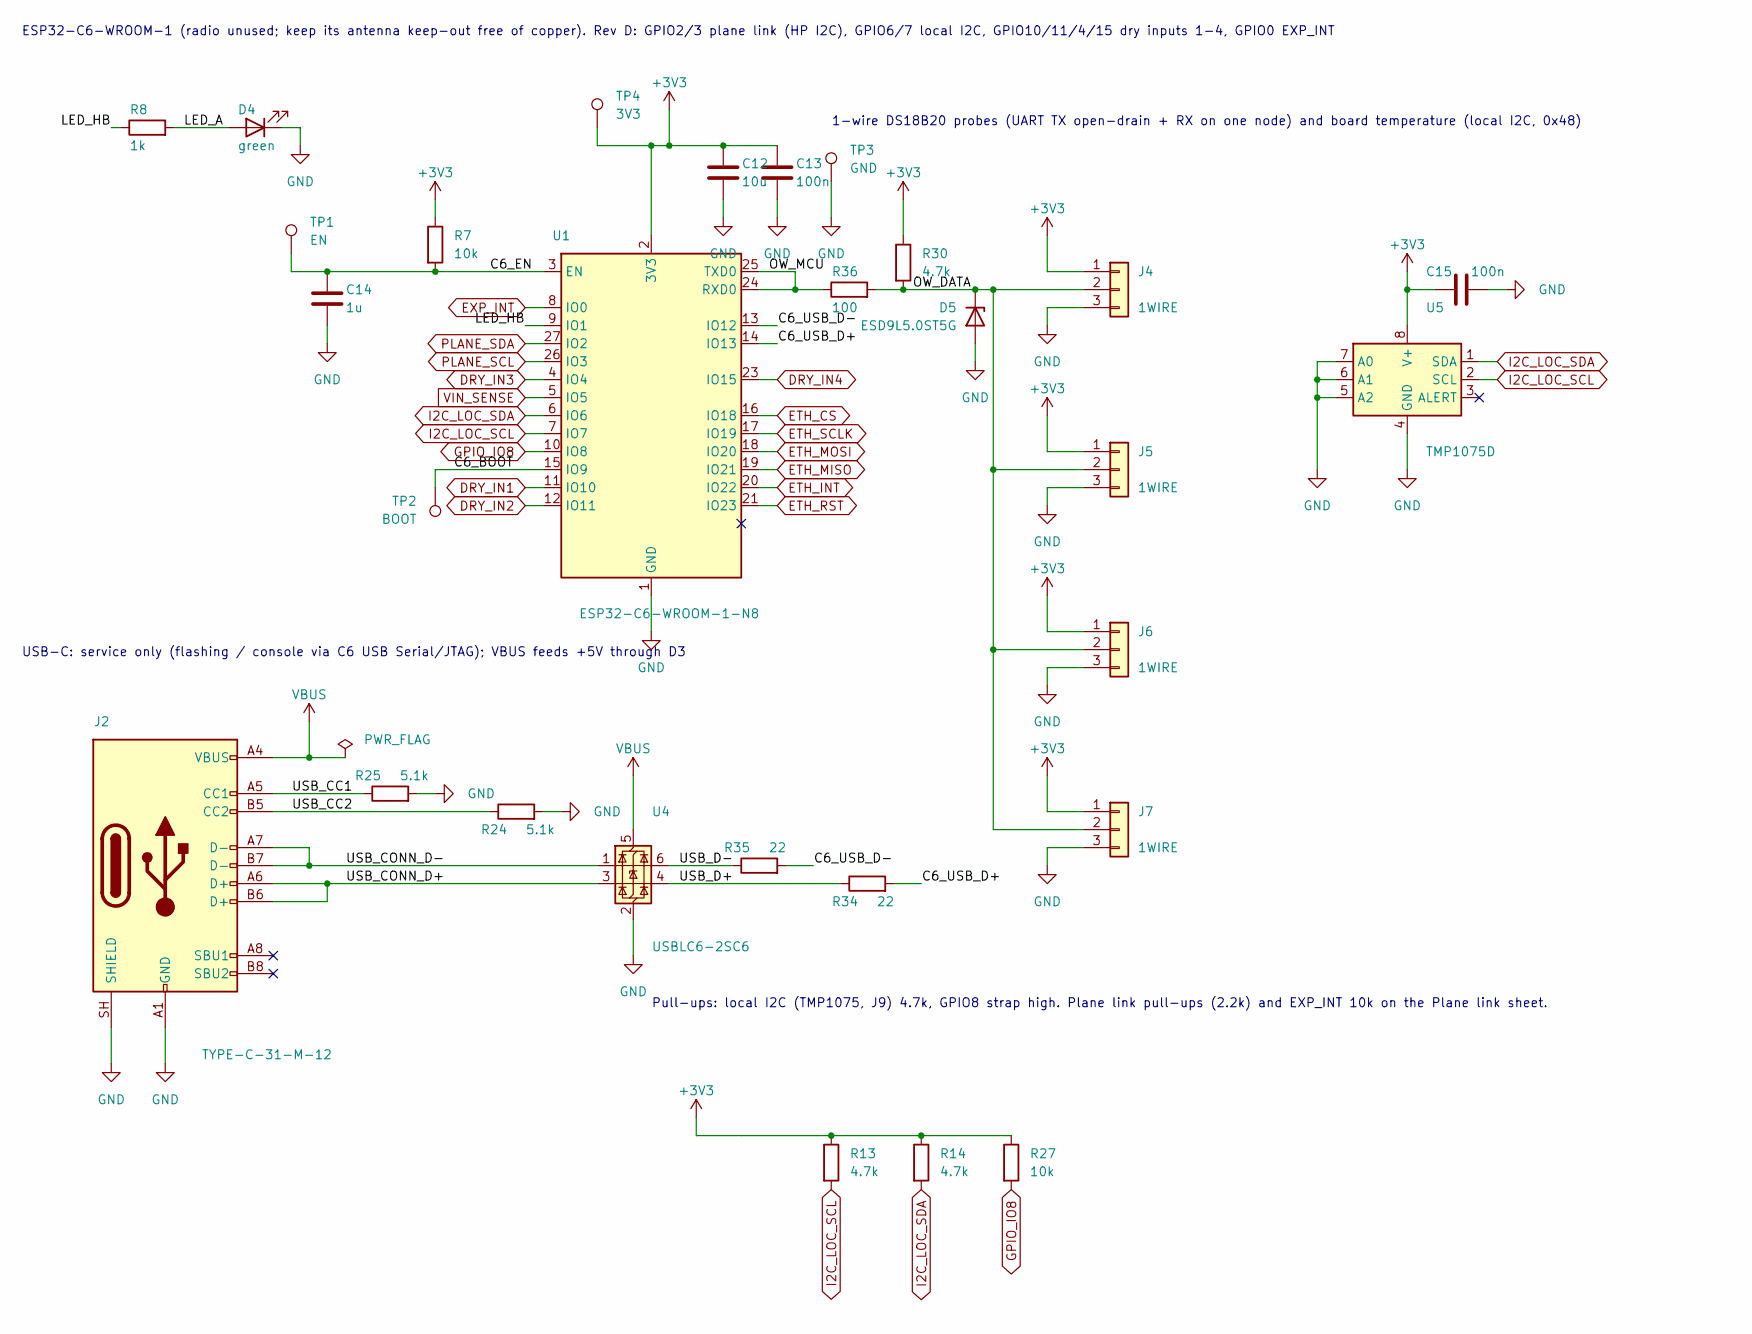
[picture p50: schematic mcu.kicad_sch]

Parts:
C12: 10u; C_0805_2012Metric; MPN CL21A106KAYNNNE; LCSC C15850
C13, C15: 100n; C_0402_1005Metric; MPN CL05B104KO5NNNC; LCSC C1525
C14: 1u; C_0603_1608Metric; MPN CL10A105KB8NNNC; LCSC C15849
D4: green; LED_0603_1608Metric; MPN KT-0603G; LCSC C12624
D5: ESD9L5.0ST5G; D_SOD-923; MPN ESD9L5.0ST5G; LCSC C82326
J2: TYPE-C-31-M-12; USB_C_Receptacle_HRO_TYPE-C-31-M-12; MPN TYPE-C-31-M-12; LCSC C165948
J4, J5, J6, J7: 1WIRE; JST_PH_B3B-PH-K_1x03_P2.00mm_Vertical; MPN B3B-PH-K-S(LF)(SN); LCSC C131339
R7, R27: 10k; R_0402_1005Metric; MPN 0402WGF1002TCE; LCSC C25744
R8: 1k; R_0402_1005Metric; MPN 0402WGF1001TCE; LCSC C11702
R13, R14, R30: 4.7k; R_0402_1005Metric; MPN 0402WGF4701TCE; LCSC C25900
R24, R25: 5.1k; R_0402_1005Metric; MPN 0402WGF5101TCE; LCSC C25905
R34, R35: 22; R_0402_1005Metric; MPN 0402WGF220JTCE; LCSC C25092
R36: 100; R_0603_1608Metric; MPN 0603WAF1000T5E; LCSC C22775
TP1: EN; TestPoint_Pad_D1.5mm
TP2: BOOT; TestPoint_Pad_D1.5mm
TP3: GND; TestPoint_Pad_D1.5mm
TP4: 3V3; TestPoint_Pad_D1.5mm
U1: ESP32-C6-WROOM-1-N8; ESP32-C6-WROOM-1; MPN ESP32-C6-WROOM-1-N8; LCSC C5366877
U4: USBLC6-2SC6; SOT-23-6; MPN USBLC6-2SC6; LCSC C7519
U5: TMP1075D; SOIC-8_3.9x4.9mm_P1.27mm; MPN TMP1075DR; LCSC C2878381

Connections:
+3V3: C12.1, C13.1, C15.1, J4.1, J5.1, J6.1, J7.1, R7.1, R13.1, R14.1, R27.1, R30.1, TP4.1, U1.2 (3V3), U5.8 (V+)
C6_BOOT: TP2.1, U1.15 (IO9)
C6_EN: C14.1, R7.2, TP1.1, U1.3 (EN)
C6_USB_D+: R34.2, U1.14 (IO13)
C6_USB_D-: R35.2, U1.13 (IO12)
DRY_IN1: U1.11 (IO10)
DRY_IN2: U1.12 (IO11)
DRY_IN3: U1.4 (IO4)
DRY_IN4: U1.23 (IO15)
ETH_CS: U1.16 (IO18)
ETH_INT: U1.20 (IO22)
ETH_MISO: U1.19 (IO21)
ETH_MOSI: U1.18 (IO20)
ETH_RST: U1.21 (IO23)
ETH_SCLK: U1.17 (IO19)
EXP_INT: U1.8 (IO0)
GND: C12.2, C13.2, C14.2, C15.2, D4.1 (K), D5.2 (A), J2.A1 (GND), J2.A12 (GND), J2.B1 (GND), J2.B12 (GND), J2.SH (SHIELD), J4.3, J5.3, J6.3, J7.3, R24.2, R25.2, TP3.1, U1.1 (GND), U1.28 (GND), U1.29 (GND), U4.2 (GND), U5.4 (GND), U5.5 (A2), U5.6 (A1), U5.7 (A0)
GPIO_IO8: R27.2, U1.10 (IO8)
I2C_LOC_SCL: R13.2, U1.7 (IO7), U5.2 (SCL)
I2C_LOC_SDA: R14.2, U1.6 (IO6), U5.1 (SDA)
LED_A: D4.2 (A), R8.2
LED_HB: R8.1, U1.9 (IO1)
OW_DATA: D5.1 (K), J4.2, J5.2, J6.2, J7.2, R30.2, R36.2
OW_MCU: R36.1, U1.24 (RXD0), U1.25 (TXD0)
PLANE_SCL: U1.26 (IO3)
PLANE_SDA: U1.27 (IO2)
USB_CC1: J2.A5 (CC1), R25.1
USB_CC2: J2.B5 (CC2), R24.1
USB_CONN_D+: J2.A6 (D+), J2.B6 (D+), U4.3 (I/O2)
USB_CONN_D-: J2.A7 (D-), J2.B7 (D-), U4.1 (I/O1)
USB_D+: R34.1, U4.4 (I/O2)
USB_D-: R35.1, U4.6 (I/O1)
VBUS: J2.A4 (VBUS), J2.A9 (VBUS), J2.B4 (VBUS), J2.B9 (VBUS), U4.5 (VBUS)
VIN_SENSE: U1.5 (IO5)

Notes on the sheet:
ESP32-C6-WROOM-1 (radio unused; keep its antenna keep-out free of copper). Rev D: GPIO2/3 plane link (HP I2C), GPIO6/7 local I2C, GPIO10/11/4/15 dry inputs 1-4, GPIO0 EXP_INT
1-wire DS18B20 probes (UART TX open-drain + RX on one node) and board temperature (local I2C, 0x48)
USB-C: service only (flashing / console via C6 USB Serial/JTAG); VBUS feeds +5V through D3
Pull-ups: local I2C (TMP1075, J9) 4.7k, GPIO8 strap high. Plane link pull-ups (2.2k) and EXP_INT 10k on the Plane link sheet.
