delandtj/granite_controller/attic/controller-rev-d/schematic/power.kicad_sch

## KiCad design attic/controller-rev-d/schematic/power.kicad_sch (2026-11-11)

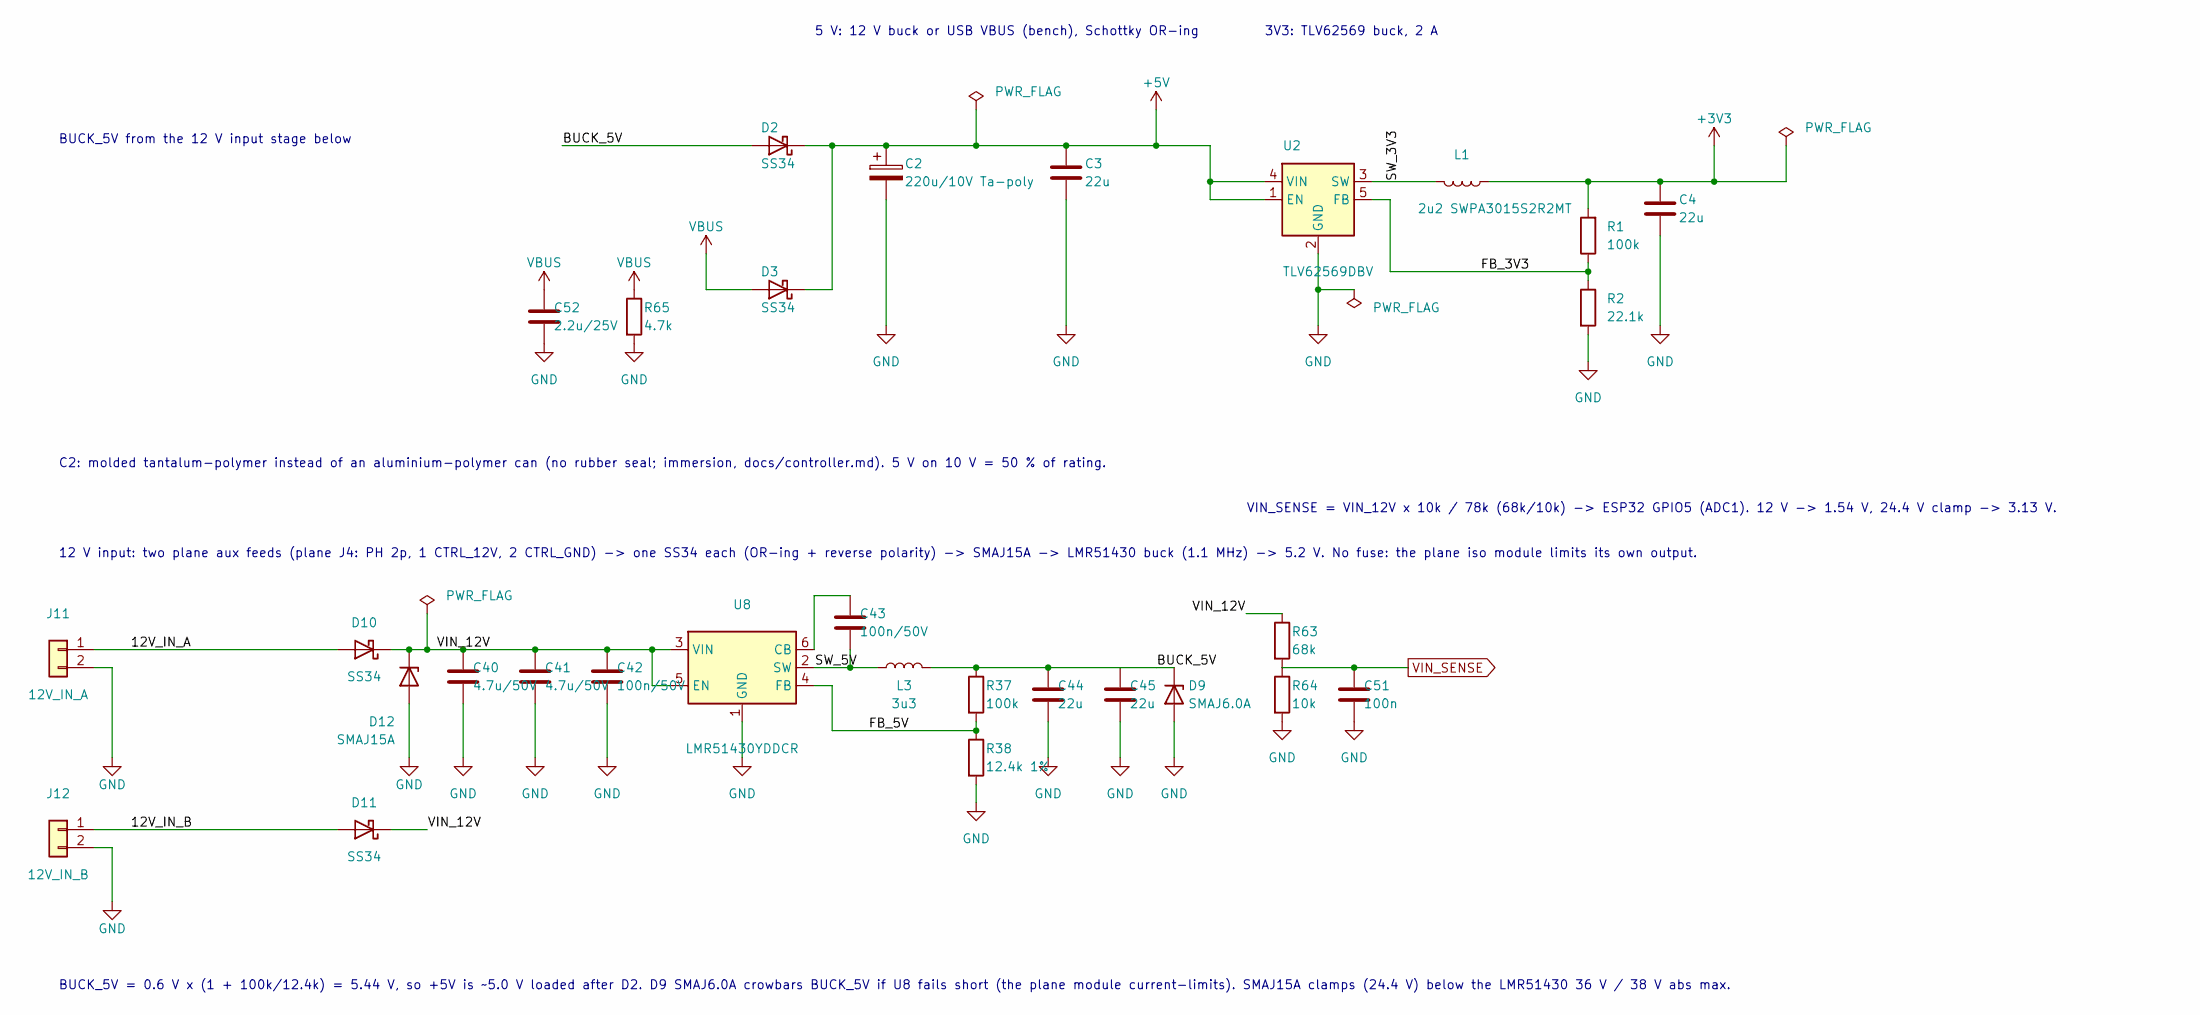
[picture p51: schematic power.kicad_sch]

Parts:
C2: 220u/10V Ta-poly; CP_EIA-7343-31_Kemet-D; MPN T520D227M010ATE018; LCSC C116742
C3, C4, C44, C45: 22u; C_0805_2012Metric; MPN CL21A226MAQNNNE; LCSC C45783
C40, C41: 4.7u/50V; C_1206_3216Metric; MPN 1206B475K500NT; LCSC C29823
C42, C43: 100n/50V; C_0402_1005Metric; MPN CL05B104KB54PNC; LCSC C307331
C51: 100n; C_0402_1005Metric; MPN CL05B104KO5NNNC; LCSC C1525
C52: 2.2u/25V; C_0603_1608Metric; MPN CL10A225KA8NNNC; LCSC C57895
D2, D3, D10, D11: SS34; D_SMA; MPN SS34; LCSC C8678
D9: SMAJ6.0A; D_SMA; MPN SMAJ6.0A; LCSC C364284
D12: SMAJ15A; D_SMA; MPN SMAJ15A; LCSC C148216
J11: 12V_IN_A; JST_PH_B2B-PH-K_1x02_P2.00mm_Vertical; MPN B2B-PH-K-S(LF)(SN); LCSC C131337
J12: 12V_IN_B; JST_PH_B2B-PH-K_1x02_P2.00mm_Vertical; MPN B2B-PH-K-S(LF)(SN); LCSC C131337
L1: 2u2 SWPA3015S2R2MT; L_Sunlord_SWPA3015S; MPN SWPA3015S2R2MT; LCSC C43389
L3: 3u3; L_Changjiang_FXL0630; MPN FXL0630-3R3-M; LCSC C167219
R1, R37: 100k; R_0402_1005Metric; MPN 0402WGF1003TCE; LCSC C25741
R2: 22.1k; R_0402_1005Metric; MPN RC0402FR-0722K1L; LCSC C163478
R38: 12.4k 1%; R_0402_1005Metric; MPN 0402WGF1242TCE; LCSC C11692
R63: 68k; R_0402_1005Metric; MPN 0402WGF6802TCE; LCSC C36871
R64: 10k; R_0402_1005Metric; MPN 0402WGF1002TCE; LCSC C25744
R65: 4.7k; R_0402_1005Metric; MPN 0402WGF4701TCE; LCSC C25900
U2: TLV62569DBV; SOT-23-5; MPN TLV62569DBVR; LCSC C141836
U8: LMR51430YDDCR; SOT-23-6; MPN LMR51430YDDCR; LCSC C5210749

Connections:
12V_IN_A: D10.2 (A), J11.1
12V_IN_B: D11.2 (A), J12.1
+3V3: C4.1, L1.1, R1.2
+5V: C2.1, C3.1, D2.1 (K), D3.1 (K), U2.1 (EN), U2.4 (VIN)
BUCK_5V: C44.1, C45.1, D2.2 (A), D9.1 (K), L3.2, R37.1
FB_3V3: R1.1, R2.1, U2.5 (FB)
FB_5V: R37.2, R38.1, U8.4 (FB)
GND: C2.2, C3.2, C4.2, C40.2, C41.2, C42.2, C44.2, C45.2, C51.2, C52.2, D9.2 (A), D12.2 (A), J11.2, J12.2, R2.2, R38.2, R64.2, R65.2, U2.2 (GND), U8.1 (GND)
unnamed: C43.1, U8.6 (CB)
SW_3V3: L1.2, U2.3 (SW)
SW_5V: C43.2, L3.1, U8.2 (SW)
VBUS: C52.1, D3.2 (A), R65.1
VIN_12V: C40.1, C41.1, C42.1, D10.1 (K), D11.1 (K), D12.1 (K), R63.1, U8.3 (VIN), U8.5 (EN)
VIN_SENSE: C51.1, R63.2, R64.1

Notes on the sheet:
5 V: 12 V buck or USB VBUS (bench), Schottky OR-ing
3V3: TLV62569 buck, 2 A
BUCK_5V from the 12 V input stage below
12 V input: two plane aux feeds (plane J4: PH 2p, 1 CTRL_12V, 2 CTRL_GND) -> one SS34 each (OR-ing + reverse polarity) -> SMAJ15A -> LMR51430 buck (1.1 MHz) -> 5.2 V. No fuse: the plane iso module limits its own output.
BUCK_5V = 0.6 V x (1 + 100k/12.4k) = 5.44 V, so +5V is ~5.0 V loaded after D2. D9 SMAJ6.0A crowbars BUCK_5V if U8 fails short (the plane module current-limits). SMAJ15A clamps (24.4 V) below the LMR51430 36 V / 38 V abs max.
C2: molded tantalum-polymer instead of an aluminium-polymer can (no rubber seal; immersion, docs/controller.md). 5 V on 10 V = 50 % of rating.
VIN_SENSE = VIN_12V x 10k / 78k (68k/10k) -> ESP32 GPIO5 (ADC1). 12 V -> 1.54 V, 24.4 V clamp -> 3.13 V.
