delandtj/granite_controller/schematic/design_blocks/granite.kicad_blocks/photomos_channel.kicad_block/photomos_channel.kicad_sch

## KiCad design schematic/design_blocks/granite.kicad_blocks/photomos_channel.kicad_block/photomos_channel.kicad_sch (2026-07-13)

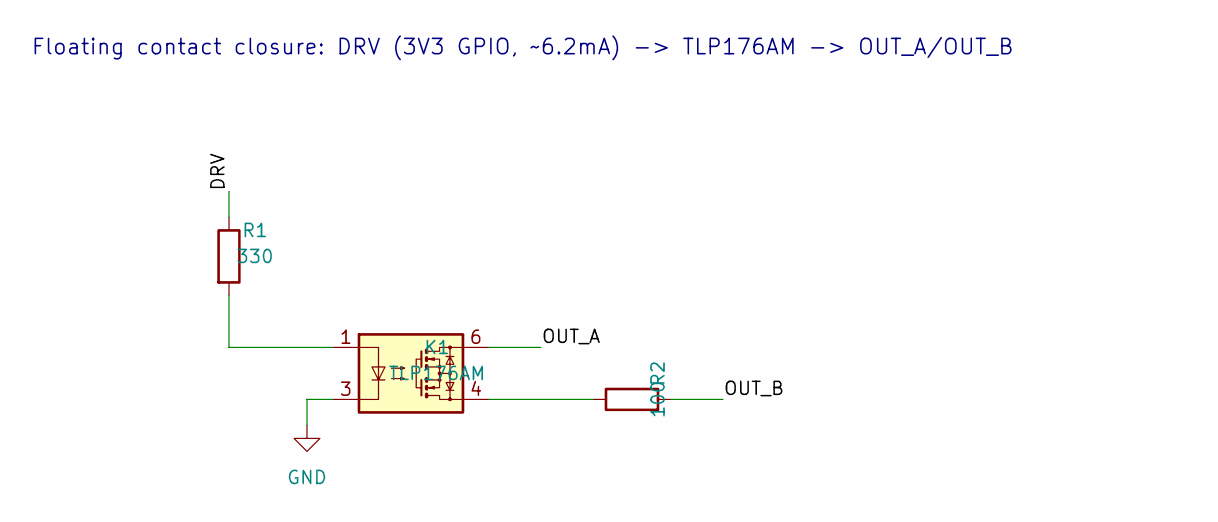
[picture p52: schematic photomos_channel.kicad_sch]

Parts:
K1: TLP176AM; SOIC-4_4.55x3.7mm_P2.54mm
R1: 330; R_0402_1005Metric
R2: 100; R_0603_1608Metric

Connections:
DRV: R1.1
GND: K1.3
unnamed: K1.1, R1.2
unnamed: K1.4, R2.1
OUT_A: K1.6
OUT_B: R2.2

Notes on the sheet:
Floating contact closure: DRV (3V3 GPIO, ~6.2mA) -> TLP176AM -> OUT_A/OUT_B
