delandtj/granite_controller/firmware/granite-fw/src/platform/ota.rs

//! Firmware update and boot safety (ADR 0001 component 11).
//!
//! What carries over from the wfi028t prior art
//! (`~/Electronics/wfi028t-controller/docs/adr/0002-ota-and-console-port.md`,
//! `fw/src/ota.rs`) is the *probation model*, not the mechanism: an image
//! boots on probation and has to prove itself on a concrete readiness
//! ladder inside a deadline, every step is logged, and failing it resets
//! the chip so the rollback bootloader aborts the slot. The partition
//! writing, the ed25519 header and the TCP push port do not carry over:
//! here `esp_ota_*` writes the slot and the ESP-IDF app signature block
//! (`sdkconfig.defaults.signing`) authenticates the image.
//!
//! The ladder (ADR: within `t_validate`, default 10 min):
//!
//!   1. the plane link hardware answered - the hardware layer calls
//!      [`mark_link_hw`] (ADR 0006, architecture component 7: "an image
//!      that never sees its link hardware does not validate and rolls
//!      back after probation"),
//!   2. link and an IP - the network monitor calls [`mark_link`],
//!   3. **either** the broker connected ([`mark_broker`]) **or** an
//!      authenticated HTTPS request served ([`mark_https`]).
//!
//! A step whose provider never registered (MQTT disabled in the config)
//! is not required: see [`expect_broker`]. Steps nobody can satisfy
//! would turn every boot into a rollback.
//!
//! Step 1 is the only one that is about the board rather than the
//! network: an FD image whose MCP2518FD does not reset or configure has
//! no way to reach a plane, and an image like that must not stay. The
//! `link-bench` feature logs it instead of failing the ladder, for the
//! rev C bench board that has no MCP2518FD on it; a shipped image never
//! has that feature.
//!
//! Rev C had a step before those two: "both expanders initialised". The
//! expanders are gone with the rev C node section (controller ADR 0004
//! decision 1), and a plane found is deliberately **not** its
//! replacement: a controller whose planes are unplugged still has to be
//! able to take a firmware update.

use std::sync::atomic::{AtomicBool, AtomicU8, Ordering};
use std::sync::Mutex;
use std::sync::mpsc::Sender;
use std::thread;
use std::time::Duration;

use esp_idf_svc::http::client::{Configuration as HttpConfiguration, EspHttpConnection};
use esp_idf_svc::nvs::{EspDefaultNvsPartition, EspNvs, NvsDefault};
use esp_idf_svc::ota::{EspOta, Slot, SlotState};
use esp_idf_svc::sys::{
    EspError, esp, esp_ota_abort, esp_ota_begin, esp_ota_end, esp_ota_get_next_update_partition,
    esp_ota_get_running_partition, esp_ota_get_state_partition, esp_ota_handle_t,
    esp_ota_img_states_t, esp_ota_img_states_t_ESP_OTA_IMG_NEW,
    esp_ota_img_states_t_ESP_OTA_IMG_PENDING_VERIFY, esp_ota_set_boot_partition, esp_ota_write,
    esp_partition_t, mbedtls_sha256_context, mbedtls_sha256_finish, mbedtls_sha256_free,
    mbedtls_sha256_init, mbedtls_sha256_starts, mbedtls_sha256_update,
};
use esp_idf_svc::tls::X509;
use granite_core::api::{OtaFinish, OtaSink as ApiOtaSink};
use granite_core::link_kind::{TagError, TagScan};
use granite_core::msg::{Event, EventKind};

use super::identity::hex;
use super::link_kind::RUNNING;

/// How often the probation ladder is re-evaluated.
const PROBATION_TICK: Duration = Duration::from_secs(2);
/// Let the last log line reach the console before a probation reset.
const REBOOT_DELAY: Duration = Duration::from_secs(1);
/// Read buffer for an HTTPS pull.
const PULL_CHUNK: usize = 4096;
/// With no Content-Length, a `downloading` event every this many bytes.
const PROGRESS_STEP_BYTES: u64 = 256 * 1024;
/// With a known length, a `downloading` event every this many percent.
const PROGRESS_STEP_PCT: u8 = 10;

/// Reported OTA state of the running image.
#[derive(Debug, Clone, Copy, PartialEq, Eq, Default)]
pub enum OtaState {
    /// Running from a `factory` partition. The current table has none
    /// (the slot went to the two OTA slots, user decision 2026-11-04),
    /// so this is only ever reported by a board still on the old
    /// layout - which is exactly the board that needs the wired
    /// reflash from `README.md`. The variant and the `factory` wire
    /// value stay so that case is visible instead of showing up as
    /// `unknown`.
    Factory,
    /// Marked valid.
    Valid,
    /// On probation: not confirmed yet.
    Pending,
    /// Marked invalid (should not be running).
    Invalid,
    /// `otadata` says nothing, which is what a bench flash leaves behind.
    #[default]
    Unknown,
}

impl OtaState {
    /// Lowercase wire name.
    pub const fn as_str(self) -> &'static str {
        match self {
            OtaState::Factory => "factory",
            OtaState::Valid => "valid",
            OtaState::Pending => "pending",
            OtaState::Invalid => "invalid",
            OtaState::Unknown => "unknown",
        }
    }

    fn code(self) -> u8 {
        self as u8
    }

    fn from_code(code: u8) -> Self {
        match code {
            0 => OtaState::Factory,
            1 => OtaState::Valid,
            2 => OtaState::Pending,
            3 => OtaState::Invalid,
            _ => OtaState::Unknown,
        }
    }
}

impl core::fmt::Display for OtaState {
    fn fmt(&self, f: &mut core::fmt::Formatter<'_>) -> core::fmt::Result {
        f.write_str(self.as_str())
    }
}

static STATE: AtomicU8 = AtomicU8::new(4); // Unknown

/// The OTA state of the running image, for `status`, `/id` and the LED.
pub fn ota_state() -> OtaState {
    OtaState::from_code(STATE.load(Ordering::Relaxed))
}

/// Readiness flags of the probation ladder.
mod ready {
    use std::sync::atomic::AtomicBool;

    pub static LINK_HW: AtomicBool = AtomicBool::new(false);
    pub static LINK: AtomicBool = AtomicBool::new(false);
    pub static BROKER: AtomicBool = AtomicBool::new(false);
    pub static HTTPS: AtomicBool = AtomicBool::new(false);
    pub static WANT_BROKER: AtomicBool = AtomicBool::new(false);
}

/// Step 1: the plane link hardware is there and configured.
///
/// The CAN build calls this once the MCP2518FD has reset, configured and
/// gone on the bus; the I2C build calls it as it claims EXP_INT, because
/// there is no chip on that link to answer (and rev D's driver does not
/// exist yet). An image that never calls it fails its probation and the
/// bootloader rolls it back - unless it was built with `link-bench`.
pub fn mark_link_hw() {
    ready::LINK_HW.store(true, Ordering::Relaxed);
}

/// Whether the link-hardware step counts as passed.
///
/// With `link-bench` it always does, and [`link_hw_note`] says so in the
/// probation detail, so a bench run cannot be mistaken for a shipped
/// image passing the gate.
fn link_hw_ok() -> bool {
    cfg!(feature = "link-bench") || ready::LINK_HW.load(Ordering::Relaxed)
}

/// How the link-hardware step reads in a log line.
fn link_hw_note() -> &'static str {
    match (
        ready::LINK_HW.load(Ordering::Relaxed),
        cfg!(feature = "link-bench"),
    ) {
        (true, _) => "true",
        (false, true) => "false (link-bench: not required)",
        (false, false) => "false",
    }
}

/// The MQTT worker announces that a broker is configured, so "broker
/// connected" is a way to pass step 3.
pub fn expect_broker() {
    ready::WANT_BROKER.store(true, Ordering::Relaxed);
}

/// Step 1: link up and an IP.
pub fn mark_link() {
    ready::LINK.store(true, Ordering::Relaxed);
}

/// Step 2a: the configured broker connected. Also the moment a rollback
/// found at boot can be reported: see [`report_rollback`].
pub fn mark_broker() {
    ready::BROKER.store(true, Ordering::Relaxed);
    report_rollback();
}

/// Step 2b: an authenticated HTTPS request was served.
pub fn mark_https() {
    ready::HTTPS.store(true, Ordering::Relaxed);
}

fn ladder_passed() -> Option<&'static str> {
    if !link_hw_ok() {
        return None;
    }
    if !ready::LINK.load(Ordering::Relaxed) {
        return None;
    }
    let broker = ready::WANT_BROKER.load(Ordering::Relaxed) && ready::BROKER.load(Ordering::Relaxed);
    let https = ready::HTTPS.load(Ordering::Relaxed);
    match (broker, https) {
        (true, _) => Some("the plane link hardware, the network link and the broker"),
        (false, true) => Some("the plane link hardware, the network link and an authenticated https request"),
        _ => None,
    }
}

// ---------------------------------------------------------------------------
// Slot information
// ---------------------------------------------------------------------------

/// What the firmware knows about the three app partitions.
#[derive(Debug, Clone, serde::Serialize)]
pub struct OtaInfo {
    /// Label of the running partition.
    pub running: String,
    /// State of the running partition.
    pub state: String,
    /// Label of the partition the next image would be written to.
    pub next: String,
    /// Label of the partition the bootloader would pick now.
    pub boot: String,
    /// Label of the last slot marked invalid, if any.
    pub last_invalid: Option<String>,
    /// Version string of the running image, from the app descriptor.
    pub version: String,
}

fn slot_label(slot: &Slot) -> String {
    slot.label.as_str().to_string()
}

fn state_name(state: SlotState) -> &'static str {
    match state {
        // No `factory` partition in the current table, so this arm is
        // only reachable on a board still on the old layout (and is
        // required anyway: `SlotState` is esp-idf-svc's).
        SlotState::Factory => "factory",
        SlotState::Valid => "valid",
        SlotState::Invalid => "invalid",
        SlotState::Unverified => "unverified",
        SlotState::Unknown => "unknown",
    }
}

/// Read the slot table. `EspOta` is a singleton, so this takes it, reads,
/// and drops it again.
pub fn info() -> Result<OtaInfo, EspError> {
    let ota = EspOta::new()?;
    let running = ota.get_running_slot()?;
    let next = ota.get_update_slot()?;
    let boot = ota.get_boot_slot()?;
    let last_invalid = ota.get_last_invalid_slot()?.map(|s| slot_label(&s));
    Ok(OtaInfo {
        running: slot_label(&running),
        state: state_name(running.state).to_string(),
        next: slot_label(&next),
        boot: slot_label(&boot),
        last_invalid,
        version: running
            .firmware
            .as_ref()
            .map(|f| f.version.as_str().to_string())
            .unwrap_or_default(),
    })
}

/// Raw `esp_ota_img_states_t` of the running partition.
fn running_img_state() -> Option<esp_ota_img_states_t> {
    let partition = unsafe { esp_ota_get_running_partition() };
    if partition.is_null() {
        return None;
    }
    let mut state: esp_ota_img_states_t = 0;
    if unsafe { esp_ota_get_state_partition(partition, &mut state) } == 0 {
        Some(state)
    } else {
        None
    }
}

/// True when the running image has not confirmed itself yet.
///
/// `ESP_OTA_IMG_NEW` counts: the bootloader moves it to
/// `PENDING_VERIFY` on the boot after the one that wrote the slot, and an
/// image that finds itself in either state has not been confirmed.
pub fn is_pending_verify() -> bool {
    // Comparisons rather than a pattern: the bindgen constants are not
    // upper case, and a lowercase constant in a pattern is a binding, not
    // a comparison.
    match running_img_state() {
        Some(state) => {
            state == esp_ota_img_states_t_ESP_OTA_IMG_NEW
                || state == esp_ota_img_states_t_ESP_OTA_IMG_PENDING_VERIFY
        }
        None => false,
    }
}

/// Mark the running image valid (the `ota-mark-valid` console command and
/// the Firmware page button).
pub fn mark_valid() -> Result<(), EspError> {
    let mut ota = EspOta::new()?;
    ota.mark_running_slot_valid()?;
    disarm_rtc_watchdog();
    STATE.store(OtaState::Valid.code(), Ordering::Relaxed);
    log::warn!("ota: running image marked valid");
    Ok(())
}

/// Mark the running image invalid and let ESP-IDF reboot into the previous
/// slot. Only returns on failure.
pub fn mark_invalid_and_reboot() -> EspError {
    match EspOta::new() {
        Ok(mut ota) => ota.mark_running_slot_invalid_and_reboot(),
        Err(e) => e,
    }
}

// ---------------------------------------------------------------------------
// Probation
// ---------------------------------------------------------------------------

/// Decide the boot-time OTA state and, if the image is on probation, start
/// the validation ladder in its own thread.
///
/// `events` gets one `ota` event per step, so the probation shows up in the
/// MQTT log the same way the prior art put it in the capture log.
///
/// `nvs` is where the rollback report lives (see [`report_rollback`]);
/// without it a rollback is only logged.
pub fn start(t_validate_s: u32, events: Option<Sender<Event>>, nvs: Option<EspDefaultNvsPartition>) {
    // Park a copy for the transfer progress events (ADR component 11:
    // `started` and `downloading` on the event topic).
    if let Ok(mut guard) = PROGRESS_EVENTS.lock() {
        *guard = events.clone();
    }
    if let Ok(mut guard) = NVS.lock() {
        *guard = nvs;
    }
    let state = match info() {
        Ok(info) => {
            find_rollback(&info.running);
            log::info!(
                "ota: running {} ({}), next {}, boot {}{}",
                info.running,
                info.state,
                info.next,
                info.boot,
                info.last_invalid
                    .as_ref()
                    .map(|l| format!(", last invalid {l}"))
                    .unwrap_or_default()
            );
            match info.state.as_str() {
                "factory" => OtaState::Factory,
                "valid" => OtaState::Valid,
                "invalid" => OtaState::Invalid,
                "unverified" => OtaState::Pending,
                _ => OtaState::Unknown,
            }
        }
        Err(e) => {
            log::warn!("ota: slot table unreadable ({e}); treating the image as unknown");
            OtaState::Unknown
        }
    };
    STATE.store(state.code(), Ordering::Relaxed);

    // `Unverified` covers ESP_OTA_IMG_NEW as well; only a real
    // pending-verify needs the ladder.
    if state != OtaState::Pending || !is_pending_verify() {
        return;
    }

    let window = if t_validate_s == 0 { 600 } else { t_validate_s };
    arm_rtc_watchdog(window.saturating_add(GUARD_MARGIN_S));
    log::warn!(
        "ota: this image is on probation, {window} s to confirm (RTC watchdog at {} s)",
        window.saturating_add(GUARD_MARGIN_S)
    );
    emit(&events, "pending_verify", &format!("{window} s to confirm"));

    let spawned = super::spawn(c"ota-probation", 4096, move || probation(window, events));
    if let Err(e) = spawned {
        log::error!("ota: probation thread could not start ({e}); marking the image valid");
        let _ = mark_valid();
    }
}

fn probation(window_s: u32, events: Option<Sender<Event>>) {
    let deadline = super::now_ms() + u64::from(window_s) * 1000;
    loop {
        // Someone marked the image valid by hand (the Firmware page's
        // "mark current as valid", `POST /api/v1/firmware/mark-valid`):
        // probation is over. Without this the deadline below marked a
        // valid image invalid and the bootloader rolled it back anyway.
        if ota_state() == OtaState::Valid {
            log::info!("ota: image marked valid by hand; probation ends");
            return;
        }
        if let Some(why) = ladder_passed() {
            match mark_valid() {
                Ok(()) => {
                    log::warn!("ota: image confirmed ({why})");
                    emit(&events, "valid", why);
                }
                Err(e) => {
                    // Could not write otadata: stay pending, which is the
                    // safe direction - the next reset rolls back.
                    log::error!("ota: image works ({why}) but otadata could not be written: {e}");
                    emit(&events, "failed", &format!("otadata write failed: {e}"));
                }
            }
            return;
        }
        if super::now_ms() >= deadline {
            let detail = format!(
                "link_hw={} link={} broker={} https={}",
                link_hw_note(),
                ready::LINK.load(Ordering::Relaxed),
                ready::BROKER.load(Ordering::Relaxed),
                ready::HTTPS.load(Ordering::Relaxed),
            );
            log::error!(
                "ota: not confirmed within {window_s} s ({detail}); marking the image invalid, \
                 the bootloader rolls back"
            );
            emit(&events, "rolled_back", &detail);
            // This event rarely gets out (a missing broker is the usual
            // reason to be here), so leave the reason for the image the
            // bootloader falls back to.
            let running = info().map(|i| i.running).unwrap_or_default();
            nvs_set(
                RB_WHY,
                &format!("{running} not confirmed within {window_s} s ({detail})"),
            );
            STATE.store(OtaState::Invalid.code(), Ordering::Relaxed);
            thread::sleep(REBOOT_DELAY);
            // Releases the relays first, then hands over to ESP-IDF.
            super::release_outputs();
            let e = mark_invalid_and_reboot();
            // Only reached when ESP-IDF refused, e.g. there is no other
            // app to roll back to. A plain restart leaves the slot
            // pending, which the bootloader aborts on its own.
            log::error!("ota: rollback refused ({e}); restarting anyway");
            super::planned_reboot("ota_probation_failed");
        }
        thread::sleep(PROBATION_TICK);
    }
}

/// One `ota` event. `phase` uses the vocabulary
/// [`EventKind::Ota`] documents.
fn emit(events: &Option<Sender<Event>>, phase: &str, detail: &str) {
    if let Some(tx) = events {
        let _ = tx.send(Event::new(
            super::now_ms(),
            EventKind::Ota {
                phase: phase.to_string(),
                progress: None,
                detail: Some(detail.to_string()),
            },
        ));
    }
}

// ---------------------------------------------------------------------------
// Hardware probation deadline (RTC watchdog)
// ---------------------------------------------------------------------------
//
// The probation thread enforces `t_validate` only if the image gets far
// enough to start it and stays healthy enough to run it. The bootloader
// arms the RTC watchdog (CONFIG_BOOTLOADER_WDT_ENABLE, 9 s) and, with
// CONFIG_BOOTLOADER_WDT_DISABLE_IN_USER_CODE, ESP-IDF leaves it running
// into the app. A confirmed image switches it off first thing; an image
// on probation keeps it, stretched to the probation window, and switches
// it off only when it marks itself valid. A hang anywhere before that
// resets the chip, and the bootloader rolls the unconfirmed image back.

/// `wdt_hal_context_t` (hal/wdt_hal.h): the instance and a device pointer.
#[repr(C)]
struct WdtHalContext {
    inst: u32,
    dev: *mut core::ffi::c_void,
}

// hal/wdt_types.h
const WDT_RWDT: u32 = 0;
const WDT_STAGE0: u32 = 0;
const WDT_STAGE_ACTION_RESET_RTC: u32 = 4;

// Not in esp-idf-sys's bindings; plain functions in the hal and
// esp_hw_support components.
unsafe extern "C" {
    fn wdt_hal_write_protect_disable(hal: *mut WdtHalContext);
    fn wdt_hal_write_protect_enable(hal: *mut WdtHalContext);
    fn wdt_hal_config_stage(hal: *mut WdtHalContext, stage: u32, timeout: u32, behavior: u32);
    fn wdt_hal_enable(hal: *mut WdtHalContext);
    fn wdt_hal_disable(hal: *mut WdtHalContext);
    fn wdt_hal_feed(hal: *mut WdtHalContext);
    fn rtc_clk_slow_freq_get_hz() -> u32;
}

/// `RWDT_HAL_CONTEXT_DEFAULT()` for the ESP32-C6.
fn rwdt() -> WdtHalContext {
    WdtHalContext {
        inst: WDT_RWDT,
        dev: (&raw mut esp_idf_svc::sys::LP_WDT).cast(),
    }
}

/// Reset the chip unless [`disarm_rtc_watchdog`] runs within `secs`.
fn arm_rtc_watchdog(secs: u32) {
    let ticks = u64::from(secs) * u64::from(unsafe { rtc_clk_slow_freq_get_hz() });
    let ticks = u32::try_from(ticks).unwrap_or(u32::MAX);
    let mut ctx = rwdt();
    unsafe {
        wdt_hal_write_protect_disable(&mut ctx);
        wdt_hal_config_stage(&mut ctx, WDT_STAGE0, ticks, WDT_STAGE_ACTION_RESET_RTC);
        wdt_hal_enable(&mut ctx);
        wdt_hal_feed(&mut ctx);
        wdt_hal_write_protect_enable(&mut ctx);
    }
}

fn disarm_rtc_watchdog() {
    let mut ctx = rwdt();
    unsafe {
        wdt_hal_write_protect_disable(&mut ctx);
        wdt_hal_disable(&mut ctx);
        wdt_hal_write_protect_enable(&mut ctx);
    }
}

/// What the early boot gets before [`start`] knows `t_validate`.
const EARLY_GUARD_S: u32 = 60;

/// Slack on top of `t_validate`: the probation thread gets the first go
/// at a clean rollback, the watchdog only catches what it cannot.
const GUARD_MARGIN_S: u32 = 60;

/// First thing in `main` (and in every other binary built with this
/// sdkconfig): keep the bootloader's watchdog for an image on probation,
/// switch it off for any other.
pub fn rtc_watchdog_at_boot() {
    if is_pending_verify() {
        arm_rtc_watchdog(EARLY_GUARD_S);
    } else {
        disarm_rtc_watchdog();
    }
}

// ---------------------------------------------------------------------------
// Rollback report
// ---------------------------------------------------------------------------
//
// The image that fails probation emits `rolled_back` itself, but it is
// usually failing because it has no broker, so that event is lost. The
// image the bootloader falls back to reports it instead: at boot it
// finds the last invalid slot, and on its first broker session it emits
// one `rolled_back` event and records the slot as reported in NVS, so the
// report goes out once per rollback, however many reboots it takes to
// reach a broker. A rollback after a crash or reset (no probation verdict
// written) is reported the same way, with a generic reason.

/// NVS namespace of the rollback report. Survives a factory reset.
const RB_NAMESPACE: &str = "ota";
/// Why the last probation failed, written by the failing image.
const RB_WHY: &str = "rb_why";
/// Identity of the last invalid image already reported.
const RB_SEEN: &str = "rb_seen";

/// The NVS partition, parked by [`start`].
static NVS: Mutex<Option<EspDefaultNvsPartition>> = Mutex::new(None);

/// A rollback found at boot, waiting for the first broker session.
struct PendingRollback {
    identity: String,
    detail: String,
}

static ROLLBACK: Mutex<Option<PendingRollback>> = Mutex::new(None);

fn rb_nvs() -> Option<EspNvs<NvsDefault>> {
    let partition = NVS.lock().ok()?.clone()?;
    match EspNvs::new(partition, RB_NAMESPACE, true) {
        Ok(nvs) => Some(nvs),
        Err(e) => {
            log::warn!("ota: rollback record unavailable: {e}");
            None
        }
    }
}

fn nvs_get(key: &str) -> Option<String> {
    let nvs = rb_nvs()?;
    let mut buf = [0u8; 256];
    match nvs.get_str(key, &mut buf) {
        Ok(value) => value.map(str::to_string),
        Err(e) => {
            log::warn!("ota: reading {RB_NAMESPACE}/{key} failed: {e}");
            None
        }
    }
}

fn nvs_set(key: &str, value: &str) {
    if let Some(nvs) = rb_nvs()
        && let Err(e) = nvs.set_str(key, value)
    {
        log::warn!("ota: writing {RB_NAMESPACE}/{key} failed: {e}");
    }
}

fn nvs_remove(key: &str) {
    if let Some(nvs) = rb_nvs()
        && let Err(e) = nvs.remove(key)
    {
        log::warn!("ota: removing {RB_NAMESPACE}/{key} failed: {e}");
    }
}

/// What tells two images in the same slot apart: the ELF sha256 from the
/// app descriptor, or version and build time when it is missing.
fn image_identity(slot: &Slot) -> String {
    let label = slot_label(slot);
    match slot.firmware.as_ref() {
        Some(fw) => match fw.signature.as_ref() {
            Some(sig) => format!("{label} {}", hex(sig)),
            None => format!("{label} {} {}", fw.version, fw.released),
        },
        None => label,
    }
}

/// Boot: is there a rollback nobody has been told about? A recorded
/// verdict always counts (the same image can fail twice); without one, a
/// last invalid slot that differs from the last one reported does.
fn find_rollback(running: &str) {
    let slot = match EspOta::new().and_then(|ota| ota.get_last_invalid_slot()) {
        Ok(Some(slot)) => slot,
        Ok(None) => return,
        Err(e) => {
            log::warn!("ota: last invalid slot unreadable: {e}");
            return;
        }
    };
    let identity = image_identity(&slot);
    let why = nvs_get(RB_WHY);
    if why.is_none() && nvs_get(RB_SEEN).as_deref() == Some(identity.as_str()) {
        return;
    }
    let version = slot
        .firmware
        .as_ref()
        .map(|fw| fw.version.as_str().to_string())
        .unwrap_or_default();
    let why = why.unwrap_or_else(|| {
        format!(
            "{} did not confirm (reset or crash before its probation ended)",
            slot_label(&slot)
        )
    });
    let detail = format!("{why}; version {version}; now running {running}");
    log::warn!("ota: rolled back: {detail}; reported on the next broker session");
    if let Ok(mut guard) = ROLLBACK.lock() {
        *guard = Some(PendingRollback { identity, detail });
    }
}

/// First broker session after a rollback: emit it, then record it as
/// reported. Runs from the MQTT worker's connect hook, so the event is
/// queued while the session is up.
fn report_rollback() {
    let pending = match ROLLBACK.lock() {
        Ok(mut guard) => guard.take(),
        Err(_) => return,
    };
    let Some(pending) = pending else {
        return;
    };
    emit_progress("rolled_back", None, pending.detail);
    nvs_set(RB_SEEN, &pending.identity);
    nvs_remove(RB_WHY);
}

/// Where the writer's own `started` and `downloading` events go.
///
/// [`OtaWriter`] is reached from three places (the HTTP upload sink, a
/// pull, the console) and none of them carries the event bus, so the bus
/// is parked here by [`start`], which runs once at boot before any of
/// them can.
static PROGRESS_EVENTS: Mutex<Option<Sender<Event>>> = Mutex::new(None);

/// Publish one `ota` event on the parked bus. Silent when there is none
/// (the host tests, or a boot that failed before the bus existed).
fn emit_progress(phase: &str, progress: Option<u8>, detail: String) {
    let Ok(guard) = PROGRESS_EVENTS.lock() else {
        return;
    };
    if let Some(tx) = guard.as_ref() {
        let _ = tx.send(Event::new(
            super::now_ms(),
            EventKind::Ota {
                phase: phase.to_string(),
                progress,
                detail: Some(detail),
            },
        ));
    }
}

// ---------------------------------------------------------------------------
// Writing an image
// ---------------------------------------------------------------------------

/// Anything that can stop an update.
#[derive(Debug)]
pub enum OtaError {
    /// ESP-IDF refused (no slot, flash error, image header rejected).
    Esp(EspError),
    /// The image hash did not match what the caller promised.
    Sha {
        /// What the caller said.
        expected: String,
        /// What arrived.
        got: String,
    },
    /// The transfer stopped early or the source failed.
    Transfer(String),
    /// Nothing was written.
    Empty,
    /// The image is built for the other plane link, or does not say
    /// which one it drives (ADR 0006, architecture component 7).
    LinkKind(TagError),
}

impl core::fmt::Display for OtaError {
    fn fmt(&self, f: &mut core::fmt::Formatter<'_>) -> core::fmt::Result {
        match self {
            OtaError::Esp(e) => write!(f, "esp-idf: {e}"),
            OtaError::Sha { expected, got } => {
                write!(f, "sha256 mismatch: expected {expected}, got {got}")
            }
            OtaError::Transfer(m) => write!(f, "transfer failed: {m}"),
            OtaError::Empty => f.write_str("no image data"),
            OtaError::LinkKind(e) => write!(f, "wrong image: {e}"),
        }
    }
}

impl std::error::Error for OtaError {}

impl From<EspError> for OtaError {
    fn from(e: EspError) -> Self {
        OtaError::Esp(e)
    }
}

/// Streaming SHA-256 over whatever is written to the slot.
struct Sha256Stream(mbedtls_sha256_context);

impl Sha256Stream {
    fn new() -> Self {
        let mut ctx: mbedtls_sha256_context = unsafe { core::mem::zeroed() };
        unsafe {
            mbedtls_sha256_init(&mut ctx);
            mbedtls_sha256_starts(&mut ctx, 0);
        }
        Sha256Stream(ctx)
    }

    fn update(&mut self, data: &[u8]) {
        unsafe { mbedtls_sha256_update(&mut self.0, data.as_ptr(), data.len()) };
    }

    fn finish(&mut self) -> [u8; 32] {
        let mut out = [0u8; 32];
        unsafe { mbedtls_sha256_finish(&mut self.0, out.as_mut_ptr()) };
        out
    }
}

impl Drop for Sha256Stream {
    fn drop(&mut self) {
        unsafe { mbedtls_sha256_free(&mut self.0) };
    }
}

/// Result of a completed write.
#[derive(Debug, Clone)]
pub struct Written {
    /// Bytes written.
    pub len: usize,
    /// SHA-256 of what was written, lowercase hex.
    pub sha256: String,
    /// Slot the image went into.
    pub slot: String,
}

/// The one thing in the firmware that writes an app partition.
///
/// It implements [`granite_core::api::OtaSink`], which is a long-lived
/// `begin / write* / finish` object the HTTP upload route holds across
/// many socket reads. That rules out `EspOta::initiate_update`, whose
/// `EspOtaUpdate` borrows the `EspOta` it came from and so cannot be
/// stored next to it; `esp_ota_*` is called directly instead. `EspOta`
/// still does everything that needs no borrow: the slot table,
/// `mark_valid`, the rollback.
///
/// The image is hashed while it is written, so a truncated or tampered
/// transfer is caught without a second pass over flash. *Authenticity* is
/// ESP-IDF's job: with `sdkconfig.defaults.signing` in the build,
/// `esp_ota_end` refuses an image whose signature does not verify against
/// the embedded public key.
pub struct OtaWriter {
    partition: *const esp_partition_t,
    handle: Option<esp_ota_handle_t>,
    sha: Option<Sha256Stream>,
    written: u64,
    expected_sha256: Option<String>,
    slot: String,
    /// Total image length when the caller knew it, for the progress
    /// percentage.
    total: Option<u64>,
    /// `written` at the last `downloading` event.
    progress_at: u64,
    /// The hunt for the image's plane-link marker (ADR 0006,
    /// architecture component 7). Fed with every chunk, read in
    /// [`OtaWriter::finish`]: the marker can be anywhere in the image,
    /// so the verdict is only final once the last byte is in. Refusing
    /// at the end is enough - the boot partition is switched after it.
    tag: TagScan,
}

// The only non-Send field is a pointer into the partition table, which
// lives in flash for the lifetime of the firmware and is read-only.
unsafe impl Send for OtaWriter {}

impl Default for OtaWriter {
    fn default() -> Self {
        Self::new()
    }
}

impl OtaWriter {
    /// An idle writer. Nothing touches flash until [`OtaWriter::begin`].
    pub fn new() -> Self {
        OtaWriter {
            partition: core::ptr::null(),
            handle: None,
            sha: None,
            written: 0,
            expected_sha256: None,
            slot: String::new(),
            total: None,
            progress_at: 0,
            tag: TagScan::new(),
        }
    }

    /// Require this SHA-256 (hex) of the image before the boot partition
    /// is switched. The MQTT/API `ota` pull sets it; a push from the setup
    /// page has nothing to compare against and relies on the image
    /// signature instead.
    pub fn expect_sha256(&mut self, sha256: &str) {
        self.expected_sha256 = Some(sha256.trim().to_ascii_lowercase());
    }

    /// True while an update is open.
    pub fn is_open(&self) -> bool {
        self.handle.is_some()
    }

    /// Bytes written so far.
    pub fn written(&self) -> u64 {
        self.written
    }

    /// Open the inactive slot. `total_len` erases only what is needed.
    pub fn begin(&mut self, total_len: Option<u64>) -> Result<(), OtaError> {
        if self.handle.is_some() {
            return Err(OtaError::Transfer(String::from(
                "an update is already in progress",
            )));
        }
        let partition = unsafe { esp_ota_get_next_update_partition(core::ptr::null()) };
        if partition.is_null() {
            return Err(OtaError::Transfer(String::from(
                "no OTA slot to write (is the partition table the granite one?)",
            )));
        }
        self.slot = partition_label(partition);
        let size = match total_len {
            Some(n) if n > 0 => n as usize,
            // OTA_SIZE_UNKNOWN erases the whole slot, which is slower but
            // always correct.
            _ => usize::MAX,
        };
        let mut handle: esp_ota_handle_t = 0;
        esp!(unsafe { esp_ota_begin(partition, size, &mut handle) })?;
        self.partition = partition;
        self.handle = Some(handle);
        self.sha = Some(Sha256Stream::new());
        self.written = 0;
        self.total = total_len.filter(|n| *n > 0);
        self.progress_at = 0;
        self.tag = TagScan::new();
        let size = total_len
            .map(|n| format!("{n} bytes"))
            .unwrap_or_else(|| String::from("size unknown"));
        log::warn!("ota: writing {} ({})", self.slot, size);
        emit_progress("started", Some(0), format!("{} ({})", self.slot, size));
        Ok(())
    }

    /// One `downloading` event per [`PROGRESS_STEP_PCT`] of a known
    /// length, or per [`PROGRESS_STEP_BYTES`] when the length is unknown.
    fn report_progress(&mut self) {
        let step = match self.total {
            Some(total) => (total * u64::from(PROGRESS_STEP_PCT) / 100).max(1),
            None => PROGRESS_STEP_BYTES,
        };
        if self.written.saturating_sub(self.progress_at) < step {
            return;
        }
        self.progress_at = self.written;
        match self.total {
            Some(total) => emit_progress(
                "downloading",
                Some((self.written.min(total) * 100 / total) as u8),
                format!("{} of {total} bytes", self.written),
            ),
            None => emit_progress("downloading", None, format!("{} bytes", self.written)),
        }
    }

    /// Append a chunk.
    pub fn write(&mut self, chunk: &[u8]) -> Result<(), OtaError> {
        if chunk.is_empty() {
            return Ok(());
        }
        let Some(handle) = self.handle else {
            return Err(OtaError::Transfer(String::from("no update in progress")));
        };
        esp!(unsafe { esp_ota_write(handle, chunk.as_ptr().cast(), chunk.len()) })?;
        if let Some(sha) = self.sha.as_mut() {
            sha.update(chunk);
        }
        self.tag.feed(chunk);
        let before = self.written;
        self.written += chunk.len() as u64;
        if before / (64 * 1024) != self.written / (64 * 1024) {
            log::info!("ota: {} bytes", self.written);
        }
        self.report_progress();
        Ok(())
    }

    /// Verify the hash, close the update, and point the bootloader at the
    /// new slot. The caller reboots.
    pub fn finish(&mut self) -> Result<Written, OtaError> {
        let Some(handle) = self.handle.take() else {
            return Err(OtaError::Transfer(String::from("no update in progress")));
        };
        let digest = self
            .sha
            .as_mut()
            .map(|sha| hex(&sha.finish()))
            .unwrap_or_default();
        self.sha = None;
        let len = self.written;

        if len == 0 {
            let _ = unsafe { esp_ota_abort(handle) };
            return Err(OtaError::Empty);
        }
        if let Some(expected) = self.expected_sha256.clone()
            && expected != digest
        {
            let _ = unsafe { esp_ota_abort(handle) };
            return Err(OtaError::Sha {
                expected,
                got: digest,
            });
        }

        // One link per image (ADR 0006): an image for the other link, or
        // one that does not say, never gets the boot partition. Checked
        // before `esp_ota_end`, so the slot is abandoned the same way a
        // hash mismatch abandons it.
        match self.tag.verdict(RUNNING) {
            Ok(kind) => log::info!("ota: image is a {kind} plane-link build, like this one"),
            Err(e) => {
                log::error!("ota: refusing the image: {e}");
                let _ = unsafe { esp_ota_abort(handle) };
                return Err(OtaError::LinkKind(e));
            }
        }

        // esp_ota_end validates the image header and, with signing on, the
        // signature block; only then is the boot partition switched.
        esp!(unsafe { esp_ota_end(handle) })?;
        esp!(unsafe { esp_ota_set_boot_partition(self.partition) })?;
        log::warn!(
            "ota: {} written, {len} bytes, sha256 {digest}, boot partition switched",
            self.slot
        );
        Ok(Written {
            len: len as usize,
            sha256: digest,
            slot: self.slot.clone(),
        })
    }

    /// Give up on the image in progress. `otadata` is left untouched.
    pub fn abort(&mut self) {
        if let Some(handle) = self.handle.take() {
            let _ = unsafe { esp_ota_abort(handle) };
            log::warn!("ota: update aborted after {} bytes", self.written);
        }
        self.sha = None;
        self.written = 0;
        self.expected_sha256 = None;
        self.total = None;
        self.progress_at = 0;
        self.tag = TagScan::new();
    }
}

impl Drop for OtaWriter {
    fn drop(&mut self) {
        self.abort();
    }
}

/// `granite_core::api::OtaSink` over [`OtaWriter`]: the shape the HTTP
/// upload route holds in an `Arc<Mutex<dyn OtaSink + Send>>`.
impl ApiOtaSink for OtaWriter {
    fn begin(&mut self, total_len: Option<u64>) -> Result<(), String> {
        OtaWriter::begin(self, total_len).map_err(|e| e.to_string())
    }

    fn write(&mut self, chunk: &[u8]) -> Result<(), String> {
        OtaWriter::write(self, chunk).map_err(|e| e.to_string())
    }

    fn finish(&mut self) -> Result<OtaFinish, String> {
        let written = OtaWriter::finish(self).map_err(|e| e.to_string())?;
        Ok(OtaFinish {
            slot: written.slot,
            bytes: written.len as u64,
            reboot_required: true,
        })
    }

    fn abort(&mut self) {
        OtaWriter::abort(self);
    }
}

fn partition_label(partition: *const esp_partition_t) -> String {
    if partition.is_null() {
        return String::new();
    }
    let label = unsafe { (*partition).label };
    let end = label.iter().position(|c| *c == 0).unwrap_or(label.len());
    String::from_utf8_lossy(&label[..end]).into_owned()
}

/// Pull an image over HTTPS and install it.
///
/// `ca_pem` is the trust anchor; empty means "use the ESP-IDF global CA
/// store", which is nothing unless the build attached a bundle, so a
/// configured CA is effectively required.
pub fn pull(url: &str, sha256: &str, ca_pem: &str) -> Result<Written, OtaError> {
    // esp-idf-svc wants a 'static X509, and the connection lives only for
    // this call; leak one copy per pull rather than keep a global.
    let ca: Option<X509<'static>> = if ca_pem.trim().is_empty() {
        None
    } else {
        let mut bytes = ca_pem.trim().as_bytes().to_vec();
        bytes.push(0);
        let leaked: &'static [u8] = Box::leak(bytes.into_boxed_slice());
        Some(X509::pem(
            core::ffi::CStr::from_bytes_with_nul(leaked)
                .map_err(|e| OtaError::Transfer(format!("ca pem: {e}")))?,
        ))
    };

    let mut conn = EspHttpConnection::new(&HttpConfiguration {
        buffer_size: Some(PULL_CHUNK),
        server_certificate: ca,
        timeout: Some(Duration::from_secs(30)),
        follow_redirects_policy: esp_idf_svc::http::client::FollowRedirectsPolicy::FollowAll,
        ..Default::default()
    })?;
    conn.initiate_request(esp_idf_svc::http::Method::Get, url, &[])?;
    conn.initiate_response()?;
    let status = conn.status();
    if status != 200 {
        return Err(OtaError::Transfer(format!("http {status} for {url}")));
    }
    let len: Option<u64> = conn
        .header("Content-Length")
        .and_then(|v| v.trim().parse().ok());
    log::warn!("ota: pulling {url}");

    let mut writer = OtaWriter::new();
    writer.expect_sha256(sha256);
    writer.begin(len)?;

    let mut buf = [0u8; PULL_CHUNK];
    let outcome = loop {
        match conn.read(&mut buf) {
            Ok(0) => break Ok(()),
            Ok(n) => {
                if let Err(e) = writer.write(&buf[..n]) {
                    break Err(e);
                }
            }
            Err(e) => break Err(OtaError::Transfer(format!("read: {e}"))),
        }
    };
    if let Err(e) = outcome {
        writer.abort();
        return Err(e);
    }
    if let Some(expected) = len
        && writer.written() != expected
    {
        let got = writer.written();
        writer.abort();
        return Err(OtaError::Transfer(format!(
            "short read: {got} of {expected} bytes"
        )));
    }
    writer.finish()
}

/// True once an update has switched the boot partition and the firmware is
/// on its way to a reboot, so other tasks can stop accepting work.
static REBOOTING: AtomicBool = AtomicBool::new(false);

/// True while a planned OTA reboot is in progress.
pub fn rebooting() -> bool {
    REBOOTING.load(Ordering::Relaxed)
}

/// Reboot into a freshly written image through the planned-reboot path:
/// relays released first, then restart.
pub fn reboot_into_new_image() -> ! {
    REBOOTING.store(true, Ordering::Relaxed);
    super::planned_reboot("ota")
}
