delandtj/granite_controller/firmware/granite-core/src/dispatch.rs

//! The one dispatcher. MQTT, the HTTP API and Modbus all build a
//! [`Command`] and call [`dispatch`], so the three transports cannot
//! drift apart in what they allow (ADR 0001 components 7, 8, 9).
//!
//! Since rev D the dispatcher touches no hardware at all (ADR 0004
//! decision 6): it checks the target, turns the verb into a plane
//! command with the node's configured timings, hands it to the
//! [`PlaneClient`] and answers `accepted` with the job id. The job
//! finishes later, and the ack that carries the plane's result is built
//! from [`crate::jobs`]. A command for a node, unit or plane that is not
//! there fails here, before any write: the plane client itself finishes
//! such a job at once, so the reply is a refusal rather than an ack.
//!
//! Target `all` works with every node verb and becomes one plane job per
//! present node, each with that node's own settings - the same thing as
//! sending the verb to each node in turn. The ack goes out when the last
//! of those jobs has reported ([`crate::jobs`]), and `on_all` keeps its
//! own meaning: one staggered group command per plane.
//!
//! Everything the dispatcher cannot do itself (probe scan, OTA, reboot,
//! persisting a config section) still comes back as a [`SideEffect`] for
//! the firmware to carry out.

use alloc::string::{String, ToString};
use alloc::vec::Vec;

use serde_json::Value;

use crate::config::{Config, Section};
use crate::jobs::{JobLog, SubmittedJob};
use crate::msg::{Args, Command, CommandKind, PROTOCOL_VERSION, Reply, TargetKind};
use crate::observed::Observed;
use crate::plane::model::{HostState, PowerState};
use crate::plane::{
    Command as PlaneJob, JobId, NodeCommand, NodeOptions, PlaneClient, PlaneCommand,
};
use crate::rules::RuleEngine;
use crate::{NodeId, Target};

/// Work the firmware has to do on behalf of a command.
#[derive(Debug, Clone, PartialEq, Eq)]
pub enum SideEffect {
    /// Re-enumerate the 1-wire bus.
    ProbeScan,
    /// Persist one config section as it now stands in `Config`.
    SaveSection(Section),
    /// Persist one config section through the commit-confirm path,
    /// because getting it wrong can cut the session.
    StageSection(Section),
    /// Promote every staged section into the stored configuration: the
    /// confirm of ADR 0001 component 6, the same one the HTTP API does
    /// through `POST /api/v1/config/confirm`.
    ConfirmStaged,
    /// Put every staged section back to its stored value now, instead
    /// of waiting out the confirm window.
    RevertStaged,
    /// Pull and install an image.
    Ota {
        /// HTTPS URL.
        url: String,
        /// Expected SHA-256 of the image, hex.
        sha256: String,
    },
    /// Restart.
    Reboot,
    /// Erase everything but the factory namespace, then restart.
    FactoryReset,
    /// Hand one verb to the block-switch worker (ADR 0006 component
    /// 21). The dispatcher does not talk to the switch itself: the
    /// worker is the only thing that may, and it answers through
    /// events, not through this ack.
    Switch(SwitchRequest),
}

/// What the switch worker is asked to do.
#[derive(Debug, Clone, PartialEq, Eq)]
pub enum SwitchRequest {
    /// Enable or disable one port. `port` is a switch port; a command
    /// that named a node has already been resolved to one.
    Port {
        /// Which port, 1-based.
        port: u8,
        /// Admin state to set.
        enabled: bool,
        /// Touch a protected port anyway.
        force: bool,
    },
    /// Write the running configuration to the switch's flash.
    Save,
    /// Reboot the switch.
    Reboot,
    /// Factory-reset the switch.
    FactoryReset,
    /// Read the switch and apply the desired state now.
    Reconcile,
    /// The `switch` section was staged: apply it without saving and let
    /// the confirm timer run (ADR 0006 component 18).
    Staged,
    /// The staged section was confirmed: save the switch.
    Confirmed,
    /// The staged section was not confirmed in time: undo while the
    /// switch is reachable, reboot it otherwise.
    Revert,
}

/// Everything one command produced.
#[derive(Debug, Clone, PartialEq)]
pub struct Dispatched {
    /// The ack to publish or return.
    pub reply: Reply,
    /// The plane jobs it became, in order: one for a single node, one
    /// per present node for a node verb on `all`, none for a command
    /// the dispatcher answered itself.
    pub jobs: Vec<JobId>,
    /// What the firmware still has to do.
    pub effects: Vec<SideEffect>,
}

impl Dispatched {
    /// The job id the acks carry: the first of the group.
    pub fn job(&self) -> Option<JobId> {
        self.jobs.first().copied()
    }
}

/// What the dispatcher is allowed to touch.
pub struct DispatchCtx<'a> {
    /// Monotonic now.
    pub now_ms: u64,
    /// Device id, needed by `factory_reset`'s confirmation.
    pub device_id: &'a str,
    /// The current snapshot: what the target check reads.
    pub observed: &'a Observed,
    /// The plane client every verb goes through.
    pub plane: &'a mut PlaneClient,
    /// The pending-job log, so the ack can find the command id again.
    pub jobs: &'a mut JobLog,
    /// The rule engine.
    pub rules: &'a mut RuleEngine,
    /// The live configuration.
    pub config: &'a mut Config,
    /// The sections that are staged and waiting for a confirmation
    /// (ADR 0001 component 6). Read-only: the registry itself lives in
    /// the platform layer, and this is what lets `config_confirm` and
    /// `config_revert` answer "nothing is staged" without talking to
    /// it.
    pub staged: &'a [Section],
    /// The reserved signature hook (ADR: `Command.sig`). `None` means
    /// "the transport is the authentication", which is the shipped
    /// behaviour.
    pub verify_sig: Option<&'a dyn Fn(&Command) -> bool>,
}

/// Route one command.
pub fn dispatch(cmd: &Command, ctx: &mut DispatchCtx<'_>) -> Dispatched {
    let mut effects = Vec::new();

    if cmd.v != PROTOCOL_VERSION {
        return done(
            Reply::err(
                &cmd.id,
                alloc::format!("unsupported payload version {}", cmd.v),
            ),
            effects,
        );
    }
    if let Some(verify) = ctx.verify_sig
        && !verify(cmd)
    {
        return done(Reply::err(&cmd.id, "signature rejected"), effects);
    }

    if cmd.action.is_plane_verb() {
        return submit(cmd, ctx);
    }

    let reply = match cmd.action {
        CommandKind::RuleAck => match cmd.args.rule {
            None => Reply::err(&cmd.id, "args.rule is required"),
            Some(id) => {
                if ctx.rules.ack(id) {
                    Reply::ok(&cmd.id, "ok")
                } else {
                    Reply::err(&cmd.id, alloc::format!("no rule {id}"))
                }
            }
        },
        CommandKind::ProbeScan => {
            effects.push(SideEffect::ProbeScan);
            Reply::accepted(&cmd.id)
        }
        CommandKind::ConfigGet => match config_get(ctx.config, cmd.args.section) {
            Ok(v) => Reply::ok(&cmd.id, "ok").with_data(v),
            Err(e) => Reply::err(&cmd.id, e),
        },
        CommandKind::ConfigSet => {
            match config_set(ctx.config, cmd.args.section, &cmd.args.config) {
                Ok(sections) => {
                    let mut staged = false;
                    for s in sections {
                        if s.affects_reachability() {
                            staged = true;
                            effects.push(SideEffect::StageSection(s));
                        } else {
                            effects.push(SideEffect::SaveSection(s));
                        }
                    }
                    Reply::ok(&cmd.id, if staged { "staged" } else { "saved" })
                }
                Err(e) => Reply::err(&cmd.id, e),
            }
        }
        // The commit-confirm cycle over any transport, not just HTTPS
        // (ADR 0001 component 6; the MQTT command list of component 7
        // ties `config_set` to "the same commit-confirm rules" and this
        // is what makes finishing the cycle possible without the setup
        // page). Both answer `nothing is staged` rather than pretending
        // to have done something, the way the API's 409 does.
        CommandKind::ConfigConfirm | CommandKind::ConfigRevert => {
            if ctx.staged.is_empty() {
                Reply::err(&cmd.id, "nothing is staged")
            } else {
                let sections = section_list(ctx.staged);
                let confirm = cmd.action == CommandKind::ConfigConfirm;
                effects.push(if confirm {
                    SideEffect::ConfirmStaged
                } else {
                    SideEffect::RevertStaged
                });
                Reply::ok(&cmd.id, if confirm { "confirmed" } else { "reverted" })
                    .with_data(Value::Array(sections))
            }
        }
        CommandKind::Ota => match (&cmd.args.url, &cmd.args.sha256) {
            (Some(url), Some(sha256)) if !url.is_empty() && sha256.len() == 64 => {
                effects.push(SideEffect::Ota {
                    url: url.clone(),
                    sha256: sha256.to_ascii_lowercase(),
                });
                Reply::accepted(&cmd.id)
            }
            _ => Reply::err(
                &cmd.id,
                "args.url and a 64 hex digit args.sha256 are required",
            ),
        },
        CommandKind::Reboot => {
            effects.push(SideEffect::Reboot);
            Reply::accepted(&cmd.id)
        }
        CommandKind::FactoryReset => match &cmd.args.confirm {
            Some(c) if c == ctx.device_id => {
                effects.push(SideEffect::FactoryReset);
                Reply::accepted(&cmd.id)
            }
            _ => Reply::err(&cmd.id, "args.confirm must be the device id"),
        },
        action if action.is_switch_verb() => match switch_request(cmd, ctx) {
            Ok(request) => {
                effects.push(SideEffect::Switch(request));
                Reply::accepted(&cmd.id)
            }
            Err(e) => Reply::err(&cmd.id, e),
        },
        // Every plane verb is handled above.
        _ => Reply::err(&cmd.id, "unhandled action"),
    };

    done(reply, effects)
}

/// One switch verb as the worker's request, or why it cannot be one.
///
/// Everything that can be decided without talking to the switch is
/// decided here: that a switch is configured at all, that writes are
/// allowed (`switch.manage`), that `switch_port` names a port the
/// switch has - by port number or through the node the configuration
/// says is cabled to it - and that the two verbs which interrupt every
/// node carry the device id.
fn switch_request(cmd: &Command, ctx: &DispatchCtx<'_>) -> Result<SwitchRequest, String> {
    let cfg = &ctx.config.switch;
    if !cfg.enabled {
        return Err(String::from("the switch section is not enabled"));
    }
    if !cfg.manage {
        return Err(String::from(
            "switch.manage is false, so the controller does not write to the switch",
        ));
    }
    let confirmed = || -> Result<(), String> {
        match &cmd.args.confirm {
            Some(c) if c == ctx.device_id => Ok(()),
            _ => Err(String::from("args.confirm must be the device id")),
        }
    };
    match cmd.action {
        CommandKind::SwitchPort => {
            let enabled = cmd
                .args
                .enabled
                .ok_or_else(|| String::from("args.enabled is required"))?;
            let port = match (cmd.args.port, cmd.args.node.or_else(|| cmd.target.node())) {
                (Some(port), _) => port,
                (None, Some(node)) => ctx
                    .observed
                    .switch
                    .as_ref()
                    .and_then(|s| s.port_of_node(node))
                    .ok_or_else(|| {
                        alloc::format!(
                            "no switch port is bound to node {node}; name a port with args.port \
                             or set \"node\" on the port in switch.desired"
                        )
                    })?,
                (None, None) => {
                    return Err(String::from("args.port or args.node is required"));
                }
            };
            if !crate::switch::is_port(port) {
                return Err(alloc::format!(
                    "{port} is not a switch port (1..={})",
                    crate::switch::PORT_COUNT
                ));
            }
            Ok(SwitchRequest::Port {
                port,
                enabled,
                force: cmd.args.force,
            })
        }
        CommandKind::SwitchSave => Ok(SwitchRequest::Save),
        CommandKind::SwitchReconcile => Ok(SwitchRequest::Reconcile),
        CommandKind::SwitchReboot => {
            confirmed()?;
            Ok(SwitchRequest::Reboot)
        }
        CommandKind::SwitchFactoryReset => {
            confirmed()?;
            Ok(SwitchRequest::FactoryReset)
        }
        other => Err(alloc::format!("{} is not a switch action", other.as_str())),
    }
}

/// The staged sections as JSON strings, for the ack's `data`.
fn section_list(sections: &[Section]) -> Vec<Value> {
    sections
        .iter()
        .map(|s| Value::String(String::from(s.key())))
        .collect()
}

fn done(reply: Reply, effects: Vec<SideEffect>) -> Dispatched {
    Dispatched {
        reply,
        jobs: Vec::new(),
        effects,
    }
}

/// Check the target, submit the plane jobs, answer `accepted`.
fn submit(cmd: &Command, ctx: &mut DispatchCtx<'_>) -> Dispatched {
    let plane_jobs = match plane_jobs(cmd, ctx) {
        Ok(jobs) => jobs,
        Err(e) => return done(Reply::err(&cmd.id, e), Vec::new()),
    };
    if plane_jobs.is_empty() {
        // `on_all` with every present node already running: the verb
        // has nothing left to ask a plane for, so it is done.
        return done(Reply::ok(&cmd.id, "done"), Vec::new());
    }
    let mut submitted: Vec<SubmittedJob> = Vec::new();
    for job in plane_jobs {
        let nodes = job.nodes();
        let id = ctx.plane.submit(ctx.now_ms, job);
        submitted.push(SubmittedJob::new(id, nodes));
    }
    ctx.jobs
        .note(&cmd.id, cmd.action, cmd.target, &submitted, ctx.now_ms);
    let jobs: Vec<JobId> = submitted.iter().map(|s| s.job).collect();
    let first = jobs.first().copied().unwrap_or_default();
    Dispatched {
        reply: Reply::accepted(&cmd.id).with_job(first),
        jobs,
        effects: Vec::new(),
    }
}

/// The plane commands a verb and a target become, or why they cannot.
///
/// A node verb on one node is one command; on `all` it is one command
/// per present node, exactly what the same verb sent to each node would
/// be (ADR 0004 decision 4). `on_all` stays one command over the set:
/// the stagger is a plane-level sequence.
///
/// The presence check is the snapshot's: a node whose plane does not
/// answer, or whose slot holds no module, is refused here and nothing is
/// written (ADR 0004 decision 6, "commands to an absent node or plane
/// fail at once"). A node the controller has not read yet is let
/// through: the plane has the last word on presence.
fn plane_jobs(cmd: &Command, ctx: &DispatchCtx<'_>) -> Result<Vec<PlaneJob>, String> {
    if !cmd.target.is_valid() {
        return Err(alloc::format!("{} is not a target", cmd.target));
    }
    match cmd.action.wants() {
        TargetKind::Plane => {
            let plane = cmd
                .target
                .plane()
                .ok_or_else(|| String::from("this action needs a plane target"))?;
            let address = plane_address(plane, ctx)?;
            Ok(alloc::vec![PlaneJob::Plane(PlaneCommand::Reboot {
                address
            })])
        }
        TargetKind::Unit => {
            let (plane, unit) = cmd
                .target
                .unit()
                .ok_or_else(|| String::from("this action needs a unit target"))?;
            let address = plane_address(plane, ctx)?;
            if !ctx.observed.unit(plane, unit).is_some_and(|u| u.present) {
                return Err(alloc::format!(
                    "unit {unit} of plane {plane} is not present"
                ));
            }
            Ok(alloc::vec![PlaneJob::Plane(PlaneCommand::UnitReset {
                address,
                unit
            })])
        }
        TargetKind::Node => node_jobs(cmd, ctx),
    }
}

/// The address of a plane that answers.
fn plane_address(plane: u8, ctx: &DispatchCtx<'_>) -> Result<u8, String> {
    ctx.observed
        .plane(plane)
        .map(|p| p.address)
        .ok_or_else(|| alloc::format!("plane {plane} is not present"))
}

/// A node verb over one node or over every present node.
fn node_jobs(cmd: &Command, ctx: &DispatchCtx<'_>) -> Result<Vec<PlaneJob>, String> {
    // `on_all` is a group by definition and ignores a node target, the
    // way rev C did.
    if cmd.action == CommandKind::OnAll {
        return on_all_job(cmd, ctx);
    }
    // `all` is every present node, one job each: a node verb means the
    // same thing for a set as for one node, and the plane runs the
    // sequences side by side on their own slots.
    if cmd.target == Target::All {
        let nodes = ctx.observed.present_nodes();
        if nodes.is_empty() {
            return Err(String::from("no node is present"));
        }
        let mut jobs = Vec::new();
        for node in nodes {
            jobs.push(PlaneJob::Node(node_verb(cmd.action, node, &cmd.args, ctx)?));
        }
        return Ok(jobs);
    }
    let Target::Node(node) = cmd.target else {
        // What is left is a plane or unit target under a node verb.
        return Err(alloc::format!(
            "{} needs a single node target",
            cmd.action.as_str()
        ));
    };
    check_present(node, ctx)?;
    Ok(alloc::vec![PlaneJob::Node(node_verb(
        cmd.action, node, &cmd.args, ctx
    )?)])
}

/// `on_all`: a staggered `on` over the present nodes that are not
/// running (ADR 0004 decision 4).
///
/// A node whose host is up is left out of the command altogether, and
/// of the rest only the ones whose rail is down are named to the
/// plane's stagger - 0x4B switches every slot it is given off before it
/// releases them one at a time, so naming a powered slot would cut it.
/// The result is what the ADR asks for: `on_all` brings up what is off
/// and does not disturb what runs.
///
/// `Ok(vec![])` means "nothing to do": every present node is already
/// running, which the caller answers with a plain `done`.
fn on_all_job(cmd: &Command, ctx: &DispatchCtx<'_>) -> Result<Vec<PlaneJob>, String> {
    let present = ctx.observed.present_nodes();
    if present.is_empty() {
        return Err(String::from("no node is present"));
    }
    let mut nodes: Vec<NodeId> = Vec::new();
    let mut stagger: Vec<NodeId> = Vec::new();
    for node in present {
        let Some(obs) = ctx.observed.node(node) else {
            continue;
        };
        // A host that is up (steady LED or blinking in sleep) is left
        // alone; `on` on a sleeping host is not this verb's business.
        if matches!(obs.host, HostState::On | HostState::Sleep) {
            continue;
        }
        nodes.push(node);
        if !matches!(obs.power, PowerState::On | PowerState::Starting) {
            stagger.push(node);
        }
    }
    if nodes.is_empty() {
        return Ok(Vec::new());
    }
    let opts = group_options(&nodes, cmd, ctx);
    Ok(alloc::vec![PlaneJob::Node(
        NodeCommand::on_all_of(nodes, stagger).with_opts(opts)
    )])
}

/// One node verb on one node, with that node's own timings.
fn node_verb(
    action: CommandKind,
    node: NodeId,
    args: &Args,
    ctx: &DispatchCtx<'_>,
) -> Result<NodeCommand, String> {
    node_verb_with(action, node, args, args.apply_to(node_options(node, ctx)))
}

/// One node verb on one node with the options already resolved.
fn node_verb_with(
    action: CommandKind,
    node: NodeId,
    args: &Args,
    opts: NodeOptions,
) -> Result<NodeCommand, String> {
    let verb = match action {
        CommandKind::On => NodeCommand::on(node),
        CommandKind::Off => NodeCommand::off(node),
        CommandKind::ForceOff => NodeCommand::force_off(node),
        CommandKind::Cycle => NodeCommand::cycle(node),
        CommandKind::Reset => NodeCommand::Reset { node },
        CommandKind::Press => NodeCommand::Press {
            node,
            switch: args.press_switch(),
            ms: args.press_ms(),
        },
        CommandKind::PowerOn => NodeCommand::PowerOn { node },
        CommandKind::PowerOff => NodeCommand::PowerOff { node },
        CommandKind::ClearLatch => NodeCommand::ClearLatch { node },
        other => return Err(alloc::format!("{} is not a node action", other.as_str())),
    };
    Ok(verb.with_opts(opts))
}

/// A node the controller knows is not there is refused at once.
fn check_present(node: NodeId, ctx: &DispatchCtx<'_>) -> Result<(), String> {
    let (address, _) = crate::plane::node_location(node)
        .ok_or_else(|| alloc::format!("{node} is not a node id"))?;
    if ctx.observed.plane_at(address).is_none() {
        return Err(alloc::format!(
            "node {node} is on plane {} which is not present",
            address - granite_proto::ADDR_BASE
        ));
    }
    match ctx.observed.node(node) {
        Some(n) if n.present => Ok(()),
        Some(_) => Err(alloc::format!("node {node} is not present")),
        // The plane answers but this slot has not been read yet.
        None if ctx
            .observed
            .plane_at(address)
            .is_some_and(|p| p.info_ms != 0 && p.ts_ms == 0) =>
        {
            Ok(())
        }
        None => Err(alloc::format!("node {node} is not present")),
    }
}

/// The timings of one node.
fn node_options(node: NodeId, ctx: &DispatchCtx<'_>) -> NodeOptions {
    NodeOptions::of_settings(&ctx.config.nodes.settings(node))
}

/// The timings of a group: the shortest LED timeout and soft-off window
/// of the nodes in it, so no node in a staggered `on_all` waits longer
/// than its own setting allows.
fn group_options(nodes: &[NodeId], cmd: &Command, ctx: &DispatchCtx<'_>) -> NodeOptions {
    let mut opts = NodeOptions::default();
    for (i, node) in nodes.iter().enumerate() {
        let one = node_options(*node, ctx);
        if i == 0 {
            opts = one;
            continue;
        }
        opts.led_timeout_s = opts.led_timeout_s.min(one.led_timeout_s);
        opts.soft_off_s = opts.soft_off_s.min(one.soft_off_s);
    }
    cmd.args.apply_to(opts)
}

/// Grace an ack gets on top of the job's own deadline \[ms\].
///
/// A transport that waits for a plane job should give up *after* the
/// plane client has, so the ack a client sees is the client's
/// `timed_out` (which says what happened to the node) and not the
/// transport's "did not finish in time".
pub const ACK_GRACE_MS: u64 = 15_000;

/// How long a transport has to wait for this command's ack \[ms\].
///
/// Derived from the configuration, not a fixed constant: a node whose
/// `t_soft_off_s` is an hour needs an ack timeout of over an hour, and
/// a bare `press` needs seconds. It is the longest sequence the node's
/// settings allow ([`crate::plane::NodeCommand::worst_case_ms`]), plus
/// the plane client's job margin, plus [`ACK_GRACE_MS`].
///
/// For a command over `all` the worst case of any configured node is
/// taken, because the group is as slow as its slowest member.
pub fn ack_timeout_ms(cmd: &Command, nodes: &crate::config::NodesCfg) -> u64 {
    let opts = cmd.args.apply_to(worst_options(cmd.target, nodes));
    let worst = match cmd.action {
        CommandKind::OnAll => {
            // The stagger walks at most the slots of one plane.
            let slots: Vec<NodeId> = (1..=granite_proto::SLOT_COUNT as NodeId).collect();
            NodeCommand::on_all(slots).with_opts(opts).worst_case_ms()
        }
        action if action.is_node_verb() => node_verb_with(action, 1, &cmd.args, opts)
            .map(|verb| verb.worst_case_ms())
            .unwrap_or(crate::plane::SEQUENCE_SLACK_MS),
        action if action.is_plane_verb() => PlaneCommand::Reboot {
            address: granite_proto::ADDR_BASE,
        }
        .worst_case_ms(),
        // Not a plane verb at all: it is answered from the dispatcher.
        _ => 0,
    };
    worst + crate::plane::JOB_MARGIN_MS + ACK_GRACE_MS
}

/// The slowest settings any node this target can reach asks for.
fn worst_options(target: Target, nodes: &crate::config::NodesCfg) -> NodeOptions {
    if let Target::Node(node) = target {
        return NodeOptions::of_settings(&nodes.settings(node));
    }
    let mut opts = NodeOptions::default();
    for settings in &nodes.nodes {
        let one = NodeOptions::of_settings(&settings.clone().clamped());
        opts.led_timeout_s = opts.led_timeout_s.max(one.led_timeout_s);
        opts.soft_off_s = opts.soft_off_s.max(one.soft_off_s);
    }
    opts
}

/// `config_get`: one section, or the whole exportable document.
fn config_get(cfg: &Config, section: Option<Section>) -> Result<Value, String> {
    let json = match section {
        Some(s) => cfg.section_json(s).map_err(|e| e.to_string())?,
        None => cfg.export_json().map_err(|e| e.to_string())?,
    };
    serde_json::from_str(&json).map_err(|e| e.to_string())
}

/// `config_set`: one section, or a whole document. Returns the sections
/// that changed and therefore need persisting.
fn config_set(
    cfg: &mut Config,
    section: Option<Section>,
    body: &Option<Value>,
) -> Result<Vec<Section>, String> {
    let Some(body) = body else {
        return Err(String::from("args.config is required"));
    };
    let text = serde_json::to_string(body).map_err(|e| e.to_string())?;
    match section {
        Some(s) => {
            let mut probe = cfg.clone();
            probe
                .set_section_json(s, &text)
                .map_err(|e| e.to_string())?;
            probe.validate().map_err(|errs| errs.join("; "))?;
            *cfg = probe;
            Ok(alloc::vec![s])
        }
        None => {
            let next = Config::import_json(&text).map_err(|e| e.to_string())?;
            let mut changed = Vec::new();
            for s in Section::ALL {
                if cfg.section_json(s).ok() != next.section_json(s).ok() {
                    changed.push(s);
                }
            }
            *cfg = next;
            Ok(changed)
        }
    }
}
