delandtj/granite_controller/firmware/granite-core/src/observed.rs

//! The one sensor snapshot. Publishers, the rule engine and the API read
//! this; none of them ever touch the hardware or the plane link directly
//! (ADR 0001 component 4, ADR 0004 decision 7).
//!
//! The node, unit and plane parts are copied out of the plane client's
//! models once per cycle ([`Observed::refresh_planes`]), so every reader
//! sees the same picture for a whole tick and nothing has to borrow the
//! client while it is polling. The probes, the board temperature, VIN and
//! the dry inputs are still read by the firmware's own sense loop.
//!
//! Every field carries the monotonic millisecond timestamp of the reading
//! that produced it, so a consumer can tell a fresh zero from a stale one.

use alloc::string::String;
use alloc::vec::Vec;

use serde::{Deserialize, Serialize};

use crate::hal::RomId;
use crate::node::LastJob;
use crate::plane::model::{HostState, PowerState};
use crate::plane::{Node, Plane, PlaneClient, Unit};
use crate::{NodeId, UNIT_COUNT};

/// A value plus when it was read. `ts_ms == 0` means "never read".
#[derive(Debug, Clone, Copy, PartialEq, Eq, Default, Serialize, Deserialize)]
pub struct Stamped<T> {
    /// The reading.
    pub value: T,
    /// Monotonic milliseconds at the time of the reading.
    pub ts_ms: u64,
}

impl<T> Stamped<T> {
    /// A reading taken at `ts_ms`.
    pub const fn new(value: T, ts_ms: u64) -> Self {
        Stamped { value, ts_ms }
    }

    /// A placeholder that was never read.
    pub const fn never(value: T) -> Self {
        Stamped { value, ts_ms: 0 }
    }

    /// True when the reading is missing or older than `max_age_ms`.
    pub fn is_stale(&self, now_ms: u64, max_age_ms: u64) -> bool {
        self.ts_ms == 0 || now_ms.saturating_sub(self.ts_ms) > max_age_ms
    }
}

/// Joules in a watt-hour: the step the published energy figure is
/// rounded to (see [`NodeTelemetryObs::energy_wh`]).
pub const JOULES_PER_WH: u64 = 3_600;

/// What a node measures, in the plane's own units.
///
/// The raw wire scales are kept (10 mV, mA, 0.1 W, 0.1 C) so a rule can
/// compare without a conversion; the rounded accessors are what the
/// publishers use, because a payload that carries every milliamp would
/// make "publish on change" fire on noise (ADR 0004 decision 7).
#[derive(Debug, Clone, Copy, PartialEq, Eq, Default, Serialize, Deserialize)]
#[serde(default)]
pub struct NodeTelemetryObs {
    /// Voltage \[10 mV\].
    pub volts: u16,
    /// Current \[mA\].
    pub amps: u16,
    /// Power \[0.1 W\].
    pub watts: u16,
    /// Power minimum since the last min / max clear \[0.1 W\].
    pub watts_min: u16,
    /// Power maximum since the last min / max clear \[0.1 W\].
    pub watts_max: u16,
    /// INA238 die temperature \[0.1 C\].
    pub temperature: i16,
    /// Energy since the plane's first boot \[J\].
    pub energy_joules: u64,
    /// The plane boot count the energy figure belongs to.
    pub energy_boot_count: u32,
    /// The plane's module class code.
    pub module_class: u8,
    /// The power limit in force \[0.1 W\], 0 for none.
    pub power_limit: u16,
    /// Hot-swap retries inside the policy window.
    pub retry_count: u16,
}
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
