delandtj/granite_controller/(commit log)

2026-07-09 WIP schematic
    [granite_controller.kicad_sch, mcu_usb.kicad_sch, photomos_channel.kicad_sch, power_eth.kicad_sch, relays_a.kicad_sch, relays_b.kicad_sch]
2026-07-09 Reverse diode orientation
    [power_eth.kicad_sch]
2026-07-10 Swap to smaller MCU package with less pins
    [mcu_usb.kicad_sch]
2026-07-13 More schematic works
    [mcu_usb.kicad_sch, power_eth.kicad_sch, relays_a.kicad_sch, relays_b.kicad_sch]
2026-07-13 Fix photoMOS package and part, ethernet crystal
    [photomos_channel.kicad_sch, power_eth.kicad_sch, relays_a.kicad_sch, relays_b.kicad_sch]
2026-07-13 Add manufacturer and MPN to schematic parts
    [mcu_usb.kicad_sch, power_eth.kicad_sch, relays_a.kicad_sch, relays_b.kicad_sch]
2026-07-13 Proper footprint for photoMOS
    [power_eth.kicad_sch]
2026-07-13 Add custom footprints
2026-07-13 Finish adding external temp probes
    [mcu_usb.kicad_sch, power_eth.kicad_sch, relays_a.kicad_sch, relays_b.kicad_sch]
2026-10-05 Check in modified kicad_pro file
2026-10-07 Create PCB from schematic with PCBWay 4-layer stackup and rules
    Board generated from the netlist: 183 footprints linked to their
    symbols, nets assigned, parked off-board pending outline and placement.
    - Stackup: PCBWay default 4L 1.6 mm (7628, 1oz all layers),
    L1 sig / L2 GND / L3 PWR-mixed / L4 sig.
    - Board minimums set to PCBWay standard capabilities with margin.
    - Net class widths/clearances filled in; ETH MDI 100R diff
    (0.18/0.15) and USB 90R diff (0.22/0.15), computed, to be
    confirmed by PCBWay impedance control.
    - kicad_dru: 0.3 mm keepout around PoE input nets; 0.25 mm hole
    clearance except inside the USB4105 land pattern.
    [granite_controller.kicad_pcb]
2026-10-07 Exclude test pads and Tag-Connect land from BOM
    TP1-TP4 and J3 are bare copper with nothing to place; keep them out
    of the assembly BOM. Footprint attributes updated to match.
    [granite_controller.kicad_pcb, mcu_usb.kicad_sch]
2026-10-07 Add protected GPIO expansion header
    New sheet 'Expansion header' with J8, a 2x18 2.54 mm header (DNP),
    bringing out the 28 spare U1 GPIOs plus I2C1, 3V3 and 5V.
    - Each signal: 330R series resistor (4x0402 array, MCU side) and a
    TPD4E05U06 ESD clamp at the header pin.
    - 3V3 and 5V header pins: PTC fuse plus a TVS to GND.
    - PC13-PC15 stay unconnected (backup domain, LSE).
    - U1 spare pins labelled GPIO_<pin>; the I2C1 labels on U1 became
    global so the header can reach the bus. Net class patterns added
    for I2C1_*, HDR_3V3 and HDR_5V.
    - Board regenerated from the netlist (nothing was placed yet).
    [expansion.kicad_sch, granite_controller.kicad_pcb, granite_controller.kicad_sch, mcu_usb.kicad_sch]
2026-10-07 Rework for 8 nodes with MCP23017 relay drive
    Target is now 8 motherboards per frame (was 14 in the schematic).
    - relays_a/relays_b (14 channels, 28 photoMOS) replaced by one
    'Relay channels' sheet: 8 channels, 16 TLP176AM, J11-J18, same
    per-channel circuit and parts.
    - U14 MCP23017 @0x20 drives the LEDs: GPA0-7 = PWR_DRV1-8,
    GPB0-7 = RST_DRV1-8. R32 pulls EXP_nRESET low so U14 stays in
    reset (all buttons released) unless the MCU drives it; R33 pulls
    up the shared open-drain EXP_INT.
    - MCU: the two 14-bit drive buses are gone; PE2 = EXP_nRESET,
    PE3 = EXP_INT, the other 26 freed pins are no-connect.
    - Expansion header J8 grows to 2x20 and carries I2C1, EXP_nRESET
    and EXP_INT (pi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
    [expansion.kicad_sch, granite_controller.kicad_pcb, granite_controller.kicad_sch, mcu_usb.kicad_sch, relays.kicad_sch, relays_a.kicad_sch, relays_b.kicad_sch]
2026-10-07 Add power distribution board spec
    Draft component spec for an 8-channel 19 V power board fed by two
    3 kW supplies: per-node hot-swap switching with I2C monitoring,
    default-ON failure behaviour, interface over the J8 expansion
    header, verification plan and open decisions.
2026-10-07 Power board spec: hot-swap controller shortlist
    LTC4282 preferred (33 V, 16-bit V/I/P/energy, SOA foldback),
    LM5066I as fallback; list what to verify in the datasheet.
2026-10-07 Power board spec: select LTC4282 hot-swap controller
2026-10-07 Power board spec: fix open-decision numbering
2026-10-07 Power board spec: LTC4282 datasheet findings
    Addresses 0x40-0x47, default-ON via EEPROM FET_ON, OFF in RAM only,
    UV/OV dividers, latch-off default, 45 V abs max, 2 mOhm sense for
    ~14 A, external clock for energy accuracy, and the per-part EEPROM
    programming needed before first use.
2026-10-07 Power board spec: firmware EEPROM provisioning over I2C
2026-10-07 Power board spec: auto-retry on faults
    LTC4282 overcurrent/FET-bad auto-retry instead of latch-off; the
    controller counts retries and can disable a channel that keeps
    faulting.
2026-10-07 Add controller spec: ESP32-C6 + W5500, immersion requirements
    Component spec for the next controller revision: ESP32-C6-WROOM-1U
    with W5500 SPI Ethernet replacing STM32H563 + LAN8742A, split
    internal/external I2C buses, 2x8 expansion header, and material and
    impedance requirements for operation submerged in dielectric fluid.
2026-10-07 Controller spec: W5500 PHY network from WIZnet reference
    Termination, center taps, AVDD filtering and LED wiring taken from
    WIZnet's W5500 Ethernet Shield schematic; closes that open item.
2026-10-07 Rev C: ESP32-C6 + W5500 controller for immersion
    Schematic rework per docs/controller.md.
    - MCU: ESP32-C6-MINI-1-N4 replaces STM32H563VIT6 (KiCad-stock
    module). EN/BOOT test pads, USB-C via the C6 USB Serial/JTAG with
    22R series resistors behind the existing USBLC6.
    - Ethernet: W5500 over SPI replaces LAN8742A/RMII. PHY network,
    center taps, AVDD ferrite and LED wiring per WIZnet's W5500
    Ethernet Shield reference; ARJP11A magjack and PoE path unchanged.
    - I2C split: internal bus (relay MCP23017, TMP1075) on HP I2C with
    its own expander reset (EXP_nRESET_INT, GPIO14); external bus to
    the header (software I2C on GPIO6/7) with EXP_nRESET (GPIO4,
    pulled low) and the shared EXP_INT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
    [ethernet.kicad_sch, expansion.kicad_sch, granite_controller.kicad_pcb, granite_controller.kicad_sch, mcu.kicad_sch, mcu_usb.kicad_sch, power.kicad_sch, power_eth.kicad_sch]
2026-10-07 Tidy rev C schematic sheets
    Hand-style layout for the generated Power, Ethernet, MCU and
    Expansion sheets: functional grouping, real wires between
    neighbouring parts, labels kept for inter-sheet and named nets.
    Relay sheet: two text overlaps fixed. Title blocks set to rev C.
    Netlist unchanged (188 nets, 151 parts, identical connections and
    fields), ERC clean, symbol UUIDs preserved so the PCB stays linked.
    [ethernet.kicad_sch, expansion.kicad_sch, mcu.kicad_sch, power.kicad_sch, relays.kicad_sch]
2026-10-07 Add session handoff and board generation tools
    docs/handoff.md: state of rev C, decisions, open items, next steps
    and tooling gotchas for the next session. tools/mkboard.py and
    tools/setrules.py: build an unplaced board from a netlist and apply
    the PCBWay stackup, rules and net class values.
2026-10-07 Assign LCSC part numbers, mark PS1 DNP for JLC assembly
    Every BOM line except PS1 now carries an LCSC field. Generic passives
    move to JLC basic parts with equal or better ratings. Parts not stocked
    at LCSC are swapped: C1/C2 to T520D227M010ATE018 (10 V), F1 to
    0805L035/24XR, J8 to a generic gold 2x6 header, D6 to SMF3.3A.
    PS1 (Ag9905MT) is DNP: bought separately and hand-soldered.
    [ethernet.kicad_sch, expansion.kicad_sch, mcu.kicad_sch, power.kicad_sch, relays.kicad_sch]
2026-10-07 Power from the 19 V bus instead of PoE
    Drop the Ag9905MT PoE module and the ARJP11A PoE magjack. New J3
    (JST PH 2p) takes the frame's redundant 19 V bus: F3 PTC, D1 SMAJ22A
    TVS, D8 SS34 reverse-polarity diode, U8 LMR51430 buck (1.1 MHz,
    3.3 uH, 100k/13k -> 5.22 V) into the existing D2/D3 5 V OR-ing.
    J1 becomes a HanRun HR911105A plain magjack (pin 8 Bob Smith to GND,
    shield to ETH_SHLD). All new parts have LCSC numbers.
    Net classes PWR_POE/PWR_POE_5V become PWR_19V/PWR_BUCK_5V; the PoE
    clearance DRU rule is removed. Specs and handoff updated.
    [ethernet.kicad_sch, power.kicad_sch]
2026-10-07 Regenerate PCB for JLCPCB
    Fresh board from the current netlist (162 footprints, 0 parity issues),
    all parked off-board, no outline yet. Stackup switched to JLC04161H-7628
    (0.2104 mm 7628 prepreg, 0.5 oz inner). Diff pairs re-solved: ETH
    0.16/0.15 = 101R with the fluid above, USB 0.25/0.15 = 89R in air
    (service port). Docs updated for JLC as fab.
    [granite_controller.kicad_pcb]
2026-10-07 WROOM-1-N8, node power sensing, dry contacts, I2C port, VIN sense
    - U1 ESP32-C6-MINI-1-N4 -> ESP32-C6-WROOM-1-N8 (8 MB for two OTA
    slots; N16 is a drop-in). Project-local symbol and footprint from the
    datasheet. GPIO14 is not on the WROOM: EXP_nRESET_INT moves to
    GPIO10; GPIO11 spare.
    - Node connectors J11-J18 go to JST PH 5p: PWR_SW, RST_SW, node GND,
    PLED+, PLED-. PLED drives 2x TLP290-4 AC-input optos; 10k pull-ups
    -> U15 MCP23017 @0x21 GPA0-7 (NODE_ON1-8).
    - U15 GPB0-3: 4 dry-contact inputs (J10, RC + TPD4E05U06 ESD).
    - J9 I2C sensor port (JST PH 4p, Qwiic order) on the protected header bus.
    - VIN_SENSE 100k/10k divider to GPIO5 (ADC); J8 pin 9 now unused.
    [expansion.kicad_sch, mcu.kicad_sch, power.kicad_sch, relays.kicad_sch]
2026-10-07 Regenerate PCB for the WROOM-1, sensing and new connectors
    200 footprints parked off-board, 0 parity issues.
    [granite_controller.kicad_pcb]
2026-10-07 Board outline 180 x 40 mm with corner M3 holes
    tools/outline.py adds the Edge.Cuts rectangle (1 mm corners) and four
    board-only M3 NPTH holes 4 mm in from each corner; it is idempotent so
    it can be re-run after mkboard. mkboard now parks parts left of x = 0
    so the parking grid stays off the outline.
    [granite_controller.kicad_pcb]
2026-10-07 Board 230 x 40 mm and first grouped placement
    180 mm left the relay section ~90 % full; 230 mm gives ~70 %.
    tools/place.py anchors the big parts (RJ45 and USB-C on the top edge,
    WROOM antenna over the bottom edge, node connectors in two rows of
    four) and packs the rest per sheet. DRC with project rules: no copper
    or courtyard errors; silkscreen overlaps and routing remain.
    [granite_controller.kicad_pcb]
2026-10-07 Tidy silkscreen after placement
    tools/silk.py moves values to F.Fab, hides silk refs on small passives and
    places the remaining refs clear of pads, silk outlines and courtyards,
    connectors first. Silk DRC is clean apart from U1's intentional antenna
    overhang. place.py keeps a label lane under J6/J7/J9.
    [granite_controller.kicad_pcb]
2026-10-08 250 x 50 board, Ethernet placement, KRT routing, outer GND pours
    - place.py: 250 x 50 mm with a 0.8 mm packing gap; Ethernet chain placed
    in line (W5500 rotated so its PHY pins face the RJ45, 33R row,
    termination/coupling row, crystal under XI/XO); label lanes under the
    top-edge connectors.
    - setrules.py: signal vias 0.5/0.2, power/GND 0.6/0.3.
    - krt_route.sh: KiCadRoutingTools chain on a copy outside the repo
    (planes, Ethernet and USB pairs, then the rest on F.Cu/B.Cu only).
    - gndpour.py: GND pours on F.Cu/B.Cu plus 118 stitching vias.
    - Board: user's hand placement, routed and poured. DRC: 0 parity, 21
    unconnected, 3 undersized vias at the W5500 crossovers, 11 dangling
    vias; se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
    [granite_controller.kicad_pcb]
2026-10-08 Ignore KiCad local history and project lock files
2026-10-08 Targeted KRT reroute of the open nets; handoff update
    Ripped and re-routed the 16 open signal nets with everything else kept,
    then a GND pass without rip-up. Closed ETH_RXN, USB_CONN_D+ and HDR_IO5:
    21 -> 18 unconnected, violations unchanged (27). The rest is blocked by
    neighbouring copper and the RN1/RN2/U7/U18 pad field around J8.
    docs/handoff.md: current board state, next steps (spread J8 area, re-run
    the targeted pass, hand-route critical nets) and the pod/duck
    architecture under discussion.
    [granite_controller.kicad_pcb]
2026-10-08 Spread the J8 part field and rerun the targeted KRT pass
    Moved RN1/RN2 between U1 and J8 (rot 180, MCU side facing U1), U7 next to
    J8 pins 9-11 and U18 above J10. Strapped the TPD4E05 centre GND pads to a
    plane via, cleared all copper of the 22 affected nets (KRT's own rip left
    stubs) and rerouted them, then a GND pass. DRC: 18 -> 7 unconnected,
    27 -> 23 violations, 0 parity, no shorts or dangling tracks.
    tools/krt_reroute.sh captures the targeted pass for next time.
    [granite_controller.kicad_pcb]
2026-10-08 Route the whole board: critical nets by hand, power section re-placed
    - Ethernet MDI: J1 -> terminations -> 33R straight, TX/RX crossovers
    between the 33R row and the W5500 on 0.5/0.2 vias (replaces the three
    undersized 0.3/0.15 vias). W5500 AVDD joined under the LQFP body, GND
    pins 9/19 and EXRES fixed. Crystal: XO on F.Cu, XI under Y2 on B.Cu.
    - SPI/INT/RST: pin order is reversed between W5500 and ESP32, so each line
    transposes on its own B.Cu column near U1; CS/INT/RST pull-ups moved
    into the bundle with +3V3 plane vias.
    - GPIO_IO8/IO15 into RN2 by hand (IO15 under the module on B.Cu, clear of
    the thermal pad); surrounding nets rerouted by KRT.
    - USB: series resistors R34/R35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
    [granite_controller.kicad_pcb]
2026-10-08 Connector function labels and pin legends on the silkscreen
    tools/connlabels.py puts '<ref> <NAME>' next to every connector (NODE 1-8,
    19V IN, ETHERNET, USB, 1-WIRE, I2C, DRY IN, EXPANSION) and a short legend
    under each pin of the wire-to-board connectors, placed clear of existing
    silk and pads. DRC unchanged: 0 unconnected, 0 parity, 4 violations.
    [granite_controller.kicad_pcb]
2026-10-08 R15: swap to UNI-ROYAL 0402WGF1242TCE (C11692)
    Same 12.4k 1% 0402 for the W5500 EXRES; the YAGEO part (C138060) had 41
    in stock at JLC against 8 needed for the first build, C11692 has ~89k.
    MANUFACTURER, MPN and LCSC updated in the schematic and on the board.
    [ethernet.kicad_sch, granite_controller.kicad_pcb]
2026-10-08 tools/jlcfab.py: JLC Gerbers, drill, BOM and CPL
    One command for the JLC order files into fab/ (gitignored): 4-layer
    Gerbers and Excellon (zipped), BOM grouped by LCSC number, CPL with
    JLC rotation corrections for the packages on this board and a list of the
    corrected parts to check in JLC's placement preview.
2026-10-08 3D models for the photoMOS, optos, magjack and ESP32 module
    K1-K16 (TLP176AM), U16/U17 (TLP290-4) and J1 (HR911105A) from EasyEDA via
    easyeda2kicad, U1 from Espressif's KiCad library (CC-BY-SA 4.0). Stored in
    3dmodels/ and referenced through ${KIPRJMOD}; placement found by pad
    matching and checked in a 3D render. 3dmodels/README.md lists sources and
    offsets.
    [ESP32-C6-WROOM-1.step, HR911105A.step, TLP176AM_SO4.step, TLP290-4_SOP16.step, granite_controller.kicad_pcb]
2026-10-08 Handoff: three verification passes for the next session
    MCP validation suite (read-only tools only), a datasheet-driven review of
    the critical circuits with a concrete checklist, and JLC DFM (ask before
    uploading Gerbers). Findings go to docs/review-2026-10.md; no design
    changes without the user's go-ahead. Board-state notes brought up to date.
2026-10-08 Fix the 2026-10 review findings
    Schematic: NODE_ON8 to U15 GPB4 (GPA7 is output-only), F3 1206L075/33NR,
    VBUS bleeder R65/C52, R38 12.4k (BUCK_5V 5.44 V), D9 SMAJ6.0A crowbar on
    BUCK_5V, R101-R116 270R, C26/C27 15 pF, R39-R46 47k, D6 value.
    Layout: hole-clearance rule with units (0.3 mm) and 6.5 mm keep-outs at
    H1-H4, EN RC / decoupling / VIN_SENSE filter at U1, no F.Cu under the
    module body, vias kept off the U1 EPAD, zones 1 mm from the short edges
    for mouse-bite rails, silk 1.0/0.15 mm, autorouter vias moved out of
    SMD pads (only the U1 pad 29 thermal vias remain).
    tools/jlcfab.py: per-footprint rotation/centroid corrections checked
    against EasyEDA footprints (K*, U2, U8, JST fixed; U1,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
    [ethernet.kicad_sch, expansion.kicad_sch, granite_controller.kicad_pcb, power.kicad_sch, relays.kicad_sch]
2026-10-09 J2: GCT USB4105-GF-A -> HRO TYPE-C-31-M-12 (C165948)
    The GCT part is down to 140 at JLC. The HRO footprint has the same pins,
    pegs and shield slots (within 0.03 mm) but 1.45 mm signal pads that reach
    0.5 mm further in, onto the old rear fan-out.
    Rear escapes laid by script: D+ join at y 37.35, CC1/CC2 straight back,
    VBUS left pair to the front via, right pair to a rear via with a 0.5 mm
    B.Cu link under the body. KRT (krt_reroute.sh --keep) routed D+, CC1,
    CC2 and I2C_EXT_SDA from there; the SDA via it put in U1 pad 6 moved to
    (125.0, 70.0). J2 silk outline dropped (edge part, clashed with the
    shield pads at 0.15 mm), GND pads solid to the pour.
    tools/krt_reroute.sh: --keep routes from exis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
    [granite_controller.kicad_pcb, mcu.kicad_sch]
2026-10-09 Shorten the board 250 -> 199 mm
    Power, Ethernet and MCU blocks keep their placement and routing. The
    region right of x 134.8 is re-placed by tools/compact.py and rerouted
    by KRT:
    - top edge J6 (moved into the gap after J5) | J7 | J9 | J11-J14, bottom
    J8 | J10 | J15-J18; relay columns at 13.6 mm pitch (was 16.5), one
    resistor strip per column half;
    - U14 over U15 next to the relays; U16/U17 in the band between the top
    and bottom relay halves, inputs towards their connectors, NODE_ON
    pull-ups on the output side;
    - ESD parts next to their connectors, dry inputs one channel per row;
    - GND straps for the TPD4E05 centre pads and escape vias for their
    middle pads and RN1 pad 3 (KRT does n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
    [granite_controller.kicad_pcb]
2026-10-09 J2: 3D model for the HRO TYPE-C-31-M-12
    KiCad's library has no model for this part. STEP from EasyEDA/LCSC
    (C165948) via easyeda2kicad, placed at offset (0, 1.424, 0) rotation
    180 (EasyEDA origin 1.424 mm towards the signal pads, as in the JLC
    centroid correction). Checked in edge-on renders: mouth at the board
    edge, body flush on the board.
    [HRO_TYPE-C-31-M-12.step, granite_controller.kicad_pcb]
2026-10-09 Handoff: 199 mm board pushed, order zip, J2 model
2026-10-09 C36: KEMET C1812C102KGRACTU (C2167446, out of stock) -> Yageo CC1812KKX7RDBB102 (C118019)
    [ethernet.kicad_sch, granite_controller.kicad_pcb]
2026-10-09 Use pcbkit (~/Electronics/pcbkit) for the generic board tools; keep place.py and compact.py
2026-10-09 Firmware ADR 0001: Rust on ESP-IDF, MQTT + HTTPS setup page + Modbus TCP, reachability and relay safety
    Handoff updated with the 2026-10-10 decisions (ESP-IDF confirmed, northbound
    MQTT + HTTPS, Modbus required, network-only preconfiguration and reset).
2026-10-09 firmware: ESP-IDF skeleton for the ESP32-C6 (granite-fw)
    Stage 1 of ADR 0001: standalone crate on esp-idf-svc 0.53 / ESP-IDF
    v5.5.5, nightly + build-std for riscv32imac-esp-espidf. Holds the
    expander resets low first, blinks the status LED, prints the device id
    and eFuse Ethernet MAC, brings up the W5500 on SPI2 with DHCP, heartbeat.
    Partition table (nvs, otadata, coredump, factory, ota_0, ota_1) applied
    by espflash; signing is opt-in via sdkconfig.defaults.signing. Verified
    on the C6 devboard: 612 KB image, graceful failure without a W5500.
    Unsigned commit: the user is away and pre-authorised it.
    [partitions.csv]
2026-10-09 firmware: granite-core, the host-testable controller logic
    Workspace firmware/ (granite-fw excluded: own target config). granite-core
    is no_std + alloc: hal traits, node state machine, actuator with the
    action table and the press deadline, Observed snapshot, rule engine,
    Config with per-section fallback, Command/Reply/Event JSON, Modbus
    register map with markdown rendering, and the shared dispatcher. 96 tests.
    Departures from ADR 0001, to be folded in: release_all after every
    press (GPIO10 low between queued presses); validation ranges for t_on,
    t_soft_off, t_cycle, t_stagger, t_settle; rule thresholds in native
    units; accepted event, data on Reply, v on every payload; input register
    14 = m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
2026-10-09 ADR 0001: record the stage 1 deviations (core actuator, fw skeleton)
    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
2026-10-09 firmware: HTTP API in core, setup page, host simulator, HTTPS server glue
    granite-core::api: transport-agnostic route table with sessions, API
    tokens, PBKDF2 password, first-boot flow, /id + /recover (device token
    or fleet ECDSA signature), commit-confirm for net/mqtt/sec sections,
    OTA upload sink, 20 tests. firmware/web: plain HTML/JS setup page,
    gzip'd into web/dist for include_bytes. granite-sim: axum host build of
    the same page and API over fake hardware with scenarios, plus keygen,
    recover and modbus-map subcommands; docs/modbus_map.md generated.
    granite-fw/src/http.rs: EspHttpServer HTTPS glue (not wired yet).
    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
2026-10-09 granite-fw: hardware layer (expanders, relays with deadline, sense, probes, TMP1075, VIN, LED, LP I2C)
    MCP23017 driver on the ESP-IDF v5 i2c_master driver (both buses; the
    external bus is the real LP_I2C_NUM_0 on GPIO6/7, which needs
    CONFIG_I2C_SKIP_LEGACY_CONFLICT_CHECK because esp-idf-hal links the
    legacy driver). Relay presses arm an esp_timer deadline whose callback
    only drops GPIO10; panic hook does the same. DS18B20 via the
    espressif/onewire_bus component on RMT. hwtest feature + example
    verified on the C6 devboard: deadline dropped GPIO10 after 658 ms of a
    600 ms press, absent expanders are a logged fault, LP I2C scan runs.
    GPIO10 resets U14 and U15, so IDLE_IN_RESET is false: the li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
    [clock.rs, expanders.rs, ext_i2c.rs, hwtest.rs, i2c.rs, led.rs, mcp23017.rs, mod.rs]
2026-10-09 ADR 0001: GPIO10 idle-high decision, LP I2C and 1-wire paths as built
    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
2026-10-09 granite-core: Modbus TCP frame handler over slices (rmodbus), CIDR allow-list
    handle_frame for FC 1/2/3/4/5/6/15/16 against a RegisterImage built from
    Observed; holding/coil writes become Commands through the map; truncated
    frames are rejected before rmodbus can panic. 36 new tests. The ESP
    socket side (granite-fw/src/modbus.rs) lands with the platform commit it
    depends on.
    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
2026-10-09 granite-fw: platform layer (NVS store, identity, net, console, OTA, log ring), HTTPS wired, Modbus server
    Store over NVS with per-section JSON, secrets and factory namespaces;
    identity: device id, recovery token, fleet ECDSA key verify, self-signed
    ECDSA P-256 device cert through mbedTLS (40 ms); net: W5500 bring-up,
    DHCP/static, AutoIP via lwIP, mDNS component, SNTP with DHCP option 42,
    commit-confirm staging with revert; USB console; OTA writer on esp_ota
    implementing api::OtaSink with the probation ladder; log ring with a
    subscriber channel. main.rs now follows the ADR boot order with hw::init,
    sense/LED threads, dispatcher and http::start; mqtt and modbus remain
    INTEGRATION hooks. granit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
    [api_impl.rs, build.rs, config.rs, console.rs, hal.rs, identity.rs, logring.rs, main.rs]
2026-10-09 granite-fw: MQTT client (status/state/event/log/cmd/ack), mqtt-credentials API route
    esp-mqtt over TLS with CA and user/pass or client cert, LWT, retained
    status and state, events, log records above the configured level, cmd
    parsing into the shared dispatcher with acks on completion, 1-60 s
    reconnect ladder, connected flag feeding the OTA probation and the
    Observed.mqtt_connected rule source. Not wired into main.rs yet.
    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
2026-10-10 granite-fw: wire MQTT and Modbus into main, wifi-dev feature, README and handoff for the firmware
    MQTT and Modbus start from main with the shared command channel, event
    and log subscriptions, the OTA broker hook and a 5 s config watch that
    applies Modbus enable/allow-list changes. New cargo feature wifi-dev
    brings up Wi-Fi STA from GRANITE_WIFI_SSID/PASS at build time instead of
    the W5500, for network tests on the devboard; the default image is
    byte-identical without it. Verified on the C6 devboard: full boot, 280 KB
    free heap, HTTPS 443 / HTTP 80 listening, no panic over 95 s. Release
    image 1.72 MB.
    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
    [http.rs, main.rs, mod.rs, net.rs, wifi_dev.rs]
2026-10-10 granite-fw: rgb-led feature mirrors the status patterns on the devkit WS2812 (GPIO8), LedPattern::Fault
    RMT TxChannelDriver with 48 memory symbols so it coexists with the
    1-wire channel on the C6. devboard = wifi-dev + rgb-led.
    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
2026-10-10 site: mdBook installer/operator documentation for the controller
    Planning (what to provide, connections, network requirements, immersion
    constraints), commissioning in bring-up order (USB first boot, first
    setup, network, nodes, MQTT, Modbus, rules, pre-sealing checklist),
    operation (node control, LED, Home Assistant, OTA, recovery) and
    reference pages (pinouts, configuration, HTTP API, MQTT, Modbus map,
    console, building). The Modbus map and the Home Assistant page are
    included from firmware/docs so they stay single-sourced.
    Fact-checked against the firmware; the gaps found (boot policy not
    applied, target all refused except on_all, staged mqtt/sec need a
    reboot, dead-man on gateway ping o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
2026-10-10 site: theme in the board's own materials
    Solder-mask green and ENIG gold palette, light (board on the bench) and
    navy (the board itself); Atkinson Hyperlegible Next/Mono for body and
    code, Barlow Semi Condensed for headings and silkscreen legends, all
    self-hosted woff2 (OFL) so the site works on an isolated network.
    Pinout tables render pin numbers as pads (square pin 1), register maps
    get right-aligned mono addresses, the introduction opens with the
    199 x 50 board outline. Keyboard focus, reduced motion and print
    handled. theme/js labels tables by their first header; without it they
    are plain tables.
2026-10-10 firmware: close the gaps brief items 1-14 (boot policy, target all, fault bits, live MQTT/staged revert, dead-man, OTA progress)
    Core:
    - actuator: target `all` fans out over nodes.order for on/off/force_off/
    reset/cycle through the group path (off/force_off/reset: only nodes
    whose LED reads on, no stagger; on/cycle: t_stagger_ms); press stays
    per node. The shipped default rules now produce presses.
    - api: `?wait=1` on node actions holds the reply for the outcome via
    Dispatcher::wait_for (30 s cap); granite-sim implements it.
    - config: nodes.vin_min_mv / vin_max_mv window (0 = unchecked);
    mqtt.skip_time_check removed (older sections still load).
    Firmware:
    - main: one-shot boot poli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
2026-10-10 granite-fw: board-side `?wait=1` for HTTP node actions; handoff and gaps brief marked done
    http.rs: a request with ?wait=1 subscribes to the event bus before the
    command is queued, records the pending wait while api::handle runs, and
    only after every platform guard is dropped waits for the action_done /
    action_failed event of that command id (cap 30 s), then renders the
    final Reply through api::reply_response (now pub). Without an outcome
    the accepted reply stands. The wait still occupies the single httpd
    task, which the README and ADR say.
    docs/handoff.md and firmware/docs/gaps-2026-10.md carry a status block:
    all 14 items are implemented, with the list of what still needs a
    network or the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
2026-10-12 pcbkit.toml: KRT from pcbkit's default ~/Electronics/krt, no cache paths
2026-10-16 granite-fw: rev C bring-up fixes - W5500 SPI DMA, port-80 httpd stack
    On the first rev C board (2026-10-16):
    - SPI2 was set up without DMA, which caps a transaction at 64 bytes;
    every W5500 frame failed with 'txdata transfer > host maximum'. Now
    Dma::Auto(4096).
    - The plain port-80 server ran /id on a 6144-byte stack and overflowed
    in identity_response -> new_nonce (stack protection fault, reboot).
    Now 10240.
    Also gitignore firmware/*recovery_token* (per-board secrets).
2026-10-16 granite-fw: OTA slot reads fixed (app version), quiet esp_idf_svc::ota
    The ESP-IDF app version defaulted to git describe
    (rev-c-usb4105-25-gf6b075d, 25 chars); esp-idf-svc copies it into a
    24-char FirmwareInfo::version, so every slot read failed with
    ESP_ERR_INVALID_SIZE and /id showed the OTA state as unreadable. The
    version now comes from sdkconfig.defaults (CONFIG_APP_PROJECT_VER) and
    build.rs fails the build unless it equals the crate version and fits
    24 characters.
    esp_idf_svc::ota is filtered to Warn: it logged 'Dropped' on every
    status poll (every 3 s with the setup page open).
2026-10-19 handoff: rev C board 1 bring-up status; bench MQTT broker script
    docs/handoff.md: what board 1 proved (USB, hwtest, Ethernet, OTA
    rollback, MQTT over TLS), the fixes it forced, the espflash monitor
    gotcha, open nits and the next bring-up steps.
    firmware/tools/mqtt-broker.sh: mosquitto as the systemd user service
    granite-mqtt, 8883 TLS with a local CA + per-user passwords, 1883
    anonymous on localhost; state outside the repo.
2026-10-20 granite-fw: start SNTP before DHCP so option 42 servers are kept
    lwIP stores the NTP servers of a DHCP ACK only if 'servers from DHCP'
    mode is already on when the ACK arrives (dhcp_set_ntp_servers logs
    'Rejected' otherwise). SNTP was started after the board had an address,
    so with an empty net.sntp the clock never synced. It now starts in
    bring-up, right after the netif exists and before Ethernet (or the
    wifi-dev association) starts; the run loop keeps the old start as a
    fallback behind a shared SNTP_STARTED flag.
    Verified on rev C board 1 via OTA: clock synced 35 s after boot from
    the bench DHCP's option 42. Handoff updated.
2026-10-20 kicad_pro: KiCad re-serialization (explicit td_enabled, new ERC default, {} for empty net maps)
2026-10-20 handoff: MQTT live reconfigure and staged revert verified on board 1
2026-10-20 granite-fw: deadline-test feature; handoff: actuator press and deadline verified on board 1
2026-10-20 handoff: OTA pull, progress events and probation rollback verified on board 1; event gaps
2026-10-20 granite-fw: surviving image reports an OTA rollback on its first broker session
    The failing image's rolled_back event rarely leaves the board: no broker
    is the usual reason it failed. It now writes its verdict to NVS
    (ota/rb_why); the image the bootloader falls back to finds the last
    invalid slot at boot and emits rolled_back from the MQTT connect hook,
    then records the slot's ELF sha (ota/rb_seen) so it is sent once.
2026-10-20 granite-fw: RTC watchdog backs the OTA probation deadline
    The bootloader's RTC watchdog now stays on into the app
    (CONFIG_BOOTLOADER_WDT_DISABLE_IN_USER_CODE, app side only). A confirmed
    image switches it off at the top of main; an image on probation keeps
    it (60 s early, then t_validate + 60 s) until it marks itself valid, so
    an image that hangs before it can roll itself back is reset and rolled
    back by the bootloader. Bench feature boot-hang-test hangs a probation
    image at the top of main to prove it.
2026-10-20 Modbus TCP verified on board 1; unit 0/0xFF, last_result completion, socket table
    - Unit 0 and 0xFF were treated as a serial broadcast by rmodbus: a
    write ran and got no reply, so a client retried and pressed again.
    On TCP both now address this server and the request's unit is echoed.
    - Holding register 9 stayed 'accepted'; a watcher on the event bus now
    moves it to the outcome of the last command word's action.
    - CONFIG_LWIP_MAX_SOCKETS 10 -> 20 (Modbus got two connections), and
    ENFILE/EMFILE in accept backs off instead of dropping the listener.
2026-10-20 rules: force_off is a safety action, missing values can trip, watchdog on dispatcher and sense
    - Fired::request: a rule's force_off acts with force (an unknown node is
    no reason to leave it running in a leak) and preempt (new ActionArgs
    flag, not on the wire): the busy node's job ends failed: preempted,
    its relay opened first. Other rule actions follow the manual rules.
    - Rule.missing = ignore | trip; shipped rule 1 (probe_max) trips, so no
    probe answering is no longer a silent loss of the temperature watch.
    rule_fired value is null for a missing value.
    - The dispatcher (actuator + rules) and sense threads join the task
    watchdog, as ADR 0001 said they did. Bench feature
    dispatc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
2026-10-21 power-board: measurement and recording, I2C sufficiency, knowns and unknowns; fix J8 size and addresses
2026-10-21 power-board: galvanically isolated I2C on J8, no logging on the controller
2026-10-21 power-board: direction toward a 48-54 V bus with a common port front end and per-load port modules
2026-10-21 power: PM-19V-200W port module concept schematic (LTC7810 two-phase, 54 V -> 19 V) and spec
2026-10-21 pm-19v-200w: redraw the schematic with wires, power flow left to right, notes on sheet
2026-10-21 pm-19v-200w: footprints, DOSA eighth-brick pin footprint, first placement in 58.4 x 22.9 mm
2026-10-21 pm-19v-200w: placement for routing, power pours and via fields, KRT first pass (12 opens left at U1)
2026-10-21 pm-19v-200w: supervisor off U1, Q4 GND vias back, reroute: 4 opens left
2026-10-21 handoff: power expansion direction, PM-19V-200W module state, KRT v0.23.1
2026-10-21 handoff: KRT v0.23.1 re-run on pm-19v-200w, blockers at U1
2026-10-21 pm-19v-200w: U1 parts in pin order, R3/R1/TH1 to the left edge, gate drive 0.3 mm; fresh route: 6 opens at U1
2026-10-21 pm-19v-200w: back to the b444818 placement and board (4 opens, TH1 by the hot parts); keep 0.3 mm gate-drive width
2026-10-22 pm-19v-200w: hand-route the 4 U1 opens (OVLO, INTVCC, ITH1, TRACK/SS1); DRC 0 unconnected, 0 clearance
2026-10-22 pm-19v-200w: gndpour after the U1 hand routing (F.Cu/B.Cu GND pours, 7 stitch vias); DRC 0 unconnected
2026-10-22 pm-19v-200w: widen the VIN neck at J1.1 (B.Cu VIN pour wraps under C3.2, polygon in tools/power.py and on the board)
2026-10-22 pm-19v-200w: GND stitch via for the J1.3 F.Cu island, silk tidied (pcbkit silk); DRC down to the 7 old dangling vias
2026-10-22 power-board: carrier mounting section for PM-19V-200W (DOSA pins, host holes, soldered not socketed); pin 1 chirality checked against SynQor/Artesyn drawings
2026-10-22 pm-19v-200w: close the pin 1 chirality note in the DOSA footprint, board and handoff
2026-10-22 pm-19v-200w: via-in-pad check; drop the redundant SNS1P plane-tap via inside L1.2
2026-10-22 handoff: 2026-10-22 session (PM-19V-200W routed and checked, tools reinstalled, handroute/view in pcbkit)
2026-10-22 power: PM-19V-200W bench carrier (DOSA socket with Mill-Max receptacles, terminals, test points, LEDs); carrier hole pattern is not mirrored (doc corrected)
2026-10-22 pm-bench-carrier: pour GND before routing so KRT draws no GND tracks (zones kept via group power); DRC clean, 0 GND tracks
2026-10-22 pm-bench-carrier: LCSC numbers on the SMD parts, fuse 10 A (0451010.MRL); jlcfab BOM/CPL filled
2026-10-22 pm-19v-200w: large 19 V silk legend on both sides (L1 ref moved up); handoff: 24 V variant recipe
2026-10-22 power-board: current/power measurement section (where it lives, J2 reporting decision, bench readout), module silk legend and 24 V variant recipe
2026-10-23 power-board: power plane spec (PP-48-xS, one slot kind, 2/4/8 slots, STM32 per plane behind the isolator, register map sketch, safety rules); supersedes no-MCU decision; J2 to 7 pins; handoff
2026-10-23 power-board: node control (PWR/RST/PLED) moves to the plane slots; controller fed from a plane's always-on 12 V aux output (decision 8 closed, slot-1 feed rejected); register map and open items updat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
2026-10-23 power-board: front end part decided: LM5069-2 + INA238 on one 3.5 mOhm shunt (comparison table with datasheet numbers and LCSC stock; ADM1272, LTC4286/4287, LM5066I rejected); LTC4282 sections marked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
2026-10-23 adr 0001: 48 V power plane and slimmed controller (Proposed); pointers from power-board.md and handoff
2026-10-23 adr 0001 accepted: fixed-offset register map, one node housing, STM32G0B1, policy on controller / primitives on plane; spec and handoff follow
2026-10-23 adr 0001: message format is TLV over I2C (blocks, tags, CRC-8) instead of fixed register offsets
2026-10-23 power: PP-48-2S plane project started: generated schematic (tools/gensch.py, core + 2 slot blocks, ERC clean), project symbol/footprint libs, pcbkit.toml, initial board (mkboard/outline/setrules); AD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
2026-10-24 power: PP-48-2S WIP checkpoint: placed, power copper, gndpour, KRT routed
    tools/place.py (sockets, node connectors, bus terminal, MCU corner),
    tools/power.py (VBUS trunk/artery/bar on B.Cu, slot SENSE/OUT/NODE,
    GND stubs for fine-pitch pads, GND zones into the kept group),
    tools/syncfields.py; gensch.py fills LCSC numbers (116 of 174).
    Outline 150 x 95 mm, clearance 0.15 mm, KRT with --ordering mps
    --no-stub-layer-swap. DRC: 4 unconnected (+3V3 C203, /FB2 C13,
    /S1_ID U3, /S1_LQ U103), 2 clearance (S1_OUT/S1_PGD 0.149 mm),
    3 starved thermals, silk untouched. Netlist pp-48-2s.xml matches
    the schematic.
2026-10-24 power: PP-48-2S opens closed by hand, DRC 0 unconnected / 0 clearance
    tools/handroute/10-60: +3V3 C203.1, /FB2 C13.1 (+12V tap via moved
    right of C13.2), /S1_LQ U103.5 (via between the pad rows, PWR west),
    S1_PGD diagonal off the S1_OUT corner, /S1_ID to the MCU (via under the
    LQFP body, PWR lane at y 133.3), +3V3 pad stubs restored after prune.
    Dangling KRT leftovers pruned, GND refilled. Left: 4 starved_thermal
    warnings, silk. Flow comment in pcbkit.toml, handoff updated.
2026-10-24 power: PP-48-2S silk tidied and connector labels placed
    pcbkit silk (values to Fab, small parts' refs hidden, 52 refs placed)
    and connlabels (names for the 9 connectors, pin legends on J1, J4,
    X102, X202; J2/J3 legends do not fit, see handoff). DRC: 0 unconnected,
    0 clearance, 0 silk overlap; 4 starved_thermal and 1 silk_edge warning.
2026-10-24 power: PP-48-2S J2/J3 moved 1.7 mm inboard, corridor rerouted, pin legends on all headers
2026-10-24 adr 0002: schematic generator rewrite, drawn blocks on hierarchical sheets (proposed)
2026-10-24 power: schematic drawing engine (tools/sch) and netlist checker (ADR 0002 components 1, 2, 5)
2026-10-24 power: PP-48-2S schematic regenerated as drawn hierarchical sheets (ADR 0002)
    tools/gensch.py now writes a root sheet and sheets/{input,bucks,mcu,link,
    expanders,slot}.kicad_sch from the drawing engine in tools/sch (blocks
    in tools/sch/blocks); the slot is one file instantiated per slot.
    ERC 0 (--severity-all). tools/schcheck.py: every (ref, pin) -> net
    identical to the previous flat netlist, 71 nets renamed to sheet-path
    names, 4 expected field differences (shared slot sheet). Board relinked
    with pcbkit relink: 174 paths, 71 nets, DRC unchanged (0 unconnected,
    4 starved_thermal, 1 silk_edge). power.py and the handroute plans carry
    the new net names. Regenerate twice is byte identical.
2026-10-24 power: PP-48-2S four fixes: LED polarity, LM5164 ripple network, latch clear driver, brick sense checked
    LEDs: Device:LED pin 1 is K; every LED had the resistor on pin 1 and
    GND on pin 2. Nets swapped (LEDnn_K -> LEDnn_A), footprints turned 180
    degrees (plan 80). Ripple injection: TI SNVSAU4D Table 6-1 / Fig 7-1
    have CA node -> VOUT and CB node -> FB; tables fixed, C5/C6 and
    C12/C13 swapped places and rewired on the board (plans 81, 82). Latch
    clear: Sn_LCLR now drives the Q104/Q204 gate (+ R112/R212); the latch
    node is /Slot n/CLRN (plans 81, 83). Brick SENSE+/-: the PM-19V-200W
    module leaves pins 5-7 unconnected, X1.5/X1.7 stay NC.
    ERC 0; schcheck shows exactly the intended pin changes; bo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
2026-10-24 power: syncfields ported to KiCad 10, PP-48-2S board fields synced from the schematic
    FOOTPRINT.GetFieldByName is gone in KiCad 10; use HasField / GetField /
    SetField by name. Description added to the synced fields, --dry option,
    per-change report. Run on the board: 108 Value / LCSC / Description
    fields on 174 footprints, kicad-cli drc --schematic-parity 0 mismatches
    (was 104), copper untouched, DRC the same 5 warnings.
2026-10-26 power: PP-48-2S fab export settings; ignore STEP exports and production/ output
2026-10-26 power: PP-48-2S plane MCU STM32G0B1CBT6 -> STM32G070CBT6 (G0B1 out of stock at LCSC; pinout checked, 8-slot S7 pins moved off the unbonded 29/32); handoff: JLC stock check
2026-10-26 power: PP-48-2S L2 Bourns SRR1260-680M (0 at LCSC) -> Sumida CDRH127/LDNP-680MC C2452974; datasheet land pattern equals the 12x12 footprint pads
2026-10-26 pm-19v-200w: LCSC numbers on 52 of 58 parts (schematic and board); handoff: open module parts and brick pin research
2026-10-26 power-board: module mounting decision changed to screwed (M2 into SMT standoffs on the plane), not soldered DOSA pins
2026-10-26 power: screwed PM module mount footprints (M2 into SMT standoffs, pogo aux) on module, plane and bench carrier; RUN moves to aux pad 8; copper not yet rerouted
2026-10-26 handoff: 2026-10-26 evening, mount commit undecided (tags pm-mount-before / pm-mount-drawn), plane tile and module decisions, open questions
2026-10-26 handoff: open questions 7 (fuse-free protection chain, tile hot-swap) and 8 (250 W module, plane sizing)
2026-10-26 Revert "power: screwed PM module mount footprints (M2 into SMT standoffs, pogo aux) on module, plane and bench carrier; RUN moves to aux pad 8; copper not yet rerouted"
    This reverts commit abb9f50ba34d0b63e5425fa3cd376420f2890e7d.
2026-10-26 docs: plane tile requirements (R1-R22) and ADR 0003 (1x4 tile, identical columns, I2C mux, screwed 250 W module, fuse-free protection), Proposed
2026-10-26 docs: module interface spec (polarised M2 screw pattern, pads, 2x3 aux map, ID table, heights); handoff: questions 1-8 answered, docs to review
2026-10-26 ADR 0003: review asks 1-3 answered (names, tile LM5069-1 latch-off, module as new project pm-19v-250w); INT options written out
2026-10-26 ADR 0003: INT per column to MCU pins; decision 14 ground boundary, isolated 12 V aux replaces the LM5164 aux buck; requirement R20a
2026-10-26 pm-19v-250w: new project from pm-19v-200w; schematic: J1 screw pads (pm:PM_Mount_M2, 1 VIN 2/3 GND 4 VOUT), J2 2x3 aux pads (OV_KILL PGOOD ID RUN GND GND), RUN moves to the aux, TH1 NTC removed, R16 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
2026-10-26 pm-19v-250w: sense R9/R10 8 -> 7 mOhm (YLRY12-2-7F C20608751; limit ~16-21 A total), R8 15k -> 13k (same crossover with the lower sense resistance); LTC7810 typ/max sense threshold still to confirm
2026-10-26 pm-19v-250w: L1/L2 Coilcraft XAL1510-223 (18.7 A Isat, 16 mOhm, consigned), C24/C25 KEMET T523H 100u 35V polymer 7360-20 (C2158991, 2.0 mm high, goes on B)
2026-10-26 pm-19v-250w: new placement (XAL1510 on F, polymers C24/C25 and phase FETs on B, screw keep-outs clear, aux pads on B at the output end); screw via ring pads 0.65 mm (annular); board rebuilt from the 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
2026-10-26 pm-19v-250w: placement reworked for the via fields (U1 left/up for the phase 2 fan-out, D2/C19 beside SW2, RUN divider on F at the input end), power.py: B/F pours, In1 VIN feed, GND islands under the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
2026-10-26 pm-19v-250w: KRT first pass, 25/32 nets routed, 10 opens in the U1 gate-drive fan-out (TG1 TG2 BOOST1 BOOST2 DRVCC INTVCC OVLO); 0 copper clearance errors, parity clean; handoff updated
2026-10-26 pm-19v-250w: U1 neighbourhood reorganised for hand-routing the gate drive: U1 small-signal passives to 0402 (C10 C12-C19 R5-R8, JLC parts), VFB/ITH1 network in a pocket above pins 45-47, corridor abo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
2026-10-26 pm-19v-250w: KRT pass on the reorganised placement: 22/32 routed, 14 opens all at U1 pins (TG1 TG2 BOOST1 BOOST2 DRVCC INTVCC RUN OVLO VIN_IC VFB), left for hand routing; 0 copper clearance errors, p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
2026-10-26 carrier.pretty: mount footprints regenerated by pmmount.py
2026-10-26 handoff: PM-19V-250W U1 reorg, 14 opens for hand routing, krt-route cwd gotcha
2026-10-26 pm-19v-250w: U1 turned to rot 0 and moved 2 mm left, phase pairs swapped in placement (Q3/Q4/L2/R10 top = phase 2, Q1/Q2/L1/R9 bottom = phase 1) so each drive group faces its FETs; bootstraps at thei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
2026-10-26 pm-19v-250w: supervision block grouped at the input end (dividers and VAUX caps to 0402), RUN/OVLO divider on B at the input end, R16 by J2; hand drive routes kept (group 'hand', krt keep_groups); KR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
2026-10-26 handoff: PM-19V-250W routing state (U1 rot 0, phase pairs swapped, hand drive routes, 14 opens)
2026-10-27 pm-19v-250w: R10 beside L2 pad 2 (phase 2 strip drop out of the sense loop, no VIN trace on F), input end hand-routed (tools/route_input.py: Kelvin SENSE1/2, compensation on F, RUN/NDRV under U1 on I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
2026-10-27 handoff: PM-19V-250W costing (LCSC prices, Digikey LTC7810), APS1510M220F inductor alternative, polymer vs ceramic notes, next steps
2026-10-27 pm-19v-250w: silk (pcbkit silk) + tools/silk_labels.py: J1 ref hidden, screw net labels VIN/GND/GND/VOUT on both sides (B VOUT: no room), J2 ref on B by its pads; silk DRC 105 -> 2 (both footprint-in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
2026-10-27 handoff: keep the LTC7810; single-phase 100 V controller candidates (LM5116, SCT82A30, LM5146) noted for a possible volume revision
2026-10-27 pm-19v-250w: L1/L2 COILANK APS1510M220F (C49261404, JLC stock) on the XAL1510 footprint (terminals match the pads, body inside the courtyard)
2026-10-27 pm-bench-carrier schematic: screwed PM mount (SO1-SO4 M2 SMT standoffs S1 VIN / S2 GND / S3 GND / S4 VOUT, PG1-PG6 pogos on A1-A6) replaces the DOSA socket X1 and aux socket X2; sense jumpers JP2/JP3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
2026-10-27 pm-bench-carrier rev 0.2 board: screwed PM mount placed from pmmount.host_parts (SO1-SO4, PG1-PG6, MOD1 outline), trunks end on the standoffs, VOUT 4 mm for 13.2 A, Kelvin TPs at the screw x; rebuilt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
2026-10-27 handoff: LTC7810 from JLC stock (C581067, 13 pcs), no consignment; jlcfab run for both boards, pre-order checks listed
2026-10-27 handoff: ordered next steps for the next session (U2/U3 + C13 sourcing, JLC upload and rotation check, pogo sample)
2026-10-27 pm-19v-250w: BG2 on B.Cu only, no vias (Q4 gate via sat 0.2 mm from L1's SW1 pad); R1's VIN via down 0.6 mm to clear the lane; route scripts match; DRC unchanged, 0 unconnected
2026-10-27 pm-19v-200w obsolete (superseded by pm-19v-250w, not for order): README note, handoff updated; handoff: pogo C5157258 wrong for the 6 mm gap, aux contacts moving to a 2x3 header + socket (search runn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
2026-10-27 PM aux contacts: 2x3 1.27 mm SMT header (module J2, C41376035) into SMT socket (carrier J3, C41397112) replaces flat pads + pogos; standoffs M2 x 7 (C2916355), gap 7.0 mm. pmmount.py generates the ne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
2026-10-27 handoff: route_aux.py in the module board flow
2026-10-28 pm-19v-250w silk: silk_labels.py places hidden references next to their own part (ownership + label spacing, glyph boxes), screw labels off the gap between a column's screws, B VOUT label; DRC unchan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
2026-10-28 plane: ADR 0004 (Proposed) - N = 2/4/6/8 identical 25 mm columns, ~75 mm tall, front end under the module, rotating SDA/SCL channel to a left-end core, INT polled, ID via per-column I2C ADC; ADR 0003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
2026-10-28 ADR 0004: end cap with a second 30 A hot-swap for N = 6/8, plane mounting holes at the ends only (user decisions); handoff
2026-10-28 ADR 0004: N = 2/4 right-hand mounting holes in a narrow end strip (user decision); handoff
2026-10-28 ADR 0004: node power on a Degson DG128 2-pole screw terminal (C711349), front panel JST GH 1x4, ID ADC ADC121C027, 25 mm pitch, plane ~72 mm; channel band under the modules; R21 and ADR 0003 decision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
2026-10-28 pp-48: new plane project, column schematic generated (ADR 0004): PP-48-2S slot front end + screwed module mount (SO1-SO4, J3 aux socket) + TCA9535 + ADC121C027 ID ADC + RUN FET + segment pull-ups, DG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
2026-10-28 pp-48: placement draft for review (2 columns, 50 x 72 mm, unrouted): tools/place.py one column table copied by translation, front end under the module, tall parts on B; DG128 footprint; cable-side NO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
2026-10-28 pp-48: column 1 routed (first pass) and copied to column 2: route_hand.py (power pours, shunt vias, gate, INA238 Kelvin, In2 rotating channel and taps, +3V3 trunk, column-edge rule areas), krt-route 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
2026-10-28 pp-48: GND as F / In1 / B pours in the kept group (no GND tracks), route_hand.py re-run after KRT restores the In2 +3V3 trunk; column 1 rerouted and copied, open: OVK per column; handoff
2026-10-28 pp-48: placement rework by signal flow (expander in the middle, pins reassigned by board side; enable chain and latch under the LM5069; ID ADC, RUN FET, pull-ups around the socket; photoMOS / opto ba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
2026-10-28 pp-48: DRC clean: solid connections on the starved GND pads, U3 +3V3 router stub removed, last column's +3V3 trunk ends at its tap, module outline Fab only on the plane (pmmount host_outline(silk=Fal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
2026-10-28 pp-48: slot OVLO 124k / 4.99k (64.6 V, 60.9-68.5 V worst case, below the module's 67.5 V nominally); D1 SMBJ60A kept (breakdown >= 66.7 V, SMBJ64A clamps at 103 V); values synced to the board, DRC un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
2026-10-28 pp-48: slot latch also set by the INA238 ALERT (straight onto OVK, R25 gone) and by PGOOD loss with arm-on-first-PGOOD blanking (U10 set while PG and PGD high via Q8 / Q9, cleared while PGD low; trip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
2026-10-28 docs: plane 12 V aux dropped (ADR 0003 decision 14 amended); controller revisit noted as open in the handoff (front-panel duty moved to the plane, 19 V input)
2026-10-28 docs: correction, the plane's isolated 12 V aux stays; the controller is adapted to a 12 V input (controller revisit in the handoff)
2026-10-28 pp-48: core sheets MCU (PP-48-2S MCU cut down to link slave + mux master, tile hot-swap GPIO, VIN_SNS), Mux (TCA9548A, channel k = column k+1), Link (as PP-48-2S), Supplies (LM5164 3V3 from VIN); inp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
2026-10-28 pp-48: Supplies sheet gets the isolated 12 V aux as an INTERIM off-the-shelf module (U2 URB4812YMD-6WR3 class, 6 W, 1.5 kV, LCSC C5369743; Cin 22u + 2.2u 100V, Cout 10u, LED, J4 JST PH CTRL_12V / CTR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
2026-10-28 pp-48: Input sheet (J1 XT90PW-M, D1 SMDJ60A bus TVS, C1 / C2 input caps, tile hot-swap U7 LM5069MM-1 latch-off with 2 x 4 mOhm shunt = 2 mOhm (limit 27.5 A, under the XT90's 30 A), Q2 || Q3 BSC040N10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
2026-10-28 pp-48: TVS polarity fix (slot clamp SMBJ60A and bus TVS SMDJ60A are unidirectional: cathode pad 1 now on OUT / VIN, symbol Device:D_Zener; they had pad 1 on GND and would have shorted the rail); Inpu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
2026-10-28 pp-48: core placement draft for review (tools/core.py: controller world top left with the isolators across v = 22, 12 V module top right, MCU left, 3V3 buck between module and XT90, XT90 bottom right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
2026-10-29 pp-48: board routed with the core (N = 2, 106 x 72): DRC 0 unconnected / 0 parity / 0 errors, old track_dangling exclusions gone; route_hand.py core(): tile VIN / TSENSE / VBUS copper, Kelvin sense f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
2026-10-29 ADR 0004: repeated block is a 2-slot unit (2 x 25 mm, one I2C segment) with one TCA6424A 24-bit expander (LCSC C80692) instead of a TCA9535 per column (user); slot B straps INA238 0x41 / ADC121C027 0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
2026-10-29 pp-48: schematic as 2-slot units (ADR 0004 decision 9): sheets/unit.kicad_sch replaces column.kicad_sch, instantiated N/2 times (refs +100 per unit, slot B +50, nets A_* / B_*); TCA6424ARGJR U5 (0x22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
2026-10-29 pp-48: board routed as 2-slot units (N = 2, 106 x 72): DRC 0 unconnected / 0 parity / 0 errors (3 silk warnings, core D1); expander U5 in slot B, slot A's 11 lines on an In2 bus between via ladders (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
2026-10-29 ADR 0005 (Proposed): chained plane - core board + identical 2-slot unit boards (~66 x 72), short JST PH 2.0 12-pin signal cable carrying the rotating channel P0..P3 + 3V3 (from the core) + GND, per-u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
2026-10-29 ADR 0005: user decisions folded in (unit hot-swap latch-off, input strip on the far side); handoff: NEXT = chained plane, rev1 frozen at pp48-rev1, first steps for a new session
2026-10-29 pp-48 chained plane (ADR 0005 Accepted): two KiCad projects power/pp-48-core and power/pp-48-unit sharing power/pp-48's tools, pp.kicad_sym and pp48.pretty; gensch.py core|unit; unit = Unit sheet (re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
2026-10-29 pp-48 chained plane: unit board 76 x 72 (9 mm left margin for chain IN J301 + holes, user; slots as rev1 at x 100 / 125; 17 mm input strip with XT60, unit hot-swap, chain OUT J302) and core board 56 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
2026-10-29 pp-48 chained plane: LCSC codes for the input TVS (SMDJ60A C2990209), bulk cap (RVT2A470M1010 C87862) and unit shunts (6 mOhm SMA25A3FR006T C2692028), stock rechecked on JLCPCB's own API (jlcsearch m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
2026-10-30 granite-plane: split from granite_controller (plane boards, firmware, plane docs); README with the 2026-10-29 direction; handoff
2026-10-30 firmware ADR 0002 (Proposed): plane core firmware - embassy on the STM32G070, plane-logic host-testable crate, expander start-up rule (release presses, adopt on commanded reset, defaults otherwise), 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
2026-10-30 firmware ADR 0002: user answers (controller-verified images, no boot stagger, latches by command; unit glitch state open); docs/press-deadline-line.md: hardware ask for a press deadline line in the c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
2026-10-30 firmware ADR 0003 (Proposed): plane link protocol and the granite-proto crate - framing with CRC-8 (SMBus PEC) over address and request, block ids, full tag table for the chained plane (UNIT, SUMMARY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
2026-10-30 firmware ADRs 0002 / 0003: chain going to 14 pins with PRESS_EN and EXP_RSTN (hardware session, in progress); CTRL 0x4D reset unit expanders
2026-10-30 pp-48 plane boards: press deadline line (docs/press-deadline-line.md decided: option B + A) on a 14-pin chain (S14B-PH-K-S C157938; 13 PRESS_EN, 14 EXP_RSTN, cable n -> 15 - n, pins v 35..61); unit Q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
2026-10-30 handoff: plane board re-run commands, where the unit's U5 opens are, LM5069-1 stock open
2026-10-30 firmware ADR 0004 (Proposed): controller rev D node model - node = plane slot (id from straps and slot, 1-64), power and host state axes, rev C verbs mapped to plane commands, PlaneLink HAL and plane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
2026-10-30 firmware ADRs 0002-0004: OFF slots go back OFF after any reset or unit glitch (backup registers kept current, adopted on every reset with VDD; controller re-applies after a core power loss via STATUS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
2026-10-30 firmware ADRs 0003 / 0004: force_off = hold PWR 5 s then cut the rail if the LED stays on, off escalates to the same (0x51 escalate 3, timeout 0 = force)
2026-10-30 docs/controller-rev-d.md: rev D controller as a delta to rev C - node section and J8 removed, two 12 V PH inputs OR-ed by Schottkys, plane link on HP I2C with two PH 5p (plane J2 pinout), controller-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
2026-10-30 granite-proto: the plane link wire format of firmware ADR 0003
    New workspace member firmware/granite-proto (no_std, no alloc, no
    unsafe, no runtime dependencies), the one codec both ends of the
    controller-to-plane I2C link use.
    - crc: CRC-8 poly 0x07 init 0 (SMBus PEC), const fn, "123456789" ->
    0xF4 plus short vectors and a single-bit-flip test.
    - frame: read_request / write_frame / check_answer on the controller
    side, parse_frame / answer_frame on the plane side. The CRC covers
    (address, block, index, L, records), so check_answer takes the
    request it answers and an answer from the wrong plane or to another
    request fails.
    - record: RecordWriter over a caller buffer (L stops at 254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
2026-10-30 firmware ADR 0003: absent slot / unit answer is one status record (L = 4), update state values as implemented in granite-proto
2026-10-30 plane-logic: crate skeleton, device traits and the segment-bus drivers
    New workspace member firmware/plane-logic (no_std, no alloc, no unsafe,
    integer math only), the hardware-free core of ADR 0002 decision 1.
    - device.rs: the small sync traits (SegmentBus raw transfers plus
    reset_mux / unstick, CorePins for PRESS_TRIG / EXP_RSTN / VIN / die
    temperature, BackupRegs, ConfigStore, UpdateStore) and the Devices
    aggregate with a DeviceSet that implements it, so the firmware glue is
    a constructor. The mux channel select is a driver over SegmentBus, not
    a trait method.
    - drivers: TCA9548A (0x70, the written byte is the control register),
    TCA6424A (auto-increment command byte, the unit.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
2026-10-30 plane-logic: the Plane state machine, the link handler, the fakes and the tests
    - plane.rs: Plane::new / boot / tick plus the accessors the firmware
    glue needs (event_pending for INT_OUT, may_feed_watchdog, led_pattern,
    reset_requested, status_flags). boot adopts the backup set or loses it
    (ADR 0002 decision 3), loads the config, resets the mux and discovers;
    tick samples, runs the writes the link queued, steps the sequences and
    toggles PC6 while a press is held. size_of::<Plane>() is 2608 bytes.
    - discovery.rs: probe 0x22 per channel, 2 s re-scan, two NAKs = lost,
    configure from scratch on (re)appearance with the intended latch, the
    "unit reset seen" event from the expander's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
2026-10-30 granite-core: the PlaneLink HAL trait of controller ADR 0004 decision 5 (write_read / write / int_asserted over the isolated plane I2C and its shared EXP_INT) plus a coarse LinkError (Nak = no plane 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
2026-10-30 granite-sim: a fake plane link over simulated planes (ADR 0004 architecture item 3)
    src/planes.rs: FakePlaneLink holds up to eight FakePlane keyed by
    0x30-0x37, each a real plane-logic Plane over plane-logic's sim fakes
    (units, modules, node LEDs following the presses and the rail, loads).
    write_read / write hand the bytes to Plane::handle_frame and give the
    answer back; an address with no plane is a Nak; int_asserted is the
    wired OR of every plane's event_pending. tick(now_ms) advances every
    plane in 50 ms cycles from the simulator's main loop, so a plane runs
    whether or not the controller talks to it, and Sim::reboot leaves the
    planes alone (ADR 0004: a controller reboot moves no node).
    F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
2026-10-30 firmware ADR 0003: SUMMARY lists every slot of a present unit; handoff: firmware progress (granite-proto, plane-logic, fake plane) and next steps
2026-10-30 granite-core: the plane client of controller ADR 0004 decision 5
    A `plane` module over hal::PlaneLink and granite-proto, synchronous and
    host-testable like the rest of the crate: poll(now_ms, &mut link) does
    whatever is due and never blocks.
    - model: Plane, Unit, Node with the two state axes of decision 3 (power
    off / on / starting / fault / absent / unknown, host off / on / sleep /
    unknown) plus the telemetry and the energy with its boot count; node id
    = 8 x (addr - 0x30) + slot + 1 in node_id / node_location.
    - link: one transaction at a time, 3 tries on a bad CRC or a transport
    fault, a NAK straight through as absence, per-address counters and the
    "address collision suspected"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
2026-10-30 ADR 0003 decision 14: the isolated 12 V aux is an own Fly-Buck (LM5017 C34355 + Bourns SRF0703-470M C3273458 1:1 coupled inductor, 500 Vrms) on a CTRL_GND island, functional isolation only, sized ~2 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
2026-10-30 granite-core: the rev D node model of controller ADR 0004
    The rev C node section is gone (decision 1): actuator.rs, NodeSwitches,
    NodeSense and the expander-backed DryInputs leave; DryInputs stays as a
    plain trait on four GPIOs. No feature flags.
    A node is a slot on a plane (decisions 2 and 3). node.rs is now the
    per-node settings only - name, boot policy, LED sense, soft-off window,
    escalation (none / hold / hold-then-cut, default hold-then-cut) - kept
    in a list keyed by node id so a node that is not present keeps its
    config; the state lives in plane::model and is copied into Observed
    once per cycle (nodes[], planes[] with units[], both axes, telemetry,
    faults). Target gains plane and unit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
2026-10-30 granite-core: the intended-OFF re-apply follows the slot, not the boot count
    A plane that lost its core power keeps the "intended state lost" flag up
    until a reset that keeps VDD, and it comes back with its boot count at 1
    because the counter lives in the backup domain that went with it
    (ADR 0002 decision 3). Neither the flag's edge nor the boot count can
    therefore say whether a loss has been answered, and the per-boot marker
    missed the second power loss of a plane whose count did not move.
    The client now looks at the state instead: while a plane flags the loss,
    every node it last commanded rail-off whose slot reports itself enabled
    again gets its OFF re-applied, at most once per SUMMARY of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
2026-10-30 granite-sim: the simulator on the rev D node model, end to end
    SimCore is the plane client over the fake plane link now: it ticks the
    planes, polls the client, turns the client's events into published ones,
    drains the finished jobs into acks through granite_core::jobs, copies
    the models into the snapshot, applies the boot policies once and
    evaluates the rules. The fake U14/U15 board is gone with the rev C node
    section; fakes.rs is the controller's own sensors and implements the
    plain DryInputs trait. A controller restart keeps the planes running, as
    ADR 0004 answers it.
    The scenario file loses its [[node]] section - a node is a slot on a
    plane - and its defaults are one plane at 0x30 with f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
2026-10-30 granite-fw: the board firmware on the rev D node model
    The rev C node hardware is gone with the rev C node model (ADR 0004
    decision 1): hw/expanders, hw/relays, hw/sense and the MCP23017 driver
    are removed, nothing holds a reset line at boot any more (the two rev C
    reset pins are parked as pulled-down inputs so a rev C board under a rev
    D image leaves its relays open), and the OTA probation ladder loses its
    "expanders initialised" step - a controller whose planes are unplugged
    still has to be able to take an update, so a plane found is deliberately
    not its replacement.
    The dispatcher thread now owns the plane client, the job log and the
    rules: it polls the client every 50 ms, turns the plan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
2026-10-30 ADR 0004: Accepted, with an "As built" section
    The node model is implemented in granite-core, granite-sim and
    granite-fw. Folded in what the decisions left open and the few places the
    implementation chose for them: the config layout (per-node settings as a
    list keyed by node id, nodes.plane_update, the 12 V window), the plane
    and unit target spellings, the job id on the ack, the one new event kind
    for the plane events, the rounding that keeps an on-change publisher
    quiet, the concrete Modbus version 2 blocks and the fault-bit meanings,
    the new plane read routes, what a boot policy of `off` means now, and the
    two marked placeholders in granite-fw (the NAK-only plane link and the
    unwired dry i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
2026-10-30 pp-48-unit: routing finishes (DRC 0 unconnected, parity clean): bottom-row expander escapes EV13 / EV16 for B_PWRD / B_RUNOFF, placement tweaks; tools/mazefix.py closes the last opens with a grid maz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
2026-10-30 pp-48 core Supplies: LM5017 Fly-Buck replaces the interim 12 V module (ADR 0003 decision 14): L2 SRF0703-470M on the new footprint pp48:L_Bourns_SRF0703, secondary on the CTRL_GND island, PWR_FLAGs o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
2026-10-30 pp-48-core: Fly-Buck placed where the 12 V module was (top right): L2 SRF0703 rot 270 on the corner of a new CTRL_GND island strip along the top edge (diagonal windings: SEC2 in the strip, SW / VOUT1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
2026-10-30 pp-48 core MCU: pins reassigned for the fewest ratsnest crossings on the core board (38 -> 13): I2C1 PB8 / PB9, I2C2 PA11 / PA12, VIN_SNS PB11, PRESS_TRIG PB12, MUX_RST PB13, LED_RUN PB14, EXP_RSTN P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
2026-10-30 pp-48-core: routed (DRC 0 unconnected, parity clean; isocheck: no island copper within 1 mm of the bus world): tools/route_core.py draws the CTRL_GND island pours, L2's CTRL_GND pocket with its vias 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
2026-10-30 pp-48-core: GND stitch (1 via), silk (23 refs placed, 71 small ones hidden), JLC outputs; LCSC codes for the 25 passive values that had none (sch/draw.py BASIC table, JLC parts API: basic where JLC h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
2026-10-30 pp-48-core J1: project footprint pp48:AMASS_XT30PW-M (the stock one points to a STEP KiCad does not ship) with the LCSC / EasyEDA model C431092 (pp48.3dshapes), turned 180 and offset (-2.5, 8.48) to 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
2026-10-30 controller: rev D KiCad project started as a copy of rev C (granite_controller 93a99b5: project, sheets, PCB, rules, symbols, footprints, 3D models), renamed granite-controller; unchanged otherwise, 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
2026-10-30 controller: rev D schematic - node section (relays sheet: J11-J18, K1-K16, U14-U17 and passives), J8 expansion header network (RN2, U7, F2, D7, R19, EXP_nRESET) and the 19 V input (J3, F3, D1, D8) re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
2026-10-30 pp-48-core 12 V aux: LM5018 + Coilcraft LPD5030V-333 replace the LM5017 + SRF0703 (ADR 0003 decision 14 revised): the SRF0703's real land pattern puts its windings' pads 0.46 mm apart with no isolati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
2026-10-30 pp-48-core address straps: solder jumpers JP1-3 -> 3-way SMD DIP switch SW1 (KingTek DSHP03TSGET, C50844, 1.27 mm pitch, KiCad footprint and model) on F right of U3, ON = 0, plane address 0x30 + ADR[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
2026-10-30 controller rev D: board rebuilt from the rev D schematic and placed, 100 x 50 mm (not routed)
    pcbkit mkboard + outline (100 x 50 at rev C's origin, M3 holes in the
    corners as rev C), then tools/place.py: ETH (J1 / U3 / Y2 / magnetics,
    pairs), buck (U8 loop + U2) and USB-C (J2 / U4) blocks moved from rev C
    with their routing (group hand), U1 12 mm left with its decoupling and
    antenna still over the bottom edge; probes J4-J7 on the top edge between
    RJ45 and USB-C, J11 / J12 (12 V) and J14 / J13 (plane link) on the bottom
    edge next to U1's plane I2C pins, J9 / J10 on the right edge. Rule areas:
    U1 body, screw heads. Net classes: PWR_19V and node classes gone, PWR_12V
    (VIN_12V, 12V_IN_*), LINK?_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
2026-10-30 controller rev D: board widened to 105 x 50 mm, SPI bus and plane I2C escapes hand-routed (tools/route_hand.py)
    At 100 mm the bottom edge was full (J11 / J12 / J14 / J13 end 1.3 mm
    from U1) and the SPI via column and the plane I2C escapes had to sit
    over J13's pins. U1 (dx -7 from rev C), USB-C (+5) and everything right
    of the buck move 5 mm right; the U1 body keep-out moves with U1.
    route_hand.py: rev C's W5500 SPI bus (F.Cu at 0.8 mm pitch, via column
    x 92.6 - 96.6 between J13 and U1, B.Cu up to U1's pins, RST straight on
    F.Cu) and PLANE_SCL / PLANE_SDA from U1 pins 26 / 27 to vias at
    (91.2, 73.85) / (90.2, 73.85), all in group hand. Pull-ups R17 / R18 on
    the INT / RST lines as rev C. DRC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
2026-10-30 controller rev D: placement reworked for routing (105 x 50 mm, not routed)
    tools/place.py: J10 top right with one RC row per pin at the pin's y
    (C | 1k | 10k pull-up on the DRYC line), U18 below it; J9 lower right
    with U6, RN1, F1, D6; R34 / R35 back beside U1's USB pins (rev C), the
    USB pair runs down from U4 clear of the RC rows; rev C's board-only 3D
    models (J1, J2) copied with the blocks; +3V3 hand copper not copied
    (krt-route's plane pass drops it), nothing copied under the screw heads.
    tools/route_hand.py: also the J10 row shorts with their plane vias and
    a GND strap + plane via on each TPD4E05U06 (pads 3 / 8); --only NET
    re-applies the SPI / RST routes after krt-route. DRC parity 0.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
2026-10-30 controller rev D: routed, DRC 0 errors, 0 unconnected, parity clean (105 x 50 mm)
    Kept from rev C (group hand): Ethernet block with the MDI pairs, magnetics
    network, crystal and W5500 decoupling; buck U8 loop and U2; USB-C J2 / U4;
    U1 thermal vias. Hand routes (tools/route_hand.py): W5500 SPI bus and RST,
    J10 RC rows, ESD GND straps, U21 / U22 load-switch fan-out (IN / EN loop,
    GND via under the body, ILIM). Rest by krt-route (planes GND In1 / +3V3
    In2, USB pair U4 -> R34 / R35, signals F / B), then tools/restore_hand.py
    (krt-route ripped ETH_XI and part of the hand GND; put back, duplicate
    vias merged), targeted krt-reroute --keep passes on the opens (VIN_SENSE,
    DRY_IN3, I2C_LOC_SDA, C6_EN,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
2026-10-30 pp-48-core SWD: J6 ARM Cortex 10-pin header (Samtec FTSH-105-01-L-DV-K, C5155080, keyed shroud) on F right of U3 below SW1, for stock probe ribbons; the Tag-Connect pads J5 stay; J6 drawn as Conn_02x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
2026-10-30 controller rev D: J1 (HR911105A) and J2 (USB-C) 3D model offset / rotation restored (lost in the board rebuild; values from 3dmodels/README.md): the USB opening faces out again, the jack sits on its 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
2026-10-30 controller rev D: probes J4-J7 respaced, J4 body 6.0 mm clear of the RJ45 body (was ~2 mm); place.py keeps 3D model offsets
    J4-J7 moved right by 4.06 / 3.97 / 3.88 / 3.79 mm on the top edge, 1.5 mm
    body gaps, J7 2.2 mm from the USB-C shell (bodies = F.Fab outlines, which
    match the 3D models); J1 / J2 untouched. OW_DATA re-routed with
    krt-reroute --keep; the 3V3 buck output (L1 / C4) now reaches In2
    through two vias beside L1 instead of via J4 pin 1. GND pour, stitching,
    silk and connector labels redone. place.py copies the block footprints'
    3D model offset / rotation / scale by value (the SWIG vector assignment
    left them zero, see 67a10e3). DRC 0 errors, 0 unconnected, parity
    clean.
2026-10-30 reorganize after the merge: rev C controller (KiCad project, tools, operator manual site/) to controller-rev-c/ as demoware (tag rev-c-demo = 93a99b5); pp-48-2s, pm-19v-200w and the rev1 single-board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
2026-10-30 pp-48-unit: 3D model for the node terminals J1 / J51 (Degson DG128-5.0-02P, LCSC C711349, model from LCSC / EasyEDA, +2.5 mm x to our pin-1 origin) in pp48.3dshapes, on the library footprint and the 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
2026-10-30 manual: rewritten for controller rev D and the chained power planes (core + 1-4 units): new commissioning page planes.md (addresses on SW1, unit order and node ids, chain cables, modules, node / 48 V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
2026-10-30 3D model for the module aux socket (hanxia HX PM1.27-2x3P TP, LCSC C41397112, model from LCSC / EasyEDA, 4.60 mm, turned 90 deg: its rows run along x, ours along y): on the pp48 and carrier footprint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
2026-10-30 3D models: module aux header J2 on pm-19v-250w (hanxia HX PZ1.27-2x3P TP, C41376035; on B, offset sign follows the flip); unit U5 (stock VQFN-32 footprint points at a STEP KiCad does not ship: pp48 c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
2026-10-31 pp-48-unit: LCSC codes on the 22 parts that had none (JLC parts API 2026-10-30): BASIC table gains the hot-swap passives (143k / 124k 0805, 4.99k / 13.7k 0402 extended, best stocked; 20.0k, 10R 0402 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
2026-10-31 stock replacements: unit INA238 (0 at JLC) -> INA237AIDGSR C2864837 on U2 / U52 / U208 (pin- and register-compatible for the plane-logic driver: SHUNT_CAL, LSBs, DIETEMP, MANUFACTURER_ID; gain error 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
2026-10-31 pp-48-unit: unit hot-swap U207 LM5069MM-1 (latch-off, 1 at JLC) -> LM5069MM-2 C111822 (auto-retry, as the slots; user 2026-10-30); the latch moves into the core firmware: ADR 0005 decision 3 (U_PGD f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
2026-10-31 pp-48-unit: pcbkit silk (refs sized / hidden on small parts, values to Fab) and prune of one dangling +3V3 stub; DRC 10 (6 known PTH-in-courtyard overrides, 3 XT60 silk at the edge, 1 starved thermal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
2026-10-31 controller: target `all` works with every node verb, one plane job per node
    Only `on_all` accepted target `all` (dispatch.rs), so the shipped
    default rules 1 and 2 ("probe over temperature" and "leak float
    closed", both `force_off` on `all`) published rule_fired and then
    action_failed with "force_off needs a single node target" and switched
    nothing off.
    granite-core:
    - dispatch: a node verb on `all` becomes one plane job per present
    node, each built from that node's own settings, which is what the
    same verb sent to each node in turn would do (ADR 0004 decision 4).
    `on_all` keeps its own meaning: one staggered group command per
    plane. `Dispatched.job` is now `Dispatched.jobs` with a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
2026-10-31 controller: `on_all` is a staggered `on`, it no longer cuts the nodes that run
    `on_all` named every present slot to the plane's stagger (0x4B), which
    switches every slot it is given off before releasing them one at a
    time: a node that was running lost its rail and had to boot again. ADR
    0004 decision 4 calls the verb a staggered `on`.
    - NodeCommand::OnAll gained `stagger`, the subset of its nodes whose
    rail is down, and only those slots go into the 0x4B bitmap. The
    node-on stage still covers the whole set, so a node that is powered
    keeps its rail and just gets its PWR press; with nothing to stagger
    the job is the presses alone (one stage). `on_all(nodes)` keeps
    stagg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
2026-10-31 controller: default rule 3 watches the 12 V input window, not rev C's 19 V
    "bus voltage low" tripped below 15 V, the figure for the 19 V rev C
    supply. Rev D is fed 12 V from the planes (ADR 0004 decision 9) and
    `nodes.vin_min_mv` / `vin_max_mv` default to 10 V / 14 V, so the rule
    fired as soon as anyone enabled it.
    The rule is an event-only warning about the controller's own input, so
    it now watches the bottom of that window: threshold
    `config::DEFAULT_VIN_MIN_MV` (10 V), the same constant
    `NodesCfg::default` uses for `vin_min_mv`, so the warning and Modbus
    fault bit 3 cannot drift apart. Hysteresis (0.5 V) and hold (5 s) are
    unchanged.
    Test: tests/rules.rs asserts the threshold is the con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
2026-10-31 controller: Modbus fault bit 0 (PLANE_LOST) is set while a plane is missing
    Bit 0 of the fault word, "a plane the controller had found stopped
    answering", was in the map and in the status-LED mask but nothing ever
    set it: the dispatcher's fault block only handled NO_PLANE and
    NODE_FAULT, so a frame with one of two planes gone looked healthy to a
    Modbus master and to the LED.
    granite-core, where it is host-testable:
    - PlaneClient keeps a `lost` flag per address, set when a plane it had
    found misses its transactions (the same point that raises
    `plane_lost`) and cleared when the address answers again.
    `lost_addresses()` reports them; `forget_plane(address)` gives up on
    one an operator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
2026-10-31 controller: the completion ack carries its job, and the ack and job timeouts follow the node's settings
    Two things around an accepted plane job:
    - the MQTT completion ack was built from the `action_done` /
    `action_failed` event alone, so it had no `job` field while the
    `accepted` reply did;
    - the ack gave up after a fixed 300 s and the job after a fixed 600 s,
    while `t_soft_off_s` may be 3600: a node configured to wait an hour
    for its host was acked as "did not finish in time" and its job was
    abandoned less than halfway through.
    - NodeCommand / PlaneCommand / Command gained `worst_case_ms()`: what
    the verb's own options allow (LED waits, the soft-off window, the 5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
2026-10-31 controller: boot policies run on a plane boot, not on the controller's own start
    The policies ran once per controller start, three seconds after the
    dispatcher came up, so a firmware update or an API `reboot` pressed PWR
    on every node whose host happened to be dark and shut down every node
    whose policy was `off`. ADR 0004's expert answer is the opposite: the
    controller "applies boot policy only to nodes whose policy says so and
    only on a plane boot (boot count changed), never on its own boot".
    New granite-core module `boot` (host-testable), with BootPolicyWatch:
    - a plane the controller is watching whose boot count moved, or whose
    "intended state lost" flag went up (a core power loss brin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
2026-10-31 jlcfab: per-LCSC rotation / centroid corrections for the core (14 parts), unit (41) and controller rev D (2), fitted from the EasyEDA footprints (method reproduces pcbkit's own LQFP-48 / SOIC-8 / SOI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
2026-10-31 PM-19V-250W-B: component spec (LM5116 single phase, 252 kHz, 10 uH APS1510M100F, BSC098N10NS5 / BSC070N10NS5, RS 4 mOhm, ILIM ~20 A typ, VCCX from VOUT, TPS3701 OVLO, supervision as rev A); BOM all J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
2026-10-31 PM-19V-250W-B schematic: new project power/pm-19v-250w-b, generated by tools/gensch.py on the plane's schematic engine (pp-48/tools/sch); own symbol lib pmb (LM5116, TPS3701), mount / aux footprints 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
2026-10-31 plane: the unit hot-swap latch moves into the firmware (LM5069-2)
    ADR 0005 decision 3: the unit input stage is an auto-retry part now,
    so nothing in the hardware remembers a fault. New module
    plane-logic/src/unit_latch.rs holds the policy as plain data: U_PGD low
    for 500 ms with the bus inside UVLO..OVLO (with a 2 V guard band) and
    the core not already holding the unit is a unit fault, and the core
    drives U_OFF high and keeps it there. U_PGD low with the bus out of
    range is the bus and latches nothing; a restart attempt that the 20 Hz
    poll catches needs 300 ms of PGD before it counts as a recovery, so a
    retry pulse neither stops nor undoes a latch.
    The bus witness is the core's own 48 V inp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
2026-10-31 docs: the unit latch is the plane firmware's (LM5069-2)
    ADR 0002 decision 7a writes the latch down: the rule, why the bus
    witness is the core's own 48 V input and not the unit's INA237 (its
    VBUS pin is on the hot-swap output), where the 500 ms / 300 ms windows
    come from, that the hold lives in the intended state, and that a boot
    needs no special case. Decision 6's "unit reset" row releases instead
    of pulsing; the risk list gains the retrying-unit case; the tweakable
    list gains the two windows.
    ADR 0003 says the same for 0x30's "hot-swap latched off" bit, 0x4A and
    event 19 - the wire itself is unchanged. ADR 0004 gets an "as built"
    note: no controller change, but unit_reset no longer costs a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
2026-10-31 docs: name the core's own input as the latch's bus witness
    ADR 0005 decision 3 said the core judges "the unit input (INA237 0x44
    VIN)". It cannot: U208's VBUS pin is on the hot-swap output, so the one
    absolute voltage the part reports is ~0 V exactly when the stage is
    open. The decision now says what the firmware does - the core's own
    48 V divider, same bus behind the same breaker - and what it costs,
    and points at ADR 0002 decision 7a for the timing.
    The Modbus map's two descriptions of the unit latch say whose latch it
    is; docs/modbus_map.md regenerated.
2026-10-31 PM-19V-250W-B schematic: second Kelvin net tie NT2 for CS, snubber dropped; ERC 0
2026-10-31 PM-19V-250W-B board, placed (not routed): place.py, power.py (pours, via fields), build.sh, pcbkit.toml (0.15 mm clearance for U1's 0.65 mm pitch); DRC 0 errors, parity clean, 102 unconnected (signal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
2026-10-31 PM-19V-250W-B board routed and fab-ready: U1 on F (pin order matches the power stage), its drive parts hand-placed on B, gate drive / bootstrap / VCC / VCCX / LO and the CS Kelvin taps as kept hand c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
2026-10-31 PM-19V-250W-B: nothing quiet next to L1's SW pad: CS / CSG as one Kelvin pair (In1 between L1's pads, B under the SW pad, In2 GND between) instead of CS on In1 0.2 mm under the pad and CSG apart; rul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
2026-11-02 PM-19V-250W-B: PGOOD off the In1 VOUT pour: crosses on F beside OV_KILL (it fenced In1 off from L1's vias); VOUT L1 -> J1 2.14 -> 1.58 mohm; power.py via grid and backbones clear tracks; DRC 0, parit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
2026-11-02 plane chain without cables (ADR 0005 decisions 4, 7): boards plug into each other on a mounting bar; unit J301 = CJT A2541WR-2x7P right-angle plug (C5136987), core J301 / unit J302 = A2541HWR-2x7P ri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
2026-11-02 unit J201 XT60 3D model turned 180 deg (rotate z 270 -> 90, same offset; pp48 footprint and board): the slotted male contacts faced the bulk cap, now the mating face is at the top edge and the closed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
2026-11-03 pp-48-unit: J201 XT60 3D model turned 180 deg (rotate z 270 -> 90, offset unchanged: the STEP origin is the body centre); it had its legs at the board edge, 14 mm off the pads, and the mating face po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
2026-11-03 docs: pm-interface standoff checked against the Sinhoo datasheet: through thread at 7 mm (blind only from 11 mm), brass C3604, tin plating per LCSC, 30 A rated; torque 0.25 -> 0.15 Nm (datasheet max 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
2026-11-03 mech: 8-port plane assembly script (freecadcmd mech/tools/assemble.py): core + 4 units in a row 3 mm apart, 2 pm-19v-250w-b modules per unit on MOD1 / MOD2 at 7.0 mm (screw holes checked on the stand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
2026-11-03 mech: assemble.py: make the imported features visible (a headless STEP import leaves them hidden, so every link showed nothing)
2026-11-03 mech: assemble.py: one import per instance in its own App::Part instead of App::Links to a hidden import (the links showed nothing in the GUI)
2026-11-03 mech: assemble.py also writes the whole row as one STEP (mech/assembly/plane-8port.step): the headless FCStd has no GUI data and showed empty in the GUI
2026-11-03 controller rev D: HR911105A (J1) 3D model y offset -4.357 -> -6.555 (README, board, place.py): the whole model sat 2.2 mm toward the back, pins, LED pins, pegs and shield tabs beside their holes and 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
2026-11-03 docs: W5500 datasheet and a reference PDF; pm-19v-250w fabrication-toolkit options
2026-11-03 gitignore: kicad-mcp scratch (.kicad-mcp/, per-board output/)
2026-11-04 ADR 0006 (proposed): plane link over isolated CAN FD
    Replaces the isolated I2C link: the ISO1640 side 1 ports of all planes
    share the cable bus, which TI rules out (side 1 is single-node only).
    ISO1044 per plane, MCP2518FD on the G070 with the G0B1's FDCAN1 on the
    same PB8/PB9 as a drop-in build, MCP2518FD + TCAN1044V on controller
    rev D, 5 V on the link cable, TLV blocks of firmware ADR 0003 kept with
    a segmentation layer, ids reserved for a standby controller.
2026-11-04 docs in sync with the boards: ADR 0005 board sizes as routed (core 56.1 x 72.1, unit 78.6 x 72.1), core link is ISO1640 I2C + ISO7721 (not RS-485), LM5069-2 with the firmware latch as the decision; A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
2026-11-04 ADR 0006: no cables to the planes: one row on the bar (controller, core 1, units, core 2, ...), the link passes through every unit on a separate 2x3 A2541 joint beside the 2x7 chain (CANH, CANL, LINK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
2026-11-04 controller rev D: D4 green LED APT1608LZGCK (C5246833, 2 in stock) -> KT-0603G (C12624, 366k), same 0603 footprint; ERC 0, DRC 0 errors / 0 unconnected / parity clean (4 silk_edge warnings as before)
2026-11-04 core: ISO1640 U4 turned round, side 1 (single node, 80 pF, static offset) on the plane MCU, side 2 (shareable, 400 pF, 50 mA) on the controller cable; up to 8 planes share the cable bus, which side 1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
2026-11-04 controller-fd: CAN FD controller (ADR 0006), schematic only, copied from rev D: plane I2C link, EXP_INT, J11-J14 and their parts removed; MCP2518FD U23 on the W5500 SPI (nCS GPIO2, nINT GPIO3), 40 MH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
2026-11-04 pp-48-fd: CAN FD plane core and unit (ADR 0006), schematics only: generator copied to power/pp-48-fd/tools; core: ISO1640 / ISO7721 / J2-J4 out, ISO1044 U4 with HT7550-1 5 V on the link domain, MCP25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
2026-11-04 firmware ADR 0005 (proposed): plane link transport over CAN FD: ADR 0003 frames unchanged (address 0x30 + node in the CRC), ids (type << 4) | node, 63-byte segments with an index / last byte, reassem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
2026-11-04 plane-fw: plane core firmware binary for the STM32G070 (rev D I2C link)
    The board glue for plane-logic on the PP-48 core board, per ADR 0002
    (plane core firmware), ADR 0003 (link protocol) and ADR 0005 decision 9
    (rev D link first, CAN FD later as features of this binary). Excluded
    from the firmware/ workspace like granite-fw: own target, linker script,
    toolchain file and .cargo/config.toml.
    - 8 MHz HSE -> PLL (M1 N16 R2) -> 64 MHz; embassy-executor 0.10,
    embassy-stm32 0.6 (stm32g070cb, time-driver-any), embassy-time 0.5,
    defmt + defmt-rtt + panic-probe.
    - Link task: I2C1 slave at 0x30 + straps on embassy-stm32's own slave
    support (into_slave_multimaster / listen / respond_to_write /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
2026-11-04 mcp2518fd: CAN FD controller driver (firmware ADR 0005 decisions 8 / 9) as a facade over mcp251xfd: the crate search found mcp251xfd 0.2 (embedded-hal 1.0 SpiDevice, no_std, CAN FD with BRS, 40 MHz p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
2026-11-04 controller-fd board (ADR 0006): from rev D's copy, 105 x 50 mm kept; J15 2x3 link socket on B at the right edge, pin 1 at top + 30.0 mm, face 4 mm past the edge; TCAN1044V / termination / ESD at J15,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
2026-11-04 firmware ADR 0005 decisions 6, 7, 9: PlaneLink::event_nodes, SYNC sender, CAN link fake in the sim
    PlaneLink::int_asserted() -> bool becomes event_nodes() -> u8, a mask of
    the planes that raised events since the last call (decision 6), and the
    trait gains sync(epoch) with a default no-op body (decision 7). The
    plane client brings the STATUS of the planes in the mask forward instead
    of every plane's, and sends SYNC once a second with an epoch seeded from
    its own boot seed and raised on every send. The I2C implementations
    answer 0xFF while EXP_INT is low, so rev D behaves as before:
    granite-fw's StubPlaneLink reads the pin, NoPlaneLink answers 0, and the
    sim's fake answers over the wired OR of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
2026-11-04 firmware ADR 0005: as built (commits named), reassembly splice note, mcp2518fd as a facade over mcp251xfd, INT0 / INT1 per board
2026-11-04 pp-48-fd boards (ADR 0006): core-fd and unit-fd laid out from rev D copies; link 2x3 plug / socket on B at both edges, pin 1 at top + 30.0 mm (same as controller-fd J15); core grows 56 -> 68 x 72 mm: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
2026-11-04 ADR 0006: core-fd is 68.0 x 72.0 mm (rev D 56.1): the link domain runs along the top edge with a channel down each side, >= 2 mm from GND on every layer; a plane ~402 mm, a row of 8 ~3.2 m
2026-11-04 ADR 0006: the flipped-isolator I2C alternative bets on rows of at most ~5 planes (55-75 pF per plane against 400 pF), not 2-3
2026-11-04 handoff: 2026-11-04 (rev D ISO1640 flip, CAN FD generation projects and boards, firmware crates, ESP32 flash budget, attic of the second clone)
2026-11-04 ADR 0006 and firmware ADR 0005 accepted: review asks answered by the user (CAN FD for the new generation, rev D keeps the flipped I2C; separate 2x3 joint; G070 + MCP2518FD now, G0B1 later; right-end 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
2026-11-04 ADRs 0001-0005: open questions walked with the user: settled ones ticked with their source (retry defaults, backup registers, stagger, blink window, topology, TCA6424A, second GND, discovery, I2C pre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
2026-11-04 handoff: the 2026-11-04 answers (ADR 0006 / firmware ADR 0005 accepted, jumper-cap termination, controller on a ribbon with a keyed box header, no DC-ATX converter) and the board changes and checks t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
2026-11-04 OV_KILL check names the right part (U2 MCP65R46 / R18 on PM-19V-250W-B, not the TPS3701) with the R18 76.8k fallback; granite-fw release lto = true (1.85 -> 1.65 MB)
2026-11-04 controller-fd: J15 -> keyed 2x3 right-angle box header (BOOMELE C34945) for the IDC ribbon to core 1
    The bar socket goes: J15 is now a shrouded right-angle 2x3 box header on B at
    the right edge, on the old pad grid (pin 1 at the bottom of the column: the
    footprint is mirrored on B), shroud face 4.8 mm past the edge. CANH / CANL /
    AUX_12V rerouted at J15 (krt-reroute --keep, AUX_12V steered by
    fd_keepout.py), J15 GND pads solid, one USB_D- via moved 0.05 mm off pin 1.
    Pin n = core link plug pin n over a straight AVR-ISP ribbon. C9136 / C9141
    named in ADR 0006 are 2x6 parts; C34945 (2717 in stock) is the 2x3.
    Generators updated (gen_canlink.py, fd_board.py), jlcfab rotation 90 fitted
    from the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
2026-11-04 FD boards: 2x2 jumper-cap termination header, J2 pin-1 mark (ADR 0006 decision 8)
    core-fd JP1 / JP2 and unit-fd JP301 / JP302 solder jumpers -> one 2x2
    2.54 mm header each (JP1 / JP301, C492419 PZ254V-12-4P): 1 CANH / 2 TERM_H,
    3 CANL / 4 TERM_L, a cap per leg (1-2, 3-4), both only on the last board.
    Caps C5305, not assembled. Generator (link.py termination(), chain.py),
    place_core.py / place_unit.py tables, route_unit.py link_term(); routed
    boards updated by fd/core_term.py and fd/unit_term.py. core-fd: D9 0.6 mm
    down, AUX_12V moved right of the header, pin-1 silk mark at the link plug J2.
    ERC 0 (core, unit). DRC with parity: 0 errors / 0 unconnected on core;
    unit only rev D's 6 pth_inside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
2026-11-04 firmware: drop the factory partition, 0x3D0000 OTA slots (user, 2026-11-04)
    Partition table (8 MB): nvs 192 K at 0x9000, otadata 8 K at 0x39000,
    coredump 64 K at 0x3B000, ota_0 0x3D0000 (3,997,696 B) at 0x50000,
    ota_1 0x3D0000 at 0x420000. Last byte used 0x7F0000, 64 K free at the
    top; the 20 K alignment hole is now between coredump and ota_0.
    Why: with bootloader app rollback an update never overwrites the slot
    that is running, so one OTA slot always holds the last image that
    passed self-validation, and two bad updates in a row cannot brick the
    board. factory only covered both OTA images being invalid at the same
    time (flash corruption of the good slot), and it never helped with an
    image t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
2026-11-04 granite-fw: dispatcher stack 12 -> 24 KB (DISPATCH_STACK): with lto = true the inlined PlaneClient constructor (8.5 KB) put two copies in one frame and the rev C board boot-looped on a stack protecti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
2026-11-04 granite-fw net: restart DHCP when AutoIP displaces a lease. lwIP's DHCP / AutoIP cooperation let a 169.254 address overwrite a lease that arrived as AutoIP started (rev C, 2026-11-04: lease at 17.1 s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
2026-11-04 handoff: 2026-11-04 afternoon (FD board changes, factory partition dropped, rev C bench: OTA / rollback on the new layout, DHCP / AutoIP race, next steps)
2026-11-04 granite-fw: name every task and measure its stack (platform::spawn, console `stacks`)
    With `lto = true` a large constructor is inlined into its caller's frame,
    so a stack that was ample without LTO can overflow with it: the
    dispatcher did, on a rev C board, and the panic said `Detected in task
    "pthread"` - every Rust std thread becomes a FreeRTOS task with the
    ESP-IDF default pthread name, so the kernel could not say which of the
    fifteen it was.
    platform::spawn(name: &'static CStr, stack, f) now wraps every thread
    this firmware starts (16 sites: main, modbus, mqtt, net, console, ota,
    the event relay, the LED and RGB threads). It sets the esp_pthread
    configuration of the calling thread (thre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
2026-11-04 firmware: take the PlaneClient off the dispatcher's stack, give sys_evt 4 KB
    Two fixes from today's measurement on a rev C board (console `stacks`,
    2026-11-04).
    The dispatcher thread had used 20.4 KB of its 24 KB stack, 83 %. Almost
    all of that is one value: PlaneClient was 8512 bytes, 7808 of it an array
    of eight PlaneStates and 256 an answer buffer, and it is built inside the
    dispatcher's frame - where `lto = true` inlines the constructor, so the
    array exists twice at once. That is what overflowed the old 12 KB stack.
    Both members are boxed now, and they are built on the heap rather than
    moved there: the plane states are collected into a Vec and the Vec is
    converted to Box<[PlaneState; MA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
2026-11-04 granite-fw net: stop AutoIP once the netif has a routable address; AutoIP after 31.5 s, not 7.5 s. lwIP 2.2 (ESP-IDF v5.5.5) neither stops AutoIP in dhcp_bind nor stops AutoIP's ACD probe in autoip_s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
2026-11-04 ADR 0007 Rejected: core power over the chain joint (bused CORE_VIN would put every unit's power on every unit; unit-1-only makes unit 1's XT60 a single point). The core keeps its XT30.
2026-11-04 unit-fd: draw the flip-flop bypass caps at their VCC pins
    C4, C54, C12 and C62 sat apart from U3, U53, U10 and U60, tied only by
    +3V3 power symbols. Wire each to its chip's VCC pin instead. Netlist and
    ERC unchanged.
2026-11-04 unit: draw the flip-flop bypass caps at their VCC pins
    Same fix as unit-fd c1caf18: C4, C54, C12 and C62 wired to the VCC pins
    of U3, U53, U10 and U60 instead of floating on +3V3 power symbols.
    Netlist and ERC unchanged.
2026-11-04 core-fd: schematic readability, wires instead of local labels
    Bypass caps (C28, C35) at their VCC pins; crystal, pull-ups, address
    switch, SWD, LED and mux reset wired at their pins instead of joined by
    labels; overlapping fields and headings moved apart. Labels kept for
    SPI/MCP_CS/MCP_INT between U3 and U5, ADR0-2 and NRST across U3, and
    the inter-sheet nets. Netlist identical (all net names), ERC 0.
2026-11-04 ADR 0006: one plane link per firmware image; first batch is CAN FD
    Controller firmware builds link-i2c or link-canfd, never both, behind
    the PlaneLink trait, with an OTA guard on the link kind. Handoff: the
    first batch is the FD generation; rev D stays ready but unordered.
2026-11-04 core: wire local-label joins and clear overlapping text in the schematic
    Drawing-only: bypass caps at their VCC pins (mux, chain), reset FET and
    pull-up wired to the mux RESET, RC timing / pull-ups wired to the
    74LVC1G123, crystal + load caps, NRST cap, address DIP + pull-ups (ADR1),
    I2C2 pull-ups and RUN LED wired at the STM32; field / label overlaps
    fixed on every sheet. Netlist identical, ERC unchanged.
2026-11-05 core, core-fd: shorter title-block comments that fit the frame
    pp-48-core comment 1 said RS-485 link; rev D is isolated I2C. Generators
    carry the same text. The core-fd root sheet change rides with an open
    KiCad save and is left uncommitted.
2026-11-05 core-fd: Input sheet rearranged in KiCad, shorter title comments
    Input sheet layout by hand in eeschema (netlist and parts unchanged),
    all sheets re-saved by eeschema 10; title-block comments shortened to
    fit the frame (generator text in de8c3e6). ERC 0.
2026-11-05 pp-48 generator: owns the hand-improved rev D layouts, lint for text, bypass caps, frame
    The core / unit schematics were improved by hand (e15d9e5, 5ceba82,
    cd9a924); the blocks now draw them, so gensch.py reproduces them:
    symbol spots, moved Reference / Value texts (ref_at / val_at), R29's
    DNP description, and wires where the sheets had them (mux RESET, chain
    deadline RC / pull-ups / C302, MCU crystal, NRST / SWD rows, address
    straps, I2C2 pull-ups, run LED, unit flip-flop caps) instead of local
    labels. Root power anchors as redrawn.
    Lint (sch/draw.py finish, all problems of a sheet reported at once):
    - Reference / Value texts (power symbol values too) may not overlap
    each other, labels,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
2026-11-05 pp-48-fd generator: owns the hand-improved layouts, lint for texts and bypass caps
    Lint (sch/draw.py finish(), all errors listed at once): Reference / Value
    texts and headings against each other, labels, power symbols, body
    graphics and wires; no text past the 10 mm page frame (title comments
    checked in gensch.py, unit comments shortened to fit); a rail-to-ground
    cap has its rail pin within 10.16 mm of a non-cap pin on that rail or is
    wired to one along at most 50.8 mm of the rail (bulk=True opts out, not
    used). New authoring: ref_at / val_at, wire(..., sym=False) branches,
    (x, y, dir) power-symbol points, port ang.
    Blocks take the placements, field spots and wires of c1caf18, 9fb6a2e and
    3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
2026-11-05 handoff: 2026-11-05, schematics readable, generators own the layout
2026-11-05 PM-19V-250W-B: OV_KILL trip at most 22 V (user, no answer from SixUnited): R18 84.5k -> 76.8k C26987, 20.83 V nominal, 19.83-21.87 V worst case from the MCP65R46 datasheet (ref +/-2 %, VOS 10 mV, VHY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
2026-11-05 core-fd, unit-fd: JLC rotation entries for JP1 / JP301 C492419 (270, fitted on the EasyEDA pads) and core-fd Y1 C7424755 (0: no EasyEDA footprint, SMD3225-4P as C9010)
2026-11-05 controller-fd: Y2 25 MHz 12 pF YXC C9006 (0 at JLC order time) -> JGHC S3225000121060 C390773 (12 pF, +/-10 ppm, 60 ohm, same EasyEDA pad layout, rotation 0); load caps unchanged; ERC 0, DRC 0 unconn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
2026-11-05 JLC CPL: XT30 C431092 and XT60 C98732 centroid offsets 0 (were dy -5.0 / -3.0): the EasyEDA origin is the centre of pins + pegs, which is jlcfab's THT reference (all pads); the JLC preview of core-fd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
2026-11-05 PM modules: fab sets. Rev A: R12 84.5k -> 76.8k C26987 (OV_KILL ~20.8 V, at most 22 V as B; output max ~19.56 V at +/-1 % VFB), JLC rotation table (LTC7810 LQFP 270 and Kemet-E 180 fitted, the rest f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
2026-11-06 mech: plane-8port assembly (FCStd + STEP); gitignore board STEP exports, FreeCAD backups, Fabrication Toolkit options
2026-11-06 granite-core: CanPlaneLink, the controller's CAN FD transport (ADR 0005 decisions 2-8)
    A PlaneLink over a small frame driver (CanFrames: send one 11-bit-id CAN
    FD frame, take one received frame, now_ms, error counters, idle), so the
    whole transport is host-tested before any FD board exists and the
    firmware only has to wire the MCP2518FD under it.
    Ids from granite_proto::can::msg_type_for_block, so FW / LOG go as BULK
    and everything else as REQ / RSP; segmentation and reassembly are
    granite-proto's, not a second copy. One transaction at a time, 20 ms
    after the last request segment, then LinkError::Timeout - the variant
    plane::link retries (a NAK is absence, and nothing acknowledges a CAN
    fra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
2026-11-06 granite-core: link_kind, the image's plane-link marker and the upload's verdict (ADR 0006 component 7)
    The wrong-image guard needs something in the uploaded bytes that says
    which link the image drives, readable before the boot partition is
    switched. This is the format and the search, in granite-core so both
    ends (the firmware's own marker and the OTA stream scan) are host-tested
    where granite-fw's own tests cannot run.
    A 24-byte tagged struct: 16-byte magic, format version, kind, !kind, a
    zero, CRC-32 over the 20 bytes before it. Four guards, because the scan
    is a search over ~1.7 MB: a magic that turns up in an asset cannot be
    read as a kind (a 2000-chunk noise test with near misses sprink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
2026-11-06 granite-fw: the CAN FD plane link, one link per image, and the two OTA guards (ADR 0006 component 7, ADR 0005)
    Features link-canfd (default, the first batch) and link-i2c, exactly
    one, compile_error! otherwise; link-bench for a bench board with no
    MCP2518FD, in devboard. link-i2c keeps today's NAK stub and today's
    pins, so the rev D build is unchanged behaviour.
    MCP2518FD as a second device on the W5500's SPI bus (ADR 0006 decision
    9): platform::net::spi_bus builds SPI2 / GPIO19-21 once, before either
    device, and hands a &'static SpiDriver to the network thread and to the
    hardware layer (NetHw::spi and EthPins lose the bus pins). Its own
    SpiDeviceDriver at 10 MHz (ceiling ~17 MHz at 40 MHz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
2026-11-06 docs: firmware ADR 0005 as built on the controller side, README link features
    ADR 0005 gains an "As built: the controller side" section: the transport
    behind a frame-driver trait, timeout mapped to LinkError::Timeout (what
    plane::link retries) and Nak kept for an address with no plane, EVENTs
    collected mid-transaction, the promiscuous controller filter instead of
    Config::for_node(14) (the node field names the plane), SYNC through the
    segmenter, polling instead of nINT and why, granite-sim keeping its own
    CanBus and why that is not a regression, and the two image guards. No
    decision changes.
    README: the one-link-per-image table and the build line per link, the
    per-link pin table (GPIO0 / 2 /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
2026-11-06 README: image sizes per link build (canfd 1,706,432 B / 42.7 %, i2c 1,681,792 B / 42.1 %), devboard carries link-bench
2026-11-06 granite-proto: STATUS 0x1D CanErrors, the new tag firmware ADR 0005 decision 8 reserves for the CAN FD link's counters: u8 TEC, u8 REC, u16 bus-off count, u16 reassembly drops, u16 TX-FIFO-full, 8 by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
2026-11-06 plane-logic: can_link, the plane's side of the CAN FD transport (firmware ADR 0005 decisions 2-8), generic over a small synchronous frame-driver trait (send, receive, error counters, bus-off) so one 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
2026-11-06 plane-fw: one link per image as a cargo feature (firmware ADR 0005 decision 9), exactly one set or the build stops: link-i2c (rev D, G070CB, I2C1 slave, unchanged behaviour), link-mcp (default: G070C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
    The link decides the MCU, so the embassy-stm32 chip feature moves out of the dependency into the link features, and build.rs picks the pin map (plane-core-pins.toml vs plane-core-fd-pins.toml) and the linker script with it: memory-g070cb.x (128 KB / 36 KB) or memory-g0b1cc.x (256 KB / 144 KB), copied to OUT_DIR a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
2026-11-06 docs: plane-fw README on the three link features (build and clippy commands, flash sizes per build against the ACTIVE slot, the two clock trees, what each CAN task configures, the CONFIG-page bank ar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
2026-11-08 mqtt: 50 mV deadband on vin_v before state counts as changed. The rev C bench (2026-11-08) republished the retained state every second because the VIN reading wanders by one ADC count (18.645 / 18.65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
2026-11-08 pp-48-fd generator: two wrong LCSC codes fixed at the source. JLC refused R19 / R20 / R69 / R70 of the 2026-11-07 order (pp-48-unit-fd): C22775 is 0603WAF1000T5E, a 100 ohm 0603 - the value table cla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
2026-11-08 pp-48 generator (rev D): the same two LCSC codes fixed as in pp-48-fd, from the same table this copy inherited. C22775 (100 ohm 0603) -> C25099 (270 ohm 1 % 0402) for R19 / R20 / R69 / R70 of pp-48-u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
2026-11-09 pp-48-fd: LCSC fixes from the JLC order review. unit-fd R19 / R20 / R69 / R70 270R 0402: C22775 (100R 0603, wrong) -> C25099 (UNI-ROYAL 0402WGF2700TCE). core-fd D3 / D4 / D5 on 0603 pads: C2297 (KT-0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
2026-11-09 unit-fd: CAN netclass with tuning profile CAN_DIFF (differential, 120 ohm target, F.Cu over In1 / B.Cu over In2, 0.2 mm width, 0.6 mm gap); CANH / CANL moved from LINK to CAN, rule 'link to bus' cove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
2026-11-09 pp-48-fd: link nets CANH / CANL -> CAN_P / CAN_N on core-fd and unit-fd (link.py is shared; ISO1044 pins keep their names) so KiCad treats them as a differential pair and tuning profile CAN_DIFF appl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
2026-11-10 attic: non-fd boards superseded by the CAN FD ones. controller (rev D, I2C link) -> attic/controller-rev-d; power/pp-48-core, power/pp-48-unit -> attic/power/. Lib tables, pcbkit libs and 3D model pa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
2026-11-10 attic: rev D plane firmware (I2C link). firmware/plane-fw -> attic/firmware/plane-fw, firmware/plane-core-pins.toml -> attic/firmware/ (build.rs still reads ../plane-core-pins.toml); granite-proto / 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
2026-11-10 fab-archive/fd-batch1: JLC fab sets (Gerbers, drill, BOM, CPL) for controller-fd, pp-48-core-fd, pp-48-unit-fd regenerated from tag fd-batch1 with pcbkit jlcfab, for an exact re-order; core-fd / unit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
2026-11-11 docs: unit-fd EMI bench test plan. Desk review of the routed pp-48-unit-fd (2026-11-11) found no layout problem; what stays open is the modules' input ripple, which the unit passes unfiltered to the 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
2026-11-11 pp-48-fd tools: unit_ripple.py, the harmonic model behind the predicted numbers of docs/unit-fd-emi-bench-plan.md (module input ripple through the slot and unit hot-swap paths to the XT60 and a 0.5 u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
2026-11-11 ADR 0005 decision 3a: hot-swap SOA check on pp-48-unit-fd as routed (desk check, 2026-11-11). On a short the LM5069 holds the FET in power limit at the input voltage for the fault time (slot 46 W / 0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
2026-11-11 unit-fd next rev: hot-swap pass FETs Q1 / Q51 / Q202 / Q203 -> ISC035N10NM5LF2 (C22408528, extended, 58 at JLC on 2026-11-11), the linear-mode FET of ADR 0005 decision 3a; was BSC070N10NS5 / BSC040N1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
2026-11-11 fab-archive/fd-batch1: fab sets of the PM modules ordered with the batch, pm-19v-250w (rev A) and pm-19v-250w-b. Design unchanged since e611c09 (2026-11-05, inside tag fd-batch1). Regenerated 2026-11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
2026-11-11 firmware: ADR 0006 block switch component (proposed)
2026-11-12 ADR 0005 open question: protection outside the fluid for the first pods (discussed 2026-11-12, not decided). 12 frames of 8 nodes wanted first week of December 2026; per-unit devices rejected (24 per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
2026-11-12 unit-fd pcbkit.toml: JLC rotation entry for the new pass FET C22408528 (ISC035N10NM5LF2), 270 as the BSC070N10NS5 / BSC040N10NS5 it replaces. The table is keyed by LCSC number, so without it a fab se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
2026-11-12 handoff 2026-11-12: unit-fd desk review summary (EMI plan, current and heat, hot-swap FETs outside SOA on a short and the ISC035N10NM5LF2 fix, dead-short race, protection outside the fluid open, PM m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
2026-11-12 unit-fd .kicad_pro as KiCad rewrites it: net classes CAN / LINK in the other order, tuning profile keys sorted. No value changed
2026-11-12 granite-core: the block switch model, parsers, forms and planner (ADR 0006 component 15)
    A new `switch` module, no_std + alloc and host-tested, holding
    everything about the Sodola SL902-SWTGW218AS that is not a socket:
    - scan.rs: a hand-written HTML scanner (rows of <td> cells, the value
    of a named input in either quote style, the selected <option>, a
    checked box). No regex crate, as the ADR asks.
    - parse.rs: one parser per CGI page, each one recognising its page
    before reading it, so an unknown firmware is refused instead of
    guessed at. A login redirect and an empty body (no Referer) are
    told apart from a page.
    - forms.rs: every write as the form it posts, with the switch's rules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
2026-11-12 granite-core: the `switch` config section, the switch verbs, events and state (ADR 0006 components 18 and 21)
    The vocabulary and the configuration the block switch needs, so the
    worker in granite-fw is only a thread with a socket:
    - a seventh config section `switch` (enabled, manage, host, mac, user,
    uplink_port, enforce, poll periods, desired). It is in
    `affects_reachability`, so a `config_set` of it goes through the
    staging and commit-confirm path that `net` and `mqtt` already use:
    one mistake on the block switch cuts the controller off the same way
    a mistake on its own interface does. Reading is the default and
    `manage` (false) gates every write. `SCHEMA_VERSION` stays 1: a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
2026-11-12 granite-fw: the block switch client, worker and reconcile (ADR 0006 components 16, 17, 18, 21)
    src/switch/client.rs: the only thing in the firmware that talks to the
    switch. One EspHttpConnection per request, like platform::ota's pull,
    plus what the Sodola CGI demands: the md5(user + password) cookie, a
    Referer header on everything, one re-login when a page comes back as
    the login redirect, an explicit Content-Length (without it esp-idf-svc
    sends a chunked body the CGI does not read), 100 ms minimum spacing,
    a 10 s timeout, the 2 s settle after a port write, and "no reply is the
    expected answer" for the STP and address writes, which are verified by
    reading back. One page at a time, capped at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
2026-11-12 docs: ADR 0006 accepted, with what was built differently, and the firmware README
    ADR 0006 status Accepted plus an Implementation section: components 15,
    16, 17, 18, 21 and the pairing check of 22 are in the firmware; the
    deviations are recorded there rather than left in the code only (one
    `EventKind::Switch` with a `what` instead of nine kinds, MD5 written
    out instead of a crate, the MAC walk posting its paging in read-only
    mode, two Modbus fault bits, `switch_port` resolving a node through
    switch.desired, the counters going through a slot the MQTT worker
    drains, `switch_reconcile` applying without saving, jumbo 0 meaning
    off, no schema bump). It also lists what is not built: password
    rotat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
2026-11-12 config_confirm and config_revert: the commit-confirm cycle closes over any transport (ADR 0001 components 6 and 7)
    The confirm existed only as `POST /api/v1/config/confirm`, so a client
    that staged a section over MQTT could not finish the cycle: every
    change it made reverted when `net.t_confirm_s` passed. ADR 0001 gives
    no reason for that - component 7 ties `config_set` over MQTT to "the
    same commit-confirm rules" and simply never lists a confirm verb - and
    with the `switch` section (ADR 0006) staged like `net` and `mqtt` the
    gap became load-bearing.
    Two verbs, going through the one dispatcher like everything else:
    - `config_confirm` promotes every staged section, `config_revert` puts
    th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
2026-11-12 granite-fw mqtt: ack switch verbs on accepted; the switch worker reports through switch_* events and never sends action_done, so the ack only came at the action timeout
2026-11-12 firmware docs: switch operator guide (keys, confirm cycle, recipes, commands, events, troubleshooting)
2026-11-12 firmware README: link the switch operator guide
2026-11-12 granite-fw: wire probe_scan, recover a stuck 1-wire driver, quiet the TMP1075
    - probe_scan sets a flag the sense task picks up on its next tick: it
    walks the bus and logs the ROM ids. With nodes.probes empty the bus is
    also re-walked every 60 s, so a probe plugged in later shows up
    without a reboot.
    - The onewire_bus RMT driver leaves its RX channel mid-receive after a
    reset pulse that never comes back (line held low), and every later
    call fails with "channel not in enable state". A timeout or bad-state
    error now marks the driver stuck; the next scan or read rebuilds it.
    - probe_scan's "accepted" is the final MQTT ack, like the switch verbs;
    it used to wait for an action_done t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
2026-11-12 granite-fw: rev-c feature for the rev C bench board
    Rev C has the link-i2c pin map - TMP1075 U5 and the U14 / U15 expanders
    on GPIO2 / GPIO3 (I2C_INT), EXP_INT on GPIO0 - and no MCP2518FD. The FD
    image it ran (link-canfd + link-bench) looks for the TMP1075 on GPIO6 /
    GPIO7, the controller-fd location, so board_temp_c was always null.
    rev-c is an alias for link-i2c under the board's name: the TMP1075
    reads off the internal bus, and the stub plane link confirms the image
    without link-bench. README and the hw module table say so.
    Going from an FD image to rev-c changes the link kind, which the OTA
    upload refuses by design; the switch is one USB flash (README, "bench
    flash"), NVS untouched. Ve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
2026-11-12 granite-fw: console i2c scan/read/rreg/write on the external bus
    A bench tool for add-on boards on J8/J9 (GPIO6/GPIO7, LP I2C): scan the
    bus, read bytes, read a register, write bytes. main hands the console a
    clone of the external bus handle once hw::init is up; the ESP-IDF
    driver serialises transfers, so it shares the bus with the hardware
    layer. I2cDev gains a plain read for parts with no register address.
    README lists it with a PCA9535 example (the 8-relay test board).
    Built for rev-c and flashed; not yet exercised on hardware - the USB
    console was unplugged before the first command.
2026-11-13 docs: ADR 0008, block switch 12 V supply (own isolated converter off the bus), proposed
2026-11-13 controller-fd: fix stale sheet notes (FD power source and spec on the top sheet, buck output 5.44 V on the power sheet)
